hahayyf666-netizen/ITS_NEW/02_rtl/synth/clockInfo.txt

-------------------------------------
| Tool Version : Vivado v.2024.1
| Date         : Sun Jul  5 17:35:17 2026
| Host         : lab
| Design       : design_1
| Device       : xcku5p-ffvb676-2-E-
-------------------------------------

For more information on clockInfo.txt clock routing debug file see https://support.xilinx.com/s/article/000035660?language=en_US
