hahayyf666-netizen/ITS_NEW/V35_P2A_DCT2_64/rtl/clockInfo.txt

-------------------------------------
| Tool Version : Vivado v.2025.2
| Date         : Sat Sep  5 00:54:16 2026
| Host         : Finesse
| Design       : design_1
| Device       : xcku5p-ffvb676-2-E-
-------------------------------------

For more information on clockInfo.txt clock routing debug file see https://support.xilinx.com/s/article/000035660?language=en_US
