hahayyf666-netizen/ITS_NEW/05_audit/current/17_2/memory_timing_probe_synthesis.csv

cycle | event | phase | tu | vector | group | lane | slot | bank | addr | epoch | request_id
6 | read_request | 1 | 0 | 0 | 0 | 0 | 0 | 0 | 0 |  | 0
6 | read_request | 1 | 0 | 0 | 0 | 1 | 0 | 1 | 16 |  | 1
6 | read_request | 1 | 0 | 0 | 0 | 2 | 0 | 2 | 32 |  | 2
6 | read_request | 1 | 0 | 0 | 0 | 3 | 0 | 3 | 48 |  | 3
6 | read_response | 1 | 0 | 0 | 0 | 0 | 0 | 0 | 0 |  | 0
6 | stage_lane_capture | 1 | 0 | 0 | 0 | 0 | 0 | 0 | 0 |  | 0
6 | read_response | 1 | 0 | 0 | 0 | 1 | 0 | 1 | 16 |  | 1
6 | stage_lane_capture | 1 | 0 | 0 | 0 | 1 | 0 | 1 | 16 |  | 1
6 | read_response | 1 | 0 | 0 | 0 | 2 | 0 | 2 | 32 |  | 2
6 | stage_lane_capture | 1 | 0 | 0 | 0 | 2 | 0 | 2 | 32 |  | 2
6 | read_response | 1 | 0 | 0 | 0 | 3 | 0 | 3 | 48 |  | 3
6 | stage_lane_capture | 1 | 0 | 0 | 0 | 3 | 0 | 3 | 48 |  | 3
7 | read_request | 1 | 0 | 0 | 1 | 0 | 0 | 0 | 64 |  | 4
7 | read_request | 1 | 0 | 0 | 1 | 1 | 0 | 1 | 80 |  | 5
7 | read_request | 1 | 0 | 0 | 1 | 2 | 0 | 2 | 96 |  | 6
7 | read_request | 1 | 0 | 0 | 1 | 3 | 0 | 3 | 112 |  | 7
7 | read_response | 1 | 0 | 0 | 1 | 0 | 0 | 0 | 64 |  | 4
7 | stage_lane_capture | 1 | 0 | 0 | 1 | 0 | 0 | 0 | 64 |  | 4
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
