hahayyf666-netizen/ITS_NEW/01_docs/current/SPEC_CLARIFICATIONS.md

# 仍需确认的赛题功能规则

此文件记录资料不足之处。没有发送邮件或消息，也没有把我们的实现约定变成官方定义。

| ID | 问题 | 当前工程选择 | 最小确认方式 | 状态 |
|---|---|---|---|---|
| Q01 | it_info总宽20还是22？字段包含[21:20] | 22位，按字段定义解包 | 确认有效端口位宽及LFNST idx所在位 | OPEN |
| Q02 | 正文未列it_data_end；独立end能否在req之前到达？ | 描述符接受后的后续沿可发；端按接收顺序归属 | 确认端口必需性及相对req的时序 | OPEN |
| Q03 | 位深、动态范围、V/H移位和中间裁剪具体是哪套？ | bit_depth10 / range15 / shift7、10 / signed16饱和 | 给出官方参考参数或对DC512等例子的预期 | OPEN |
| Q04 | signed10是饱和还是取低10位或另有定标？ | SAT10 | 4x4 DC32767：应输出511还是0，或其他值？ | OPEN |
| Q05 | LFNST-off每个形状允许哪些混合H/V类型？ | 按各轴能力支持169组合，含正文明确同类型57组合 | 确认完整H/V合法子集 | OPEN |
| Q06 | square4x4/8x8 LFNST是否只累加8输入项？扫描是否完全采用指定VTM？ | frozen模型按8项，其他形状按16项 | 第9个扫描位置的单非零输入是否应影响结果？ | OPEN |

附件矩阵/布局与专家答疑记录是已有依据；记录中的答复未明确解决以上全部细节。
Q02的增强接收能力不意味着已经证明官方允许该激励；Q05支持更大集合不等于官方要求全部集合。
在官方模型或参数仍缺失时，可报告工程契约功能验证通过，不能报告赛题全链路等价已证明。
