hahayyf666-netizen/ITS_NEW/05_audit/current/102_final_release_20261006/FINAL_RELEASE_REVIEW.md

# Final source, evidence and delivery review

Result: **FINAL_RELEASE_REVIEW_PASS**. Twelve read-only checks passed.
Review authority is the frozen evidence commit
`70153eb14d62801531386af35075c770e1bf51f4`, tested source `cb65bbf1cc2dc9e5e649b2fe8b8affc67435c5a7`, and the two routed authorities in audit99/100.
This review is a separate inspection of source and raw artifacts, not another
simulator/implementation run or a claim of third-party review.

The review checked all3,286 packaged files against the tested Git source,
all68 published artifact identities, all36 simulation command records and
two compile records, both normal/SYNTHESIS acceptance summaries, the explicit
submission entry, frozen SAT10 profile, wrong-profile rejection, and both
raw routed setup/hold summaries and physical source identities. Failures0.

The actual submission entry is `its_unified_submission_top`; its six-file RTL
compile list excludes legacy `its_top.v`. SAT10 is explicit. Coefficient file
staging for a manual compile/fresh physical reproduction is now documented
in `01_docs/current/FINAL_DELIVERY.md`; automated functional reproduction
already stages the coefficients.

The complete archive inventory matches, including SHA256 of each archived
file.3,264 archived text files differ from their raw Git blobs only in CRLF/LF
representation; normalized content is equal. Archive SHA256 remains
`46C55BFFA62A67CDD664FC9C68E210E3FCA1FC3B80093A4A81CEE0C9A19B461F`.

Fourteen historical physical-source `git_blob` fields identify the object
hash of LF-normalized source bytes rather than the literal source commit's
blob. The recorded working-byte SHA256 matches the current frozen files,
normalized content matches the actual committed source, and the normalized
object hash is independently reconstructed. The new JSON emits actual commit
blob, working-byte SHA256 and historical-field classification separately.
No historical manifest was rewritten.

Main integration preflight was conflict-free. Merge `751f5b666b3b2742ab8626a93ced52a131a17d14`
incorporated main `9354f33d19895b0202aef630f4486bd49ef526c7` and preserved its
two historical audit72 PPA reports. Compared with the reviewed evidence
commit, that merge changed no RTL, verification source, profile or XDC.
No source requalification is required for that history-preservation merge.

Accepted functional and two-run nominal500MHz core claims remain unchanged.
Official equivalence NOT_PROVEN; package timing NOT_EVALUATED; setup margin1ps.
This release creates no tag and makes no measured-power or system-margin claim.
