hahayyf666-netizen/ITS_NEW/05_audit/current/60/p9_r5g_locality_g0_20260917_r2/g0_timing_query_summary.txt

P9-R5G G0 timing query
dcp=C:\Users\Fine\Documents\Codex\2026-07-23\ni\_its_new_p8_1_publish\05_audit\current\59\p9_r5e_registered_neighbor_20260917_defaulttop\step12f_registered_neighbor_postroute.dcp
source_families=ingress_group_q_reg,ingress_data_q_reg
destination_family=input_mem_reg (D and CE pins)
query=one max-delay path per destination, positive and negative slack retained
no synthesis/implementation/constraints/write_checkpoint performed
