hahayyf666-netizen/ITS_NEW/04_waveforms/modelsim_backpressure.png

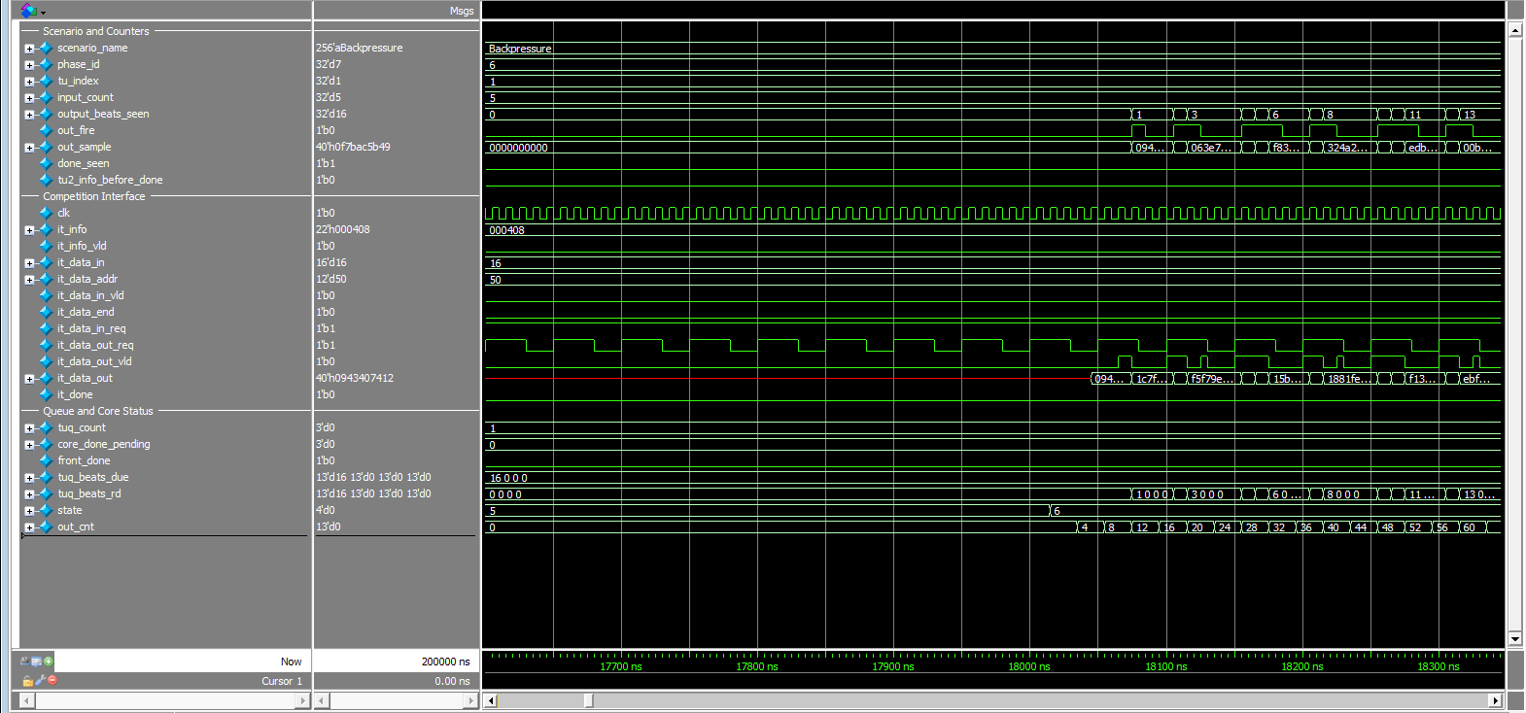
04_waveforms/modelsim_backpressure.png
