hahayyf666-netizen/ITS_NEW/04_waveforms/modelsim_boundary_zero.png

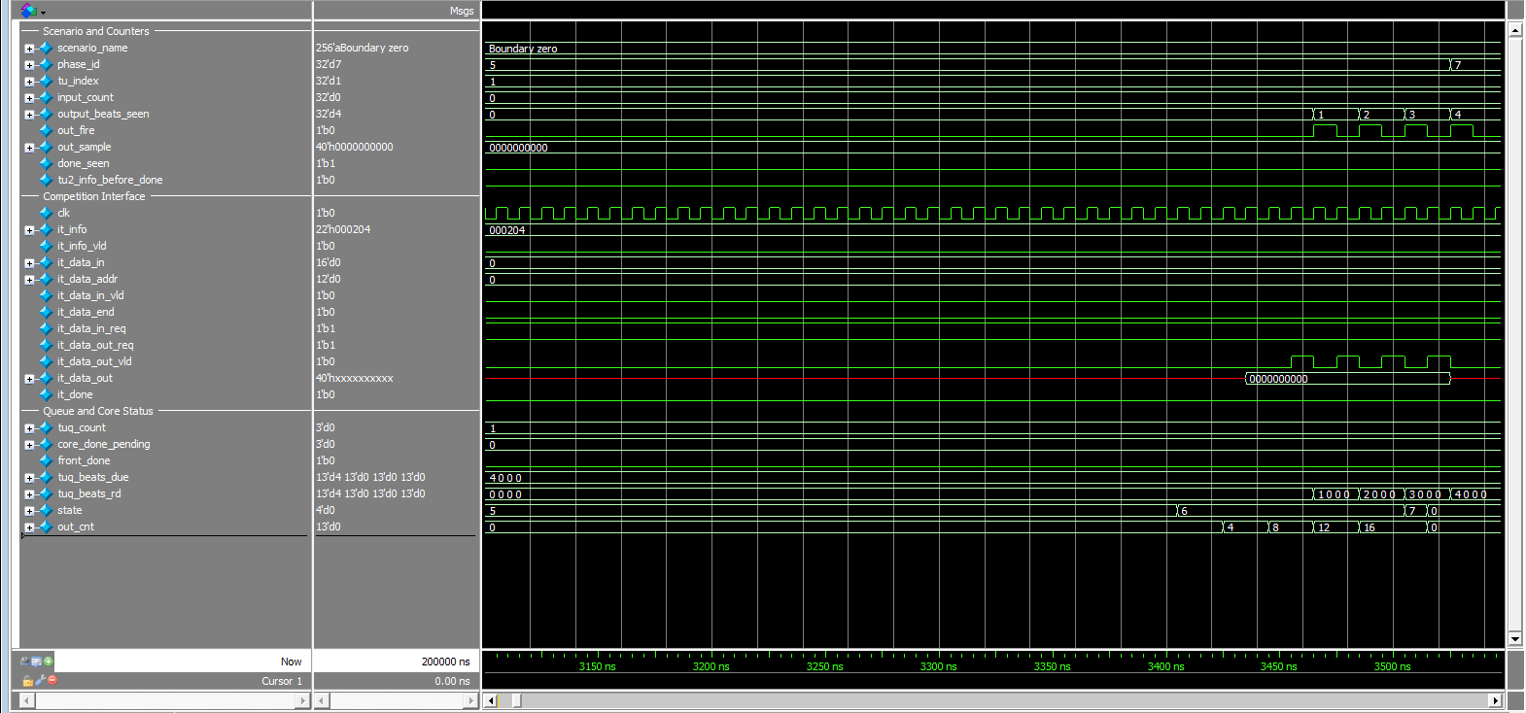
04_waveforms/modelsim_boundary_zero.png
