hahayyf666-netizen/ITS_NEW/04_waveforms/modelsim_continuous_tu.png

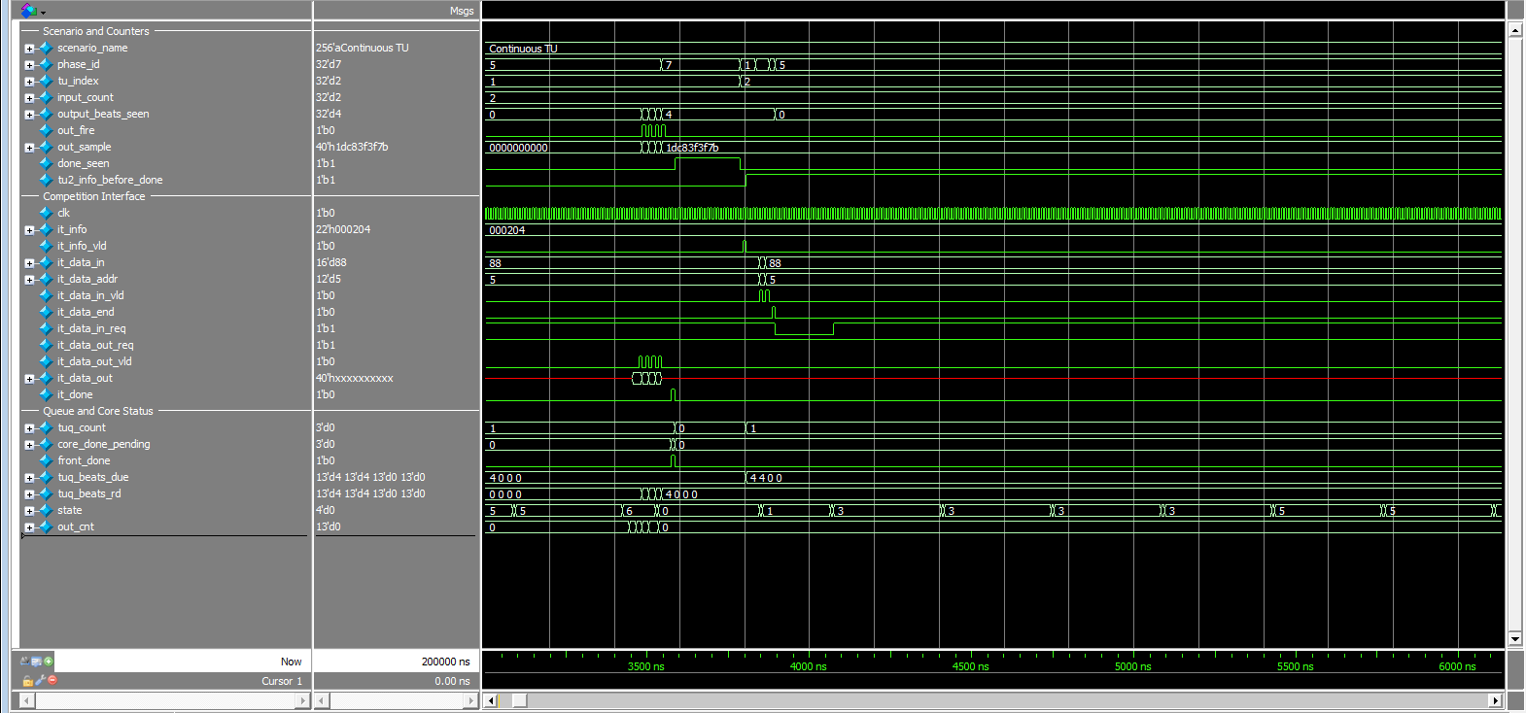
04_waveforms/modelsim_continuous_tu.png
