hahayyf666-netizen/ITS_NEW/04_waveforms/modelsim_dst7_8x8.png

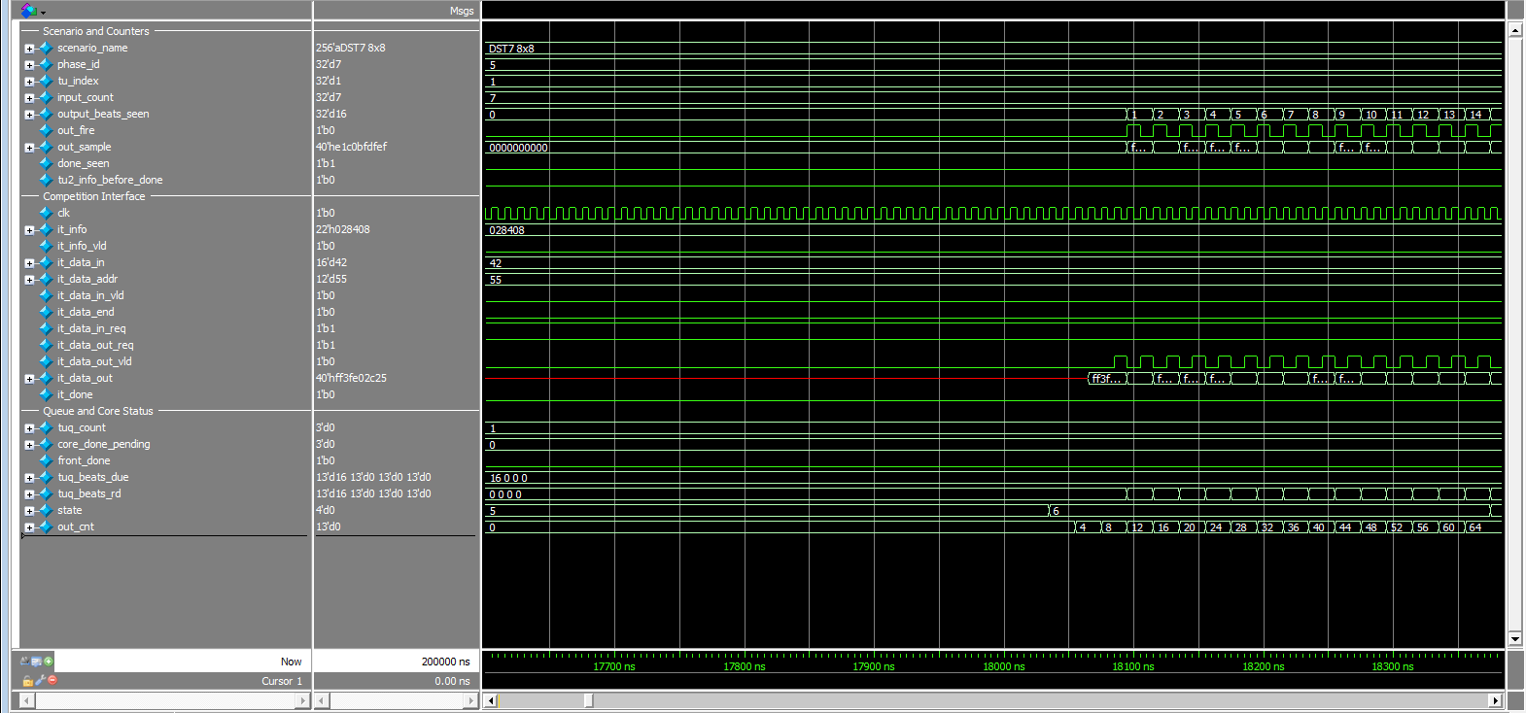
04_waveforms/modelsim_dst7_8x8.png
