hahayyf666-netizen/ITS_NEW/04_waveforms/modelsim_immediate_overlap.png

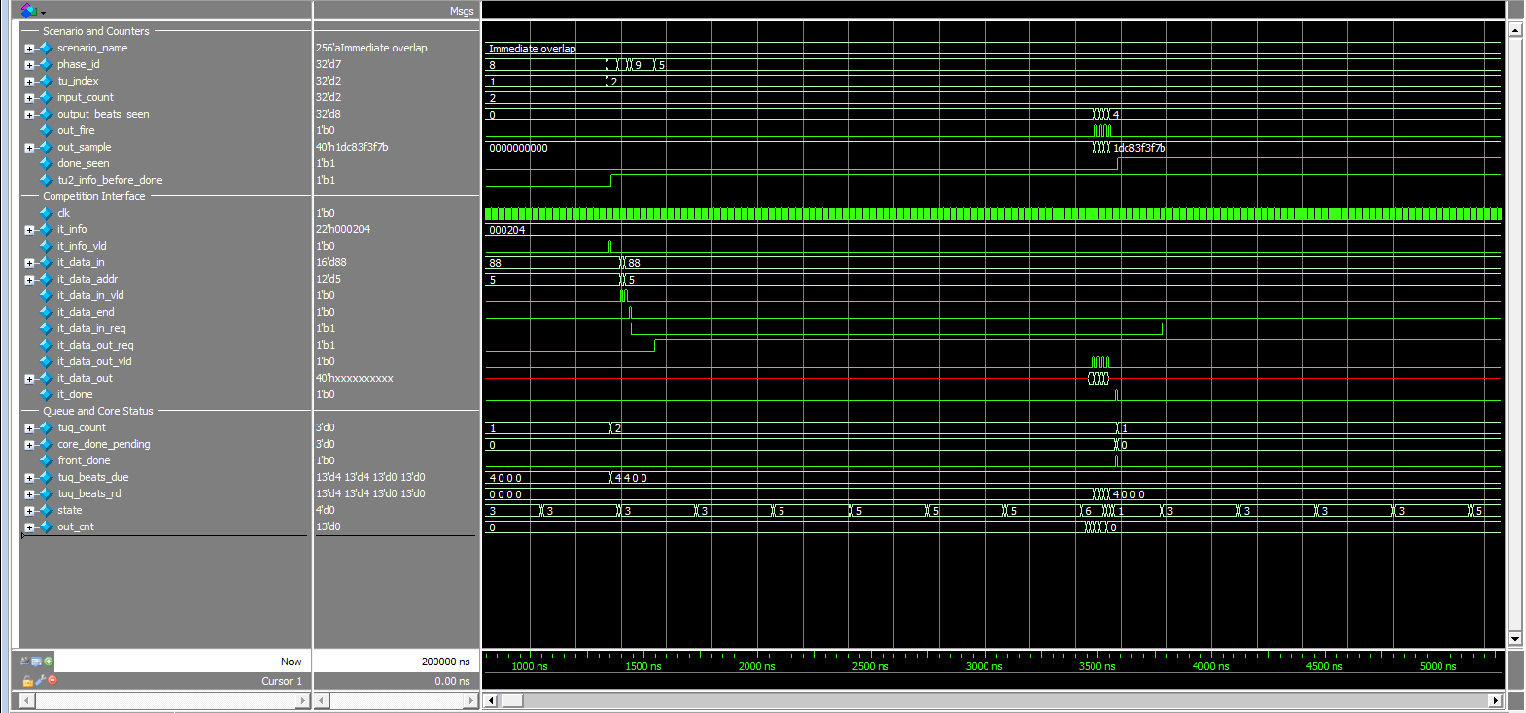
04_waveforms/modelsim_immediate_overlap.png
