hahayyf666-netizen/ITS_NEW/04_waveforms/modelsim_lfnst4x4.png

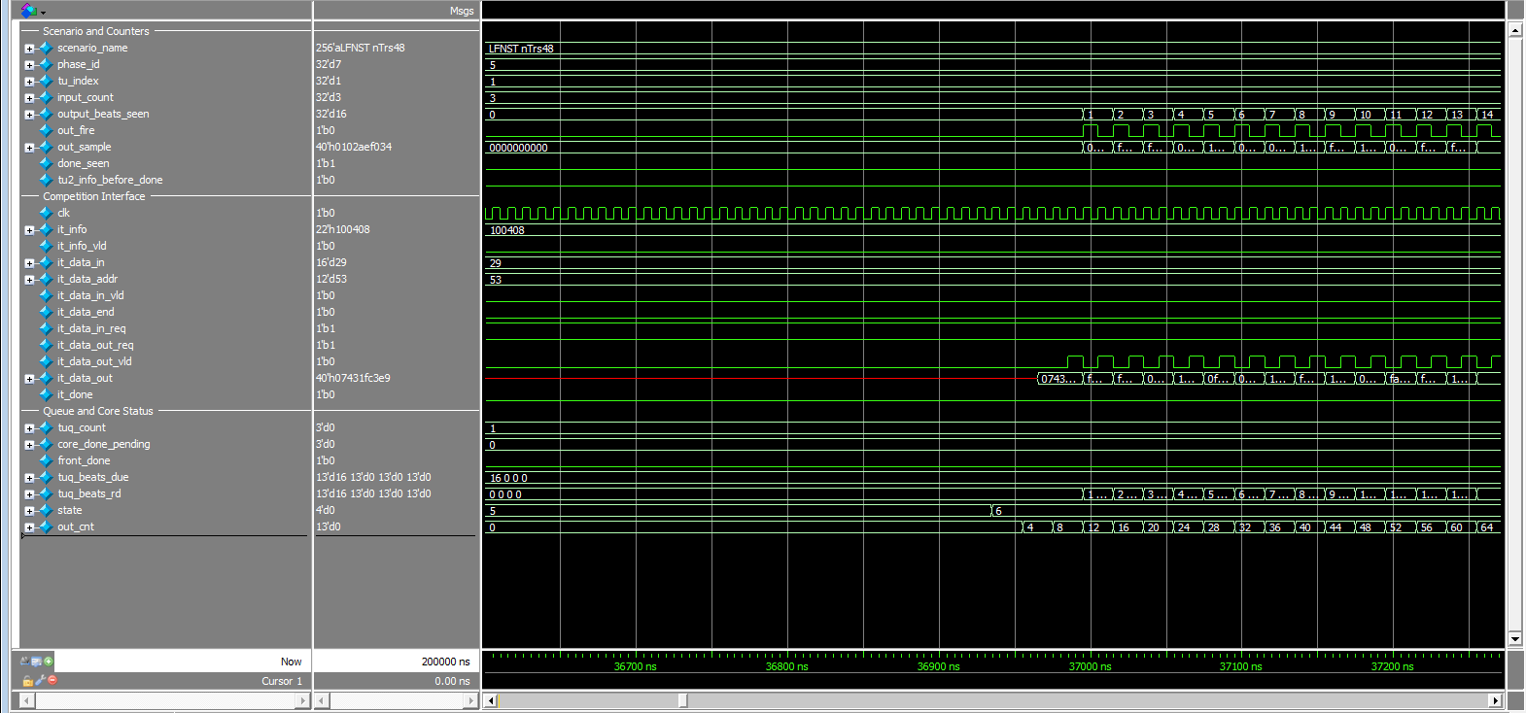
04_waveforms/modelsim_lfnst4x4.png
