hahayyf666-netizen/ITS_NEW/05_audit/current/64/p9_r5g_g06r1_inventory_20260918/g06r1_inventory_read_only_status.txt

status=READ_ONLY_COMPLETE
vivado_version=2025.2
maxThreads=4
dcp=C:\Users\Fine\Documents\Codex\2026-07-23\ni\_its_new_p8_1_publish\05_audit\current\59\p9_r5e_registered_neighbor_20260917_defaulttop\step12f_registered_neighbor_postroute.dcp
producer_cells=64
candidate_sites=9198
site_bbox=SLICE_X40..X112/Y55..Y180
rtl_changes=FORBIDDEN
xdc_changes=FORBIDDEN
implementation_commands=FORBIDDEN
