hahayyf666-netizen/ITS_NEW/05_audit/current/74_p4_fifo_setup_tail_20260929/setup_family_summary.csv

bucket | source_family | endpoint_family | endpoint_count | tns_ns | tns_share | worst_violation_ns | median_violation_ns | p90_violation_ns | p99_violation_ns
DUT_INTERNAL | u_dut/kernel_cut_h_q_reg | u_dut/kernel_rd_resp_data_q_reg | 2 | -0.025000000 | 0.007068137 | 0.017000000 | 0.008000000 | 0.017000000 | 0.017000000
DUT_INTERNAL | u_dut/kernel_h_rd_addr_q_reg_replica_2 | u_dut/kernel_h_rd_data_q_reg | 1 | -0.035000000 | 0.009895392 | 0.035000000 | 0.035000000 | 0.035000000 | 0.035000000
DUT_INTERNAL | u_dut/kernel_h_rd_addr_q_reg_replica_2 | u_dut/kernel_h_rd_data_tail_q_reg | 1 | -0.010000000 | 0.002827255 | 0.010000000 | 0.010000000 | 0.010000000 | 0.010000000
DUT_INTERNAL | u_dut/kernel_h_rd_addr_q_reg | u_dut/kernel_h_rd_data_q_reg | 13 | -0.221000000 | 0.062482330 | 0.045000000 | 0.015000000 | 0.030000000 | 0.045000000
DUT_INTERNAL | u_dut/kernel_h_rd_addr_q_reg | u_dut/kernel_h_rd_data_tail_q_reg | 6 | -0.107000000 | 0.030251626 | 0.038000000 | 0.012000000 | 0.038000000 | 0.038000000
DUT_INTERNAL | u_dut/kernel_h_rd_raw_group_q_reg | u_dut/u_unified_p4_kernel/ingress_data_q_reg | 9 | -0.237000000 | 0.067005937 | 0.044000000 | 0.027000000 | 0.044000000 | 0.044000000
DUT_INTERNAL | u_dut/kernel_phase_q_reg | u_dut/kernel_h_rd_data_q_reg | 8 | -0.160000000 | 0.045236076 | 0.043000000 | 0.020000000 | 0.043000000 | 0.043000000
DUT_INTERNAL | u_dut/kernel_phase_q_reg | u_dut/kernel_h_rd_data_tail_q_reg | 20 | -0.503000000 | 0.142210913 | 0.043000000 | 0.023000000 | 0.041000000 | 0.043000000
DUT_INTERNAL | u_dut/kernel_phase_q_reg | u_dut/kernel_h_rd_raw_group_q_reg | 1 | -0.045000000 | 0.012722646 | 0.045000000 | 0.045000000 | 0.045000000 | 0.045000000
DUT_INTERNAL | u_dut/kernel_phase_q_reg | u_dut/kernel_h_rd_raw_vector_q_reg | 2 | -0.090000000 | 0.025445293 | 0.045000000 | 0.045000000 | 0.045000000 | 0.045000000
DUT_INTERNAL | u_dut/kernel_phase_q_reg | u_dut/kernel_h_rd_raw_vector_q_reg_inv | 1 | -0.044000000 | 0.012439921 | 0.044000000 | 0.044000000 | 0.044000000 | 0.044000000
DUT_INTERNAL | u_dut/kernel_phase_q_reg | u_dut/kernel_rd_raw_data_q_reg | 1 | -0.013000000 | 0.003675431 | 0.013000000 | 0.013000000 | 0.013000000 | 0.013000000
DUT_INTERNAL | u_dut/kernel_phase_q_reg | u_dut/kernel_rd_req_group_q_reg | 1 | -0.009000000 | 0.002544529 | 0.009000000 | 0.009000000 | 0.009000000 | 0.009000000
DUT_INTERNAL | u_dut/kernel_phase_q_reg | u_dut/lfnst_gather_index_q_reg | 1 | -0.009000000 | 0.002544529 | 0.009000000 | 0.009000000 | 0.009000000 | 0.009000000
DUT_INTERNAL | u_dut/kernel_phase_q_reg | u_dut/rd_cmd_addr_q_reg | 1 | -0.031000000 | 0.008764490 | 0.031000000 | 0.031000000 | 0.031000000 | 0.031000000
DUT_INTERNAL | u_dut/kernel_phase_q_reg | u_dut/rd_cmd_addr_q_reg_replica_1 | 1 | -0.003000000 | 0.000848176 | 0.003000000 | 0.003000000 | 0.003000000 | 0.003000000
DUT_INTERNAL | u_dut/kernel_phase_q_reg | u_dut/rd_cmd_addr_q_reg_replica_3 | 1 | -0.031000000 | 0.008764490 | 0.031000000 | 0.031000000 | 0.031000000 | 0.031000000
DUT_INTERNAL | u_dut/kernel_phase_q_reg | u_dut/rd_cmd_addr_q_reg_replica_4 | 1 | -0.013000000 | 0.003675431 | 0.013000000 | 0.013000000 | 0.013000000 | 0.013000000
DUT_INTERNAL | u_dut/kernel_phase_q_reg | u_dut/rd_cmd_addr_q_reg_replica_5 | 1 | -0.003000000 | 0.000848176 | 0.003000000 | 0.003000000 | 0.003000000 | 0.003000000
DUT_INTERNAL | u_dut/kernel_vector_q_reg_rep__0 | u_dut/u_unified_p4_kernel/ingress_data_q_reg | 1 | -0.037000000 | 0.010460843 | 0.037000000 | 0.037000000 | 0.037000000 | 0.037000000
DUT_INTERNAL | u_dut/kernel_vector_q_reg_rep__1 | u_dut/kernel_vector_q_reg | 1 | -0.025000000 | 0.007068137 | 0.025000000 | 0.025000000 | 0.025000000 | 0.025000000
DUT_INTERNAL | u_dut/kernel_vector_q_reg_rep__1 | u_dut/kernel_vector_q_reg_rep__0 | 1 | -0.031000000 | 0.008764490 | 0.031000000 | 0.031000000 | 0.031000000 | 0.031000000
DUT_INTERNAL | u_dut/kernel_vector_q_reg_rep__1 | u_dut/kernel_vector_q_reg_rep__1_replica_4 | 1 | -0.007000000 | 0.001979078 | 0.007000000 | 0.007000000 | 0.007000000 | 0.007000000
DUT_INTERNAL | u_dut/kernel_vector_q_reg_rep__1 | u_dut/kernel_vector_q_reg_rep__1_replica_5 | 1 | -0.010000000 | 0.002827255 | 0.010000000 | 0.010000000 | 0.010000000 | 0.010000000
DUT_INTERNAL | u_dut/kernel_vector_q_reg_rep__1 | u_dut/kernel_vector_q_reg_rep__1_replica_6 | 1 | -0.011000000 | 0.003109980 | 0.011000000 | 0.011000000 | 0.011000000 | 0.011000000
DUT_INTERNAL | u_dut/kernel_vector_q_reg_rep__1 | u_dut/kernel_vector_q_reg_rep__1_replica_7 | 1 | -0.006000000 | 0.001696353 | 0.006000000 | 0.006000000 | 0.006000000 | 0.006000000
DUT_INTERNAL | u_dut/kernel_vector_q_reg_rep__1 | u_dut/u_unified_p4_kernel/ingress_data_q_reg | 1 | -0.027000000 | 0.007633588 | 0.027000000 | 0.027000000 | 0.027000000 | 0.027000000
DUT_INTERNAL | u_dut/kernel_vector_q_reg_rep | u_dut/u_unified_p4_kernel/ingress_data_q_reg | 2 | -0.033000000 | 0.009329941 | 0.022000000 | 0.011000000 | 0.022000000 | 0.022000000
DUT_INTERNAL | u_dut/kernel_vector_q_reg | u_dut/kernel_h_input_commit_wait_q_reg | 1 | -0.023000000 | 0.006502686 | 0.023000000 | 0.023000000 | 0.023000000 | 0.023000000
DUT_INTERNAL | u_dut/kernel_vector_q_reg | u_dut/kernel_rd_resp_valid_q_reg | 1 | -0.006000000 | 0.001696353 | 0.006000000 | 0.006000000 | 0.006000000 | 0.006000000
DUT_INTERNAL | u_dut/kernel_vector_q_reg | u_dut/kernel_vector_q_reg_rep | 1 | -0.017000000 | 0.004806333 | 0.017000000 | 0.017000000 | 0.017000000 | 0.017000000
DUT_INTERNAL | u_dut/kernel_vector_q_reg | u_dut/u_unified_p4_kernel/ingress_data_q_reg | 2 | -0.068000000 | 0.019225332 | 0.040000000 | 0.028000000 | 0.040000000 | 0.040000000
DUT_INTERNAL | u_dut/lfnst_grid_reg | u_dut/u_unified_p4_kernel/ingress_data_q_reg | 17 | -0.403000000 | 0.113938366 | 0.042000000 | 0.024000000 | 0.039000000 | 0.042000000
DUT_INTERNAL | u_dut/lfnst_grid_valid_reg | u_dut/u_unified_p4_kernel/ingress_data_q_reg | 4 | -0.076000000 | 0.021487136 | 0.038000000 | 0.012000000 | 0.038000000 | 0.038000000
DUT_INTERNAL | u_dut/lfnst_run_q_reg | u_dut/kernel_cut_h_q_reg | 1 | -0.019000000 | 0.005371784 | 0.019000000 | 0.019000000 | 0.019000000 | 0.019000000
DUT_INTERNAL | u_dut/lfnst_run_q_reg | u_dut/kernel_h_groups_left_q_reg | 2 | -0.063000000 | 0.017811705 | 0.036000000 | 0.027000000 | 0.036000000 | 0.036000000
DUT_INTERNAL | u_dut/lfnst_run_q_reg | u_dut/lfnst_grid_reg | 3 | -0.033000000 | 0.009329941 | 0.011000000 | 0.011000000 | 0.011000000 | 0.011000000
DUT_INTERNAL | u_dut/output_index_reg_replica | u_dut/slot_state_reg | 1 | -0.005000000 | 0.001413627 | 0.005000000 | 0.005000000 | 0.005000000 | 0.005000000
DUT_INTERNAL | u_dut/rd_cmd_addr_q_reg_replica_1 | u_dut/kernel_rd_raw_data_q_reg | 4 | -0.080000000 | 0.022618038 | 0.038000000 | 0.010000000 | 0.038000000 | 0.038000000
DUT_INTERNAL | u_dut/rd_cmd_addr_q_reg_replica_1 | u_dut/lfnst_mem_resp_data_q_reg | 2 | -0.034000000 | 0.009612666 | 0.030000000 | 0.004000000 | 0.030000000 | 0.030000000
DUT_INTERNAL | u_dut/rd_cmd_addr_q_reg_replica_2 | u_dut/kernel_rd_raw_data_q_reg | 2 | -0.049000000 | 0.013853548 | 0.025000000 | 0.024000000 | 0.025000000 | 0.025000000
DUT_INTERNAL | u_dut/rd_cmd_addr_q_reg_replica_3 | u_dut/kernel_rd_raw_data_q_reg | 2 | -0.018000000 | 0.005089059 | 0.016000000 | 0.002000000 | 0.016000000 | 0.016000000
DUT_INTERNAL | u_dut/rd_cmd_addr_q_reg_replica_4 | u_dut/lfnst_mem_resp_data_q_reg | 1 | -0.021000000 | 0.005937235 | 0.021000000 | 0.021000000 | 0.021000000 | 0.021000000
DUT_INTERNAL | u_dut/rd_cmd_addr_q_reg_replica | u_dut/kernel_rd_raw_data_q_reg | 5 | -0.062000000 | 0.017528979 | 0.025000000 | 0.012000000 | 0.025000000 | 0.025000000
DUT_INTERNAL | u_dut/rd_cmd_addr_q_reg_replica | u_dut/lfnst_mem_resp_data_q_reg | 1 | -0.036000000 | 0.010178117 | 0.036000000 | 0.036000000 | 0.036000000 | 0.036000000
DUT_INTERNAL | u_dut/rd_cmd_addr_q_reg | u_dut/kernel_rd_raw_data_q_reg | 5 | -0.140000000 | 0.039581566 | 0.038000000 | 0.031000000 | 0.038000000 | 0.038000000
DUT_INTERNAL | u_dut/rd_cmd_addr_q_reg | u_dut/lfnst_mem_resp_data_q_reg | 1 | -0.034000000 | 0.009612666 | 0.034000000 | 0.034000000 | 0.034000000 | 0.034000000
DUT_INTERNAL | u_dut/slot_state_reg | u_dut/lfnst_input_terms_q_reg | 4 | -0.052000000 | 0.014701725 | 0.013000000 | 0.013000000 | 0.013000000 | 0.013000000
DUT_INTERNAL | u_dut/u_bounded_lfnst_engine/reduce_l5_q_reg | u_dut/u_bounded_lfnst_engine/out_data_reg | 2 | -0.066000000 | 0.018659881 | 0.039000000 | 0.027000000 | 0.039000000 | 0.039000000
DUT_INTERNAL | u_dut/u_unified_p4_kernel/ingress_data_q_reg | u_dut/u_unified_p4_kernel/input_mem_reg | 12 | -0.190000000 | 0.053717840 | 0.045000000 | 0.010000000 | 0.028000000 | 0.045000000
DUT_INTERNAL | u_dut/u_unified_p4_kernel/issue_desc_active_size_q_reg | u_dut/u_unified_p4_kernel/s0_input_q_reg | 4 | -0.036000000 | 0.010178117 | 0.013000000 | 0.005000000 | 0.013000000 | 0.013000000
DUT_INTERNAL | u_dut/u_unified_p4_kernel/issue_desc_slot_q_reg_rep__3 | u_dut/u_unified_p4_kernel/s0_input_q_reg | 2 | -0.004000000 | 0.001130902 | 0.003000000 | 0.001000000 | 0.003000000 | 0.003000000
DUT_INTERNAL | u_dut/u_unified_p4_kernel/ready_fifo_mem_reg | u_dut/u_unified_p4_kernel/issue_desc_bundle_addr_q_reg_rep__1 | 1 | -0.018000000 | 0.005089059 | 0.018000000 | 0.018000000 | 0.018000000 | 0.018000000
DUT_INTERNAL | u_dut/u_unified_p4_kernel/ready_fifo_mem_reg | u_dut/u_unified_p4_kernel/issue_desc_bundle_addr_q_reg_rep__4 | 1 | -0.002000000 | 0.000565451 | 0.002000000 | 0.002000000 | 0.002000000 | 0.002000000
DUT_INTERNAL | u_dut/u_unified_p4_kernel/ready_fifo_mem_reg | u_dut/u_unified_p4_kernel/issue_desc_bundle_addr_q_reg_rep__8 | 1 | -0.004000000 | 0.001130902 | 0.004000000 | 0.004000000 | 0.004000000 | 0.004000000
DUT_INTERNAL | u_dut/u_unified_p4_kernel/reduce_l4_q_reg | u_dut/u_unified_p4_kernel/reduce_l5_q_reg | 3 | -0.037000000 | 0.010460843 | 0.017000000 | 0.016000000 | 0.017000000 | 0.017000000
DUT_TO_SINK_BOUNDARY | u_dut/output_index_reg_replica_1 | harness/sink_boundary | 2 | -0.038000000 | 0.010743568 | 0.023000000 | 0.015000000 | 0.023000000 | 0.023000000
DUT_TO_SINK_BOUNDARY | u_dut/output_index_reg_replica_3 | harness/sink_boundary | 2 | -0.031000000 | 0.008764490 | 0.025000000 | 0.006000000 | 0.025000000 | 0.025000000
DUT_TO_SINK_BOUNDARY | u_dut/output_index_reg_replica_4 | harness/sink_boundary | 2 | -0.049000000 | 0.013853548 | 0.040000000 | 0.009000000 | 0.040000000 | 0.040000000
DUT_TO_SINK_BOUNDARY | u_dut/output_index_reg_replica_5 | harness/sink_boundary | 1 | -0.012000000 | 0.003392706 | 0.012000000 | 0.012000000 | 0.012000000 | 0.012000000
DUT_TO_SINK_BOUNDARY | u_dut/output_index_reg_replica_6 | harness/sink_boundary | 2 | -0.035000000 | 0.009895392 | 0.027000000 | 0.008000000 | 0.027000000 | 0.027000000
