hahayyf666-netizen/ITS_NEW/03_verification/output/V35_STEP12A_R2_1_INTEGRATION_GATE.md

# V35 Step 12A-R2.1 Integration Gate Closure (historical)

The authoritative report is generated by:

```text
python 03_verification/scripts/step12ar2_executable_model.py
```

Current status: **PARTIAL PASS / SUPERSEDED BY R2.2**.

This report records the historical R2.1 candidate.  Its phase-local arithmetic,
bank mapping and basic capacity checks remain useful, but its result replay,
non-global phase loops and incomplete output/input protocol model prevent it
from being the final pre-RTL gate.  R2.2 is the current gate.

The generated companion report is
`V35_STEP12A_R2_EXECUTABLE_PROOF.md`, and the machine-readable evidence is in
`05_audit/current/step12ar2/step12ar2_results.json`,
`step12ar2_negative_tests.json`, `step12ar2_event_trace.json`, and
`STEP12A_R2_FREEZE_MANIFEST.json`.

No wrapper RTL, V3.4 RTL, R4C RTL, ROM, golden data, or Vivado implementation
was modified in this historical step. Step 12B remains blocked until R2.2 is
accepted as the effective version.
