hahayyf666-netizen/ITS_NEW/03_verification/output/V35_STEP12A_R2_EXECUTABLE_PROOF.md

# V35 Step 12A-R2.1 Integration Gate Closure (historical)

Status: **HISTORICAL / SUPERSEDED BY R2.2**

This document records the former R2.1 candidate. Its phase-local checks are
kept for history; the current temporal/protocol gate is `V35_14_REPORT.md`
and the machine-readable R2.2 results under `05_audit/current/step12ar2/`.
