hahayyf666-netizen/ITS_NEW/05_audit/current/36/step12f_p7_targeted/P4_TARGETED_PIN_COUNTS.txt

descriptor_q=153
descriptor_d=153
descriptor_slot_q=16
descriptor_bundle_q=99
descriptor_meta_q=38
s0_coeff_d=0
s0_input_d=1008
s0_meta_d=57
s0_all_d=1065
slot_state_q=8
issue_emit_q=0
ready_q=15
