hahayyf666-netizen/ITS_NEW/05_audit/current/17/V35_STEP12B_CYCLE_MODEL_REPORT.md

# V3.5-17 Step12B cycle model

Status: PASS

A single IntegrationModel.tick() advances input, synchronous memories,
the persistent R4C contract, V/H scheduling, live result writes and output hold/skid.

| case | cycles | vectors | vector II | result writes | result fires |
|---|---:|---:|---|---:|---:|
| zero | 2132 | 128 | {'vertical': [16], 'horizontal': [16]} | 1024 | 1024 |
| sparse | 2137 | 128 | {'vertical': [16], 'horizontal': [16]} | 1024 | 1024 |
| alternating | 6228 | 128 | {'vertical': [16], 'horizontal': [16]} | 1024 | 1024 |
| random | 6227 | 128 | {'vertical': [16], 'horizontal': [16]} | 1024 | 1024 |

two-TU: {'cycles': 7091, 'result_writes': 2048, 'result_fires': 2048, 'stats': {'input_cache_full': 0, 'staging_wait': 0, 'result_capacity_wait': 857, 'output_backpressure': 5000, 'epoch_scrub': 0}}
vector_id_wrap: {'groups': 2048, 'first_ids': [65534, 65535, 0, 1]}
epoch_wrap: {'tus': 10, 'scrub_events': 2048, 'cycles': 21284}
mutation_gate (19 checker mutations): {'trace_rollback_rejected': True, 'missing_result_write_rejected': True, 'horizontal_stage16_mutation_rejected': True, 'result_value_mutation_rejected': True, 'early_vector_start_rejected': True, 'duplicate_kernel_group_rejected': True, 'wrong_vector_group_rejected': True, 'intermediate_overwrite_rejected': True, 'write_without_reservation_rejected': True, 'same_address_rdw_rejected': True, 'early_ram_response_rejected': True, 'late_ram_response_rejected': True, 'output_hold_mutation_rejected': True, 'output_drop_rejected': True, 'output_duplicate_rejected': True, 'wrong_done_timing_rejected': True, 'descriptor_misbind_rejected': True, 'bank_conflict_rejected': True, 'scrub_access_rejected': True}
RTL/Model cycle compare: one input-fire anchor; normal and SYNTHESIS traces must match with no free event offsets.

Functional/protocol candidate gate is complete for the scoped 64x64 DCT2xDCT2 wrapper; no Vivado or full-core timing claim is made.
