hahayyf666-netizen/ITS_NEW/05_audit/current/36/step12f_p7_targeted/P4_DESCRIPTOR_D_NAMES.txt

DESCRIPTOR_D
u_unified_p4_kernel/issue_desc_active_size_q_reg[0]/D
u_unified_p4_kernel/issue_desc_active_size_q_reg[1]/D
u_unified_p4_kernel/issue_desc_active_size_q_reg[2]/D
u_unified_p4_kernel/issue_desc_active_size_q_reg[3]/D
u_unified_p4_kernel/issue_desc_active_size_q_reg[4]/D
u_unified_p4_kernel/issue_desc_active_size_q_reg[5]/D
u_unified_p4_kernel/issue_desc_bundle_addr_q_reg[0]/D
u_unified_p4_kernel/issue_desc_bundle_addr_q_reg[0]_rep/D
u_unified_p4_kernel/issue_desc_bundle_addr_q_reg[0]_rep__0/D
u_unified_p4_kernel/issue_desc_bundle_addr_q_reg[0]_rep__1/D
u_unified_p4_kernel/issue_desc_bundle_addr_q_reg[0]_rep__10/D
u_unified_p4_kernel/issue_desc_bundle_addr_q_reg[0]_rep__11/D
u_unified_p4_kernel/issue_desc_bundle_addr_q_reg[0]_rep__12/D
u_unified_p4_kernel/issue_desc_bundle_addr_q_reg[0]_rep__13/D
u_unified_p4_kernel/issue_desc_bundle_addr_q_reg[0]_rep__14/D
u_unified_p4_kernel/issue_desc_bundle_addr_q_reg[0]_rep__15/D
u_unified_p4_kernel/issue_desc_bundle_addr_q_reg[0]_rep__2/D
u_unified_p4_kernel/issue_desc_bundle_addr_q_reg[0]_rep__3/D
u_unified_p4_kernel/issue_desc_bundle_addr_q_reg[0]_rep__4/D
u_unified_p4_kernel/issue_desc_bundle_addr_q_reg[0]_rep__5/D
u_unified_p4_kernel/issue_desc_bundle_addr_q_reg[0]_rep__6/D
u_unified_p4_kernel/issue_desc_bundle_addr_q_reg[0]_rep__7/D
u_unified_p4_kernel/issue_desc_bundle_addr_q_reg[0]_rep__8/D
u_unified_p4_kernel/issue_desc_bundle_addr_q_reg[0]_rep__9/D
u_unified_p4_kernel/issue_desc_bundle_addr_q_reg[1]/D
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
u_unified_p4_kernel/issue_desc_valid_q_reg_rep__5/D
u_unified_p4_kernel/issue_desc_valid_q_reg_rep__6/D
u_unified_p4_kernel/issue_desc_valid_q_reg_rep__7/D
u_unified_p4_kernel/issue_desc_valid_q_reg_rep__8/D
u_unified_p4_kernel/issue_desc_valid_q_reg_rep__9/D
