hahayyf666-netizen/ITS_NEW/05_audit/current/36/step12f_p7_targeted/P4_DESCRIPTOR_Q_NAMES.txt

DESCRIPTOR_Q
u_unified_p4_kernel/issue_desc_active_size_q_reg[0]/Q
u_unified_p4_kernel/issue_desc_active_size_q_reg[1]/Q
u_unified_p4_kernel/issue_desc_active_size_q_reg[2]/Q
u_unified_p4_kernel/issue_desc_active_size_q_reg[3]/Q
u_unified_p4_kernel/issue_desc_active_size_q_reg[4]/Q
u_unified_p4_kernel/issue_desc_active_size_q_reg[5]/Q
u_unified_p4_kernel/issue_desc_bundle_addr_q_reg[0]/Q
u_unified_p4_kernel/issue_desc_bundle_addr_q_reg[0]_rep/Q
u_unified_p4_kernel/issue_desc_bundle_addr_q_reg[0]_rep__0/Q
u_unified_p4_kernel/issue_desc_bundle_addr_q_reg[0]_rep__1/Q
u_unified_p4_kernel/issue_desc_bundle_addr_q_reg[0]_rep__10/Q
u_unified_p4_kernel/issue_desc_bundle_addr_q_reg[0]_rep__11/Q
u_unified_p4_kernel/issue_desc_bundle_addr_q_reg[0]_rep__12/Q
u_unified_p4_kernel/issue_desc_bundle_addr_q_reg[0]_rep__13/Q
u_unified_p4_kernel/issue_desc_bundle_addr_q_reg[0]_rep__14/Q
u_unified_p4_kernel/issue_desc_bundle_addr_q_reg[0]_rep__15/Q
u_unified_p4_kernel/issue_desc_bundle_addr_q_reg[0]_rep__2/Q
u_unified_p4_kernel/issue_desc_bundle_addr_q_reg[0]_rep__3/Q
u_unified_p4_kernel/issue_desc_bundle_addr_q_reg[0]_rep__4/Q
u_unified_p4_kernel/issue_desc_bundle_addr_q_reg[0]_rep__5/Q
u_unified_p4_kernel/issue_desc_bundle_addr_q_reg[0]_rep__6/Q
u_unified_p4_kernel/issue_desc_bundle_addr_q_reg[0]_rep__7/Q
u_unified_p4_kernel/issue_desc_bundle_addr_q_reg[0]_rep__8/Q
u_unified_p4_kernel/issue_desc_bundle_addr_q_reg[0]_rep__9/Q
u_unified_p4_kernel/issue_desc_bundle_addr_q_reg[1]/Q
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
u_unified_p4_kernel/issue_desc_valid_q_reg_rep__5/Q
u_unified_p4_kernel/issue_desc_valid_q_reg_rep__6/Q
u_unified_p4_kernel/issue_desc_valid_q_reg_rep__7/Q
u_unified_p4_kernel/issue_desc_valid_q_reg_rep__8/Q
u_unified_p4_kernel/issue_desc_valid_q_reg_rep__9/Q
