hahayyf666-netizen/ITS_NEW/05_audit/current/74_p4_fifo_setup_tail_20260929/setup_bucket_summary.csv

bucket | endpoint_count | tns_ns | tns_share | worst_violation_ns | median_violation_ns | p90_violation_ns | p99_violation_ns | logic_levels_min | logic_levels_median | logic_levels_p90 | logic_levels_max | logic_delay_median_ns | logic_delay_p90_ns | logic_delay_max_ns | routing_delay_median_ns | routing_delay_p90_ns | routing_delay_max_ns | routing_fraction_median | routing_fraction_p90 | routing_fraction_max
DUT_INTERNAL | 168 | -3.372000000 | 0.953350297 | 0.045000000 | 0.017000000 | 0.038000000 | 0.045000000 | 0 | 5.000000000 | 6.000000000 | 9 | 0.500000000 | 0.607000000 | 0.953 | 1.395000000 | 1.573000000 | 1.925 | 0.733737596 | 0.838933333 | 0.9605788423153693
DUT_TO_SINK_BOUNDARY | 9 | -0.165000000 | 0.046649703 | 0.040000000 | 0.015000000 | 0.040000000 | 0.040000000 | 5 | 5.000000000 | 5.000000000 | 5 | 0.411000000 | 0.515000000 | 0.515 | 1.472000000 | 1.610000000 | 1.61 | 0.781731280 | 0.817258883 | 0.817258883248731
