hahayyf666-netizen/ITS_NEW/05_audit/current/74_p4_fifo_setup_tail_20260929/setup_endpoint_census.csv

endpoint | startpoint | slack | path_group | launch_clock | capture_clock | start_cell | start_ref | start_hierarchy | end_cell | end_ref | end_hierarchy | logic_levels | logic_delay_ns | routing_delay_ns | datapath_delay_ns | routing_fraction | start_loc | end_loc | start_clock_region | end_clock_region | raw_structural_signature | normalized_structural_signature | classification_bucket | source_family | endpoint_family | violation_magnitude_ns
sink_it_data_out_q_reg[11]/D | u_dut/output_index_reg[0]_replica_3/C | -0.006000000 | clk | clk | clk | u_dut/output_index_reg[0]_replica_3 | FDCE | u_dut/output_index_reg_replica_3 | sink_it_data_out_q_reg[11] | FDCE | sink_it_data_out_q_reg | 5 | 0.508000000 | 1.387000000 | 1.895000000 | 0.731926121 | SLICE_X59Y50 | SLICE_X56Y58 |  |  | SIGNATURE_SKIPPED|FDCE|FDCE | SIGNATURE_SKIPPED|FDCE|FDCE | DUT_TO_SINK_BOUNDARY | u_dut/output_index_reg_replica_3 | harness/sink_boundary | 0.006000000
sink_it_data_out_q_reg[12]/D | u_dut/output_index_reg[1]_replica_1/C | -0.015000000 | clk | clk | clk | u_dut/output_index_reg[1]_replica_1 | FDCE | u_dut/output_index_reg_replica_1 | sink_it_data_out_q_reg[12] | FDCE | sink_it_data_out_q_reg | 5 | 0.369000000 | 1.568000000 | 1.937000000 | 0.809499226 | SLICE_X61Y45 | SLICE_X59Y55 |  |  | SIGNATURE_SKIPPED|FDCE|FDCE | SIGNATURE_SKIPPED|FDCE|FDCE | DUT_TO_SINK_BOUNDARY | u_dut/output_index_reg_replica_1 | harness/sink_boundary | 0.015000000
sink_it_data_out_q_reg[16]/D | u_dut/output_index_reg[1]_replica_1/C | -0.023000000 | clk | clk | clk | u_dut/output_index_reg[1]_replica_1 | FDCE | u_dut/output_index_reg_replica_1 | sink_it_data_out_q_reg[16] | FDCE | sink_it_data_out_q_reg | 5 | 0.386000000 | 1.553000000 | 1.939000000 | 0.800928314 | SLICE_X61Y45 | SLICE_X60Y62 |  |  | SIGNATURE_SKIPPED|FDCE|FDCE | SIGNATURE_SKIPPED|FDCE|FDCE | DUT_TO_SINK_BOUNDARY | u_dut/output_index_reg_replica_1 | harness/sink_boundary | 0.023000000
sink_it_data_out_q_reg[22]/D | u_dut/output_index_reg[0]_replica_5/C | -0.012000000 | clk | clk | clk | u_dut/output_index_reg[0]_replica_5 | FDCE | u_dut/output_index_reg_replica_5 | sink_it_data_out_q_reg[22] | FDCE | sink_it_data_out_q_reg | 5 | 0.515000000 | 1.394000000 | 1.909000000 | 0.730225249 | SLICE_X66Y53 | SLICE_X68Y79 |  |  | SIGNATURE_SKIPPED|FDCE|FDCE | SIGNATURE_SKIPPED|FDCE|FDCE | DUT_TO_SINK_BOUNDARY | u_dut/output_index_reg_replica_5 | harness/sink_boundary | 0.012000000
sink_it_data_out_q_reg[2]/D | u_dut/output_index_reg[5]_replica_4/C | -0.040000000 | clk | clk | clk | u_dut/output_index_reg[5]_replica_4 | FDCE | u_dut/output_index_reg_replica_4 | sink_it_data_out_q_reg[2] | FDCE | sink_it_data_out_q_reg | 5 | 0.360000000 | 1.610000000 | 1.970000000 | 0.817258883 | SLICE_X60Y42 | SLICE_X58Y79 |  |  | SIGNATURE_SKIPPED|FDCE|FDCE | SIGNATURE_SKIPPED|FDCE|FDCE | DUT_TO_SINK_BOUNDARY | u_dut/output_index_reg_replica_4 | harness/sink_boundary | 0.040000000
sink_it_data_out_q_reg[37]/D | u_dut/output_index_reg[2]_replica_6/C | -0.027000000 | clk | clk | clk | u_dut/output_index_reg[2]_replica_6 | FDCE | u_dut/output_index_reg_replica_6 | sink_it_data_out_q_reg[37] | FDCE | sink_it_data_out_q_reg | 5 | 0.411000000 | 1.472000000 | 1.883000000 | 0.781731280 | SLICE_X59Y53 | SLICE_X73Y65 |  |  | SIGNATURE_SKIPPED|FDCE|FDCE | SIGNATURE_SKIPPED|FDCE|FDCE | DUT_TO_SINK_BOUNDARY | u_dut/output_index_reg_replica_6 | harness/sink_boundary | 0.027000000
sink_it_data_out_q_reg[38]/D | u_dut/output_index_reg[0]_replica_4/C | -0.009000000 | clk | clk | clk | u_dut/output_index_reg[0]_replica_4 | FDCE | u_dut/output_index_reg_replica_4 | sink_it_data_out_q_reg[38] | FDCE | sink_it_data_out_q_reg | 5 | 0.456000000 | 1.428000000 | 1.884000000 | 0.757961783 | SLICE_X67Y53 | SLICE_X68Y74 |  |  | SIGNATURE_SKIPPED|FDCE|FDCE | SIGNATURE_SKIPPED|FDCE|FDCE | DUT_TO_SINK_BOUNDARY | u_dut/output_index_reg_replica_4 | harness/sink_boundary | 0.009000000
sink_it_data_out_q_reg[39]/D | u_dut/output_index_reg[2]_replica_6/C | -0.008000000 | clk | clk | clk | u_dut/output_index_reg[2]_replica_6 | FDCE | u_dut/output_index_reg_replica_6 | sink_it_data_out_q_reg[39] | FDCE | sink_it_data_out_q_reg | 5 | 0.401000000 | 1.459000000 | 1.860000000 | 0.784408602 | SLICE_X59Y53 | SLICE_X73Y75 |  |  | SIGNATURE_SKIPPED|FDCE|FDCE | SIGNATURE_SKIPPED|FDCE|FDCE | DUT_TO_SINK_BOUNDARY | u_dut/output_index_reg_replica_6 | harness/sink_boundary | 0.008000000
sink_it_data_out_q_reg[6]/D | u_dut/output_index_reg[0]_replica_3/C | -0.025000000 | clk | clk | clk | u_dut/output_index_reg[0]_replica_3 | FDCE | u_dut/output_index_reg_replica_3 | sink_it_data_out_q_reg[6] | FDCE | sink_it_data_out_q_reg | 5 | 0.455000000 | 1.499000000 | 1.954000000 | 0.767144319 | SLICE_X59Y50 | SLICE_X57Y70 |  |  | SIGNATURE_SKIPPED|FDCE|FDCE | SIGNATURE_SKIPPED|FDCE|FDCE | DUT_TO_SINK_BOUNDARY | u_dut/output_index_reg_replica_3 | harness/sink_boundary | 0.025000000
u_dut/kernel_cut_h_q_reg[2]/D | u_dut/lfnst_run_q_reg/C | -0.019000000 | clk | clk | clk | u_dut/lfnst_run_q_reg | FDCE | u_dut/lfnst_run_q_reg | u_dut/kernel_cut_h_q_reg[2] | FDCE | u_dut/kernel_cut_h_q_reg | 5 | 0.571000000 | 1.376000000 | 1.947000000 | 0.706728300 | SLICE_X64Y22 | SLICE_X64Y29 |  |  | SIGNATURE_SKIPPED|FDCE|FDCE | SIGNATURE_SKIPPED|FDCE|FDCE | DUT_INTERNAL | u_dut/lfnst_run_q_reg | u_dut/kernel_cut_h_q_reg | 0.019000000
u_dut/kernel_h_groups_left_q_reg[2]/D | u_dut/lfnst_run_q_reg/C | -0.027000000 | clk | clk | clk | u_dut/lfnst_run_q_reg | FDCE | u_dut/lfnst_run_q_reg | u_dut/kernel_h_groups_left_q_reg[2] | FDCE | u_dut/kernel_h_groups_left_q_reg | 5 | 0.640000000 | 1.265000000 | 1.905000000 | 0.664041995 | SLICE_X64Y22 | SLICE_X63Y25 |  |  | SIGNATURE_SKIPPED|FDCE|FDCE | SIGNATURE_SKIPPED|FDCE|FDCE | DUT_INTERNAL | u_dut/lfnst_run_q_reg | u_dut/kernel_h_groups_left_q_reg | 0.027000000
u_dut/kernel_h_groups_left_q_reg[3]/CE | u_dut/lfnst_run_q_reg/C | -0.036000000 | clk | clk | clk | u_dut/lfnst_run_q_reg | FDCE | u_dut/lfnst_run_q_reg | u_dut/kernel_h_groups_left_q_reg[3] | FDCE | u_dut/kernel_h_groups_left_q_reg | 3 | 0.386000000 | 1.444000000 | 1.830000000 | 0.789071038 | SLICE_X64Y22 | SLICE_X63Y24 |  |  | SIGNATURE_SKIPPED|FDCE|FDCE | SIGNATURE_SKIPPED|FDCE|FDCE | DUT_INTERNAL | u_dut/lfnst_run_q_reg | u_dut/kernel_h_groups_left_q_reg | 0.036000000
u_dut/kernel_h_input_commit_wait_q_reg/D | u_dut/kernel_vector_q_reg[0]/C | -0.023000000 | clk | clk | clk | u_dut/kernel_vector_q_reg[0] | FDCE | u_dut/kernel_vector_q_reg | u_dut/kernel_h_input_commit_wait_q_reg | FDCE | u_dut/kernel_h_input_commit_wait_q_reg | 6 | 0.640000000 | 1.251000000 | 1.891000000 | 0.661554733 | SLICE_X59Y21 | SLICE_X66Y37 |  |  | SIGNATURE_SKIPPED|FDCE|FDCE | SIGNATURE_SKIPPED|FDCE|FDCE | DUT_INTERNAL | u_dut/kernel_vector_q_reg | u_dut/kernel_h_input_commit_wait_q_reg | 0.023000000
u_dut/kernel_h_rd_data_q_reg[12]/D | u_dut/kernel_h_rd_addr_q_reg[0][3]/C | -0.003000000 | clk | clk | clk | u_dut/kernel_h_rd_addr_q_reg[0][3] | FDCE | u_dut/kernel_h_rd_addr_q_reg | u_dut/kernel_h_rd_data_q_reg[12] | FDCE | u_dut/kernel_h_rd_data_q_reg | 5 | 0.382000000 | 1.558000000 | 1.940000000 | 0.803092784 | SLICE_X59Y38 | SLICE_X58Y30 |  |  | SIGNATURE_SKIPPED|FDCE|FDCE | SIGNATURE_SKIPPED|FDCE|FDCE | DUT_INTERNAL | u_dut/kernel_h_rd_addr_q_reg | u_dut/kernel_h_rd_data_q_reg | 0.003000000
u_dut/kernel_h_rd_data_q_reg[14]/CE | u_dut/kernel_phase_q_reg[0]/C | -0.006000000 | clk | clk | clk | u_dut/kernel_phase_q_reg[0] | FDCE | u_dut/kernel_phase_q_reg | u_dut/kernel_h_rd_data_q_reg[14] | FDCE | u_dut/kernel_h_rd_data_q_reg | 5 | 0.575000000 | 1.251000000 | 1.826000000 | 0.685104053 | SLICE_X64Y35 | SLICE_X58Y27 |  |  | SIGNATURE_SKIPPED|FDCE|FDCE | SIGNATURE_SKIPPED|FDCE|FDCE | DUT_INTERNAL | u_dut/kernel_phase_q_reg | u_dut/kernel_h_rd_data_q_reg | 0.006000000
u_dut/kernel_h_rd_data_q_reg[16]/D | u_dut/kernel_h_rd_addr_q_reg[1][1]/C | -0.011000000 | clk | clk | clk | u_dut/kernel_h_rd_addr_q_reg[1][1] | FDCE | u_dut/kernel_h_rd_addr_q_reg | u_dut/kernel_h_rd_data_q_reg[16] | FDCE | u_dut/kernel_h_rd_data_q_reg | 5 | 0.497000000 | 1.439000000 | 1.936000000 | 0.743285124 | SLICE_X52Y29 | SLICE_X54Y32 |  |  | SIGNATURE_SKIPPED|FDCE|FDCE | SIGNATURE_SKIPPED|FDCE|FDCE | DUT_INTERNAL | u_dut/kernel_h_rd_addr_q_reg | u_dut/kernel_h_rd_data_q_reg | 0.011000000
u_dut/kernel_h_rd_data_q_reg[1]/CE | u_dut/kernel_phase_q_reg[0]/C | -0.006000000 | clk | clk | clk | u_dut/kernel_phase_q_reg[0] | FDCE | u_dut/kernel_phase_q_reg | u_dut/kernel_h_rd_data_q_reg[1] | FDCE | u_dut/kernel_h_rd_data_q_reg | 5 | 0.575000000 | 1.251000000 | 1.826000000 | 0.685104053 | SLICE_X64Y35 | SLICE_X58Y27 |  |  | SIGNATURE_SKIPPED|FDCE|FDCE | SIGNATURE_SKIPPED|FDCE|FDCE | DUT_INTERNAL | u_dut/kernel_phase_q_reg | u_dut/kernel_h_rd_data_q_reg | 0.006000000
u_dut/kernel_h_rd_data_q_reg[20]/D | u_dut/kernel_h_rd_addr_q_reg[1][0]/C | -0.045000000 | clk | clk | clk | u_dut/kernel_h_rd_addr_q_reg[1][0] | FDCE | u_dut/kernel_h_rd_addr_q_reg | u_dut/kernel_h_rd_data_q_reg[20] | FDCE | u_dut/kernel_h_rd_data_q_reg | 5 | 0.469000000 | 1.391000000 | 1.860000000 | 0.747849462 | SLICE_X52Y29 | SLICE_X61Y35 |  |  | SIGNATURE_SKIPPED|FDCE|FDCE | SIGNATURE_SKIPPED|FDCE|FDCE | DUT_INTERNAL | u_dut/kernel_h_rd_addr_q_reg | u_dut/kernel_h_rd_data_q_reg | 0.045000000
u_dut/kernel_h_rd_data_q_reg[22]/D | u_dut/kernel_h_rd_addr_q_reg[1][0]/C | -0.030000000 | clk | clk | clk | u_dut/kernel_h_rd_addr_q_reg[1][0] | FDCE | u_dut/kernel_h_rd_addr_q_reg | u_dut/kernel_h_rd_data_q_reg[22] | FDCE | u_dut/kernel_h_rd_data_q_reg | 5 | 0.476000000 | 1.442000000 | 1.918000000 | 0.751824818 | SLICE_X52Y29 | SLICE_X54Y33 |  |  | SIGNATURE_SKIPPED|FDCE|FDCE | SIGNATURE_SKIPPED|FDCE|FDCE | DUT_INTERNAL | u_dut/kernel_h_rd_addr_q_reg | u_dut/kernel_h_rd_data_q_reg | 0.030000000
u_dut/kernel_h_rd_data_q_reg[23]/D | u_dut/kernel_h_rd_addr_q_reg[1][3]/C | -0.014000000 | clk | clk | clk | u_dut/kernel_h_rd_addr_q_reg[1][3] | FDCE | u_dut/kernel_h_rd_addr_q_reg | u_dut/kernel_h_rd_data_q_reg[23] | FDCE | u_dut/kernel_h_rd_data_q_reg | 5 | 0.388000000 | 1.476000000 | 1.864000000 | 0.791845494 | SLICE_X51Y29 | SLICE_X58Y34 |  |  | SIGNATURE_SKIPPED|FDCE|FDCE | SIGNATURE_SKIPPED|FDCE|FDCE | DUT_INTERNAL | u_dut/kernel_h_rd_addr_q_reg | u_dut/kernel_h_rd_data_q_reg | 0.014000000
u_dut/kernel_h_rd_data_q_reg[30]/CE | u_dut/kernel_phase_q_reg[0]/C | -0.006000000 | clk | clk | clk | u_dut/kernel_phase_q_reg[0] | FDCE | u_dut/kernel_phase_q_reg | u_dut/kernel_h_rd_data_q_reg[30] | FDCE | u_dut/kernel_h_rd_data_q_reg | 5 | 0.575000000 | 1.251000000 | 1.826000000 | 0.685104053 | SLICE_X64Y35 | SLICE_X58Y27 |  |  | SIGNATURE_SKIPPED|FDCE|FDCE | SIGNATURE_SKIPPED|FDCE|FDCE | DUT_INTERNAL | u_dut/kernel_phase_q_reg | u_dut/kernel_h_rd_data_q_reg | 0.006000000
u_dut/kernel_h_rd_data_q_reg[30]/D | u_dut/kernel_h_rd_addr_q_reg[1][3]/C | -0.022000000 | clk | clk | clk | u_dut/kernel_h_rd_addr_q_reg[1][3] | FDCE | u_dut/kernel_h_rd_addr_q_reg | u_dut/kernel_h_rd_data_q_reg[30] | FDCE | u_dut/kernel_h_rd_data_q_reg | 5 | 0.393000000 | 1.479000000 | 1.872000000 | 0.790064103 | SLICE_X51Y29 | SLICE_X58Y27 |  |  | SIGNATURE_SKIPPED|FDCE|FDCE | SIGNATURE_SKIPPED|FDCE|FDCE | DUT_INTERNAL | u_dut/kernel_h_rd_addr_q_reg | u_dut/kernel_h_rd_data_q_reg | 0.022000000
u_dut/kernel_h_rd_data_q_reg[31]/D | u_dut/kernel_h_rd_addr_q_reg[1][3]/C | -0.012000000 | clk | clk | clk | u_dut/kernel_h_rd_addr_q_reg[1][3] | FDCE | u_dut/kernel_h_rd_addr_q_reg | u_dut/kernel_h_rd_data_q_reg[31] | FDCE | u_dut/kernel_h_rd_data_q_reg | 5 | 0.466000000 | 1.398000000 | 1.864000000 | 0.750000000 | SLICE_X51Y29 | SLICE_X58Y37 |  |  | SIGNATURE_SKIPPED|FDCE|FDCE | SIGNATURE_SKIPPED|FDCE|FDCE | DUT_INTERNAL | u_dut/kernel_h_rd_addr_q_reg | u_dut/kernel_h_rd_data_q_reg | 0.012000000
u_dut/kernel_h_rd_data_q_reg[32]/CE | u_dut/kernel_phase_q_reg[0]/C | -0.027000000 | clk | clk | clk | u_dut/kernel_phase_q_reg[0] | FDCE | u_dut/kernel_phase_q_reg | u_dut/kernel_h_rd_data_q_reg[32] | FDCE | u_dut/kernel_h_rd_data_q_reg | 5 | 0.575000000 | 1.325000000 | 1.900000000 | 0.697368421 | SLICE_X64Y35 | SLICE_X51Y29 |  |  | SIGNATURE_SKIPPED|FDCE|FDCE | SIGNATURE_SKIPPED|FDCE|FDCE | DUT_INTERNAL | u_dut/kernel_phase_q_reg | u_dut/kernel_h_rd_data_q_reg | 0.027000000
u_dut/kernel_h_rd_data_q_reg[35]/D | u_dut/kernel_h_rd_addr_q_reg[2][0]_replica_2/C | -0.035000000 | clk | clk | clk | u_dut/kernel_h_rd_addr_q_reg[2][0]_replica_2 | FDCE | u_dut/kernel_h_rd_addr_q_reg_replica_2 | u_dut/kernel_h_rd_data_q_reg[35] | FDCE | u_dut/kernel_h_rd_data_q_reg | 5 | 0.526000000 | 1.374000000 | 1.900000000 | 0.723157895 | SLICE_X44Y34 | SLICE_X51Y31 |  |  | SIGNATURE_SKIPPED|FDCE|FDCE | SIGNATURE_SKIPPED|FDCE|FDCE | DUT_INTERNAL | u_dut/kernel_h_rd_addr_q_reg_replica_2 | u_dut/kernel_h_rd_data_q_reg | 0.035000000
u_dut/kernel_h_rd_data_q_reg[37]/D | u_dut/kernel_h_rd_addr_q_reg[2][3]/C | -0.015000000 | clk | clk | clk | u_dut/kernel_h_rd_addr_q_reg[2][3] | FDCE | u_dut/kernel_h_rd_addr_q_reg | u_dut/kernel_h_rd_data_q_reg[37] | FDCE | u_dut/kernel_h_rd_data_q_reg | 5 | 0.401000000 | 1.395000000 | 1.796000000 | 0.776726058 | SLICE_X41Y27 | SLICE_X59Y33 |  |  | SIGNATURE_SKIPPED|FDCE|FDCE | SIGNATURE_SKIPPED|FDCE|FDCE | DUT_INTERNAL | u_dut/kernel_h_rd_addr_q_reg | u_dut/kernel_h_rd_data_q_reg | 0.015000000
u_dut/kernel_h_rd_data_q_reg[39]/CE | u_dut/kernel_phase_q_reg[0]/C | -0.027000000 | clk | clk | clk | u_dut/kernel_phase_q_reg[0] | FDCE | u_dut/kernel_phase_q_reg | u_dut/kernel_h_rd_data_q_reg[39] | FDCE | u_dut/kernel_h_rd_data_q_reg | 5 | 0.575000000 | 1.325000000 | 1.900000000 | 0.697368421 | SLICE_X64Y35 | SLICE_X51Y29 |  |  | SIGNATURE_SKIPPED|FDCE|FDCE | SIGNATURE_SKIPPED|FDCE|FDCE | DUT_INTERNAL | u_dut/kernel_phase_q_reg | u_dut/kernel_h_rd_data_q_reg | 0.027000000
u_dut/kernel_h_rd_data_q_reg[52]/D | u_dut/kernel_h_rd_addr_q_reg[3][2]/C | -0.016000000 | clk | clk | clk | u_dut/kernel_h_rd_addr_q_reg[3][2] | FDCE | u_dut/kernel_h_rd_addr_q_reg | u_dut/kernel_h_rd_data_q_reg[52] | FDCE | u_dut/kernel_h_rd_data_q_reg | 5 | 0.462000000 | 1.483000000 | 1.945000000 | 0.762467866 | SLICE_X56Y38 | SLICE_X56Y32 |  |  | SIGNATURE_SKIPPED|FDCE|FDCE | SIGNATURE_SKIPPED|FDCE|FDCE | DUT_INTERNAL | u_dut/kernel_h_rd_addr_q_reg | u_dut/kernel_h_rd_data_q_reg | 0.016000000
u_dut/kernel_h_rd_data_q_reg[55]/CE | u_dut/kernel_phase_q_reg[0]/C | -0.025000000 | clk | clk | clk | u_dut/kernel_phase_q_reg[0] | FDCE | u_dut/kernel_phase_q_reg | u_dut/kernel_h_rd_data_q_reg[55] | FDCE | u_dut/kernel_h_rd_data_q_reg | 5 | 0.575000000 | 1.266000000 | 1.841000000 | 0.687669745 | SLICE_X64Y35 | SLICE_X56Y34 |  |  | SIGNATURE_SKIPPED|FDCE|FDCE | SIGNATURE_SKIPPED|FDCE|FDCE | DUT_INTERNAL | u_dut/kernel_phase_q_reg | u_dut/kernel_h_rd_data_q_reg | 0.025000000
u_dut/kernel_h_rd_data_q_reg[55]/D | u_dut/kernel_h_rd_addr_q_reg[3][0]/C | -0.014000000 | clk | clk | clk | u_dut/kernel_h_rd_addr_q_reg[3][0] | FDCE | u_dut/kernel_h_rd_addr_q_reg | u_dut/kernel_h_rd_data_q_reg[55] | FDCE | u_dut/kernel_h_rd_data_q_reg | 5 | 0.403000000 | 1.439000000 | 1.842000000 | 0.781216069 | SLICE_X49Y38 | SLICE_X56Y34 |  |  | SIGNATURE_SKIPPED|FDCE|FDCE | SIGNATURE_SKIPPED|FDCE|FDCE | DUT_INTERNAL | u_dut/kernel_h_rd_addr_q_reg | u_dut/kernel_h_rd_data_q_reg | 0.014000000
u_dut/kernel_h_rd_data_q_reg[56]/CE | u_dut/kernel_phase_q_reg[0]/C | -0.043000000 | clk | clk | clk | u_dut/kernel_phase_q_reg[0] | FDCE | u_dut/kernel_phase_q_reg | u_dut/kernel_h_rd_data_q_reg[56] | FDCE | u_dut/kernel_h_rd_data_q_reg | 5 | 0.575000000 | 1.278000000 | 1.853000000 | 0.689692391 | SLICE_X64Y35 | SLICE_X57Y33 |  |  | SIGNATURE_SKIPPED|FDCE|FDCE | SIGNATURE_SKIPPED|FDCE|FDCE | DUT_INTERNAL | u_dut/kernel_phase_q_reg | u_dut/kernel_h_rd_data_q_reg | 0.043000000
u_dut/kernel_h_rd_data_q_reg[57]/D | u_dut/kernel_h_rd_addr_q_reg[3][2]/C | -0.016000000 | clk | clk | clk | u_dut/kernel_h_rd_addr_q_reg[3][2] | FDCE | u_dut/kernel_h_rd_addr_q_reg | u_dut/kernel_h_rd_data_q_reg[57] | FDCE | u_dut/kernel_h_rd_data_q_reg | 5 | 0.422000000 | 1.533000000 | 1.955000000 | 0.784143223 | SLICE_X56Y38 | SLICE_X54Y30 |  |  | SIGNATURE_SKIPPED|FDCE|FDCE | SIGNATURE_SKIPPED|FDCE|FDCE | DUT_INTERNAL | u_dut/kernel_h_rd_addr_q_reg | u_dut/kernel_h_rd_data_q_reg | 0.016000000
u_dut/kernel_h_rd_data_q_reg[62]/CE | u_dut/kernel_phase_q_reg[0]/C | -0.020000000 | clk | clk | clk | u_dut/kernel_phase_q_reg[0] | FDCE | u_dut/kernel_phase_q_reg | u_dut/kernel_h_rd_data_q_reg[62] | FDCE | u_dut/kernel_h_rd_data_q_reg | 5 | 0.575000000 | 1.263000000 | 1.838000000 | 0.687159956 | SLICE_X64Y35 | SLICE_X56Y37 |  |  | SIGNATURE_SKIPPED|FDCE|FDCE | SIGNATURE_SKIPPED|FDCE|FDCE | DUT_INTERNAL | u_dut/kernel_phase_q_reg | u_dut/kernel_h_rd_data_q_reg | 0.020000000
u_dut/kernel_h_rd_data_q_reg[62]/D | u_dut/kernel_h_rd_addr_q_reg[3][0]/C | -0.005000000 | clk | clk | clk | u_dut/kernel_h_rd_addr_q_reg[3][0] | FDCE | u_dut/kernel_h_rd_addr_q_reg | u_dut/kernel_h_rd_data_q_reg[62] | FDCE | u_dut/kernel_h_rd_data_q_reg | 5 | 0.454000000 | 1.382000000 | 1.836000000 | 0.752723312 | SLICE_X49Y38 | SLICE_X56Y37 |  |  | SIGNATURE_SKIPPED|FDCE|FDCE | SIGNATURE_SKIPPED|FDCE|FDCE | DUT_INTERNAL | u_dut/kernel_h_rd_addr_q_reg | u_dut/kernel_h_rd_data_q_reg | 0.005000000
u_dut/kernel_h_rd_data_q_reg[63]/D | u_dut/kernel_h_rd_addr_q_reg[3][0]/C | -0.018000000 | clk | clk | clk | u_dut/kernel_h_rd_addr_q_reg[3][0] | FDCE | u_dut/kernel_h_rd_addr_q_reg | u_dut/kernel_h_rd_data_q_reg[63] | FDCE | u_dut/kernel_h_rd_data_q_reg | 5 | 0.447000000 | 1.460000000 | 1.907000000 | 0.765600420 | SLICE_X49Y38 | SLICE_X54Y32 |  |  | SIGNATURE_SKIPPED|FDCE|FDCE | SIGNATURE_SKIPPED|FDCE|FDCE | DUT_INTERNAL | u_dut/kernel_h_rd_addr_q_reg | u_dut/kernel_h_rd_data_q_reg | 0.018000000
u_dut/kernel_h_rd_data_tail_q_reg[10]/CE | u_dut/kernel_phase_q_reg[0]/C | -0.034000000 | clk | clk | clk | u_dut/kernel_phase_q_reg[0] | FDCE | u_dut/kernel_phase_q_reg | u_dut/kernel_h_rd_data_tail_q_reg[10] | FDCE | u_dut/kernel_h_rd_data_tail_q_reg | 5 | 0.520000000 | 1.392000000 | 1.912000000 | 0.728033473 | SLICE_X64Y35 | SLICE_X54Y25 |  |  | SIGNATURE_SKIPPED|FDCE|FDCE | SIGNATURE_SKIPPED|FDCE|FDCE | DUT_INTERNAL | u_dut/kernel_phase_q_reg | u_dut/kernel_h_rd_data_tail_q_reg | 0.034000000
u_dut/kernel_h_rd_data_tail_q_reg[11]/CE | u_dut/kernel_phase_q_reg[0]/C | -0.023000000 | clk | clk | clk | u_dut/kernel_phase_q_reg[0] | FDCE | u_dut/kernel_phase_q_reg | u_dut/kernel_h_rd_data_tail_q_reg[11] | FDCE | u_dut/kernel_h_rd_data_tail_q_reg | 5 | 0.520000000 | 1.383000000 | 1.903000000 | 0.726747241 | SLICE_X64Y35 | SLICE_X54Y27 |  |  | SIGNATURE_SKIPPED|FDCE|FDCE | SIGNATURE_SKIPPED|FDCE|FDCE | DUT_INTERNAL | u_dut/kernel_phase_q_reg | u_dut/kernel_h_rd_data_tail_q_reg | 0.023000000
u_dut/kernel_h_rd_data_tail_q_reg[13]/CE | u_dut/kernel_phase_q_reg[0]/C | -0.019000000 | clk | clk | clk | u_dut/kernel_phase_q_reg[0] | FDCE | u_dut/kernel_phase_q_reg | u_dut/kernel_h_rd_data_tail_q_reg[13] | FDCE | u_dut/kernel_h_rd_data_tail_q_reg | 5 | 0.520000000 | 1.373000000 | 1.893000000 | 0.725303751 | SLICE_X64Y35 | SLICE_X54Y28 |  |  | SIGNATURE_SKIPPED|FDCE|FDCE | SIGNATURE_SKIPPED|FDCE|FDCE | DUT_INTERNAL | u_dut/kernel_phase_q_reg | u_dut/kernel_h_rd_data_tail_q_reg | 0.019000000
u_dut/kernel_h_rd_data_tail_q_reg[17]/CE | u_dut/kernel_phase_q_reg[0]/C | -0.041000000 | clk | clk | clk | u_dut/kernel_phase_q_reg[0] | FDCE | u_dut/kernel_phase_q_reg | u_dut/kernel_h_rd_data_tail_q_reg[17] | FDCE | u_dut/kernel_h_rd_data_tail_q_reg | 5 | 0.520000000 | 1.397000000 | 1.917000000 | 0.728742827 | SLICE_X64Y35 | SLICE_X51Y30 |  |  | SIGNATURE_SKIPPED|FDCE|FDCE | SIGNATURE_SKIPPED|FDCE|FDCE | DUT_INTERNAL | u_dut/kernel_phase_q_reg | u_dut/kernel_h_rd_data_tail_q_reg | 0.041000000
u_dut/kernel_h_rd_data_tail_q_reg[18]/CE | u_dut/kernel_phase_q_reg[0]/C | -0.034000000 | clk | clk | clk | u_dut/kernel_phase_q_reg[0] | FDCE | u_dut/kernel_phase_q_reg | u_dut/kernel_h_rd_data_tail_q_reg[18] | FDCE | u_dut/kernel_h_rd_data_tail_q_reg | 5 | 0.520000000 | 1.395000000 | 1.915000000 | 0.728459530 | SLICE_X64Y35 | SLICE_X48Y29 |  |  | SIGNATURE_SKIPPED|FDCE|FDCE | SIGNATURE_SKIPPED|FDCE|FDCE | DUT_INTERNAL | u_dut/kernel_phase_q_reg | u_dut/kernel_h_rd_data_tail_q_reg | 0.034000000
u_dut/kernel_h_rd_data_tail_q_reg[1]/D | u_dut/kernel_h_rd_addr_q_reg[0][3]/C | -0.029000000 | clk | clk | clk | u_dut/kernel_h_rd_addr_q_reg[0][3] | FDCE | u_dut/kernel_h_rd_addr_q_reg | u_dut/kernel_h_rd_data_tail_q_reg[1] | FDCE | u_dut/kernel_h_rd_data_tail_q_reg | 4 | 0.401000000 | 1.509000000 | 1.910000000 | 0.790052356 | SLICE_X59Y38 | SLICE_X57Y34 |  |  | SIGNATURE_SKIPPED|FDCE|FDCE | SIGNATURE_SKIPPED|FDCE|FDCE | DUT_INTERNAL | u_dut/kernel_h_rd_addr_q_reg | u_dut/kernel_h_rd_data_tail_q_reg | 0.029000000
u_dut/kernel_h_rd_data_tail_q_reg[21]/D | u_dut/kernel_h_rd_addr_q_reg[1][0]/C | -0.003000000 | clk | clk | clk | u_dut/kernel_h_rd_addr_q_reg[1][0] | FDCE | u_dut/kernel_h_rd_addr_q_reg | u_dut/kernel_h_rd_data_tail_q_reg[21] | FDCE | u_dut/kernel_h_rd_data_tail_q_reg | 4 | 0.405000000 | 1.460000000 | 1.865000000 | 0.782841823 | SLICE_X52Y29 | SLICE_X56Y32 |  |  | SIGNATURE_SKIPPED|FDCE|FDCE | SIGNATURE_SKIPPED|FDCE|FDCE | DUT_INTERNAL | u_dut/kernel_h_rd_addr_q_reg | u_dut/kernel_h_rd_data_tail_q_reg | 0.003000000
u_dut/kernel_h_rd_data_tail_q_reg[22]/CE | u_dut/kernel_phase_q_reg[0]/C | -0.015000000 | clk | clk | clk | u_dut/kernel_phase_q_reg[0] | FDCE | u_dut/kernel_phase_q_reg | u_dut/kernel_h_rd_data_tail_q_reg[22] | FDCE | u_dut/kernel_h_rd_data_tail_q_reg | 5 | 0.520000000 | 1.414000000 | 1.934000000 | 0.731127198 | SLICE_X64Y35 | SLICE_X51Y29 |  |  | SIGNATURE_SKIPPED|FDCE|FDCE | SIGNATURE_SKIPPED|FDCE|FDCE | DUT_INTERNAL | u_dut/kernel_phase_q_reg | u_dut/kernel_h_rd_data_tail_q_reg | 0.015000000
u_dut/kernel_h_rd_data_tail_q_reg[24]/CE | u_dut/kernel_phase_q_reg[0]/C | -0.007000000 | clk | clk | clk | u_dut/kernel_phase_q_reg[0] | FDCE | u_dut/kernel_phase_q_reg | u_dut/kernel_h_rd_data_tail_q_reg[24] | FDCE | u_dut/kernel_h_rd_data_tail_q_reg | 5 | 0.520000000 | 1.419000000 | 1.939000000 | 0.731820526 | SLICE_X64Y35 | SLICE_X48Y28 |  |  | SIGNATURE_SKIPPED|FDCE|FDCE | SIGNATURE_SKIPPED|FDCE|FDCE | DUT_INTERNAL | u_dut/kernel_phase_q_reg | u_dut/kernel_h_rd_data_tail_q_reg | 0.007000000
u_dut/kernel_h_rd_data_tail_q_reg[29]/CE | u_dut/kernel_phase_q_reg[0]/C | -0.034000000 | clk | clk | clk | u_dut/kernel_phase_q_reg[0] | FDCE | u_dut/kernel_phase_q_reg | u_dut/kernel_h_rd_data_tail_q_reg[29] | FDCE | u_dut/kernel_h_rd_data_tail_q_reg | 5 | 0.520000000 | 1.397000000 | 1.917000000 | 0.728742827 | SLICE_X64Y35 | SLICE_X48Y29 |  |  | SIGNATURE_SKIPPED|FDCE|FDCE | SIGNATURE_SKIPPED|FDCE|FDCE | DUT_INTERNAL | u_dut/kernel_phase_q_reg | u_dut/kernel_h_rd_data_tail_q_reg | 0.034000000
u_dut/kernel_h_rd_data_tail_q_reg[32]/CE | u_dut/kernel_phase_q_reg[0]/C | -0.007000000 | clk | clk | clk | u_dut/kernel_phase_q_reg[0] | FDCE | u_dut/kernel_phase_q_reg | u_dut/kernel_h_rd_data_tail_q_reg[32] | FDCE | u_dut/kernel_h_rd_data_tail_q_reg | 5 | 0.520000000 | 1.421000000 | 1.941000000 | 0.732096857 | SLICE_X64Y35 | SLICE_X48Y28 |  |  | SIGNATURE_SKIPPED|FDCE|FDCE | SIGNATURE_SKIPPED|FDCE|FDCE | DUT_INTERNAL | u_dut/kernel_phase_q_reg | u_dut/kernel_h_rd_data_tail_q_reg | 0.007000000
u_dut/kernel_h_rd_data_tail_q_reg[34]/CE | u_dut/kernel_phase_q_reg[0]/C | -0.014000000 | clk | clk | clk | u_dut/kernel_phase_q_reg[0] | FDCE | u_dut/kernel_phase_q_reg | u_dut/kernel_h_rd_data_tail_q_reg[34] | FDCE | u_dut/kernel_h_rd_data_tail_q_reg | 5 | 0.520000000 | 1.410000000 | 1.930000000 | 0.730569948 | SLICE_X64Y35 | SLICE_X51Y32 |  |  | SIGNATURE_SKIPPED|FDCE|FDCE | SIGNATURE_SKIPPED|FDCE|FDCE | DUT_INTERNAL | u_dut/kernel_phase_q_reg | u_dut/kernel_h_rd_data_tail_q_reg | 0.014000000
u_dut/kernel_h_rd_data_tail_q_reg[35]/CE | u_dut/kernel_phase_q_reg[0]/C | -0.043000000 | clk | clk | clk | u_dut/kernel_phase_q_reg[0] | FDCE | u_dut/kernel_phase_q_reg | u_dut/kernel_h_rd_data_tail_q_reg[35] | FDCE | u_dut/kernel_h_rd_data_tail_q_reg | 5 | 0.520000000 | 1.395000000 | 1.915000000 | 0.728459530 | SLICE_X64Y35 | SLICE_X54Y28 |  |  | SIGNATURE_SKIPPED|FDCE|FDCE | SIGNATURE_SKIPPED|FDCE|FDCE | DUT_INTERNAL | u_dut/kernel_phase_q_reg | u_dut/kernel_h_rd_data_tail_q_reg | 0.043000000
u_dut/kernel_h_rd_data_tail_q_reg[36]/CE | u_dut/kernel_phase_q_reg[0]/C | -0.017000000 | clk | clk | clk | u_dut/kernel_phase_q_reg[0] | FDCE | u_dut/kernel_phase_q_reg | u_dut/kernel_h_rd_data_tail_q_reg[36] | FDCE | u_dut/kernel_h_rd_data_tail_q_reg | 5 | 0.520000000 | 1.368000000 | 1.888000000 | 0.724576271 | SLICE_X64Y35 | SLICE_X54Y29 |  |  | SIGNATURE_SKIPPED|FDCE|FDCE | SIGNATURE_SKIPPED|FDCE|FDCE | DUT_INTERNAL | u_dut/kernel_phase_q_reg | u_dut/kernel_h_rd_data_tail_q_reg | 0.017000000
u_dut/kernel_h_rd_data_tail_q_reg[36]/D | u_dut/kernel_h_rd_addr_q_reg[2][0]_replica_2/C | -0.010000000 | clk | clk | clk | u_dut/kernel_h_rd_addr_q_reg[2][0]_replica_2 | FDCE | u_dut/kernel_h_rd_addr_q_reg_replica_2 | u_dut/kernel_h_rd_data_tail_q_reg[36] | FDCE | u_dut/kernel_h_rd_data_tail_q_reg | 4 | 0.360000000 | 1.510000000 | 1.870000000 | 0.807486631 | SLICE_X44Y34 | SLICE_X54Y29 |  |  | SIGNATURE_SKIPPED|FDCE|FDCE | SIGNATURE_SKIPPED|FDCE|FDCE | DUT_INTERNAL | u_dut/kernel_h_rd_addr_q_reg_replica_2 | u_dut/kernel_h_rd_data_tail_q_reg | 0.010000000
u_dut/kernel_h_rd_data_tail_q_reg[37]/D | u_dut/kernel_h_rd_addr_q_reg[2][3]/C | -0.012000000 | clk | clk | clk | u_dut/kernel_h_rd_addr_q_reg[2][3] | FDCE | u_dut/kernel_h_rd_addr_q_reg | u_dut/kernel_h_rd_data_tail_q_reg[37] | FDCE | u_dut/kernel_h_rd_data_tail_q_reg | 4 | 0.351000000 | 1.445000000 | 1.796000000 | 0.804565702 | SLICE_X41Y27 | SLICE_X56Y33 |  |  | SIGNATURE_SKIPPED|FDCE|FDCE | SIGNATURE_SKIPPED|FDCE|FDCE | DUT_INTERNAL | u_dut/kernel_h_rd_addr_q_reg | u_dut/kernel_h_rd_data_tail_q_reg | 0.012000000
u_dut/kernel_h_rd_data_tail_q_reg[41]/CE | u_dut/kernel_phase_q_reg[0]/C | -0.010000000 | clk | clk | clk | u_dut/kernel_phase_q_reg[0] | FDCE | u_dut/kernel_phase_q_reg | u_dut/kernel_h_rd_data_tail_q_reg[41] | FDCE | u_dut/kernel_h_rd_data_tail_q_reg | 5 | 0.520000000 | 1.353000000 | 1.873000000 | 0.722370529 | SLICE_X64Y35 | SLICE_X54Y30 |  |  | SIGNATURE_SKIPPED|FDCE|FDCE | SIGNATURE_SKIPPED|FDCE|FDCE | DUT_INTERNAL | u_dut/kernel_phase_q_reg | u_dut/kernel_h_rd_data_tail_q_reg | 0.010000000
u_dut/kernel_h_rd_data_tail_q_reg[50]/CE | u_dut/kernel_phase_q_reg[0]/C | -0.041000000 | clk | clk | clk | u_dut/kernel_phase_q_reg[0] | FDCE | u_dut/kernel_phase_q_reg | u_dut/kernel_h_rd_data_tail_q_reg[50] | FDCE | u_dut/kernel_h_rd_data_tail_q_reg | 5 | 0.520000000 | 1.451000000 | 1.971000000 | 0.736174531 | SLICE_X64Y35 | SLICE_X48Y33 |  |  | SIGNATURE_SKIPPED|FDCE|FDCE | SIGNATURE_SKIPPED|FDCE|FDCE | DUT_INTERNAL | u_dut/kernel_phase_q_reg | u_dut/kernel_h_rd_data_tail_q_reg | 0.041000000
u_dut/kernel_h_rd_data_tail_q_reg[55]/CE | u_dut/kernel_phase_q_reg[0]/C | -0.043000000 | clk | clk | clk | u_dut/kernel_phase_q_reg[0] | FDCE | u_dut/kernel_phase_q_reg | u_dut/kernel_h_rd_data_tail_q_reg[55] | FDCE | u_dut/kernel_h_rd_data_tail_q_reg | 5 | 0.520000000 | 1.395000000 | 1.915000000 | 0.728459530 | SLICE_X64Y35 | SLICE_X54Y28 |  |  | SIGNATURE_SKIPPED|FDCE|FDCE | SIGNATURE_SKIPPED|FDCE|FDCE | DUT_INTERNAL | u_dut/kernel_phase_q_reg | u_dut/kernel_h_rd_data_tail_q_reg | 0.043000000
u_dut/kernel_h_rd_data_tail_q_reg[56]/CE | u_dut/kernel_phase_q_reg[0]/C | -0.013000000 | clk | clk | clk | u_dut/kernel_phase_q_reg[0] | FDCE | u_dut/kernel_phase_q_reg | u_dut/kernel_h_rd_data_tail_q_reg[56] | FDCE | u_dut/kernel_h_rd_data_tail_q_reg | 5 | 0.520000000 | 1.309000000 | 1.829000000 | 0.715691635 | SLICE_X64Y35 | SLICE_X57Y36 |  |  | SIGNATURE_SKIPPED|FDCE|FDCE | SIGNATURE_SKIPPED|FDCE|FDCE | DUT_INTERNAL | u_dut/kernel_phase_q_reg | u_dut/kernel_h_rd_data_tail_q_reg | 0.013000000
u_dut/kernel_h_rd_data_tail_q_reg[57]/CE | u_dut/kernel_phase_q_reg[0]/C | -0.033000000 | clk | clk | clk | u_dut/kernel_phase_q_reg[0] | FDCE | u_dut/kernel_phase_q_reg | u_dut/kernel_h_rd_data_tail_q_reg[57] | FDCE | u_dut/kernel_h_rd_data_tail_q_reg | 5 | 0.520000000 | 1.420000000 | 1.940000000 | 0.731958763 | SLICE_X64Y35 | SLICE_X45Y34 |  |  | SIGNATURE_SKIPPED|FDCE|FDCE | SIGNATURE_SKIPPED|FDCE|FDCE | DUT_INTERNAL | u_dut/kernel_phase_q_reg | u_dut/kernel_h_rd_data_tail_q_reg | 0.033000000
u_dut/kernel_h_rd_data_tail_q_reg[59]/CE | u_dut/kernel_phase_q_reg[0]/C | -0.015000000 | clk | clk | clk | u_dut/kernel_phase_q_reg[0] | FDCE | u_dut/kernel_phase_q_reg | u_dut/kernel_h_rd_data_tail_q_reg[59] | FDCE | u_dut/kernel_h_rd_data_tail_q_reg | 5 | 0.520000000 | 1.311000000 | 1.831000000 | 0.716002185 | SLICE_X64Y35 | SLICE_X57Y36 |  |  | SIGNATURE_SKIPPED|FDCE|FDCE | SIGNATURE_SKIPPED|FDCE|FDCE | DUT_INTERNAL | u_dut/kernel_phase_q_reg | u_dut/kernel_h_rd_data_tail_q_reg | 0.015000000
u_dut/kernel_h_rd_data_tail_q_reg[59]/D | u_dut/kernel_h_rd_addr_q_reg[3][2]/C | -0.008000000 | clk | clk | clk | u_dut/kernel_h_rd_addr_q_reg[3][2] | FDCE | u_dut/kernel_h_rd_addr_q_reg | u_dut/kernel_h_rd_data_tail_q_reg[59] | FDCE | u_dut/kernel_h_rd_data_tail_q_reg | 4 | 0.358000000 | 1.598000000 | 1.956000000 | 0.816973415 | SLICE_X56Y38 | SLICE_X57Y36 |  |  | SIGNATURE_SKIPPED|FDCE|FDCE | SIGNATURE_SKIPPED|FDCE|FDCE | DUT_INTERNAL | u_dut/kernel_h_rd_addr_q_reg | u_dut/kernel_h_rd_data_tail_q_reg | 0.008000000
u_dut/kernel_h_rd_data_tail_q_reg[60]/CE | u_dut/kernel_phase_q_reg[0]/C | -0.024000000 | clk | clk | clk | u_dut/kernel_phase_q_reg[0] | FDCE | u_dut/kernel_phase_q_reg | u_dut/kernel_h_rd_data_tail_q_reg[60] | FDCE | u_dut/kernel_h_rd_data_tail_q_reg | 5 | 0.520000000 | 1.437000000 | 1.957000000 | 0.734287174 | SLICE_X64Y35 | SLICE_X48Y33 |  |  | SIGNATURE_SKIPPED|FDCE|FDCE | SIGNATURE_SKIPPED|FDCE|FDCE | DUT_INTERNAL | u_dut/kernel_phase_q_reg | u_dut/kernel_h_rd_data_tail_q_reg | 0.024000000
u_dut/kernel_h_rd_data_tail_q_reg[61]/CE | u_dut/kernel_phase_q_reg[0]/C | -0.036000000 | clk | clk | clk | u_dut/kernel_phase_q_reg[0] | FDCE | u_dut/kernel_phase_q_reg | u_dut/kernel_h_rd_data_tail_q_reg[61] | FDCE | u_dut/kernel_h_rd_data_tail_q_reg | 5 | 0.520000000 | 1.446000000 | 1.966000000 | 0.735503561 | SLICE_X64Y35 | SLICE_X48Y27 |  |  | SIGNATURE_SKIPPED|FDCE|FDCE | SIGNATURE_SKIPPED|FDCE|FDCE | DUT_INTERNAL | u_dut/kernel_phase_q_reg | u_dut/kernel_h_rd_data_tail_q_reg | 0.036000000
u_dut/kernel_h_rd_data_tail_q_reg[63]/D | u_dut/kernel_h_rd_addr_q_reg[3][0]/C | -0.017000000 | clk | clk | clk | u_dut/kernel_h_rd_addr_q_reg[3][0] | FDCE | u_dut/kernel_h_rd_addr_q_reg | u_dut/kernel_h_rd_data_tail_q_reg[63] | FDCE | u_dut/kernel_h_rd_data_tail_q_reg | 4 | 0.411000000 | 1.430000000 | 1.841000000 | 0.776751765 | SLICE_X49Y38 | SLICE_X57Y34 |  |  | SIGNATURE_SKIPPED|FDCE|FDCE | SIGNATURE_SKIPPED|FDCE|FDCE | DUT_INTERNAL | u_dut/kernel_h_rd_addr_q_reg | u_dut/kernel_h_rd_data_tail_q_reg | 0.017000000
u_dut/kernel_h_rd_data_tail_q_reg[7]/D | u_dut/kernel_h_rd_addr_q_reg[0][3]/C | -0.038000000 | clk | clk | clk | u_dut/kernel_h_rd_addr_q_reg[0][3] | FDCE | u_dut/kernel_h_rd_addr_q_reg | u_dut/kernel_h_rd_data_tail_q_reg[7] | FDCE | u_dut/kernel_h_rd_data_tail_q_reg | 4 | 0.398000000 | 1.522000000 | 1.920000000 | 0.792708333 | SLICE_X59Y38 | SLICE_X56Y33 |  |  | SIGNATURE_SKIPPED|FDCE|FDCE | SIGNATURE_SKIPPED|FDCE|FDCE | DUT_INTERNAL | u_dut/kernel_h_rd_addr_q_reg | u_dut/kernel_h_rd_data_tail_q_reg | 0.038000000
u_dut/kernel_h_rd_raw_group_q_reg[1]/CE | u_dut/kernel_phase_q_reg[0]/C | -0.045000000 | clk | clk | clk | u_dut/kernel_phase_q_reg[0] | FDCE | u_dut/kernel_phase_q_reg | u_dut/kernel_h_rd_raw_group_q_reg[1] | FDCE | u_dut/kernel_h_rd_raw_group_q_reg | 5 | 0.575000000 | 1.283000000 | 1.858000000 | 0.690527449 | SLICE_X64Y35 | SLICE_X56Y33 |  |  | SIGNATURE_SKIPPED|FDCE|FDCE | SIGNATURE_SKIPPED|FDCE|FDCE | DUT_INTERNAL | u_dut/kernel_phase_q_reg | u_dut/kernel_h_rd_raw_group_q_reg | 0.045000000
u_dut/kernel_h_rd_raw_vector_q_reg[0]/CE | u_dut/kernel_phase_q_reg[0]/C | -0.045000000 | clk | clk | clk | u_dut/kernel_phase_q_reg[0] | FDCE | u_dut/kernel_phase_q_reg | u_dut/kernel_h_rd_raw_vector_q_reg[0] | FDCE | u_dut/kernel_h_rd_raw_vector_q_reg | 5 | 0.575000000 | 1.283000000 | 1.858000000 | 0.690527449 | SLICE_X64Y35 | SLICE_X56Y33 |  |  | SIGNATURE_SKIPPED|FDCE|FDCE | SIGNATURE_SKIPPED|FDCE|FDCE | DUT_INTERNAL | u_dut/kernel_phase_q_reg | u_dut/kernel_h_rd_raw_vector_q_reg | 0.045000000
u_dut/kernel_h_rd_raw_vector_q_reg[5]/CE | u_dut/kernel_phase_q_reg[0]/C | -0.045000000 | clk | clk | clk | u_dut/kernel_phase_q_reg[0] | FDCE | u_dut/kernel_phase_q_reg | u_dut/kernel_h_rd_raw_vector_q_reg[5] | FDCE | u_dut/kernel_h_rd_raw_vector_q_reg | 5 | 0.575000000 | 1.283000000 | 1.858000000 | 0.690527449 | SLICE_X64Y35 | SLICE_X56Y33 |  |  | SIGNATURE_SKIPPED|FDCE|FDCE | SIGNATURE_SKIPPED|FDCE|FDCE | DUT_INTERNAL | u_dut/kernel_phase_q_reg | u_dut/kernel_h_rd_raw_vector_q_reg | 0.045000000
u_dut/kernel_h_rd_raw_vector_q_reg[6]_inv/CE | u_dut/kernel_phase_q_reg[0]/C | -0.044000000 | clk | clk | clk | u_dut/kernel_phase_q_reg[0] | FDCE | u_dut/kernel_phase_q_reg | u_dut/kernel_h_rd_raw_vector_q_reg[6]_inv | FDPE | u_dut/kernel_h_rd_raw_vector_q_reg_inv | 5 | 0.575000000 | 1.283000000 | 1.858000000 | 0.690527449 | SLICE_X64Y35 | SLICE_X56Y33 |  |  | SIGNATURE_SKIPPED|FDCE|FDPE | SIGNATURE_SKIPPED|FDCE|FDPE | DUT_INTERNAL | u_dut/kernel_phase_q_reg | u_dut/kernel_h_rd_raw_vector_q_reg_inv | 0.044000000
u_dut/kernel_rd_raw_data_q_reg[19]/D | u_dut/rd_cmd_addr_q_reg[1][0][0]_replica_3/C | -0.002000000 | clk | clk | clk | u_dut/rd_cmd_addr_q_reg[1][0][0]_replica_3 | FDCE | u_dut/rd_cmd_addr_q_reg_replica_3 | u_dut/kernel_rd_raw_data_q_reg[19] | FDCE | u_dut/kernel_rd_raw_data_q_reg | 5 | 0.480000000 | 1.372000000 | 1.852000000 | 0.740820734 | SLICE_X67Y3 | SLICE_X72Y19 |  |  | SIGNATURE_SKIPPED|FDCE|FDCE | SIGNATURE_SKIPPED|FDCE|FDCE | DUT_INTERNAL | u_dut/rd_cmd_addr_q_reg_replica_3 | u_dut/kernel_rd_raw_data_q_reg | 0.002000000
u_dut/kernel_rd_raw_data_q_reg[20]/D | u_dut/rd_cmd_addr_q_reg[1][0][0]_replica_3/C | -0.016000000 | clk | clk | clk | u_dut/rd_cmd_addr_q_reg[1][0][0]_replica_3 | FDCE | u_dut/rd_cmd_addr_q_reg_replica_3 | u_dut/kernel_rd_raw_data_q_reg[20] | FDCE | u_dut/kernel_rd_raw_data_q_reg | 5 | 0.434000000 | 1.436000000 | 1.870000000 | 0.767914439 | SLICE_X67Y3 | SLICE_X70Y17 |  |  | SIGNATURE_SKIPPED|FDCE|FDCE | SIGNATURE_SKIPPED|FDCE|FDCE | DUT_INTERNAL | u_dut/rd_cmd_addr_q_reg_replica_3 | u_dut/kernel_rd_raw_data_q_reg | 0.016000000
u_dut/kernel_rd_raw_data_q_reg[22]/D | u_dut/rd_cmd_addr_q_reg[0][0][3]_replica/C | -0.012000000 | clk | clk | clk | u_dut/rd_cmd_addr_q_reg[0][0][3]_replica | FDCE | u_dut/rd_cmd_addr_q_reg_replica | u_dut/kernel_rd_raw_data_q_reg[22] | FDCE | u_dut/kernel_rd_raw_data_q_reg | 5 | 0.473000000 | 1.389000000 | 1.862000000 | 0.745972073 | SLICE_X58Y19 | SLICE_X70Y19 |  |  | SIGNATURE_SKIPPED|FDCE|FDCE | SIGNATURE_SKIPPED|FDCE|FDCE | DUT_INTERNAL | u_dut/rd_cmd_addr_q_reg_replica | u_dut/kernel_rd_raw_data_q_reg | 0.012000000
u_dut/kernel_rd_raw_data_q_reg[23]/D | u_dut/rd_cmd_addr_q_reg[1][0][1]_replica_1/C | -0.038000000 | clk | clk | clk | u_dut/rd_cmd_addr_q_reg[1][0][1]_replica_1 | FDCE | u_dut/rd_cmd_addr_q_reg_replica_1 | u_dut/kernel_rd_raw_data_q_reg[23] | FDCE | u_dut/kernel_rd_raw_data_q_reg | 5 | 0.469000000 | 1.486000000 | 1.955000000 | 0.760102302 | SLICE_X78Y21 | SLICE_X72Y24 |  |  | SIGNATURE_SKIPPED|FDCE|FDCE | SIGNATURE_SKIPPED|FDCE|FDCE | DUT_INTERNAL | u_dut/rd_cmd_addr_q_reg_replica_1 | u_dut/kernel_rd_raw_data_q_reg | 0.038000000
u_dut/kernel_rd_raw_data_q_reg[27]/D | u_dut/rd_cmd_addr_q_reg[1][0][1]_replica_1/C | -0.010000000 | clk | clk | clk | u_dut/rd_cmd_addr_q_reg[1][0][1]_replica_1 | FDCE | u_dut/rd_cmd_addr_q_reg_replica_1 | u_dut/kernel_rd_raw_data_q_reg[27] | FDCE | u_dut/kernel_rd_raw_data_q_reg | 5 | 0.418000000 | 1.509000000 | 1.927000000 | 0.783082512 | SLICE_X78Y21 | SLICE_X72Y24 |  |  | SIGNATURE_SKIPPED|FDCE|FDCE | SIGNATURE_SKIPPED|FDCE|FDCE | DUT_INTERNAL | u_dut/rd_cmd_addr_q_reg_replica_1 | u_dut/kernel_rd_raw_data_q_reg | 0.010000000
u_dut/kernel_rd_raw_data_q_reg[29]/CE | u_dut/kernel_phase_q_reg[0]/C | -0.013000000 | clk | clk | clk | u_dut/kernel_phase_q_reg[0] | FDCE | u_dut/kernel_phase_q_reg | u_dut/kernel_rd_raw_data_q_reg[29] | FDCE | u_dut/kernel_rd_raw_data_q_reg | 4 | 0.522000000 | 1.276000000 | 1.798000000 | 0.709677419 | SLICE_X64Y35 | SLICE_X77Y21 |  |  | SIGNATURE_SKIPPED|FDCE|FDCE | SIGNATURE_SKIPPED|FDCE|FDCE | DUT_INTERNAL | u_dut/kernel_phase_q_reg | u_dut/kernel_rd_raw_data_q_reg | 0.013000000
u_dut/kernel_rd_raw_data_q_reg[2]/D | u_dut/rd_cmd_addr_q_reg[0][0][0]/C | -0.032000000 | clk | clk | clk | u_dut/rd_cmd_addr_q_reg[0][0][0] | FDCE | u_dut/rd_cmd_addr_q_reg | u_dut/kernel_rd_raw_data_q_reg[2] | FDCE | u_dut/kernel_rd_raw_data_q_reg | 5 | 0.519000000 | 1.446000000 | 1.965000000 | 0.735877863 | SLICE_X78Y8 | SLICE_X72Y15 |  |  | SIGNATURE_SKIPPED|FDCE|FDCE | SIGNATURE_SKIPPED|FDCE|FDCE | DUT_INTERNAL | u_dut/rd_cmd_addr_q_reg | u_dut/kernel_rd_raw_data_q_reg | 0.032000000
u_dut/kernel_rd_raw_data_q_reg[30]/D | u_dut/rd_cmd_addr_q_reg[1][0][3]_replica_1/C | -0.030000000 | clk | clk | clk | u_dut/rd_cmd_addr_q_reg[1][0][3]_replica_1 | FDCE | u_dut/rd_cmd_addr_q_reg_replica_1 | u_dut/kernel_rd_raw_data_q_reg[30] | FDCE | u_dut/kernel_rd_raw_data_q_reg | 5 | 0.500000000 | 1.429000000 | 1.929000000 | 0.740798341 | SLICE_X78Y28 | SLICE_X76Y27 |  |  | SIGNATURE_SKIPPED|FDCE|FDCE | SIGNATURE_SKIPPED|FDCE|FDCE | DUT_INTERNAL | u_dut/rd_cmd_addr_q_reg_replica_1 | u_dut/kernel_rd_raw_data_q_reg | 0.030000000
u_dut/kernel_rd_raw_data_q_reg[31]/D | u_dut/rd_cmd_addr_q_reg[0][1][5]/C | -0.031000000 | clk | clk | clk | u_dut/rd_cmd_addr_q_reg[0][1][5] | FDCE | u_dut/rd_cmd_addr_q_reg | u_dut/kernel_rd_raw_data_q_reg[31] | FDCE | u_dut/kernel_rd_raw_data_q_reg | 5 | 0.321000000 | 1.538000000 | 1.859000000 | 0.827326520 | SLICE_X58Y19 | SLICE_X76Y22 |  |  | SIGNATURE_SKIPPED|FDCE|FDCE | SIGNATURE_SKIPPED|FDCE|FDCE | DUT_INTERNAL | u_dut/rd_cmd_addr_q_reg | u_dut/kernel_rd_raw_data_q_reg | 0.031000000
u_dut/kernel_rd_raw_data_q_reg[32]/D | u_dut/rd_cmd_addr_q_reg[0][0][2]_replica/C | -0.008000000 | clk | clk | clk | u_dut/rd_cmd_addr_q_reg[0][0][2]_replica | FDCE | u_dut/rd_cmd_addr_q_reg_replica | u_dut/kernel_rd_raw_data_q_reg[32] | FDCE | u_dut/kernel_rd_raw_data_q_reg | 5 | 0.445000000 | 1.458000000 | 1.903000000 | 0.766158697 | SLICE_X56Y19 | SLICE_X71Y24 |  |  | SIGNATURE_SKIPPED|FDCE|FDCE | SIGNATURE_SKIPPED|FDCE|FDCE | DUT_INTERNAL | u_dut/rd_cmd_addr_q_reg_replica | u_dut/kernel_rd_raw_data_q_reg | 0.008000000
u_dut/kernel_rd_raw_data_q_reg[3]/D | u_dut/rd_cmd_addr_q_reg[1][0][1]_replica_2/C | -0.024000000 | clk | clk | clk | u_dut/rd_cmd_addr_q_reg[1][0][1]_replica_2 | FDCE | u_dut/rd_cmd_addr_q_reg_replica_2 | u_dut/kernel_rd_raw_data_q_reg[3] | FDCE | u_dut/kernel_rd_raw_data_q_reg | 5 | 0.529000000 | 1.374000000 | 1.903000000 | 0.722017867 | SLICE_X67Y6 | SLICE_X71Y19 |  |  | SIGNATURE_SKIPPED|FDCE|FDCE | SIGNATURE_SKIPPED|FDCE|FDCE | DUT_INTERNAL | u_dut/rd_cmd_addr_q_reg_replica_2 | u_dut/kernel_rd_raw_data_q_reg | 0.024000000
u_dut/kernel_rd_raw_data_q_reg[40]/D | u_dut/rd_cmd_addr_q_reg[0][0][3]_replica_2/C | -0.025000000 | clk | clk | clk | u_dut/rd_cmd_addr_q_reg[0][0][3]_replica_2 | FDCE | u_dut/rd_cmd_addr_q_reg_replica_2 | u_dut/kernel_rd_raw_data_q_reg[40] | FDCE | u_dut/kernel_rd_raw_data_q_reg | 5 | 0.452000000 | 1.434000000 | 1.886000000 | 0.760339343 | SLICE_X64Y18 | SLICE_X75Y28 |  |  | SIGNATURE_SKIPPED|FDCE|FDCE | SIGNATURE_SKIPPED|FDCE|FDCE | DUT_INTERNAL | u_dut/rd_cmd_addr_q_reg_replica_2 | u_dut/kernel_rd_raw_data_q_reg | 0.025000000
u_dut/kernel_rd_raw_data_q_reg[42]/D | u_dut/rd_cmd_addr_q_reg[1][0][3]_replica_1/C | -0.002000000 | clk | clk | clk | u_dut/rd_cmd_addr_q_reg[1][0][3]_replica_1 | FDCE | u_dut/rd_cmd_addr_q_reg_replica_1 | u_dut/kernel_rd_raw_data_q_reg[42] | FDCE | u_dut/kernel_rd_raw_data_q_reg | 5 | 0.423000000 | 1.511000000 | 1.934000000 | 0.781282316 | SLICE_X78Y28 | SLICE_X72Y18 |  |  | SIGNATURE_SKIPPED|FDCE|FDCE | SIGNATURE_SKIPPED|FDCE|FDCE | DUT_INTERNAL | u_dut/rd_cmd_addr_q_reg_replica_1 | u_dut/kernel_rd_raw_data_q_reg | 0.002000000
u_dut/kernel_rd_raw_data_q_reg[4]/D | u_dut/rd_cmd_addr_q_reg[1][0][4]/C | -0.029000000 | clk | clk | clk | u_dut/rd_cmd_addr_q_reg[1][0][4] | FDCE | u_dut/rd_cmd_addr_q_reg | u_dut/kernel_rd_raw_data_q_reg[4] | FDCE | u_dut/kernel_rd_raw_data_q_reg | 5 | 0.373000000 | 1.534000000 | 1.907000000 | 0.804404824 | SLICE_X61Y17 | SLICE_X71Y19 |  |  | SIGNATURE_SKIPPED|FDCE|FDCE | SIGNATURE_SKIPPED|FDCE|FDCE | DUT_INTERNAL | u_dut/rd_cmd_addr_q_reg | u_dut/kernel_rd_raw_data_q_reg | 0.029000000
u_dut/kernel_rd_raw_data_q_reg[55]/D | u_dut/rd_cmd_addr_q_reg[1][3][4]/C | -0.038000000 | clk | clk | clk | u_dut/rd_cmd_addr_q_reg[1][3][4] | FDCE | u_dut/rd_cmd_addr_q_reg | u_dut/kernel_rd_raw_data_q_reg[55] | FDCE | u_dut/kernel_rd_raw_data_q_reg | 5 | 0.391000000 | 1.520000000 | 1.911000000 | 0.795395081 | SLICE_X72Y7 | SLICE_X75Y28 |  |  | SIGNATURE_SKIPPED|FDCE|FDCE | SIGNATURE_SKIPPED|FDCE|FDCE | DUT_INTERNAL | u_dut/rd_cmd_addr_q_reg | u_dut/kernel_rd_raw_data_q_reg | 0.038000000
u_dut/kernel_rd_raw_data_q_reg[58]/D | u_dut/rd_cmd_addr_q_reg[1][3][5]/C | -0.010000000 | clk | clk | clk | u_dut/rd_cmd_addr_q_reg[1][3][5] | FDCE | u_dut/rd_cmd_addr_q_reg | u_dut/kernel_rd_raw_data_q_reg[58] | FDCE | u_dut/kernel_rd_raw_data_q_reg | 5 | 0.388000000 | 1.547000000 | 1.935000000 | 0.799483204 | SLICE_X72Y5 | SLICE_X71Y24 |  |  | SIGNATURE_SKIPPED|FDCE|FDCE | SIGNATURE_SKIPPED|FDCE|FDCE | DUT_INTERNAL | u_dut/rd_cmd_addr_q_reg | u_dut/kernel_rd_raw_data_q_reg | 0.010000000
u_dut/kernel_rd_raw_data_q_reg[59]/D | u_dut/rd_cmd_addr_q_reg[1][0][2]_replica/C | -0.016000000 | clk | clk | clk | u_dut/rd_cmd_addr_q_reg[1][0][2]_replica | FDCE | u_dut/rd_cmd_addr_q_reg_replica | u_dut/kernel_rd_raw_data_q_reg[59] | FDCE | u_dut/kernel_rd_raw_data_q_reg | 5 | 0.459000000 | 1.413000000 | 1.872000000 | 0.754807692 | SLICE_X58Y18 | SLICE_X71Y29 |  |  | SIGNATURE_SKIPPED|FDCE|FDCE | SIGNATURE_SKIPPED|FDCE|FDCE | DUT_INTERNAL | u_dut/rd_cmd_addr_q_reg_replica | u_dut/kernel_rd_raw_data_q_reg | 0.016000000
u_dut/kernel_rd_raw_data_q_reg[60]/D | u_dut/rd_cmd_addr_q_reg[1][0][3]_replica/C | -0.001000000 | clk | clk | clk | u_dut/rd_cmd_addr_q_reg[1][0][3]_replica | FDCE | u_dut/rd_cmd_addr_q_reg_replica | u_dut/kernel_rd_raw_data_q_reg[60] | FDCE | u_dut/kernel_rd_raw_data_q_reg | 5 | 0.495000000 | 1.354000000 | 1.849000000 | 0.732287723 | SLICE_X58Y19 | SLICE_X72Y15 |  |  | SIGNATURE_SKIPPED|FDCE|FDCE | SIGNATURE_SKIPPED|FDCE|FDCE | DUT_INTERNAL | u_dut/rd_cmd_addr_q_reg_replica | u_dut/kernel_rd_raw_data_q_reg | 0.001000000
u_dut/kernel_rd_raw_data_q_reg[9]/D | u_dut/rd_cmd_addr_q_reg[1][0][1]_replica/C | -0.025000000 | clk | clk | clk | u_dut/rd_cmd_addr_q_reg[1][0][1]_replica | FDCE | u_dut/rd_cmd_addr_q_reg_replica | u_dut/kernel_rd_raw_data_q_reg[9] | FDCE | u_dut/kernel_rd_raw_data_q_reg | 5 | 0.556000000 | 1.354000000 | 1.910000000 | 0.708900524 | SLICE_X58Y19 | SLICE_X71Y23 |  |  | SIGNATURE_SKIPPED|FDCE|FDCE | SIGNATURE_SKIPPED|FDCE|FDCE | DUT_INTERNAL | u_dut/rd_cmd_addr_q_reg_replica | u_dut/kernel_rd_raw_data_q_reg | 0.025000000
u_dut/kernel_rd_req_group_q_reg[0]/CE | u_dut/kernel_phase_q_reg[0]/C | -0.009000000 | clk | clk | clk | u_dut/kernel_phase_q_reg[0] | FDCE | u_dut/kernel_phase_q_reg | u_dut/kernel_rd_req_group_q_reg[0] | FDCE | u_dut/kernel_rd_req_group_q_reg | 5 | 0.533000000 | 1.296000000 | 1.829000000 | 0.708583926 | SLICE_X64Y35 | SLICE_X67Y23 |  |  | SIGNATURE_SKIPPED|FDCE|FDCE | SIGNATURE_SKIPPED|FDCE|FDCE | DUT_INTERNAL | u_dut/kernel_phase_q_reg | u_dut/kernel_rd_req_group_q_reg | 0.009000000
u_dut/kernel_rd_resp_data_q_reg[20]/D | u_dut/kernel_cut_h_q_reg[5]/C | -0.008000000 | clk | clk | clk | u_dut/kernel_cut_h_q_reg[5] | FDCE | u_dut/kernel_cut_h_q_reg | u_dut/kernel_rd_resp_data_q_reg[20] | FDCE | u_dut/kernel_rd_resp_data_q_reg | 4 | 0.431000000 | 1.456000000 | 1.887000000 | 0.771595125 | SLICE_X61Y25 | SLICE_X70Y31 |  |  | SIGNATURE_SKIPPED|FDCE|FDCE | SIGNATURE_SKIPPED|FDCE|FDCE | DUT_INTERNAL | u_dut/kernel_cut_h_q_reg | u_dut/kernel_rd_resp_data_q_reg | 0.008000000
u_dut/kernel_rd_resp_data_q_reg[27]/D | u_dut/kernel_cut_h_q_reg[5]/C | -0.017000000 | clk | clk | clk | u_dut/kernel_cut_h_q_reg[5] | FDCE | u_dut/kernel_cut_h_q_reg | u_dut/kernel_rd_resp_data_q_reg[27] | FDCE | u_dut/kernel_rd_resp_data_q_reg | 4 | 0.517000000 | 1.379000000 | 1.896000000 | 0.727320675 | SLICE_X61Y25 | SLICE_X72Y33 |  |  | SIGNATURE_SKIPPED|FDCE|FDCE | SIGNATURE_SKIPPED|FDCE|FDCE | DUT_INTERNAL | u_dut/kernel_cut_h_q_reg | u_dut/kernel_rd_resp_data_q_reg | 0.017000000
u_dut/kernel_rd_resp_valid_q_reg/D | u_dut/kernel_vector_q_reg[0]/C | -0.006000000 | clk | clk | clk | u_dut/kernel_vector_q_reg[0] | FDCE | u_dut/kernel_vector_q_reg | u_dut/kernel_rd_resp_valid_q_reg | FDCE | u_dut/kernel_rd_resp_valid_q_reg | 7 | 0.636000000 | 1.237000000 | 1.873000000 | 0.660437800 | SLICE_X59Y21 | SLICE_X68Y34 |  |  | SIGNATURE_SKIPPED|FDCE|FDCE | SIGNATURE_SKIPPED|FDCE|FDCE | DUT_INTERNAL | u_dut/kernel_vector_q_reg | u_dut/kernel_rd_resp_valid_q_reg | 0.006000000
u_dut/kernel_vector_q_reg[0]_rep__0/D | u_dut/kernel_vector_q_reg[1]_rep__1/C | -0.031000000 | clk | clk | clk | u_dut/kernel_vector_q_reg[1]_rep__1 | FDCE | u_dut/kernel_vector_q_reg_rep__1 | u_dut/kernel_vector_q_reg[0]_rep__0 | FDCE | u_dut/kernel_vector_q_reg_rep__0 | 5 | 0.560000000 | 1.349000000 | 1.909000000 | 0.706652698 | SLICE_X59Y20 | SLICE_X68Y26 |  |  | SIGNATURE_SKIPPED|FDCE|FDCE | SIGNATURE_SKIPPED|FDCE|FDCE | DUT_INTERNAL | u_dut/kernel_vector_q_reg_rep__1 | u_dut/kernel_vector_q_reg_rep__0 | 0.031000000
u_dut/kernel_vector_q_reg[1]_rep/CE | u_dut/kernel_vector_q_reg[0]/C | -0.017000000 | clk | clk | clk | u_dut/kernel_vector_q_reg[0] | FDCE | u_dut/kernel_vector_q_reg | u_dut/kernel_vector_q_reg[1]_rep | FDCE | u_dut/kernel_vector_q_reg_rep | 5 | 0.552000000 | 1.263000000 | 1.815000000 | 0.695867769 | SLICE_X59Y21 | SLICE_X69Y16 |  |  | SIGNATURE_SKIPPED|FDCE|FDCE | SIGNATURE_SKIPPED|FDCE|FDCE | DUT_INTERNAL | u_dut/kernel_vector_q_reg | u_dut/kernel_vector_q_reg_rep | 0.017000000
u_dut/kernel_vector_q_reg[1]_rep__1_replica_4/D | u_dut/kernel_vector_q_reg[1]_rep__1/C | -0.007000000 | clk | clk | clk | u_dut/kernel_vector_q_reg[1]_rep__1 | FDCE | u_dut/kernel_vector_q_reg_rep__1 | u_dut/kernel_vector_q_reg[1]_rep__1_replica_4 | FDCE | u_dut/kernel_vector_q_reg_rep__1_replica_4 | 5 | 0.540000000 | 1.344000000 | 1.884000000 | 0.713375796 | SLICE_X59Y20 | SLICE_X60Y20 |  |  | SIGNATURE_SKIPPED|FDCE|FDCE | SIGNATURE_SKIPPED|FDCE|FDCE | DUT_INTERNAL | u_dut/kernel_vector_q_reg_rep__1 | u_dut/kernel_vector_q_reg_rep__1_replica_4 | 0.007000000
u_dut/kernel_vector_q_reg[1]_rep__1_replica_5/D | u_dut/kernel_vector_q_reg[1]_rep__1/C | -0.010000000 | clk | clk | clk | u_dut/kernel_vector_q_reg[1]_rep__1 | FDCE | u_dut/kernel_vector_q_reg_rep__1 | u_dut/kernel_vector_q_reg[1]_rep__1_replica_5 | FDCE | u_dut/kernel_vector_q_reg_rep__1_replica_5 | 5 | 0.540000000 | 1.344000000 | 1.884000000 | 0.713375796 | SLICE_X59Y20 | SLICE_X60Y21 |  |  | SIGNATURE_SKIPPED|FDCE|FDCE | SIGNATURE_SKIPPED|FDCE|FDCE | DUT_INTERNAL | u_dut/kernel_vector_q_reg_rep__1 | u_dut/kernel_vector_q_reg_rep__1_replica_5 | 0.010000000
u_dut/kernel_vector_q_reg[1]_rep__1_replica_6/D | u_dut/kernel_vector_q_reg[1]_rep__1/C | -0.011000000 | clk | clk | clk | u_dut/kernel_vector_q_reg[1]_rep__1 | FDCE | u_dut/kernel_vector_q_reg_rep__1 | u_dut/kernel_vector_q_reg[1]_rep__1_replica_6 | FDCE | u_dut/kernel_vector_q_reg_rep__1_replica_6 | 5 | 0.540000000 | 1.345000000 | 1.885000000 | 0.713527851 | SLICE_X59Y20 | SLICE_X60Y21 |  |  | SIGNATURE_SKIPPED|FDCE|FDCE | SIGNATURE_SKIPPED|FDCE|FDCE | DUT_INTERNAL | u_dut/kernel_vector_q_reg_rep__1 | u_dut/kernel_vector_q_reg_rep__1_replica_6 | 0.011000000
u_dut/kernel_vector_q_reg[1]_rep__1_replica_7/D | u_dut/kernel_vector_q_reg[1]_rep__1/C | -0.006000000 | clk | clk | clk | u_dut/kernel_vector_q_reg[1]_rep__1 | FDCE | u_dut/kernel_vector_q_reg_rep__1 | u_dut/kernel_vector_q_reg[1]_rep__1_replica_7 | FDCE | u_dut/kernel_vector_q_reg_rep__1_replica_7 | 5 | 0.540000000 | 1.387000000 | 1.927000000 | 0.719771666 | SLICE_X59Y20 | SLICE_X60Y21 |  |  | SIGNATURE_SKIPPED|FDCE|FDCE | SIGNATURE_SKIPPED|FDCE|FDCE | DUT_INTERNAL | u_dut/kernel_vector_q_reg_rep__1 | u_dut/kernel_vector_q_reg_rep__1_replica_7 | 0.006000000
u_dut/kernel_vector_q_reg[5]/D | u_dut/kernel_vector_q_reg[1]_rep__1/C | -0.025000000 | clk | clk | clk | u_dut/kernel_vector_q_reg[1]_rep__1 | FDCE | u_dut/kernel_vector_q_reg_rep__1 | u_dut/kernel_vector_q_reg[5] | FDCE | u_dut/kernel_vector_q_reg | 5 | 0.578000000 | 1.321000000 | 1.899000000 | 0.695629279 | SLICE_X59Y20 | SLICE_X68Y25 |  |  | SIGNATURE_SKIPPED|FDCE|FDCE | SIGNATURE_SKIPPED|FDCE|FDCE | DUT_INTERNAL | u_dut/kernel_vector_q_reg_rep__1 | u_dut/kernel_vector_q_reg | 0.025000000
u_dut/lfnst_gather_index_q_reg[0]/CE | u_dut/kernel_phase_q_reg[0]/C | -0.009000000 | clk | clk | clk | u_dut/kernel_phase_q_reg[0] | FDCE | u_dut/kernel_phase_q_reg | u_dut/lfnst_gather_index_q_reg[0] | FDCE | u_dut/lfnst_gather_index_q_reg | 5 | 0.533000000 | 1.258000000 | 1.791000000 | 0.702400893 | SLICE_X64Y35 | SLICE_X76Y24 |  |  | SIGNATURE_SKIPPED|FDCE|FDCE | SIGNATURE_SKIPPED|FDCE|FDCE | DUT_INTERNAL | u_dut/kernel_phase_q_reg | u_dut/lfnst_gather_index_q_reg | 0.009000000
u_dut/lfnst_grid_reg[50][13]/CE | u_dut/lfnst_run_q_reg/C | -0.011000000 | clk | clk | clk | u_dut/lfnst_run_q_reg | FDCE | u_dut/lfnst_run_q_reg | u_dut/lfnst_grid_reg[50][13] | FDCE | u_dut/lfnst_grid_reg | 5 | 0.349000000 | 1.466000000 | 1.815000000 | 0.807713499 | SLICE_X64Y22 | SLICE_X69Y13 |  |  | SIGNATURE_SKIPPED|FDCE|FDCE | SIGNATURE_SKIPPED|FDCE|FDCE | DUT_INTERNAL | u_dut/lfnst_run_q_reg | u_dut/lfnst_grid_reg | 0.011000000
u_dut/lfnst_grid_reg[50][6]/CE | u_dut/lfnst_run_q_reg/C | -0.011000000 | clk | clk | clk | u_dut/lfnst_run_q_reg | FDCE | u_dut/lfnst_run_q_reg | u_dut/lfnst_grid_reg[50][6] | FDCE | u_dut/lfnst_grid_reg | 5 | 0.349000000 | 1.466000000 | 1.815000000 | 0.807713499 | SLICE_X64Y22 | SLICE_X69Y13 |  |  | SIGNATURE_SKIPPED|FDCE|FDCE | SIGNATURE_SKIPPED|FDCE|FDCE | DUT_INTERNAL | u_dut/lfnst_run_q_reg | u_dut/lfnst_grid_reg | 0.011000000
u_dut/lfnst_grid_reg[51][6]/CE | u_dut/lfnst_run_q_reg/C | -0.011000000 | clk | clk | clk | u_dut/lfnst_run_q_reg | FDCE | u_dut/lfnst_run_q_reg | u_dut/lfnst_grid_reg[51][6] | FDCE | u_dut/lfnst_grid_reg | 5 | 0.349000000 | 1.466000000 | 1.815000000 | 0.807713499 | SLICE_X64Y22 | SLICE_X69Y13 |  |  | SIGNATURE_SKIPPED|FDCE|FDCE | SIGNATURE_SKIPPED|FDCE|FDCE | DUT_INTERNAL | u_dut/lfnst_run_q_reg | u_dut/lfnst_grid_reg | 0.011000000
u_dut/lfnst_input_terms_q_reg[224]/CE | u_dut/slot_state_reg[0][2]/C | -0.013000000 | clk | clk | clk | u_dut/slot_state_reg[0][2] | FDCE | u_dut/slot_state_reg | u_dut/lfnst_input_terms_q_reg[224] | FDCE | u_dut/lfnst_input_terms_q_reg | 3 | 0.387000000 | 1.517000000 | 1.904000000 | 0.796743697 | SLICE_X65Y24 | SLICE_X51Y11 |  |  | SIGNATURE_SKIPPED|FDCE|FDCE | SIGNATURE_SKIPPED|FDCE|FDCE | DUT_INTERNAL | u_dut/slot_state_reg | u_dut/lfnst_input_terms_q_reg | 0.013000000
u_dut/lfnst_input_terms_q_reg[230]/CE | u_dut/slot_state_reg[0][2]/C | -0.013000000 | clk | clk | clk | u_dut/slot_state_reg[0][2] | FDCE | u_dut/slot_state_reg | u_dut/lfnst_input_terms_q_reg[230] | FDCE | u_dut/lfnst_input_terms_q_reg | 3 | 0.387000000 | 1.517000000 | 1.904000000 | 0.796743697 | SLICE_X65Y24 | SLICE_X51Y11 |  |  | SIGNATURE_SKIPPED|FDCE|FDCE | SIGNATURE_SKIPPED|FDCE|FDCE | DUT_INTERNAL | u_dut/slot_state_reg | u_dut/lfnst_input_terms_q_reg | 0.013000000
u_dut/lfnst_input_terms_q_reg[235]/CE | u_dut/slot_state_reg[0][2]/C | -0.013000000 | clk | clk | clk | u_dut/slot_state_reg[0][2] | FDCE | u_dut/slot_state_reg | u_dut/lfnst_input_terms_q_reg[235] | FDCE | u_dut/lfnst_input_terms_q_reg | 3 | 0.387000000 | 1.517000000 | 1.904000000 | 0.796743697 | SLICE_X65Y24 | SLICE_X51Y11 |  |  | SIGNATURE_SKIPPED|FDCE|FDCE | SIGNATURE_SKIPPED|FDCE|FDCE | DUT_INTERNAL | u_dut/slot_state_reg | u_dut/lfnst_input_terms_q_reg | 0.013000000
u_dut/lfnst_input_terms_q_reg[237]/CE | u_dut/slot_state_reg[0][2]/C | -0.013000000 | clk | clk | clk | u_dut/slot_state_reg[0][2] | FDCE | u_dut/slot_state_reg | u_dut/lfnst_input_terms_q_reg[237] | FDCE | u_dut/lfnst_input_terms_q_reg | 3 | 0.387000000 | 1.517000000 | 1.904000000 | 0.796743697 | SLICE_X65Y24 | SLICE_X51Y11 |  |  | SIGNATURE_SKIPPED|FDCE|FDCE | SIGNATURE_SKIPPED|FDCE|FDCE | DUT_INTERNAL | u_dut/slot_state_reg | u_dut/lfnst_input_terms_q_reg | 0.013000000
u_dut/lfnst_mem_resp_data_q_reg[13]/D | u_dut/rd_cmd_addr_q_reg[1][0][1]_replica_1/C | -0.004000000 | clk | clk | clk | u_dut/rd_cmd_addr_q_reg[1][0][1]_replica_1 | FDCE | u_dut/rd_cmd_addr_q_reg_replica_1 | u_dut/lfnst_mem_resp_data_q_reg[13] | FDCE | u_dut/lfnst_mem_resp_data_q_reg | 6 | 0.544000000 | 1.406000000 | 1.950000000 | 0.721025641 | SLICE_X78Y21 | SLICE_X77Y13 |  |  | SIGNATURE_SKIPPED|FDCE|FDCE | SIGNATURE_SKIPPED|FDCE|FDCE | DUT_INTERNAL | u_dut/rd_cmd_addr_q_reg_replica_1 | u_dut/lfnst_mem_resp_data_q_reg | 0.004000000
u_dut/lfnst_mem_resp_data_q_reg[14]/D | u_dut/rd_cmd_addr_q_reg[1][3][4]/C | -0.034000000 | clk | clk | clk | u_dut/rd_cmd_addr_q_reg[1][3][4] | FDCE | u_dut/rd_cmd_addr_q_reg | u_dut/lfnst_mem_resp_data_q_reg[14] | FDCE | u_dut/lfnst_mem_resp_data_q_reg | 6 | 0.417000000 | 1.485000000 | 1.902000000 | 0.780757098 | SLICE_X72Y7 | SLICE_X78Y18 |  |  | SIGNATURE_SKIPPED|FDCE|FDCE | SIGNATURE_SKIPPED|FDCE|FDCE | DUT_INTERNAL | u_dut/rd_cmd_addr_q_reg | u_dut/lfnst_mem_resp_data_q_reg | 0.034000000
u_dut/lfnst_mem_resp_data_q_reg[2]/D | u_dut/rd_cmd_addr_q_reg[0][0][3]_replica/C | -0.036000000 | clk | clk | clk | u_dut/rd_cmd_addr_q_reg[0][0][3]_replica | FDCE | u_dut/rd_cmd_addr_q_reg_replica | u_dut/lfnst_mem_resp_data_q_reg[2] | FDCE | u_dut/lfnst_mem_resp_data_q_reg | 6 | 0.606000000 | 1.302000000 | 1.908000000 | 0.682389937 | SLICE_X58Y19 | SLICE_X77Y14 |  |  | SIGNATURE_SKIPPED|FDCE|FDCE | SIGNATURE_SKIPPED|FDCE|FDCE | DUT_INTERNAL | u_dut/rd_cmd_addr_q_reg_replica | u_dut/lfnst_mem_resp_data_q_reg | 0.036000000
u_dut/lfnst_mem_resp_data_q_reg[6]/D | u_dut/rd_cmd_addr_q_reg[1][0][1]_replica_4/C | -0.021000000 | clk | clk | clk | u_dut/rd_cmd_addr_q_reg[1][0][1]_replica_4 | FDCE | u_dut/rd_cmd_addr_q_reg_replica_4 | u_dut/lfnst_mem_resp_data_q_reg[6] | FDCE | u_dut/lfnst_mem_resp_data_q_reg | 6 | 0.567000000 | 1.353000000 | 1.920000000 | 0.704687500 | SLICE_X66Y19 | SLICE_X70Y10 |  |  | SIGNATURE_SKIPPED|FDCE|FDCE | SIGNATURE_SKIPPED|FDCE|FDCE | DUT_INTERNAL | u_dut/rd_cmd_addr_q_reg_replica_4 | u_dut/lfnst_mem_resp_data_q_reg | 0.021000000
u_dut/lfnst_mem_resp_data_q_reg[9]/D | u_dut/rd_cmd_addr_q_reg[1][0][1]_replica_1/C | -0.030000000 | clk | clk | clk | u_dut/rd_cmd_addr_q_reg[1][0][1]_replica_1 | FDCE | u_dut/rd_cmd_addr_q_reg_replica_1 | u_dut/lfnst_mem_resp_data_q_reg[9] | FDCE | u_dut/lfnst_mem_resp_data_q_reg | 6 | 0.546000000 | 1.408000000 | 1.954000000 | 0.720573183 | SLICE_X78Y21 | SLICE_X72Y12 |  |  | SIGNATURE_SKIPPED|FDCE|FDCE | SIGNATURE_SKIPPED|FDCE|FDCE | DUT_INTERNAL | u_dut/rd_cmd_addr_q_reg_replica_1 | u_dut/lfnst_mem_resp_data_q_reg | 0.030000000
u_dut/rd_cmd_addr_q_reg[0][0][0]/CE | u_dut/kernel_phase_q_reg[0]/C | -0.031000000 | clk | clk | clk | u_dut/kernel_phase_q_reg[0] | FDCE | u_dut/kernel_phase_q_reg | u_dut/rd_cmd_addr_q_reg[0][0][0] | FDCE | u_dut/rd_cmd_addr_q_reg | 4 | 0.483000000 | 1.331000000 | 1.814000000 | 0.733737596 | SLICE_X64Y35 | SLICE_X78Y8 |  |  | SIGNATURE_SKIPPED|FDCE|FDCE | SIGNATURE_SKIPPED|FDCE|FDCE | DUT_INTERNAL | u_dut/kernel_phase_q_reg | u_dut/rd_cmd_addr_q_reg | 0.031000000
u_dut/rd_cmd_addr_q_reg[0][0][1]_replica_1/CE | u_dut/kernel_phase_q_reg[0]/C | -0.003000000 | clk | clk | clk | u_dut/kernel_phase_q_reg[0] | FDCE | u_dut/kernel_phase_q_reg | u_dut/rd_cmd_addr_q_reg[0][0][1]_replica_1 | FDCE | u_dut/rd_cmd_addr_q_reg_replica_1 | 4 | 0.483000000 | 1.314000000 | 1.797000000 | 0.731218698 | SLICE_X64Y35 | SLICE_X79Y11 |  |  | SIGNATURE_SKIPPED|FDCE|FDCE | SIGNATURE_SKIPPED|FDCE|FDCE | DUT_INTERNAL | u_dut/kernel_phase_q_reg | u_dut/rd_cmd_addr_q_reg_replica_1 | 0.003000000
u_dut/rd_cmd_addr_q_reg[0][0][2]_replica_3/CE | u_dut/kernel_phase_q_reg[0]/C | -0.031000000 | clk | clk | clk | u_dut/kernel_phase_q_reg[0] | FDCE | u_dut/kernel_phase_q_reg | u_dut/rd_cmd_addr_q_reg[0][0][2]_replica_3 | FDCE | u_dut/rd_cmd_addr_q_reg_replica_3 | 4 | 0.483000000 | 1.331000000 | 1.814000000 | 0.733737596 | SLICE_X64Y35 | SLICE_X78Y8 |  |  | SIGNATURE_SKIPPED|FDCE|FDCE | SIGNATURE_SKIPPED|FDCE|FDCE | DUT_INTERNAL | u_dut/kernel_phase_q_reg | u_dut/rd_cmd_addr_q_reg_replica_3 | 0.031000000
u_dut/rd_cmd_addr_q_reg[0][0][3]_replica_4/CE | u_dut/kernel_phase_q_reg[0]/C | -0.013000000 | clk | clk | clk | u_dut/kernel_phase_q_reg[0] | FDCE | u_dut/kernel_phase_q_reg | u_dut/rd_cmd_addr_q_reg[0][0][3]_replica_4 | FDCE | u_dut/rd_cmd_addr_q_reg_replica_4 | 4 | 0.483000000 | 1.314000000 | 1.797000000 | 0.731218698 | SLICE_X64Y35 | SLICE_X77Y16 |  |  | SIGNATURE_SKIPPED|FDCE|FDCE | SIGNATURE_SKIPPED|FDCE|FDCE | DUT_INTERNAL | u_dut/kernel_phase_q_reg | u_dut/rd_cmd_addr_q_reg_replica_4 | 0.013000000
u_dut/rd_cmd_addr_q_reg[1][0][0]_replica_5/CE | u_dut/kernel_phase_q_reg[0]/C | -0.003000000 | clk | clk | clk | u_dut/kernel_phase_q_reg[0] | FDCE | u_dut/kernel_phase_q_reg | u_dut/rd_cmd_addr_q_reg[1][0][0]_replica_5 | FDCE | u_dut/rd_cmd_addr_q_reg_replica_5 | 4 | 0.483000000 | 1.301000000 | 1.784000000 | 0.729260090 | SLICE_X64Y35 | SLICE_X79Y21 |  |  | SIGNATURE_SKIPPED|FDCE|FDCE | SIGNATURE_SKIPPED|FDCE|FDCE | DUT_INTERNAL | u_dut/kernel_phase_q_reg | u_dut/rd_cmd_addr_q_reg_replica_5 | 0.003000000
u_dut/slot_state_reg[0][2]/D | u_dut/output_index_reg[0]_replica/C | -0.005000000 | clk | clk | clk | u_dut/output_index_reg[0]_replica | FDCE | u_dut/output_index_reg_replica | u_dut/slot_state_reg[0][2] | FDCE | u_dut/slot_state_reg | 4 | 0.465000000 | 1.421000000 | 1.886000000 | 0.753446448 | SLICE_X64Y46 | SLICE_X65Y24 |  |  | SIGNATURE_SKIPPED|FDCE|FDCE | SIGNATURE_SKIPPED|FDCE|FDCE | DUT_INTERNAL | u_dut/output_index_reg_replica | u_dut/slot_state_reg | 0.005000000
u_dut/u_bounded_lfnst_engine/out_data_reg[10]/D | u_dut/u_bounded_lfnst_engine/reduce_l5_q_reg[0][6]/C | -0.027000000 | clk | clk | clk | u_dut/u_bounded_lfnst_engine/reduce_l5_q_reg[0][6] | FDCE | u_dut/u_bounded_lfnst_engine/reduce_l5_q_reg | u_dut/u_bounded_lfnst_engine/out_data_reg[10] | FDCE | u_dut/u_bounded_lfnst_engine/out_data_reg | 9 | 0.953000000 | 0.947000000 | 1.900000000 | 0.498421053 | SLICE_X64Y1 | SLICE_X68Y2 |  |  | SIGNATURE_SKIPPED|FDCE|FDCE | SIGNATURE_SKIPPED|FDCE|FDCE | DUT_INTERNAL | u_dut/u_bounded_lfnst_engine/reduce_l5_q_reg | u_dut/u_bounded_lfnst_engine/out_data_reg | 0.027000000
u_dut/u_bounded_lfnst_engine/out_data_reg[9]/D | u_dut/u_bounded_lfnst_engine/reduce_l5_q_reg[0][6]/C | -0.039000000 | clk | clk | clk | u_dut/u_bounded_lfnst_engine/reduce_l5_q_reg[0][6] | FDCE | u_dut/u_bounded_lfnst_engine/reduce_l5_q_reg | u_dut/u_bounded_lfnst_engine/out_data_reg[9] | FDCE | u_dut/u_bounded_lfnst_engine/out_data_reg | 9 | 0.913000000 | 1.013000000 | 1.926000000 | 0.525960540 | SLICE_X64Y1 | SLICE_X57Y0 |  |  | SIGNATURE_SKIPPED|FDCE|FDCE | SIGNATURE_SKIPPED|FDCE|FDCE | DUT_INTERNAL | u_dut/u_bounded_lfnst_engine/reduce_l5_q_reg | u_dut/u_bounded_lfnst_engine/out_data_reg | 0.039000000
u_dut/u_unified_p4_kernel/ingress_data_q_reg[0]/D | u_dut/lfnst_grid_reg[29][0]/C | -0.010000000 | clk | clk | clk | u_dut/lfnst_grid_reg[29][0] | FDCE | u_dut/lfnst_grid_reg | u_dut/u_unified_p4_kernel/ingress_data_q_reg[0] | FDRE | u_dut/u_unified_p4_kernel/ingress_data_q_reg | 5 | 0.583000000 | 1.252000000 | 1.835000000 | 0.682288828 | SLICE_X52Y16 | SLICE_X70Y32 |  |  | SIGNATURE_SKIPPED|FDCE|FDRE | SIGNATURE_SKIPPED|FDCE|FDRE | DUT_INTERNAL | u_dut/lfnst_grid_reg | u_dut/u_unified_p4_kernel/ingress_data_q_reg | 0.010000000
u_dut/u_unified_p4_kernel/ingress_data_q_reg[11]/D | u_dut/lfnst_grid_valid_reg[22]/C | -0.038000000 | clk | clk | clk | u_dut/lfnst_grid_valid_reg[22] | FDCE | u_dut/lfnst_grid_valid_reg | u_dut/u_unified_p4_kernel/ingress_data_q_reg[11] | FDRE | u_dut/u_unified_p4_kernel/ingress_data_q_reg | 5 | 0.610000000 | 1.305000000 | 1.915000000 | 0.681462141 | SLICE_X58Y24 | SLICE_X70Y25 |  |  | SIGNATURE_SKIPPED|FDCE|FDRE | SIGNATURE_SKIPPED|FDCE|FDRE | DUT_INTERNAL | u_dut/lfnst_grid_valid_reg | u_dut/u_unified_p4_kernel/ingress_data_q_reg | 0.038000000
u_dut/u_unified_p4_kernel/ingress_data_q_reg[12]/D | u_dut/lfnst_grid_valid_reg[22]/C | -0.008000000 | clk | clk | clk | u_dut/lfnst_grid_valid_reg[22] | FDCE | u_dut/lfnst_grid_valid_reg | u_dut/u_unified_p4_kernel/ingress_data_q_reg[12] | FDRE | u_dut/u_unified_p4_kernel/ingress_data_q_reg | 5 | 0.610000000 | 1.255000000 | 1.865000000 | 0.672922252 | SLICE_X58Y24 | SLICE_X70Y29 |  |  | SIGNATURE_SKIPPED|FDCE|FDRE | SIGNATURE_SKIPPED|FDCE|FDRE | DUT_INTERNAL | u_dut/lfnst_grid_valid_reg | u_dut/u_unified_p4_kernel/ingress_data_q_reg | 0.008000000
u_dut/u_unified_p4_kernel/ingress_data_q_reg[14]/D | u_dut/lfnst_grid_valid_reg[22]/C | -0.012000000 | clk | clk | clk | u_dut/lfnst_grid_valid_reg[22] | FDCE | u_dut/lfnst_grid_valid_reg | u_dut/u_unified_p4_kernel/ingress_data_q_reg[14] | FDRE | u_dut/u_unified_p4_kernel/ingress_data_q_reg | 5 | 0.585000000 | 1.300000000 | 1.885000000 | 0.689655172 | SLICE_X58Y24 | SLICE_X70Y36 |  |  | SIGNATURE_SKIPPED|FDCE|FDRE | SIGNATURE_SKIPPED|FDCE|FDRE | DUT_INTERNAL | u_dut/lfnst_grid_valid_reg | u_dut/u_unified_p4_kernel/ingress_data_q_reg | 0.012000000
u_dut/u_unified_p4_kernel/ingress_data_q_reg[15]/D | u_dut/lfnst_grid_reg[0][15]/C | -0.035000000 | clk | clk | clk | u_dut/lfnst_grid_reg[0][15] | FDCE | u_dut/lfnst_grid_reg | u_dut/u_unified_p4_kernel/ingress_data_q_reg[15] | FDRE | u_dut/u_unified_p4_kernel/ingress_data_q_reg | 5 | 0.428000000 | 1.401000000 | 1.829000000 | 0.765992346 | SLICE_X47Y10 | SLICE_X72Y34 |  |  | SIGNATURE_SKIPPED|FDCE|FDRE | SIGNATURE_SKIPPED|FDCE|FDRE | DUT_INTERNAL | u_dut/lfnst_grid_reg | u_dut/u_unified_p4_kernel/ingress_data_q_reg | 0.035000000
u_dut/u_unified_p4_kernel/ingress_data_q_reg[16]/D | u_dut/lfnst_grid_valid_reg[22]/C | -0.018000000 | clk | clk | clk | u_dut/lfnst_grid_valid_reg[22] | FDCE | u_dut/lfnst_grid_valid_reg | u_dut/u_unified_p4_kernel/ingress_data_q_reg[16] | FDRE | u_dut/u_unified_p4_kernel/ingress_data_q_reg | 5 | 0.492000000 | 1.400000000 | 1.892000000 | 0.739957717 | SLICE_X58Y24 | SLICE_X69Y35 |  |  | SIGNATURE_SKIPPED|FDCE|FDRE | SIGNATURE_SKIPPED|FDCE|FDRE | DUT_INTERNAL | u_dut/lfnst_grid_valid_reg | u_dut/u_unified_p4_kernel/ingress_data_q_reg | 0.018000000
u_dut/u_unified_p4_kernel/ingress_data_q_reg[18]/D | u_dut/kernel_h_rd_raw_group_q_reg[1]/C | -0.044000000 | clk | clk | clk | u_dut/kernel_h_rd_raw_group_q_reg[1] | FDCE | u_dut/kernel_h_rd_raw_group_q_reg | u_dut/u_unified_p4_kernel/ingress_data_q_reg[18] | FDRE | u_dut/u_unified_p4_kernel/ingress_data_q_reg | 4 | 0.481000000 | 1.432000000 | 1.913000000 | 0.748562467 | SLICE_X56Y33 | SLICE_X60Y32 |  |  | SIGNATURE_SKIPPED|FDCE|FDRE | SIGNATURE_SKIPPED|FDCE|FDRE | DUT_INTERNAL | u_dut/kernel_h_rd_raw_group_q_reg | u_dut/u_unified_p4_kernel/ingress_data_q_reg | 0.044000000
u_dut/u_unified_p4_kernel/ingress_data_q_reg[19]/D | u_dut/lfnst_grid_reg[28][3]/C | -0.039000000 | clk | clk | clk | u_dut/lfnst_grid_reg[28][3] | FDCE | u_dut/lfnst_grid_reg | u_dut/u_unified_p4_kernel/ingress_data_q_reg[19] | FDRE | u_dut/u_unified_p4_kernel/ingress_data_q_reg | 5 | 0.597000000 | 1.235000000 | 1.832000000 | 0.674126638 | SLICE_X50Y13 | SLICE_X63Y27 |  |  | SIGNATURE_SKIPPED|FDCE|FDRE | SIGNATURE_SKIPPED|FDCE|FDRE | DUT_INTERNAL | u_dut/lfnst_grid_reg | u_dut/u_unified_p4_kernel/ingress_data_q_reg | 0.039000000
u_dut/u_unified_p4_kernel/ingress_data_q_reg[1]/D | u_dut/lfnst_grid_reg[0][1]/C | -0.034000000 | clk | clk | clk | u_dut/lfnst_grid_reg[0][1] | FDCE | u_dut/lfnst_grid_reg | u_dut/u_unified_p4_kernel/ingress_data_q_reg[1] | FDRE | u_dut/u_unified_p4_kernel/ingress_data_q_reg | 5 | 0.590000000 | 1.186000000 | 1.776000000 | 0.667792793 | SLICE_X47Y11 | SLICE_X70Y29 |  |  | SIGNATURE_SKIPPED|FDCE|FDRE | SIGNATURE_SKIPPED|FDCE|FDRE | DUT_INTERNAL | u_dut/lfnst_grid_reg | u_dut/u_unified_p4_kernel/ingress_data_q_reg | 0.034000000
u_dut/u_unified_p4_kernel/ingress_data_q_reg[21]/D | u_dut/kernel_h_rd_raw_group_q_reg[1]/C | -0.030000000 | clk | clk | clk | u_dut/kernel_h_rd_raw_group_q_reg[1] | FDCE | u_dut/kernel_h_rd_raw_group_q_reg | u_dut/u_unified_p4_kernel/ingress_data_q_reg[21] | FDRE | u_dut/u_unified_p4_kernel/ingress_data_q_reg | 4 | 0.481000000 | 1.470000000 | 1.951000000 | 0.753459764 | SLICE_X56Y33 | SLICE_X59Y32 |  |  | SIGNATURE_SKIPPED|FDCE|FDRE | SIGNATURE_SKIPPED|FDCE|FDRE | DUT_INTERNAL | u_dut/kernel_h_rd_raw_group_q_reg | u_dut/u_unified_p4_kernel/ingress_data_q_reg | 0.030000000
u_dut/u_unified_p4_kernel/ingress_data_q_reg[23]/D | u_dut/kernel_vector_q_reg[1]_rep__0/C | -0.037000000 | clk | clk | clk | u_dut/kernel_vector_q_reg[1]_rep__0 | FDCE | u_dut/kernel_vector_q_reg_rep__0 | u_dut/u_unified_p4_kernel/ingress_data_q_reg[23] | FDRE | u_dut/u_unified_p4_kernel/ingress_data_q_reg | 5 | 0.476000000 | 1.421000000 | 1.897000000 | 0.749077491 | SLICE_X64Y18 | SLICE_X69Y33 |  |  | SIGNATURE_SKIPPED|FDCE|FDRE | SIGNATURE_SKIPPED|FDCE|FDRE | DUT_INTERNAL | u_dut/kernel_vector_q_reg_rep__0 | u_dut/u_unified_p4_kernel/ingress_data_q_reg | 0.037000000
u_dut/u_unified_p4_kernel/ingress_data_q_reg[25]/D | u_dut/lfnst_grid_reg[4][9]/C | -0.012000000 | clk | clk | clk | u_dut/lfnst_grid_reg[4][9] | FDCE | u_dut/lfnst_grid_reg | u_dut/u_unified_p4_kernel/ingress_data_q_reg[25] | FDRE | u_dut/u_unified_p4_kernel/ingress_data_q_reg | 5 | 0.511000000 | 1.314000000 | 1.825000000 | 0.720000000 | SLICE_X50Y14 | SLICE_X69Y34 |  |  | SIGNATURE_SKIPPED|FDCE|FDRE | SIGNATURE_SKIPPED|FDCE|FDRE | DUT_INTERNAL | u_dut/lfnst_grid_reg | u_dut/u_unified_p4_kernel/ingress_data_q_reg | 0.012000000
u_dut/u_unified_p4_kernel/ingress_data_q_reg[27]/D | u_dut/lfnst_grid_reg[27][11]/C | -0.024000000 | clk | clk | clk | u_dut/lfnst_grid_reg[27][11] | FDCE | u_dut/lfnst_grid_reg | u_dut/u_unified_p4_kernel/ingress_data_q_reg[27] | FDRE | u_dut/u_unified_p4_kernel/ingress_data_q_reg | 5 | 0.429000000 | 1.449000000 | 1.878000000 | 0.771565495 | SLICE_X56Y20 | SLICE_X60Y32 |  |  | SIGNATURE_SKIPPED|FDCE|FDRE | SIGNATURE_SKIPPED|FDCE|FDRE | DUT_INTERNAL | u_dut/lfnst_grid_reg | u_dut/u_unified_p4_kernel/ingress_data_q_reg | 0.024000000
u_dut/u_unified_p4_kernel/ingress_data_q_reg[28]/D | u_dut/lfnst_grid_reg[19][12]/C | -0.030000000 | clk | clk | clk | u_dut/lfnst_grid_reg[19][12] | FDCE | u_dut/lfnst_grid_reg | u_dut/u_unified_p4_kernel/ingress_data_q_reg[28] | FDRE | u_dut/u_unified_p4_kernel/ingress_data_q_reg | 5 | 0.434000000 | 1.395000000 | 1.829000000 | 0.762711864 | SLICE_X51Y24 | SLICE_X68Y35 |  |  | SIGNATURE_SKIPPED|FDCE|FDRE | SIGNATURE_SKIPPED|FDCE|FDRE | DUT_INTERNAL | u_dut/lfnst_grid_reg | u_dut/u_unified_p4_kernel/ingress_data_q_reg | 0.030000000
u_dut/u_unified_p4_kernel/ingress_data_q_reg[33]/D | u_dut/lfnst_grid_reg[0][1]/C | -0.021000000 | clk | clk | clk | u_dut/lfnst_grid_reg[0][1] | FDCE | u_dut/lfnst_grid_reg | u_dut/u_unified_p4_kernel/ingress_data_q_reg[33] | FDRE | u_dut/u_unified_p4_kernel/ingress_data_q_reg | 5 | 0.679000000 | 1.113000000 | 1.792000000 | 0.621093750 | SLICE_X47Y11 | SLICE_X59Y26 |  |  | SIGNATURE_SKIPPED|FDCE|FDRE | SIGNATURE_SKIPPED|FDCE|FDRE | DUT_INTERNAL | u_dut/lfnst_grid_reg | u_dut/u_unified_p4_kernel/ingress_data_q_reg | 0.021000000
u_dut/u_unified_p4_kernel/ingress_data_q_reg[34]/D | u_dut/kernel_h_rd_raw_group_q_reg[1]/C | -0.024000000 | clk | clk | clk | u_dut/kernel_h_rd_raw_group_q_reg[1] | FDCE | u_dut/kernel_h_rd_raw_group_q_reg | u_dut/u_unified_p4_kernel/ingress_data_q_reg[34] | FDRE | u_dut/u_unified_p4_kernel/ingress_data_q_reg | 4 | 0.456000000 | 1.491000000 | 1.947000000 | 0.765793529 | SLICE_X56Y33 | SLICE_X59Y32 |  |  | SIGNATURE_SKIPPED|FDCE|FDRE | SIGNATURE_SKIPPED|FDCE|FDRE | DUT_INTERNAL | u_dut/kernel_h_rd_raw_group_q_reg | u_dut/u_unified_p4_kernel/ingress_data_q_reg | 0.024000000
u_dut/u_unified_p4_kernel/ingress_data_q_reg[35]/D | u_dut/kernel_h_rd_raw_group_q_reg[1]/C | -0.027000000 | clk | clk | clk | u_dut/kernel_h_rd_raw_group_q_reg[1] | FDCE | u_dut/kernel_h_rd_raw_group_q_reg | u_dut/u_unified_p4_kernel/ingress_data_q_reg[35] | FDRE | u_dut/u_unified_p4_kernel/ingress_data_q_reg | 4 | 0.397000000 | 1.504000000 | 1.901000000 | 0.791162546 | SLICE_X56Y33 | SLICE_X60Y34 |  |  | SIGNATURE_SKIPPED|FDCE|FDRE | SIGNATURE_SKIPPED|FDCE|FDRE | DUT_INTERNAL | u_dut/kernel_h_rd_raw_group_q_reg | u_dut/u_unified_p4_kernel/ingress_data_q_reg | 0.027000000
u_dut/u_unified_p4_kernel/ingress_data_q_reg[36]/D | u_dut/lfnst_grid_reg[0][4]/C | -0.042000000 | clk | clk | clk | u_dut/lfnst_grid_reg[0][4] | FDCE | u_dut/lfnst_grid_reg | u_dut/u_unified_p4_kernel/ingress_data_q_reg[36] | FDRE | u_dut/u_unified_p4_kernel/ingress_data_q_reg | 5 | 0.513000000 | 1.293000000 | 1.806000000 | 0.715946844 | SLICE_X47Y11 | SLICE_X64Y27 |  |  | SIGNATURE_SKIPPED|FDCE|FDRE | SIGNATURE_SKIPPED|FDCE|FDRE | DUT_INTERNAL | u_dut/lfnst_grid_reg | u_dut/u_unified_p4_kernel/ingress_data_q_reg | 0.042000000
u_dut/u_unified_p4_kernel/ingress_data_q_reg[37]/D | u_dut/kernel_h_rd_raw_group_q_reg[1]/C | -0.018000000 | clk | clk | clk | u_dut/kernel_h_rd_raw_group_q_reg[1] | FDCE | u_dut/kernel_h_rd_raw_group_q_reg | u_dut/u_unified_p4_kernel/ingress_data_q_reg[37] | FDRE | u_dut/u_unified_p4_kernel/ingress_data_q_reg | 5 | 0.542000000 | 1.391000000 | 1.933000000 | 0.719606829 | SLICE_X56Y33 | SLICE_X60Y33 |  |  | SIGNATURE_SKIPPED|FDCE|FDRE | SIGNATURE_SKIPPED|FDCE|FDRE | DUT_INTERNAL | u_dut/kernel_h_rd_raw_group_q_reg | u_dut/u_unified_p4_kernel/ingress_data_q_reg | 0.018000000
u_dut/u_unified_p4_kernel/ingress_data_q_reg[38]/D | u_dut/kernel_h_rd_raw_group_q_reg[1]/C | -0.037000000 | clk | clk | clk | u_dut/kernel_h_rd_raw_group_q_reg[1] | FDCE | u_dut/kernel_h_rd_raw_group_q_reg | u_dut/u_unified_p4_kernel/ingress_data_q_reg[38] | FDRE | u_dut/u_unified_p4_kernel/ingress_data_q_reg | 5 | 0.561000000 | 1.343000000 | 1.904000000 | 0.705357143 | SLICE_X56Y33 | SLICE_X61Y32 |  |  | SIGNATURE_SKIPPED|FDCE|FDRE | SIGNATURE_SKIPPED|FDCE|FDRE | DUT_INTERNAL | u_dut/kernel_h_rd_raw_group_q_reg | u_dut/u_unified_p4_kernel/ingress_data_q_reg | 0.037000000
u_dut/u_unified_p4_kernel/ingress_data_q_reg[3]/D | u_dut/kernel_h_rd_raw_group_q_reg[3]/C | -0.006000000 | clk | clk | clk | u_dut/kernel_h_rd_raw_group_q_reg[3] | FDCE | u_dut/kernel_h_rd_raw_group_q_reg | u_dut/u_unified_p4_kernel/ingress_data_q_reg[3] | FDRE | u_dut/u_unified_p4_kernel/ingress_data_q_reg | 6 | 0.542000000 | 1.376000000 | 1.918000000 | 0.717413973 | SLICE_X66Y29 | SLICE_X68Y24 |  |  | SIGNATURE_SKIPPED|FDCE|FDRE | SIGNATURE_SKIPPED|FDCE|FDRE | DUT_INTERNAL | u_dut/kernel_h_rd_raw_group_q_reg | u_dut/u_unified_p4_kernel/ingress_data_q_reg | 0.006000000
u_dut/u_unified_p4_kernel/ingress_data_q_reg[40]/D | u_dut/kernel_vector_q_reg[0]/C | -0.040000000 | clk | clk | clk | u_dut/kernel_vector_q_reg[0] | FDCE | u_dut/kernel_vector_q_reg | u_dut/u_unified_p4_kernel/ingress_data_q_reg[40] | FDRE | u_dut/u_unified_p4_kernel/ingress_data_q_reg | 5 | 0.652000000 | 1.302000000 | 1.954000000 | 0.666325486 | SLICE_X59Y21 | SLICE_X62Y33 |  |  | SIGNATURE_SKIPPED|FDCE|FDRE | SIGNATURE_SKIPPED|FDCE|FDRE | DUT_INTERNAL | u_dut/kernel_vector_q_reg | u_dut/u_unified_p4_kernel/ingress_data_q_reg | 0.040000000
u_dut/u_unified_p4_kernel/ingress_data_q_reg[41]/D | u_dut/lfnst_grid_reg[19][9]/C | -0.035000000 | clk | clk | clk | u_dut/lfnst_grid_reg[19][9] | FDCE | u_dut/lfnst_grid_reg | u_dut/u_unified_p4_kernel/ingress_data_q_reg[41] | FDRE | u_dut/u_unified_p4_kernel/ingress_data_q_reg | 5 | 0.520000000 | 1.291000000 | 1.811000000 | 0.712865820 | SLICE_X51Y22 | SLICE_X68Y34 |  |  | SIGNATURE_SKIPPED|FDCE|FDRE | SIGNATURE_SKIPPED|FDCE|FDRE | DUT_INTERNAL | u_dut/lfnst_grid_reg | u_dut/u_unified_p4_kernel/ingress_data_q_reg | 0.035000000
u_dut/u_unified_p4_kernel/ingress_data_q_reg[42]/D | u_dut/kernel_vector_q_reg[1]_rep__1/C | -0.027000000 | clk | clk | clk | u_dut/kernel_vector_q_reg[1]_rep__1 | FDCE | u_dut/kernel_vector_q_reg_rep__1 | u_dut/u_unified_p4_kernel/ingress_data_q_reg[42] | FDRE | u_dut/u_unified_p4_kernel/ingress_data_q_reg | 5 | 0.502000000 | 1.386000000 | 1.888000000 | 0.734110169 | SLICE_X59Y20 | SLICE_X69Y34 |  |  | SIGNATURE_SKIPPED|FDCE|FDRE | SIGNATURE_SKIPPED|FDCE|FDRE | DUT_INTERNAL | u_dut/kernel_vector_q_reg_rep__1 | u_dut/u_unified_p4_kernel/ingress_data_q_reg | 0.027000000
u_dut/u_unified_p4_kernel/ingress_data_q_reg[43]/D | u_dut/lfnst_grid_reg[0][11]/C | -0.009000000 | clk | clk | clk | u_dut/lfnst_grid_reg[0][11] | FDCE | u_dut/lfnst_grid_reg | u_dut/u_unified_p4_kernel/ingress_data_q_reg[43] | FDRE | u_dut/u_unified_p4_kernel/ingress_data_q_reg | 5 | 0.432000000 | 1.340000000 | 1.772000000 | 0.756207675 | SLICE_X46Y11 | SLICE_X64Y28 |  |  | SIGNATURE_SKIPPED|FDCE|FDRE | SIGNATURE_SKIPPED|FDCE|FDRE | DUT_INTERNAL | u_dut/lfnst_grid_reg | u_dut/u_unified_p4_kernel/ingress_data_q_reg | 0.009000000
u_dut/u_unified_p4_kernel/ingress_data_q_reg[44]/D | u_dut/lfnst_grid_reg[27][12]/C | -0.026000000 | clk | clk | clk | u_dut/lfnst_grid_reg[27][12] | FDCE | u_dut/lfnst_grid_reg | u_dut/u_unified_p4_kernel/ingress_data_q_reg[44] | FDRE | u_dut/u_unified_p4_kernel/ingress_data_q_reg | 5 | 0.590000000 | 1.298000000 | 1.888000000 | 0.687500000 | SLICE_X56Y20 | SLICE_X68Y28 |  |  | SIGNATURE_SKIPPED|FDCE|FDRE | SIGNATURE_SKIPPED|FDCE|FDRE | DUT_INTERNAL | u_dut/lfnst_grid_reg | u_dut/u_unified_p4_kernel/ingress_data_q_reg | 0.026000000
u_dut/u_unified_p4_kernel/ingress_data_q_reg[45]/D | u_dut/kernel_h_rd_raw_group_q_reg[1]/C | -0.030000000 | clk | clk | clk | u_dut/kernel_h_rd_raw_group_q_reg[1] | FDCE | u_dut/kernel_h_rd_raw_group_q_reg | u_dut/u_unified_p4_kernel/ingress_data_q_reg[45] | FDRE | u_dut/u_unified_p4_kernel/ingress_data_q_reg | 5 | 0.595000000 | 1.297000000 | 1.892000000 | 0.685517970 | SLICE_X56Y33 | SLICE_X69Y31 |  |  | SIGNATURE_SKIPPED|FDCE|FDRE | SIGNATURE_SKIPPED|FDCE|FDRE | DUT_INTERNAL | u_dut/kernel_h_rd_raw_group_q_reg | u_dut/u_unified_p4_kernel/ingress_data_q_reg | 0.030000000
u_dut/u_unified_p4_kernel/ingress_data_q_reg[46]/D | u_dut/lfnst_grid_reg[25][14]/C | -0.030000000 | clk | clk | clk | u_dut/lfnst_grid_reg[25][14] | FDCE | u_dut/lfnst_grid_reg | u_dut/u_unified_p4_kernel/ingress_data_q_reg[46] | FDRE | u_dut/u_unified_p4_kernel/ingress_data_q_reg | 5 | 0.636000000 | 1.249000000 | 1.885000000 | 0.662599469 | SLICE_X58Y23 | SLICE_X70Y30 |  |  | SIGNATURE_SKIPPED|FDCE|FDRE | SIGNATURE_SKIPPED|FDCE|FDRE | DUT_INTERNAL | u_dut/lfnst_grid_reg | u_dut/u_unified_p4_kernel/ingress_data_q_reg | 0.030000000
u_dut/u_unified_p4_kernel/ingress_data_q_reg[48]/D | u_dut/lfnst_grid_reg[4][0]/C | -0.022000000 | clk | clk | clk | u_dut/lfnst_grid_reg[4][0] | FDCE | u_dut/lfnst_grid_reg | u_dut/u_unified_p4_kernel/ingress_data_q_reg[48] | FDRE | u_dut/u_unified_p4_kernel/ingress_data_q_reg | 5 | 0.474000000 | 1.344000000 | 1.818000000 | 0.739273927 | SLICE_X46Y22 | SLICE_X64Y28 |  |  | SIGNATURE_SKIPPED|FDCE|FDRE | SIGNATURE_SKIPPED|FDCE|FDRE | DUT_INTERNAL | u_dut/lfnst_grid_reg | u_dut/u_unified_p4_kernel/ingress_data_q_reg | 0.022000000
u_dut/u_unified_p4_kernel/ingress_data_q_reg[58]/D | u_dut/kernel_vector_q_reg[0]_rep/C | -0.011000000 | clk | clk | clk | u_dut/kernel_vector_q_reg[0]_rep | FDCE | u_dut/kernel_vector_q_reg_rep | u_dut/u_unified_p4_kernel/ingress_data_q_reg[58] | FDRE | u_dut/u_unified_p4_kernel/ingress_data_q_reg | 5 | 0.646000000 | 1.284000000 | 1.930000000 | 0.665284974 | SLICE_X64Y21 | SLICE_X67Y30 |  |  | SIGNATURE_SKIPPED|FDCE|FDRE | SIGNATURE_SKIPPED|FDCE|FDRE | DUT_INTERNAL | u_dut/kernel_vector_q_reg_rep | u_dut/u_unified_p4_kernel/ingress_data_q_reg | 0.011000000
u_dut/u_unified_p4_kernel/ingress_data_q_reg[59]/D | u_dut/lfnst_grid_reg[0][11]/C | -0.017000000 | clk | clk | clk | u_dut/lfnst_grid_reg[0][11] | FDCE | u_dut/lfnst_grid_reg | u_dut/u_unified_p4_kernel/ingress_data_q_reg[59] | FDRE | u_dut/u_unified_p4_kernel/ingress_data_q_reg | 5 | 0.507000000 | 1.311000000 | 1.818000000 | 0.721122112 | SLICE_X46Y11 | SLICE_X64Y29 |  |  | SIGNATURE_SKIPPED|FDCE|FDRE | SIGNATURE_SKIPPED|FDCE|FDRE | DUT_INTERNAL | u_dut/lfnst_grid_reg | u_dut/u_unified_p4_kernel/ingress_data_q_reg | 0.017000000
u_dut/u_unified_p4_kernel/ingress_data_q_reg[5]/D | u_dut/kernel_h_rd_raw_group_q_reg[3]/C | -0.021000000 | clk | clk | clk | u_dut/kernel_h_rd_raw_group_q_reg[3] | FDCE | u_dut/kernel_h_rd_raw_group_q_reg | u_dut/u_unified_p4_kernel/ingress_data_q_reg[5] | FDRE | u_dut/u_unified_p4_kernel/ingress_data_q_reg | 6 | 0.494000000 | 1.440000000 | 1.934000000 | 0.744570838 | SLICE_X66Y29 | SLICE_X59Y26 |  |  | SIGNATURE_SKIPPED|FDCE|FDRE | SIGNATURE_SKIPPED|FDCE|FDRE | DUT_INTERNAL | u_dut/kernel_h_rd_raw_group_q_reg | u_dut/u_unified_p4_kernel/ingress_data_q_reg | 0.021000000
u_dut/u_unified_p4_kernel/ingress_data_q_reg[60]/D | u_dut/kernel_vector_q_reg[0]_rep/C | -0.022000000 | clk | clk | clk | u_dut/kernel_vector_q_reg[0]_rep | FDCE | u_dut/kernel_vector_q_reg_rep | u_dut/u_unified_p4_kernel/ingress_data_q_reg[60] | FDRE | u_dut/u_unified_p4_kernel/ingress_data_q_reg | 5 | 0.671000000 | 1.240000000 | 1.911000000 | 0.648874935 | SLICE_X64Y21 | SLICE_X63Y35 |  |  | SIGNATURE_SKIPPED|FDCE|FDRE | SIGNATURE_SKIPPED|FDCE|FDRE | DUT_INTERNAL | u_dut/kernel_vector_q_reg_rep | u_dut/u_unified_p4_kernel/ingress_data_q_reg | 0.022000000
u_dut/u_unified_p4_kernel/ingress_data_q_reg[7]/D | u_dut/lfnst_grid_reg[0][7]/C | -0.003000000 | clk | clk | clk | u_dut/lfnst_grid_reg[0][7] | FDCE | u_dut/lfnst_grid_reg | u_dut/u_unified_p4_kernel/ingress_data_q_reg[7] | FDRE | u_dut/u_unified_p4_kernel/ingress_data_q_reg | 5 | 0.343000000 | 1.427000000 | 1.770000000 | 0.806214689 | SLICE_X46Y11 | SLICE_X71Y31 |  |  | SIGNATURE_SKIPPED|FDCE|FDRE | SIGNATURE_SKIPPED|FDCE|FDRE | DUT_INTERNAL | u_dut/lfnst_grid_reg | u_dut/u_unified_p4_kernel/ingress_data_q_reg | 0.003000000
u_dut/u_unified_p4_kernel/ingress_data_q_reg[8]/D | u_dut/kernel_vector_q_reg[0]/C | -0.028000000 | clk | clk | clk | u_dut/kernel_vector_q_reg[0] | FDCE | u_dut/kernel_vector_q_reg | u_dut/u_unified_p4_kernel/ingress_data_q_reg[8] | FDRE | u_dut/u_unified_p4_kernel/ingress_data_q_reg | 5 | 0.490000000 | 1.400000000 | 1.890000000 | 0.740740741 | SLICE_X59Y21 | SLICE_X71Y30 |  |  | SIGNATURE_SKIPPED|FDCE|FDRE | SIGNATURE_SKIPPED|FDCE|FDRE | DUT_INTERNAL | u_dut/kernel_vector_q_reg | u_dut/u_unified_p4_kernel/ingress_data_q_reg | 0.028000000
u_dut/u_unified_p4_kernel/ingress_data_q_reg[9]/D | u_dut/lfnst_grid_reg[0][9]/C | -0.014000000 | clk | clk | clk | u_dut/lfnst_grid_reg[0][9] | FDCE | u_dut/lfnst_grid_reg | u_dut/u_unified_p4_kernel/ingress_data_q_reg[9] | FDRE | u_dut/u_unified_p4_kernel/ingress_data_q_reg | 5 | 0.464000000 | 1.341000000 | 1.805000000 | 0.742936288 | SLICE_X47Y10 | SLICE_X72Y32 |  |  | SIGNATURE_SKIPPED|FDCE|FDRE | SIGNATURE_SKIPPED|FDCE|FDRE | DUT_INTERNAL | u_dut/lfnst_grid_reg | u_dut/u_unified_p4_kernel/ingress_data_q_reg | 0.014000000
u_dut/u_unified_p4_kernel/input_mem_reg[0][3][2]/D | u_dut/u_unified_p4_kernel/ingress_data_q_reg[50]/C | -0.023000000 | clk | clk | clk | u_dut/u_unified_p4_kernel/ingress_data_q_reg[50] | FDRE | u_dut/u_unified_p4_kernel/ingress_data_q_reg | u_dut/u_unified_p4_kernel/input_mem_reg[0][3][2] | FDRE | u_dut/u_unified_p4_kernel/input_mem_reg | 0 | 0.079000000 | 1.747000000 | 1.826000000 | 0.956736035 | SLICE_X64Y28 | SLICE_X90Y32 |  |  | SIGNATURE_SKIPPED|FDRE|FDRE | SIGNATURE_SKIPPED|FDRE|FDRE | DUT_INTERNAL | u_dut/u_unified_p4_kernel/ingress_data_q_reg | u_dut/u_unified_p4_kernel/input_mem_reg | 0.023000000
u_dut/u_unified_p4_kernel/input_mem_reg[0][41][10]/D | u_dut/u_unified_p4_kernel/ingress_data_q_reg[26]/C | -0.008000000 | clk | clk | clk | u_dut/u_unified_p4_kernel/ingress_data_q_reg[26] | FDRE | u_dut/u_unified_p4_kernel/ingress_data_q_reg | u_dut/u_unified_p4_kernel/input_mem_reg[0][41][10] | FDRE | u_dut/u_unified_p4_kernel/input_mem_reg | 0 | 0.080000000 | 1.837000000 | 1.917000000 | 0.958268127 | SLICE_X69Y31 | SLICE_X49Y66 |  |  | SIGNATURE_SKIPPED|FDRE|FDRE | SIGNATURE_SKIPPED|FDRE|FDRE | DUT_INTERNAL | u_dut/u_unified_p4_kernel/ingress_data_q_reg | u_dut/u_unified_p4_kernel/input_mem_reg | 0.008000000
u_dut/u_unified_p4_kernel/input_mem_reg[0][43][2]/D | u_dut/u_unified_p4_kernel/ingress_data_q_reg[50]/C | -0.008000000 | clk | clk | clk | u_dut/u_unified_p4_kernel/ingress_data_q_reg[50] | FDRE | u_dut/u_unified_p4_kernel/ingress_data_q_reg | u_dut/u_unified_p4_kernel/input_mem_reg[0][43][2] | FDRE | u_dut/u_unified_p4_kernel/input_mem_reg | 0 | 0.079000000 | 1.821000000 | 1.900000000 | 0.958421053 | SLICE_X64Y28 | SLICE_X49Y69 |  |  | SIGNATURE_SKIPPED|FDRE|FDRE | SIGNATURE_SKIPPED|FDRE|FDRE | DUT_INTERNAL | u_dut/u_unified_p4_kernel/ingress_data_q_reg | u_dut/u_unified_p4_kernel/input_mem_reg | 0.008000000
u_dut/u_unified_p4_kernel/input_mem_reg[0][51][2]/D | u_dut/u_unified_p4_kernel/ingress_data_q_reg[50]/C | -0.045000000 | clk | clk | clk | u_dut/u_unified_p4_kernel/ingress_data_q_reg[50] | FDRE | u_dut/u_unified_p4_kernel/ingress_data_q_reg | u_dut/u_unified_p4_kernel/input_mem_reg[0][51][2] | FDRE | u_dut/u_unified_p4_kernel/input_mem_reg | 0 | 0.079000000 | 1.863000000 | 1.942000000 | 0.959320288 | SLICE_X64Y28 | SLICE_X47Y72 |  |  | SIGNATURE_SKIPPED|FDRE|FDRE | SIGNATURE_SKIPPED|FDRE|FDRE | DUT_INTERNAL | u_dut/u_unified_p4_kernel/ingress_data_q_reg | u_dut/u_unified_p4_kernel/input_mem_reg | 0.045000000
u_dut/u_unified_p4_kernel/input_mem_reg[1][27][2]/D | u_dut/u_unified_p4_kernel/ingress_data_q_reg[50]/C | -0.004000000 | clk | clk | clk | u_dut/u_unified_p4_kernel/ingress_data_q_reg[50] | FDRE | u_dut/u_unified_p4_kernel/ingress_data_q_reg | u_dut/u_unified_p4_kernel/input_mem_reg[1][27][2] | FDRE | u_dut/u_unified_p4_kernel/input_mem_reg | 0 | 0.079000000 | 1.742000000 | 1.821000000 | 0.956617243 | SLICE_X64Y28 | SLICE_X90Y54 |  |  | SIGNATURE_SKIPPED|FDRE|FDRE | SIGNATURE_SKIPPED|FDRE|FDRE | DUT_INTERNAL | u_dut/u_unified_p4_kernel/ingress_data_q_reg | u_dut/u_unified_p4_kernel/input_mem_reg | 0.004000000
u_dut/u_unified_p4_kernel/input_mem_reg[1][55][2]/D | u_dut/u_unified_p4_kernel/ingress_data_q_reg[50]/C | -0.028000000 | clk | clk | clk | u_dut/u_unified_p4_kernel/ingress_data_q_reg[50] | FDRE | u_dut/u_unified_p4_kernel/ingress_data_q_reg | u_dut/u_unified_p4_kernel/input_mem_reg[1][55][2] | FDRE | u_dut/u_unified_p4_kernel/input_mem_reg | 0 | 0.079000000 | 1.850000000 | 1.929000000 | 0.959046138 | SLICE_X64Y28 | SLICE_X43Y55 |  |  | SIGNATURE_SKIPPED|FDRE|FDRE | SIGNATURE_SKIPPED|FDRE|FDRE | DUT_INTERNAL | u_dut/u_unified_p4_kernel/ingress_data_q_reg | u_dut/u_unified_p4_kernel/input_mem_reg | 0.028000000
u_dut/u_unified_p4_kernel/input_mem_reg[1][8][6]/D | u_dut/u_unified_p4_kernel/ingress_data_q_reg[6]/C | -0.010000000 | clk | clk | clk | u_dut/u_unified_p4_kernel/ingress_data_q_reg[6] | FDRE | u_dut/u_unified_p4_kernel/ingress_data_q_reg | u_dut/u_unified_p4_kernel/input_mem_reg[1][8][6] | FDRE | u_dut/u_unified_p4_kernel/input_mem_reg | 0 | 0.079000000 | 1.925000000 | 2.004000000 | 0.960578842 | SLICE_X70Y32 | SLICE_X46Y51 |  |  | SIGNATURE_SKIPPED|FDRE|FDRE | SIGNATURE_SKIPPED|FDRE|FDRE | DUT_INTERNAL | u_dut/u_unified_p4_kernel/ingress_data_q_reg | u_dut/u_unified_p4_kernel/input_mem_reg | 0.010000000
u_dut/u_unified_p4_kernel/input_mem_reg[3][23][8]/D | u_dut/u_unified_p4_kernel/ingress_data_q_reg[56]/C | -0.010000000 | clk | clk | clk | u_dut/u_unified_p4_kernel/ingress_data_q_reg[56] | FDRE | u_dut/u_unified_p4_kernel/ingress_data_q_reg | u_dut/u_unified_p4_kernel/input_mem_reg[3][23][8] | FDRE | u_dut/u_unified_p4_kernel/input_mem_reg | 0 | 0.079000000 | 1.698000000 | 1.777000000 | 0.955543050 | SLICE_X64Y28 | SLICE_X85Y68 |  |  | SIGNATURE_SKIPPED|FDRE|FDRE | SIGNATURE_SKIPPED|FDRE|FDRE | DUT_INTERNAL | u_dut/u_unified_p4_kernel/ingress_data_q_reg | u_dut/u_unified_p4_kernel/input_mem_reg | 0.010000000
u_dut/u_unified_p4_kernel/input_mem_reg[3][27][2]/D | u_dut/u_unified_p4_kernel/ingress_data_q_reg[50]/C | -0.010000000 | clk | clk | clk | u_dut/u_unified_p4_kernel/ingress_data_q_reg[50] | FDRE | u_dut/u_unified_p4_kernel/ingress_data_q_reg | u_dut/u_unified_p4_kernel/input_mem_reg[3][27][2] | FDRE | u_dut/u_unified_p4_kernel/input_mem_reg | 0 | 0.079000000 | 1.789000000 | 1.868000000 | 0.957708779 | SLICE_X64Y28 | SLICE_X90Y54 |  |  | SIGNATURE_SKIPPED|FDRE|FDRE | SIGNATURE_SKIPPED|FDRE|FDRE | DUT_INTERNAL | u_dut/u_unified_p4_kernel/ingress_data_q_reg | u_dut/u_unified_p4_kernel/input_mem_reg | 0.010000000
u_dut/u_unified_p4_kernel/input_mem_reg[3][3][2]/D | u_dut/u_unified_p4_kernel/ingress_data_q_reg[50]/C | -0.027000000 | clk | clk | clk | u_dut/u_unified_p4_kernel/ingress_data_q_reg[50] | FDRE | u_dut/u_unified_p4_kernel/ingress_data_q_reg | u_dut/u_unified_p4_kernel/input_mem_reg[3][3][2] | FDRE | u_dut/u_unified_p4_kernel/input_mem_reg | 0 | 0.079000000 | 1.750000000 | 1.829000000 | 0.956806998 | SLICE_X64Y28 | SLICE_X90Y32 |  |  | SIGNATURE_SKIPPED|FDRE|FDRE | SIGNATURE_SKIPPED|FDRE|FDRE | DUT_INTERNAL | u_dut/u_unified_p4_kernel/ingress_data_q_reg | u_dut/u_unified_p4_kernel/input_mem_reg | 0.027000000
u_dut/u_unified_p4_kernel/input_mem_reg[3][7][14]/D | u_dut/u_unified_p4_kernel/ingress_data_q_reg[62]/C | -0.001000000 | clk | clk | clk | u_dut/u_unified_p4_kernel/ingress_data_q_reg[62] | FDRE | u_dut/u_unified_p4_kernel/ingress_data_q_reg | u_dut/u_unified_p4_kernel/input_mem_reg[3][7][14] | FDRE | u_dut/u_unified_p4_kernel/input_mem_reg | 0 | 0.079000000 | 1.745000000 | 1.824000000 | 0.956688596 | SLICE_X63Y28 | SLICE_X98Y35 |  |  | SIGNATURE_SKIPPED|FDRE|FDRE | SIGNATURE_SKIPPED|FDRE|FDRE | DUT_INTERNAL | u_dut/u_unified_p4_kernel/ingress_data_q_reg | u_dut/u_unified_p4_kernel/input_mem_reg | 0.001000000
u_dut/u_unified_p4_kernel/input_mem_reg[3][7][2]/D | u_dut/u_unified_p4_kernel/ingress_data_q_reg[50]/C | -0.016000000 | clk | clk | clk | u_dut/u_unified_p4_kernel/ingress_data_q_reg[50] | FDRE | u_dut/u_unified_p4_kernel/ingress_data_q_reg | u_dut/u_unified_p4_kernel/input_mem_reg[3][7][2] | FDRE | u_dut/u_unified_p4_kernel/input_mem_reg | 0 | 0.079000000 | 1.713000000 | 1.792000000 | 0.955915179 | SLICE_X64Y28 | SLICE_X87Y33 |  |  | SIGNATURE_SKIPPED|FDRE|FDRE | SIGNATURE_SKIPPED|FDRE|FDRE | DUT_INTERNAL | u_dut/u_unified_p4_kernel/ingress_data_q_reg | u_dut/u_unified_p4_kernel/input_mem_reg | 0.016000000
u_dut/u_unified_p4_kernel/issue_desc_bundle_addr_q_reg[4]_rep__1/D | u_dut/u_unified_p4_kernel/ready_fifo_mem_reg[3][0]/C | -0.018000000 | clk | clk | clk | u_dut/u_unified_p4_kernel/ready_fifo_mem_reg[3][0] | FDCE | u_dut/u_unified_p4_kernel/ready_fifo_mem_reg | u_dut/u_unified_p4_kernel/issue_desc_bundle_addr_q_reg[4]_rep__1 | FDCE | u_dut/u_unified_p4_kernel/issue_desc_bundle_addr_q_reg_rep__1 | 6 | 0.620000000 | 1.302000000 | 1.922000000 | 0.677419355 | SLICE_X75Y40 | SLICE_X78Y56 |  |  | SIGNATURE_SKIPPED|FDCE|FDCE | SIGNATURE_SKIPPED|FDCE|FDCE | DUT_INTERNAL | u_dut/u_unified_p4_kernel/ready_fifo_mem_reg | u_dut/u_unified_p4_kernel/issue_desc_bundle_addr_q_reg_rep__1 | 0.018000000
u_dut/u_unified_p4_kernel/issue_desc_bundle_addr_q_reg[4]_rep__8/D | u_dut/u_unified_p4_kernel/ready_fifo_mem_reg[3][0]/C | -0.004000000 | clk | clk | clk | u_dut/u_unified_p4_kernel/ready_fifo_mem_reg[3][0] | FDCE | u_dut/u_unified_p4_kernel/ready_fifo_mem_reg | u_dut/u_unified_p4_kernel/issue_desc_bundle_addr_q_reg[4]_rep__8 | FDCE | u_dut/u_unified_p4_kernel/issue_desc_bundle_addr_q_reg_rep__8 | 6 | 0.607000000 | 1.351000000 | 1.958000000 | 0.689989785 | SLICE_X75Y40 | SLICE_X75Y61 |  |  | SIGNATURE_SKIPPED|FDCE|FDCE | SIGNATURE_SKIPPED|FDCE|FDCE | DUT_INTERNAL | u_dut/u_unified_p4_kernel/ready_fifo_mem_reg | u_dut/u_unified_p4_kernel/issue_desc_bundle_addr_q_reg_rep__8 | 0.004000000
u_dut/u_unified_p4_kernel/issue_desc_bundle_addr_q_reg[5]_rep__4/D | u_dut/u_unified_p4_kernel/ready_fifo_mem_reg[3][0]/C | -0.002000000 | clk | clk | clk | u_dut/u_unified_p4_kernel/ready_fifo_mem_reg[3][0] | FDCE | u_dut/u_unified_p4_kernel/ready_fifo_mem_reg | u_dut/u_unified_p4_kernel/issue_desc_bundle_addr_q_reg[5]_rep__4 | FDCE | u_dut/u_unified_p4_kernel/issue_desc_bundle_addr_q_reg_rep__4 | 6 | 0.607000000 | 1.301000000 | 1.908000000 | 0.681865828 | SLICE_X75Y40 | SLICE_X74Y58 |  |  | SIGNATURE_SKIPPED|FDCE|FDCE | SIGNATURE_SKIPPED|FDCE|FDCE | DUT_INTERNAL | u_dut/u_unified_p4_kernel/ready_fifo_mem_reg | u_dut/u_unified_p4_kernel/issue_desc_bundle_addr_q_reg_rep__4 | 0.002000000
u_dut/u_unified_p4_kernel/reduce_l5_q_reg[0][37]/D | u_dut/u_unified_p4_kernel/reduce_l4_q_reg[0][2][17]/C | -0.016000000 | clk | clk | clk | u_dut/u_unified_p4_kernel/reduce_l4_q_reg[0][2][17] | FDRE | u_dut/u_unified_p4_kernel/reduce_l4_q_reg | u_dut/u_unified_p4_kernel/reduce_l5_q_reg[0][37] | FDRE | u_dut/u_unified_p4_kernel/reduce_l5_q_reg | 6 | 0.666000000 | 1.185000000 | 1.851000000 | 0.640194489 | SLICE_X59Y66 | SLICE_X79Y70 |  |  | SIGNATURE_SKIPPED|FDRE|FDRE | SIGNATURE_SKIPPED|FDRE|FDRE | DUT_INTERNAL | u_dut/u_unified_p4_kernel/reduce_l4_q_reg | u_dut/u_unified_p4_kernel/reduce_l5_q_reg | 0.016000000
u_dut/u_unified_p4_kernel/reduce_l5_q_reg[0][38]/D | u_dut/u_unified_p4_kernel/reduce_l4_q_reg[0][2][17]/C | -0.004000000 | clk | clk | clk | u_dut/u_unified_p4_kernel/reduce_l4_q_reg[0][2][17] | FDRE | u_dut/u_unified_p4_kernel/reduce_l4_q_reg | u_dut/u_unified_p4_kernel/reduce_l5_q_reg[0][38] | FDRE | u_dut/u_unified_p4_kernel/reduce_l5_q_reg | 6 | 0.653000000 | 1.186000000 | 1.839000000 | 0.644915715 | SLICE_X59Y66 | SLICE_X79Y70 |  |  | SIGNATURE_SKIPPED|FDRE|FDRE | SIGNATURE_SKIPPED|FDRE|FDRE | DUT_INTERNAL | u_dut/u_unified_p4_kernel/reduce_l4_q_reg | u_dut/u_unified_p4_kernel/reduce_l5_q_reg | 0.004000000
u_dut/u_unified_p4_kernel/reduce_l5_q_reg[0][39]/D | u_dut/u_unified_p4_kernel/reduce_l4_q_reg[0][2][17]/C | -0.017000000 | clk | clk | clk | u_dut/u_unified_p4_kernel/reduce_l4_q_reg[0][2][17] | FDRE | u_dut/u_unified_p4_kernel/reduce_l4_q_reg | u_dut/u_unified_p4_kernel/reduce_l5_q_reg[0][39] | FDRE | u_dut/u_unified_p4_kernel/reduce_l5_q_reg | 6 | 0.666000000 | 1.186000000 | 1.852000000 | 0.640388769 | SLICE_X59Y66 | SLICE_X79Y70 |  |  | SIGNATURE_SKIPPED|FDRE|FDRE | SIGNATURE_SKIPPED|FDRE|FDRE | DUT_INTERNAL | u_dut/u_unified_p4_kernel/reduce_l4_q_reg | u_dut/u_unified_p4_kernel/reduce_l5_q_reg | 0.017000000
u_dut/u_unified_p4_kernel/s0_input_q_reg[24][4]/D | u_dut/u_unified_p4_kernel/issue_desc_slot_q_reg[1]_rep__3/C | -0.003000000 | clk | clk | clk | u_dut/u_unified_p4_kernel/issue_desc_slot_q_reg[1]_rep__3 | FDCE | u_dut/u_unified_p4_kernel/issue_desc_slot_q_reg_rep__3 | u_dut/u_unified_p4_kernel/s0_input_q_reg[24][4] | FDRE | u_dut/u_unified_p4_kernel/s0_input_q_reg | 3 | 0.330000000 | 1.516000000 | 1.846000000 | 0.821235103 | SLICE_X58Y49 | SLICE_X77Y46 |  |  | SIGNATURE_SKIPPED|FDCE|FDRE | SIGNATURE_SKIPPED|FDCE|FDRE | DUT_INTERNAL | u_dut/u_unified_p4_kernel/issue_desc_slot_q_reg_rep__3 | u_dut/u_unified_p4_kernel/s0_input_q_reg | 0.003000000
u_dut/u_unified_p4_kernel/s0_input_q_reg[2][8]/D | u_dut/u_unified_p4_kernel/issue_desc_slot_q_reg[1]_rep__3/C | -0.001000000 | clk | clk | clk | u_dut/u_unified_p4_kernel/issue_desc_slot_q_reg[1]_rep__3 | FDCE | u_dut/u_unified_p4_kernel/issue_desc_slot_q_reg_rep__3 | u_dut/u_unified_p4_kernel/s0_input_q_reg[2][8] | FDRE | u_dut/u_unified_p4_kernel/s0_input_q_reg | 1 | 0.225000000 | 1.648000000 | 1.873000000 | 0.879871863 | SLICE_X58Y49 | SLICE_X94Y29 |  |  | SIGNATURE_SKIPPED|FDCE|FDRE | SIGNATURE_SKIPPED|FDCE|FDRE | DUT_INTERNAL | u_dut/u_unified_p4_kernel/issue_desc_slot_q_reg_rep__3 | u_dut/u_unified_p4_kernel/s0_input_q_reg | 0.001000000
u_dut/u_unified_p4_kernel/s0_input_q_reg[42][0]/R | u_dut/u_unified_p4_kernel/issue_desc_active_size_q_reg[4]/C | -0.005000000 | clk | clk | clk | u_dut/u_unified_p4_kernel/issue_desc_active_size_q_reg[4] | FDCE | u_dut/u_unified_p4_kernel/issue_desc_active_size_q_reg | u_dut/u_unified_p4_kernel/s0_input_q_reg[42][0] | FDRE | u_dut/u_unified_p4_kernel/s0_input_q_reg | 2 | 0.302000000 | 1.573000000 | 1.875000000 | 0.838933333 | SLICE_X73Y40 | SLICE_X58Y67 |  |  | SIGNATURE_SKIPPED|FDCE|FDRE | SIGNATURE_SKIPPED|FDCE|FDRE | DUT_INTERNAL | u_dut/u_unified_p4_kernel/issue_desc_active_size_q_reg | u_dut/u_unified_p4_kernel/s0_input_q_reg | 0.005000000
u_dut/u_unified_p4_kernel/s0_input_q_reg[42][2]/R | u_dut/u_unified_p4_kernel/issue_desc_active_size_q_reg[4]/C | -0.005000000 | clk | clk | clk | u_dut/u_unified_p4_kernel/issue_desc_active_size_q_reg[4] | FDCE | u_dut/u_unified_p4_kernel/issue_desc_active_size_q_reg | u_dut/u_unified_p4_kernel/s0_input_q_reg[42][2] | FDRE | u_dut/u_unified_p4_kernel/s0_input_q_reg | 2 | 0.302000000 | 1.573000000 | 1.875000000 | 0.838933333 | SLICE_X73Y40 | SLICE_X58Y67 |  |  | SIGNATURE_SKIPPED|FDCE|FDRE | SIGNATURE_SKIPPED|FDCE|FDRE | DUT_INTERNAL | u_dut/u_unified_p4_kernel/issue_desc_active_size_q_reg | u_dut/u_unified_p4_kernel/s0_input_q_reg | 0.005000000
u_dut/u_unified_p4_kernel/s0_input_q_reg[42][6]/R | u_dut/u_unified_p4_kernel/issue_desc_active_size_q_reg[4]/C | -0.013000000 | clk | clk | clk | u_dut/u_unified_p4_kernel/issue_desc_active_size_q_reg[4] | FDCE | u_dut/u_unified_p4_kernel/issue_desc_active_size_q_reg | u_dut/u_unified_p4_kernel/s0_input_q_reg[42][6] | FDRE | u_dut/u_unified_p4_kernel/s0_input_q_reg | 2 | 0.302000000 | 1.577000000 | 1.879000000 | 0.839276211 | SLICE_X73Y40 | SLICE_X58Y64 |  |  | SIGNATURE_SKIPPED|FDCE|FDRE | SIGNATURE_SKIPPED|FDCE|FDRE | DUT_INTERNAL | u_dut/u_unified_p4_kernel/issue_desc_active_size_q_reg | u_dut/u_unified_p4_kernel/s0_input_q_reg | 0.013000000
u_dut/u_unified_p4_kernel/s0_input_q_reg[42][7]/R | u_dut/u_unified_p4_kernel/issue_desc_active_size_q_reg[4]/C | -0.013000000 | clk | clk | clk | u_dut/u_unified_p4_kernel/issue_desc_active_size_q_reg[4] | FDCE | u_dut/u_unified_p4_kernel/issue_desc_active_size_q_reg | u_dut/u_unified_p4_kernel/s0_input_q_reg[42][7] | FDRE | u_dut/u_unified_p4_kernel/s0_input_q_reg | 2 | 0.302000000 | 1.577000000 | 1.879000000 | 0.839276211 | SLICE_X73Y40 | SLICE_X58Y64 |  |  | SIGNATURE_SKIPPED|FDCE|FDRE | SIGNATURE_SKIPPED|FDCE|FDRE | DUT_INTERNAL | u_dut/u_unified_p4_kernel/issue_desc_active_size_q_reg | u_dut/u_unified_p4_kernel/s0_input_q_reg | 0.013000000
