hahayyf666-netizen/ITS_NEW/05_audit/current/17/step12b_rtl_event_trace_normal.csv

cycle | event | phase | vector | group | index | addr | end
5 | input_fire | 0 |  |  |  | 65 | 1
22 | stage_capture | 1 | 0 | 15 | 0
23 | vector_start | 1 | 0
38 | stage_capture | 1 | 1 | 15 | 1
39 | vector_start | 1 | 1
46 | kernel_group | 1 | 0 | 0
46 | intermediate_write | 1 | 0 | 0 |  |  | 0
47 | kernel_group | 1 | 0 | 1
47 | intermediate_write | 1 | 0 | 1 |  |  | 1
48 | kernel_group | 1 | 0 | 2
48 | intermediate_write | 1 | 0 | 2 |  |  | 2
49 | kernel_group | 1 | 0 | 3
49 | intermediate_write | 1 | 0 | 3 |  |  | 3
50 | kernel_group | 1 | 0 | 4
50 | intermediate_write | 1 | 0 | 4 |  |  | 4
51 | kernel_group | 1 | 0 | 5
51 | intermediate_write | 1 | 0 | 5 |  |  | 5
52 | kernel_group | 1 | 0 | 6
52 | intermediate_write | 1 | 0 | 6 |  |  | 6
53 | kernel_group | 1 | 0 | 7
53 | intermediate_write | 1 | 0 | 7 |  |  | 7
54 | kernel_group | 1 | 0 | 8
54 | stage_capture | 1 | 2 | 15 | 2
54 | intermediate_write | 1 | 0 | 8 |  |  | 8
55 | vector_start | 1 | 2
55 | kernel_group | 1 | 0 | 9
55 | intermediate_write | 1 | 0 | 9 |  |  | 9
56 | kernel_group | 1 | 0 | 10
56 | intermediate_write | 1 | 0 | 10 |  |  | 10
57 | kernel_group | 1 | 0 | 11
57 | intermediate_write | 1 | 0 | 11 |  |  | 11
58 | kernel_group | 1 | 0 | 12
58 | intermediate_write | 1 | 0 | 12 |  |  | 12
59 | kernel_group | 1 | 0 | 13
59 | intermediate_write | 1 | 0 | 13 |  |  | 13
60 | kernel_group | 1 | 0 | 14
60 | intermediate_write | 1 | 0 | 14 |  |  | 14
61 | kernel_group | 1 | 0 | 15
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
1301 | result_read_response | 2 |  |  | 150
1302 | kernel_group | 2 | 76 | 0
1302 | result_write | 2 | 76 | 0
1302 | result_read_response | 2 |  |  | 151
1303 | kernel_group | 2 | 76 | 1
1303 | result_write | 2 | 76 | 1
1304 | kernel_group | 2 | 76 | 2
1304 | result_write | 2 | 76 | 2
1305 | kernel_group | 2 | 76 | 3
1305 | result_write | 2 | 76 | 3
1306 | kernel_group | 2 | 76 | 4
1306 | result_write | 2 | 76 | 4
1306 | output_fire |  |  |  | 150
1306 | result_read_request | 2 |  |  | 152
1307 | kernel_group | 2 | 76 | 5
1307 | result_write | 2 | 76 | 5
1307 | output_fire |  |  |  | 151
1307 | result_read_request | 2 |  |  | 153
1307 | result_read_response | 2 |  |  | 152
1308 | kernel_group | 2 | 76 | 6
1308 | result_write | 2 | 76 | 6
1308 | output_fire |  |  |  | 152
1308 | result_read_request | 2 |  |  | 154
1308 | result_read_response | 2 |  |  | 153
1309 | kernel_group | 2 | 76 | 7
1309 | result_write | 2 | 76 | 7
1309 | output_fire |  |  |  | 153
1309 | result_read_request | 2 |  |  | 155
1309 | result_read_response | 2 |  |  | 154
1310 | kernel_group | 2 | 76 | 8
1310 | result_write | 2 | 76 | 8
1310 | output_fire |  |  |  | 154
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
