hahayyf666-netizen/ITS_NEW/03_verification/vivado/reports_r4b_pre_readonly/all_failing_setup_paths.csv

index | slack | datapath_delay | logic_levels | startpoint | endpoint
1 | -0.626 | 2.605 | 7 | bf_cycle_reg[1]/C | signal_reg_reg[118][20]/D
2 | -0.617 | 2.598 | 7 | bf_cycle_reg[1]/C | signal_reg_reg[114][13]/D
3 | -0.599 | 2.579 | 7 | bf_cycle_reg[1]/C | signal_reg_reg[110][17]/D
4 | -0.597 | 2.577 | 7 | bf_cycle_reg[1]/C | signal_reg_reg[98][21]/D
5 | -0.587 | 2.569 | 7 | operand_x_reg_reg[47][9]/C | lane_product_reg_reg[79][11]/D
6 | -0.579 | 2.560 | 6 | bf_cycle_reg[2]/C | signal_reg_reg[92][19]/D
7 | -0.576 | 2.556 | 7 | bf_cycle_reg[1]/C | signal_reg_reg[114][17]/D
8 | -0.576 | 2.557 | 6 | bf_cycle_reg[2]/C | signal_reg_reg[9][13]/D
9 | -0.574 | 2.554 | 7 | bf_cycle_reg[1]/C | signal_reg_reg[118][21]/D
10 | -0.570 | 2.551 | 6 | bf_cycle_reg[2]/C | signal_reg_reg[92][18]/D
11 | -0.569 | 2.549 | 7 | bf_cycle_reg[1]/C | signal_reg_reg[122][21]/D
12 | -0.559 | 2.539 | 7 | bf_cycle_reg[1]/C | signal_reg_reg[98][17]/D
13 | -0.556 | 2.536 | 7 | bf_cycle_reg[2]/C | signal_reg_reg[9][21]/D
14 | -0.554 | 2.533 | 7 | bf_cycle_reg[1]/C | signal_reg_reg[118][11]/D
15 | -0.552 | 2.532 | 6 | bf_cycle_reg[2]/C | signal_reg_reg[116][18]/D
16 | -0.551 | 2.531 | 7 | bf_cycle_reg[1]/C | signal_reg_reg[94][10]/D
17 | -0.550 | 2.530 | 7 | bf_cycle_reg[2]/C | signal_reg_reg[9][19]/D
18 | -0.549 | 2.529 | 6 | bf_cycle_reg[2]/C | signal_reg_reg[96][21]/D
19 | -0.544 | 2.523 | 7 | bf_cycle_reg[1]/C | signal_reg_reg[110][19]/D
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
1432 | -0.378 | 2.361 | 7 | operand_x_reg_reg[9][11]/C | lane_product_reg_reg[9][12]/D
1433 | -0.378 | 2.361 | 7 | operand_x_reg_reg[110][4]/C | lane_product_reg_reg[110][7]/D
1434 | -0.378 | 2.359 | 7 | operand_coeff_reg_reg[15][0]/C | lane_product_reg_reg[15][15]/D
1435 | -0.378 | 2.361 | 7 | operand_x_reg_reg[97][6]/C | lane_product_reg_reg[97][13]/D
1436 | -0.378 | 2.359 | 7 | operand_x_reg_reg[21][7]/C | lane_product_reg_reg[21][14]/D
1437 | -0.378 | 2.359 | 5 | bf_cycle_reg[2]/C | signal_reg_reg[70][23]/D
1438 | -0.378 | 2.359 | 7 | operand_x_reg_reg[26][5]/C | lane_product_reg_reg[58][19]/D
1439 | -0.378 | 2.360 | 7 | operand_coeff_reg_reg[64][6]/C | lane_product_reg_reg[127][21]/D
1440 | -0.378 | 2.358 | 6 | bf_cycle_reg[1]/C | signal_reg_reg[114][7]/D
1441 | -0.378 | 2.360 | 7 | operand_coeff_reg_reg[118][7]/C | lane_product_reg_reg[118][9]/D
1442 | -0.378 | 2.359 | 7 | operand_x_reg_reg[53][2]/C | lane_product_reg_reg[85][18]/D
1443 | -0.378 | 2.357 | 6 | bf_cycle_reg[2]/C | signal_reg_reg[65][11]/D
1444 | -0.378 | 2.358 | 7 | operand_coeff_reg_reg[3][7]/C | lane_product_reg_reg[3][8]/D
1445 | -0.378 | 2.358 | 7 | operand_x_reg_reg[88][5]/C | lane_product_reg_reg[88][9]/D
1446 | -0.378 | 2.357 | 6 | bf_cycle_reg[2]/C | signal_reg_reg[58][22]/D
1447 | -0.377 | 2.358 | 5 | bf_cycle_reg[2]/C | signal_reg_reg[75][9]/D
1448 | -0.377 | 2.357 | 7 | operand_coeff_reg_reg[57][7]/C | lane_product_reg_reg[57][17]/D
1449 | -0.377 | 2.358 | 6 | bf_cycle_reg[1]/C | signal_reg_reg[118][6]/D
1450 | -0.377 | 2.358 | 7 | operand_coeff_reg_reg[29][7]/C | lane_product_reg_reg[29][19]/D
1451 | -0.377 | 2.359 | 7 | operand_x_reg_reg[46][5]/C | lane_product_reg_reg[46][17]/D
1452 | -0.377 | 2.357 | 7 | operand_coeff_reg_reg[7][1]/C | lane_product_reg_reg[117][12]/D
1453 | -0.377 | 2.358 | 7 | operand_x_reg_reg[29][0]/C | lane_product_reg_reg[29][4]/D
1454 | -0.377 | 2.358 | 7 | operand_coeff_reg_reg[57][3]/C | lane_product_reg_reg[57][6]/D
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
