hahayyf666-netizen/ITS_NEW/05_audit/current/23/m7_rtl/step12b_rtl_event_trace_normal.csv

cycle | event | phase | vector | group | index | addr | end | cache | bank | request_id
1 | epoch_scrub | 0 |  |  |  | 0 |  | A | 0
1 | epoch_scrub | 0 |  |  |  | 0 |  | A | 1
1 | epoch_scrub | 0 |  |  |  | 0 |  | A | 2
1 | epoch_scrub | 0 |  |  |  | 0 |  | A | 3
1 | epoch_scrub | 0 |  |  |  | 0 |  | B | 0
1 | epoch_scrub | 0 |  |  |  | 0 |  | B | 1
1 | epoch_scrub | 0 |  |  |  | 0 |  | B | 2
1 | epoch_scrub | 0 |  |  |  | 0 |  | B | 3
2 | epoch_scrub | 0 |  |  |  | 1 |  | A | 0
2 | epoch_scrub | 0 |  |  |  | 1 |  | A | 1
2 | epoch_scrub | 0 |  |  |  | 1 |  | A | 2
2 | epoch_scrub | 0 |  |  |  | 1 |  | A | 3
2 | epoch_scrub | 0 |  |  |  | 1 |  | B | 0
2 | epoch_scrub | 0 |  |  |  | 1 |  | B | 1
2 | epoch_scrub | 0 |  |  |  | 1 |  | B | 2
2 | epoch_scrub | 0 |  |  |  | 1 |  | B | 3
3 | epoch_scrub | 0 |  |  |  | 2 |  | A | 0
3 | epoch_scrub | 0 |  |  |  | 2 |  | A | 1
3 | epoch_scrub | 0 |  |  |  | 2 |  | A | 2
3 | epoch_scrub | 0 |  |  |  | 2 |  | A | 3
3 | epoch_scrub | 0 |  |  |  | 2 |  | B | 0
3 | epoch_scrub | 0 |  |  |  | 2 |  | B | 1
3 | epoch_scrub | 0 |  |  |  | 2 |  | B | 2
3 | epoch_scrub | 0 |  |  |  | 2 |  | B | 3
4 | epoch_scrub | 0 |  |  |  | 3 |  | A | 0
4 | epoch_scrub | 0 |  |  |  | 3 |  | A | 1
4 | epoch_scrub | 0 |  |  |  | 3 |  | A | 2
4 | epoch_scrub | 0 |  |  |  | 3 |  | A | 3
4 | epoch_scrub | 0 |  |  |  | 3 |  | B | 0
4 | epoch_scrub | 0 |  |  |  | 3 |  | B | 1
4 | epoch_scrub | 0 |  |  |  | 3 |  | B | 2
4 | epoch_scrub | 0 |  |  |  | 3 |  | B | 3
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
175 | epoch_scrub | 0 |  |  |  | 174 |  | A | 2
175 | epoch_scrub | 0 |  |  |  | 174 |  | A | 3
175 | epoch_scrub | 0 |  |  |  | 174 |  | B | 0
175 | epoch_scrub | 0 |  |  |  | 174 |  | B | 1
175 | epoch_scrub | 0 |  |  |  | 174 |  | B | 2
175 | epoch_scrub | 0 |  |  |  | 174 |  | B | 3
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
