hahayyf666-netizen/ITS_NEW/03_verification/output/r4c_pre_dsp_audit/dsp_control_pins.csv

index | cell | pin | net | driver
1 | p_0_out | CLK | <const0> | GND/G
1 | p_0_out | RSTA | <const0> | GND/G
1 | p_0_out | RSTB | <const0> | GND/G
1 | p_0_out | RSTM | <const0> | GND/G
1 | p_0_out | RSTP | <const0> | GND/G
1 | p_0_out | CEA1 | <const0> | GND/G
1 | p_0_out | CEA2 | <const0> | GND/G
1 | p_0_out | CEAD | <const0> | GND/G
1 | p_0_out | CEB1 | <const0> | GND/G
1 | p_0_out | CEB2 | <const0> | GND/G
1 | p_0_out | CEM | <const0> | GND/G
1 | p_0_out | CEP | <const0> | GND/G
1 | p_0_out | CECTRL | <const0> | GND/G
1 | p_0_out | CED | <const0> | GND/G
1 | p_0_out | CEINMODE | <const0> | GND/G
2 | p_0_out__0 | CLK | <const0> | GND/G
2 | p_0_out__0 | RSTA | <const0> | GND/G
2 | p_0_out__0 | RSTB | <const0> | GND/G
2 | p_0_out__0 | RSTM | <const0> | GND/G
2 | p_0_out__0 | RSTP | <const0> | GND/G
2 | p_0_out__0 | CEA1 | <const0> | GND/G
2 | p_0_out__0 | CEA2 | <const0> | GND/G
2 | p_0_out__0 | CEAD | <const0> | GND/G
2 | p_0_out__0 | CEB1 | <const0> | GND/G
2 | p_0_out__0 | CEB2 | <const0> | GND/G
2 | p_0_out__0 | CEM | <const0> | GND/G
2 | p_0_out__0 | CEP | <const0> | GND/G
2 | p_0_out__0 | CECTRL | <const0> | GND/G
2 | p_0_out__0 | CED | <const0> | GND/G
2 | p_0_out__0 | CEINMODE | <const0> | GND/G
3 | p_0_out__0__0 | CLK | <const0> | GND/G
3 | p_0_out__0__0 | RSTA | <const0> | GND/G
3 | p_0_out__0__0 | RSTB | <const0> | GND/G
3 | p_0_out__0__0 | RSTM | <const0> | GND/G
3 | p_0_out__0__0 | RSTP | <const0> | GND/G
3 | p_0_out__0__0 | CEA1 | <const0> | GND/G
3 | p_0_out__0__0 | CEA2 | <const0> | GND/G
3 | p_0_out__0__0 | CEAD | <const0> | GND/G
3 | p_0_out__0__0 | CEB1 | <const0> | GND/G
3 | p_0_out__0__0 | CEB2 | <const0> | GND/G
3 | p_0_out__0__0 | CEM | <const0> | GND/G
3 | p_0_out__0__0 | CEP | <const0> | GND/G
3 | p_0_out__0__0 | CECTRL | <const0> | GND/G
3 | p_0_out__0__0 | CED | <const0> | GND/G
3 | p_0_out__0__0 | CEINMODE | <const0> | GND/G
4 | p_0_out__1 | CLK | <const0> | GND/G
4 | p_0_out__1 | RSTA | <const0> | GND/G
4 | p_0_out__1 | RSTB | <const0> | GND/G
4 | p_0_out__1 | RSTM | <const0> | GND/G
4 | p_0_out__1 | RSTP | <const0> | GND/G
4 | p_0_out__1 | CEA1 | <const0> | GND/G
4 | p_0_out__1 | CEA2 | <const0> | GND/G
4 | p_0_out__1 | CEAD | <const0> | GND/G
4 | p_0_out__1 | CEB1 | <const0> | GND/G
4 | p_0_out__1 | CEB2 | <const0> | GND/G
4 | p_0_out__1 | CEM | <const0> | GND/G
4 | p_0_out__1 | CEP | <const0> | GND/G
4 | p_0_out__1 | CECTRL | <const0> | GND/G
4 | p_0_out__1 | CED | <const0> | GND/G
4 | p_0_out__1 | CEINMODE | <const0> | GND/G
5 | p_0_out__10 | CLK | <const0> | GND/G
5 | p_0_out__10 | RSTA | <const0> | GND/G
5 | p_0_out__10 | RSTB | <const0> | GND/G
5 | p_0_out__10 | RSTM | <const0> | GND/G
5 | p_0_out__10 | RSTP | <const0> | GND/G
5 | p_0_out__10 | CEA1 | <const0> | GND/G
5 | p_0_out__10 | CEA2 | <const0> | GND/G
5 | p_0_out__10 | CEAD | <const0> | GND/G
5 | p_0_out__10 | CEB1 | <const0> | GND/G
5 | p_0_out__10 | CEB2 | <const0> | GND/G
5 | p_0_out__10 | CEM | <const0> | GND/G
5 | p_0_out__10 | CEP | <const0> | GND/G
5 | p_0_out__10 | CECTRL | <const0> | GND/G
5 | p_0_out__10 | CED | <const0> | GND/G
5 | p_0_out__10 | CEINMODE | <const0> | GND/G
6 | p_0_out__10__0 | CLK | <const0> | GND/G
6 | p_0_out__10__0 | RSTA | <const0> | GND/G
6 | p_0_out__10__0 | RSTB | <const0> | GND/G
6 | p_0_out__10__0 | RSTM | <const0> | GND/G
6 | p_0_out__10__0 | RSTP | <const0> | GND/G
6 | p_0_out__10__0 | CEA1 | <const0> | GND/G
6 | p_0_out__10__0 | CEA2 | <const0> | GND/G
6 | p_0_out__10__0 | CEAD | <const0> | GND/G
6 | p_0_out__10__0 | CEB1 | <const0> | GND/G
6 | p_0_out__10__0 | CEB2 | <const0> | GND/G
6 | p_0_out__10__0 | CEM | <const0> | GND/G
6 | p_0_out__10__0 | CEP | <const0> | GND/G
6 | p_0_out__10__0 | CECTRL | <const0> | GND/G
6 | p_0_out__10__0 | CED | <const0> | GND/G
6 | p_0_out__10__0 | CEINMODE | <const0> | GND/G
7 | p_0_out__11 | CLK | <const0> | GND/G
7 | p_0_out__11 | RSTA | <const0> | GND/G
7 | p_0_out__11 | RSTB | <const0> | GND/G
7 | p_0_out__11 | RSTM | <const0> | GND/G
7 | p_0_out__11 | RSTP | <const0> | GND/G
7 | p_0_out__11 | CEA1 | <const0> | GND/G
7 | p_0_out__11 | CEA2 | <const0> | GND/G
7 | p_0_out__11 | CEAD | <const0> | GND/G
7 | p_0_out__11 | CEB1 | <const0> | GND/G
7 | p_0_out__11 | CEB2 | <const0> | GND/G
7 | p_0_out__11 | CEM | <const0> | GND/G
7 | p_0_out__11 | CEP | <const0> | GND/G
7 | p_0_out__11 | CECTRL | <const0> | GND/G
7 | p_0_out__11 | CED | <const0> | GND/G
7 | p_0_out__11 | CEINMODE | <const0> | GND/G
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
125 | p_0_out__8 | CECTRL | <const0> | GND/G
125 | p_0_out__8 | CED | <const0> | GND/G
125 | p_0_out__8 | CEINMODE | <const0> | GND/G
126 | p_0_out__8__0 | CLK | <const0> | GND/G
126 | p_0_out__8__0 | RSTA | <const0> | GND/G
126 | p_0_out__8__0 | RSTB | <const0> | GND/G
126 | p_0_out__8__0 | RSTM | <const0> | GND/G
126 | p_0_out__8__0 | RSTP | <const0> | GND/G
126 | p_0_out__8__0 | CEA1 | <const0> | GND/G
126 | p_0_out__8__0 | CEA2 | <const0> | GND/G
126 | p_0_out__8__0 | CEAD | <const0> | GND/G
126 | p_0_out__8__0 | CEB1 | <const0> | GND/G
126 | p_0_out__8__0 | CEB2 | <const0> | GND/G
126 | p_0_out__8__0 | CEM | <const0> | GND/G
126 | p_0_out__8__0 | CEP | <const0> | GND/G
126 | p_0_out__8__0 | CECTRL | <const0> | GND/G
126 | p_0_out__8__0 | CED | <const0> | GND/G
126 | p_0_out__8__0 | CEINMODE | <const0> | GND/G
127 | p_0_out__9 | CLK | <const0> | GND/G
127 | p_0_out__9 | RSTA | <const0> | GND/G
127 | p_0_out__9 | RSTB | <const0> | GND/G
127 | p_0_out__9 | RSTM | <const0> | GND/G
127 | p_0_out__9 | RSTP | <const0> | GND/G
127 | p_0_out__9 | CEA1 | <const0> | GND/G
127 | p_0_out__9 | CEA2 | <const0> | GND/G
127 | p_0_out__9 | CEAD | <const0> | GND/G
127 | p_0_out__9 | CEB1 | <const0> | GND/G
127 | p_0_out__9 | CEB2 | <const0> | GND/G
127 | p_0_out__9 | CEM | <const0> | GND/G
127 | p_0_out__9 | CEP | <const0> | GND/G
127 | p_0_out__9 | CECTRL | <const0> | GND/G
127 | p_0_out__9 | CED | <const0> | GND/G
127 | p_0_out__9 | CEINMODE | <const0> | GND/G
128 | p_0_out__9__0 | CLK | <const0> | GND/G
128 | p_0_out__9__0 | RSTA | <const0> | GND/G
128 | p_0_out__9__0 | RSTB | <const0> | GND/G
128 | p_0_out__9__0 | RSTM | <const0> | GND/G
128 | p_0_out__9__0 | RSTP | <const0> | GND/G
128 | p_0_out__9__0 | CEA1 | <const0> | GND/G
128 | p_0_out__9__0 | CEA2 | <const0> | GND/G
128 | p_0_out__9__0 | CEAD | <const0> | GND/G
128 | p_0_out__9__0 | CEB1 | <const0> | GND/G
128 | p_0_out__9__0 | CEB2 | <const0> | GND/G
128 | p_0_out__9__0 | CEM | <const0> | GND/G
128 | p_0_out__9__0 | CEP | <const0> | GND/G
128 | p_0_out__9__0 | CECTRL | <const0> | GND/G
128 | p_0_out__9__0 | CED | <const0> | GND/G
128 | p_0_out__9__0 | CEINMODE | <const0> | GND/G
