hahayyf666-netizen/ITS_NEW/03_verification/output/V35_P2F_B2_R3_STATIC_CONNECTIVITY_PROOF.md

# V35 P2F B2 R3 Static Connectivity Proof

Status: **PASS_STATIC_TABLE_ANALYSIS**\n\nLive reduction events: 1304\n\nLive operations: 1368\n\nCanonical raw matrix: 4096/4096 elements match.\n\nSource-pair histogram: 96 fixed, 28 two-choice, 0 invalid (>2).\n\nAll 64 dots have exactly one terminal producer; completion peak is 8.\n\nThis proves reachable schedule connectivity, not synthesized-cell topology or post-route timing.
