hahayyf666-netizen/ITS_NEW/03_verification/output/V35_P2F_B2_R3_STRUCTURE_AUDIT.md

# V35 P2F B2 R3 Structure Audit

Status: **PASS**

Fixed dot assignments: 64 / 64

Dynamic terminal destinations: 0

Negative self-tests: PASS

No failures.
