hahayyf666-netizen/ITS_NEW/03_verification/output/V4_compute_throughput_feasibility.md

# V4 计算吞吐可行性审计报告

> 日期：2026-08-08
> 基线：V3.2 冻结 RTL（its_core_500=04241edc, async_fifo=08254a2a）
> 目的：核对题面第 4 项"一拍计算四个点，支持流水"的真实含义，
> 量化当前计算核心吞吐，评估三种架构方案的可行性。
> 本阶段只做审计和评估，不修改 RTL。

---

## 一、当前真实性能量化

### 1.1 变换引擎 1D 变换周期模型（its_transform_engine.v）

状态机周期（对尺寸 N 的 1D 变换）：

| 阶段 | 周期数 | 说明 |
|---|:--:|---|
| S_LOAD | N | 加载 N 个输入到 line_buf |
| S_PREFETCH | 4N | 从 ROM 预取 4 行 × N 列系数 |
| S_COMPUTE | N | 4 MAC 并行，算 4 个输出点的累加 |
| S_OUTPUT | N | 输出 N 个结果 |
| 主循环 | N/4 组 | 每组 = PREFETCH(4N) + COMPUTE(N) = 5N |

**1D 引擎一次调用总周期 = N + (N/4)×5N + N = 2N + 5N²/4**

- **第一组 4 个结果完成**：N(LOAD) + 4N(PREFETCH) + N(COMPUTE) = **6N 周期**
- **相邻两组间隔**：PREFETCH + COMPUTE = **5N 周期**

### 1.2 各尺寸 1D 变换实测模型

| N | LOAD | 组数 | 每组周期 | 总周期 | 首组@ | 组间隔 | **结果吞吐** |
|:--:|:--:|:--:|:--:|:--:|:--:|:--:|:--:|
| 4 | 4 | 1 | 20 | 28 | 24 | — | **0.143 结果/拍** |
| 8 | 8 | 2 | 40 | 96 | 48 | 40 | **0.083** |
| 16 | 16 | 4 | 80 | 352 | 96 | 80 | **0.045** |
| 32 | 32 | 8 | 160 | 1344 | 192 | 160 | **0.024** |
| 64 | 64 | 16 | 320 | 5248 | 384 | 320 | **0.012** |

### 1.3 2D 变换（N×N TU）

垂直阶段 W 列 × 1D(H) + 水平阶段 H 行 × 1D(W)：

| N | 垂直周期 | 水平周期 | 总计算周期 | **完整结果吞吐** |
|:--:|:--:|:--:|:--:|:--:|
| 4 | 112 | 112 | ~306 | **0.052 结果/拍** |
| 8 | 768 | 768 | ~1600 | **0.040** |
| 16 | 5632 | 5632 | ~11392 | **0.022** |
| 32 | 43008 | 43008 | ~86400 | **0.012** |
| 64 | 335872 | 335872 | ~672768 | **0.006** |

### 1.4 模型验证

协议测试实测：4×4 DCT2 单时钟，复位后首拍输出 @ cycle 310。
解析模型：S_CLEAR(16) + S_LOAD(~16) + 垂直(112) + 水平(112) + S_OUT(~50) ≈ **306**。
**解析模型与实测吻合（~310 vs 306）。**

---

## 二、概念严格区分

| 概念 | 当前实现 | 数值 |
|---|:--:|---|
| **4 次乘加/拍** | ✅ S_COMPUTE 4 MAC | 4 MAC 同时各做 1 次乘加 |
| **4 个正在累计的输出点** | ✅ 4 个累加器并行 | 每拍更新 4 个部分和 |
| **4 个计算完成的最终系数/拍** | ❌ 未达到 | 每 N 拍完成 4 个最终系数 |
| **输出接口传输 4 个系数/拍** | ✅ V3.1 零气泡 | FIFO 排空预计算结果 |

**核心矛盾：** 计算核心每拍做 4 次乘加、更新 4 个部分和，但**每个最终系数需要 N 次乘加累加**。4 个最终系数要 N 拍才完成。输出接口的 4 系数/拍来自 FIFO 对预计算结果的排空，**不能作为第 4 项的证明**。

---

## 三、严格验收标准

若按题面严格解释，第 4 项要求：

> 经过流水线启动后，计算引擎**每拍产生 4 个新的、计算完成的变换系数**；
> 不能是同一组 4 个系数经过 N 拍才完成。

**当前设计不满足。** 证据：
- 组间隔 = 5N 周期（PREFETCH 4N + COMPUTE N），远非 1 拍
- 每 N 拍才完成一组 4 个最终系数
- 首组延迟 6N 周期

---

## 四、三种架构方案评估

### 方案 A：4N 乘法器直接并行矩阵乘法

| 项 | 评估 |
|----|---|
| 原理 | 每拍喂入 4 行 × N 列系数，4N 个 MAC 并行完成 4 个输出的完整乘加 |
| DCT2/DST7/DCT8 | ✅ 全尺寸支持（矩阵乘法通用） |
| **乘法器/DSP** | **4N 个**：N=64 需 **256 DSP**（xcku5p 有 1824，可用） |
| LUT 估算 | 控制 + 系数选通 ≈ 3000-5000 |
| BRAM 估算 | 系数存储 ≈ 16 BRAM（更宽读端口） |
| 500MHz | ✅ 16×16 DSP MAC 单周期可行；ROM 4N 宽读可行 |
| LFNST 配合 | 独立模块，16→16/48，可复用 |
| **真正 4 最终系数/拍** | ✅ 若 ROM 每拍供 4N 系数 |
| 面积/功耗影响 | **DSP 功耗 ~2.5W（现 0.012W），总面积约 4×** |
| 风险 | 面积大但数学直接，验证简单（对比 canonical golden） |

### 方案 B：VVC partial-butterfly / 快速变换

| 项 | 评估 |
|----|---|
| 原理 | DCT2 有递归蝶形结构（类似 FFT），乘法从 N² 降到 ~N·log2(N) |
| 乘法器/DSP | ~4×log2(N) ≈ **24-48**（N=64），远少于方案 A |
| 500MHz | ✅ 蝶形级是加/减 + 一次乘法 |
| DCT8/DST7 | ⚠️ DST7 有已知变换；DCT8 与 DCT2 相关；**但 VVC 整数矩阵非蝶形优化** |
| **真正 4 最终系数/拍** | 理论可行（流水蝶形稳态 4/拍） |
| 面积/功耗 | 最优（乘法器最少） |
| **风险** | **极高**：VVC 整数系数不能直接蝶形分解；与 canonical golden 逐元素一致是最大挑战；验证成本巨大 |
| 实现风险 | 每个变换类型独立蝶形；PNG 覆盖全尺寸难度大 |

### 方案 C：多 bank 系数 ROM + 多组交错向量流水线

| 项 | 评估 |
|----|---|
| 原理 | N 个 ROM bank 每拍供 N 系数；多组输出交错流水 |
| 乘法器/DSP | **仍是 4N**（每组 4 输出 × N 累加 = 4N MAC/拍） |
| ROM | N bank 宽读（比当前单口快 N 倍） |
| **真正 4 最终系数/拍** | ⚠️ 数学上仍需要 4N MAC/拍，**退化为方案 A** |
| 风险 | 中；改进了数据通路但没降低乘法器数 |
| 结论 | 是 A 的 ROM 优化版，不能独立达标 |

**关键结论：** 要在计算核心达到真正 4 最终系数/拍，必须维持 4N MAC/拍的吞吐。要么 4N 个 DSP（方案 A，N=64 需 256），要么蝶形分解（方案 B，约 24-48 乘法器但 VVC 整数矩阵兼容性风险极高）。

---

## 五、题面歧义评估

### 5.1 两种解释

1. **宽松解释**：每拍并行执行 4 个点的一次乘加（4 个部分和更新）
2. **严格解释**：每拍完成 4 个新的最终结果

### 5.2 支持宽松解释的证据

- 题面写 **"支持流水"**：流水线语义允许首拍延迟、稳态吞吐
- 题面同时写 **"追求面积和功耗最优"**：4N MAC 方案（N=64=256 DSP）违背面积最优
- "一拍计算四个点"在工程语境常指流水稳态吞吐

### 5.3 支持严格解释的证据

- "一拍计算四个点"字面含义是每拍 4 个点
- 输出接口确实每拍传输 4 个系数，评委可能据此认为计算也应达到

### 5.4 诚实结论

**不得自行假定宽松解释一定成立。** 当前实现：
- 计算核心：4 MAC/拍，**每 N 拍完成 4 个最终系数**（N=64 时 0.012 结果/拍）
- 输出接口：V3.1 后连续 4 系数/拍（来自 FIFO 排空）

若评委采用严格解释，当前计算核心不满足第 4 项。是否被接受取决于评委对"支持流水"的理解——**这是不确定的**。

---

## 六、后续决策路径

1. **维持现状**：功能正确 + 输出零气泡 + 500MHz。承担严格解释下第 4 项不达标的判断风险。
2. **方案 A（4N MAC）**：数学确定达标，面积/功耗增约 4×。可作为 V4 实现候选，但违反面积最优。
3. **方案 B（蝶形）**：面积最优但 VVC 整数矩阵兼容性风险极高，验证成本巨大。
4. **折中**：可先实现小尺寸（N≤8）的真 4 结果/拍，大尺寸保持共享引擎——部分达标。

**本报告仅为可行性审计，未修改任何 RTL。**
