hahayyf666-netizen/ITS_NEW/03_verification/vivado/clockInfo.txt

-------------------------------------
| Tool Version : Vivado v.2025.2
| Date         : Mon Sep  7 17:03:19 2026
| Host         : Finesse
| Design       : design_1
| Device       : xcku5p-ffvb676-2-E-
-------------------------------------

For more information on clockInfo.txt clock routing debug file see https://support.xilinx.com/s/article/000035660?language=en_US

***********************
Running Pre-CRP Checker
***********************
Number of global clocks: 1
	Number of BUFGCE: 1
	Number of BUFGCE_HDIO: 0
	Number of BUFG_CTRL: 0
	Number of BUFGCE_DIV: 0
	Number of BUFG_GT: 0
	Number of BUFG_PS: 0
	Number of BUFG_FABRIC: 0
	Running suboptimal placement checker for 1 clocks (and their loads) which do not have the CLOCK_LOW_FANOUT property but have a fanout less than 2000...
**************************************
Clock Nets/Source Overview (CRP Input)
**************************************
Clock 1: vector_buf_a[22][15]_i_1_n_0_bufg_place
	Clock source type: BUFGCE
	Clock source region: X0Y3
	Clock regions with locked loads: X2Y2 X2Y3 X3Y2 X3Y3 
	initial rect ((0, 2), (3, 3))

*****************************
Clocks With User Constraints:
*****************************
No clocks with user constraints found

***********************
Running Pre-CRP Checker
***********************
Number of global clocks: 1
	Number of BUFGCE: 1
	Number of BUFGCE_HDIO: 0
	Number of BUFG_CTRL: 0
	Number of BUFGCE_DIV: 0
	Number of BUFG_GT: 0
	Number of BUFG_PS: 0
	Number of BUFG_FABRIC: 0
	Running suboptimal placement checker for 1 clocks (and their loads) which do not have the CLOCK_LOW_FANOUT property but have a fanout less than 2000...
**************************************
Clock Nets/Source Overview (CRP Input)
**************************************
Clock 1: vector_buf_a[22][15]_i_1_n_0
	Clock source type: BUFGCE
	Clock source region: X0Y3
	Clock regions with locked loads: X2Y2 X2Y3 X3Y2 X3Y3 
	initial rect ((0, 2), (3, 3))

*****************************
Clocks With User Constraints:
*****************************
No clocks with user constraints found
