hahayyf666-netizen/ITS_NEW/05_audit/current/106_verification_hardening_20261104/snapshot/lint/LINT_DISPOSITION.md

# 综合告警处置台账（复核修正版）

范围：42009da 的生产设计；完整综合日志 full_synth.log 打印 166 W / 0 CW / 0 Error。完整综合新增 8-3917×11、8-3936×1；elaboration 不能代替完整综合。没有第三方 lint 交叉验证。

## 计数与状态

| 告警 | 日志打印数 | 当前处置 |
|---|---:|---|
| 8-7137 | 100 | 待解释；达到打印上限，真实实例数未统计 |
| 8-6014 | 45 | 待逐项分析；被移除不自动等于安全死代码 |
| 8-3917 | 11 | 常量驱动优化提示，需结合各端口用途解释，不代替功能证明 |
| 8-7129 | 7 | 未使用端口检查；需与生产顶层实际连接对应 |
| 8-4767 | 2 | RAM 实现方式提示，资源映射本身不证明数值正确 |
| 8-3936 | 1 | 待解释：s0_coeff_q_reg 4096→16 位 |

不能再写“154 条已豁免”：166 条中 100 条 set/reset 提示后还剩 66 条；此前 154 是另一份 elaboration 日志总数。100 是消息打印上限，不是全部问题实例数量。

## A1 ROM 相对路径与复现

仓库直接运行原 Tcl 时缺少默认 03_verification/sim ROM 的准备/检查，属于复现入口缺口。新的 prepare_physical_checkout.py 在独立目录构造包含脚本、RTL、约束、ROM 的完整输入，逐项核验历史物理 manifest 后才允许启动 Vivado。原仓库无需改动。

必须撤回“104 历史物理网表缺 ROM”：历史 physical_order_fix_fresh/vivado.log:127、134 明确记录两份 ROM read successfully。当前目录缺文件不能推导历史运行失败。新准备入口尚未执行新的布局布线，不产生新的物理通过结论。

## A2 input_mem set/reset

8-7137 保持 OPEN。get_cells 无匹配只能说明该查询没有提供有效证据，不能证明属性不存在或网表没有相应逻辑。RTL 无显式复位不能单独解释综合告警。下一步应检查有效 cell 属性、综合网表写使能/数据优先级，并以针对性综合后仿真或合适的等价检查补证。

撤回“门级总为0、RTL总为X、若有问题必然分叉、门级仿真是唯一结案手段”。具体初始化语义依赖模型与配置；有限向量无反例不是普遍证明。

## B3 被移除寄存器

fill_wr_cmd_addr_q/data_q/target_q 在非 SYNTHESIS 断言中确实被读取（wrapper:1602 起）；应描述为验证用途与生产路径的差异，不能称为无人读取。其余 45 条需逐项对应定义、使用者和优化原因；在完成前不作为批量安全豁免。

## C3 系数通路

撤回“DSP=320 已否证裁剪风险”和“确定是拆分占位名裁剪”。DSP 数量不能证明系数正确连接。保留资源报告作为旁证；关闭需要解释具体被裁剪位的用途、有效 lane/term 的系数来源，或提供有判别力的综合后功能证据。当前没有据此确认算错，也没有足够证据豁免。

## 可支持结论

综合完成、告警分类可追溯，未解释项仍 OPEN。不能宣称 lint 清零、物理网表功能已证明或整个项目功能闭环。official_equivalence=NOT_PROVEN。
