hahayyf666-netizen/ITS_NEW/05_audit/current/103_full_spatial_repair_20261029/performance/single_tu.csv

case | total_cycles | admission_cycles | input_span | compute_wait | output_span | scrub_cycles | v_cycles | h_cycles | lfnst_cycles | issue_cycles | legacy_mismatch_beats | full_mismatch_beats | first_bad_beat | actual | expected | output_gaps
0 | 1195 | 1026 | 1 | 165 | 4 | 1024 | 81 | 81 | 0 | 8 | 0 | 0 | -1 | 0000000000 | 0000000000 | 0
1 | 1210 | 1026 | 16 | 165 | 4 | 1024 | 81 | 81 | 0 | 8 | 0 | 0 | -1 | 0000000000 | 0000000000 | 0
2 | 1399 | 1026 | 1 | 357 | 16 | 1024 | 177 | 177 | 0 | 32 | 0 | 0 | -1 | 0000000000 | 0000000000 | 0
3 | 1462 | 1026 | 64 | 357 | 16 | 1024 | 177 | 177 | 0 | 32 | 0 | 0 | -1 | 0000000000 | 0000000000 | 0
4 | 1927 | 1026 | 1 | 837 | 64 | 1024 | 417 | 417 | 0 | 128 | 0 | 0 | -1 | 0000000000 | 0000000000 | 0
5 | 2182 | 1026 | 256 | 837 | 64 | 1024 | 417 | 417 | 0 | 128 | 0 | 0 | -1 | 0000000000 | 0000000000 | 0
6 | 3463 | 1026 | 1 | 2181 | 256 | 1024 | 1089 | 1089 | 0 | 512 | 0 | 0 | -1 | 0000000000 | 0000000000 | 0
7 | 4486 | 1026 | 1024 | 2181 | 256 | 1024 | 1089 | 1089 | 0 | 512 | 0 | 0 | -1 | 0000000000 | 0000000000 | 0
8 | 6087 | 1026 | 1 | 4037 | 1024 | 1024 | 1345 | 2689 | 0 | 1536 | 0 | 0 | -1 | 0000000000 | 0000000000 | 0
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
