hahayyf666-netizen/ITS_NEW/03_verification/output/r4b_pre_butterfly_audit/r4b_pre_butterfly_events.csv

event_id | level | phase | slot | destination | operation | even | odd | key
0 | 4 | 3 | 0 | 0 | add | {"kind": "dot", "id": 0} | {"kind": "dot", "id": 1} | 8384
1 | 4 | 3 | 1 | 5 | add | {"kind": "dot", "id": 2} | {"kind": "dot", "id": 3} | 8385
2 | 4 | 3 | 2 | 10 | sub | {"kind": "dot", "id": 2} | {"kind": "dot", "id": 3} | 8386
3 | 4 | 3 | 3 | 15 | sub | {"kind": "dot", "id": 0} | {"kind": "dot", "id": 1} | 8387
4 | 8 | 4 | 0 | 1 | add | {"kind": "signal", "id": 0} | {"kind": "dot", "id": 4} | 16640
5 | 8 | 4 | 1 | 6 | add | {"kind": "signal", "id": 5} | {"kind": "dot", "id": 5} | 16641
6 | 8 | 4 | 2 | 11 | add | {"kind": "signal", "id": 10} | {"kind": "dot", "id": 6} | 16642
7 | 8 | 4 | 3 | 16 | add | {"kind": "signal", "id": 15} | {"kind": "dot", "id": 7} | 16643
8 | 8 | 4 | 4 | 20 | sub | {"kind": "signal", "id": 15} | {"kind": "dot", "id": 7} | 16644
9 | 8 | 4 | 5 | 24 | sub | {"kind": "signal", "id": 10} | {"kind": "dot", "id": 6} | 16645
10 | 8 | 4 | 6 | 28 | sub | {"kind": "signal", "id": 5} | {"kind": "dot", "id": 5} | 16646
11 | 8 | 4 | 7 | 32 | sub | {"kind": "signal", "id": 0} | {"kind": "dot", "id": 4} | 16647
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
