hahayyf666-netizen/ITS_NEW/03_verification/output/r4c_pre_dsp_audit/dsp_properties.csv

index | cell | loc | AREG | BREG | MREG | PREG | ACASCREG | BCASCREG | ADREG | DREG | USE_MULT | CEM | CEMUX | CEP | CEPRED | RSTA | RSTB | RSTM | RSTP | CECTRL | CEAD | CEINMODE | IS_PRIMITIVE
1 | p_0_out | DSP48E2_X10Y44 | 0 | 0 | 0 | 0 | 0 | 0 | 1 | 1 | MULTIPLY |  |  |  |  |  |  |  |  |  |  |  | 1
2 | p_0_out__0 | DSP48E2_X10Y48 | 0 | 0 | 0 | 0 | 0 | 0 | 1 | 1 | MULTIPLY |  |  |  |  |  |  |  |  |  |  |  | 1
3 | p_0_out__0__0 | DSP48E2_X9Y36 | 0 | 0 | 0 | 0 | 0 | 0 | 1 | 1 | MULTIPLY |  |  |  |  |  |  |  |  |  |  |  | 1
4 | p_0_out__1 | DSP48E2_X11Y48 | 0 | 0 | 0 | 0 | 0 | 0 | 1 | 1 | MULTIPLY |  |  |  |  |  |  |  |  |  |  |  | 1
5 | p_0_out__10 | DSP48E2_X9Y37 | 0 | 0 | 0 | 0 | 0 | 0 | 1 | 1 | MULTIPLY |  |  |  |  |  |  |  |  |  |  |  | 1
6 | p_0_out__10__0 | DSP48E2_X10Y32 | 0 | 0 | 0 | 0 | 0 | 0 | 1 | 1 | MULTIPLY |  |  |  |  |  |  |  |  |  |  |  | 1
7 | p_0_out__11 | DSP48E2_X11Y34 | 0 | 0 | 0 | 0 | 0 | 0 | 1 | 1 | MULTIPLY |  |  |  |  |  |  |  |  |  |  |  | 1
8 | p_0_out__11__0 | DSP48E2_X7Y32 | 0 | 0 | 0 | 0 | 0 | 0 | 1 | 1 | MULTIPLY |  |  |  |  |  |  |  |  |  |  |  | 1
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
