hahayyf666-netizen/ITS_NEW/03_verification/output/r4c_pre_dsp_audit/failing_paths.csv

index | slack | delay | logic_levels | startpoint | endpoint
1 | -0.462 | 2.445 | 7 | operand_coeff_reg_reg[31][2]/C | lane_product_reg_reg[86][7]/D
2 | -0.461 | 2.444 | 7 | operand_coeff_reg_reg[31][2]/C | lane_product_reg_reg[86][11]/D
3 | -0.458 | 2.441 | 7 | operand_coeff_reg_reg[31][2]/C | lane_product_reg_reg[86][15]/D
4 | -0.453 | 2.435 | 7 | operand_x_reg_reg[28][8]/C | lane_product_reg_reg[60][14]/D
5 | -0.445 | 2.426 | 7 | operand_coeff_reg_reg[72][0]/C | lane_product_reg_reg[72][37]/D
6 | -0.442 | 2.422 | 7 | operand_coeff_reg_reg[72][0]/C | lane_product_reg_reg[72][16]/D
7 | -0.439 | 2.420 | 7 | operand_coeff_reg_reg[75][3]/C | lane_product_reg_reg[75][15]/D
8 | -0.434 | 2.417 | 7 | operand_coeff_reg_reg[31][2]/C | lane_product_reg_reg[86][36]/D
9 | -0.434 | 2.414 | 7 | operand_coeff_reg_reg[87][3]/C | lane_product_reg_reg[87][19]/D
10 | -0.433 | 2.414 | 7 | operand_x_reg_reg[53][2]/C | lane_product_reg_reg[53][14]/D
11 | -0.430 | 2.413 | 7 | operand_coeff_reg_reg[31][2]/C | lane_product_reg_reg[86][3]/D
12 | -0.428 | 2.409 | 7 | operand_coeff_reg_reg[65][7]/C | lane_product_reg_reg[65][13]/D
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
