hahayyf666-netizen/ITS_NEW/05_audit/current/103_full_spatial_repair_20261029/README.md

# 完整空间输出修复与验收

基于冻结提交081efa63356be60233b9f351409a4fd547142ec3。
本分支修正了垂直逆变换将输入系数支持范围用于空间输出范围的问题：64x64 DCT2仅输入DC512时，全部4096点应为16，原版后32行错误为0。

修复覆盖普通及LFNST路径的V输出组数、完整写回、最后提交标记和H读取范围，并同步修正两个Python模型。输入支持范围与完整空间输出尺寸分开处理。

验收：42项正向ModelSim仿真（normal/SYNTHESIS）通过，原冻结RTL由独立DC检查器检出；369原配置和129新增算例的293360个主变换输出与实际编译的VTM原函数一致。LFNST预处理使用单独核对的布局模型，这不是完整官方数值等价证明。

新的完整综合/布局布线起始WNS=-0.033ns；在相同2ns约束下进行路由后优化，最终setupWNS=0.000ns/TNS0、holdWHS=+0.004ns/THS0，失败端点均为0。43932条需布线网络全部完成，无未约束内部端点或有效时序例外。setup余量极小。范围限于寄存器边界，未验收封装I/O、外部复位到达和额外系统余量。

64x64连续DC测试完成间隔5059拍/TU；按500MHz折算404.823百万点/秒。此为无输出反压条件下的RTL仿真周期测量。

源码来自本地已验收副本，通过已在冻结原始文件上实际应用验证的补丁发布；远端提交保留081efa6的原始历史。局部文件仅有换行格式差异时，使用规范化SHA256说明等价；本地快照Git编号与远端提交编号不相同。

查看REPAIR_RESULT.json、FUNCTIONAL_QUALIFICATION.json及SOURCE_EQUIVALENCE.json。modelsim目录保留42项正向日志、四次编译日志和原版负向对照；physical目录提供明确标注的时序摘要摘录及完整路由/资源/约束/功耗报告。

复现从仓库根目录运行RUN_REPAIR.ps1，物理流程见POSTROUTE_TIMING.txt。DCP和更大的原始报告在本地交付包中保留SHA256身份；未把许可证、编译器或仿真工作库上传到仓库。

official_equivalence=NOT_PROVEN。工程修改与本次运行由Codex执行，不代表学习者独立掌握。
