hahayyf666-netizen/ITS_NEW/01_docs/history/赛题一工程修复方案_2026-08-02.md

# 华为赛题一 ITS 工程修复方案

工程路径：

```text
D:\Workspace\ITS_STUDY
```

附件规范：

```text
D:\Workspace\ITS_STUDY\华为附件.docx
```

本文档目标是把当前工程修正为一个**按附件规范可验证、数值功能正确、接口行为清晰、后续可继续优化吞吐和验证体系**的学习型工程。当前阶段不再围绕比赛提交结果做解释，而是按工程质量把问题逐项修透。

---

## 0. 总体原则

### 核心原则

不要一上来直接修改RTL。正确顺序是：

```text
先提取附件规范
-> 审计当前工程差异
-> 重建官方Golden
-> Golden站稳后修RTL
-> 再修协议/吞吐
-> 最后增强DPI-C、覆盖率、UVM和PPA
```

这样做的原因是：当前工程的问题不只是单个RTL bug，而是涉及：

- 主变换矩阵来源；
- `trType`编码；
- LFNST输入扫描；
- LFNST输出写回；
- ROM生成；
- Python Golden同源自证；
- 输出Ready/Valid语义；
- 输出阶段是否连续一拍4点。

如果这些同时改，一旦回归失败，很难定位问题来源。

---

## 1. 已确认的关键规范

### 1.1 主变换类型编码

附件规定：

```text
trType = 0：DCT-II
trType = 1：DST-VII
trType = 2：DCT-VIII
```

当前工程中多处使用的是：

```text
0：DCT2
1：DCT8
2：DST7
```

这很可能与附件相反，必须优先审计和修正。

### 1.2 主变换矩阵来源

附件给出了明确的整数 `transMatrix[m][n]`。因此主变换矩阵应以附件整数矩阵为规范来源，不应继续只用三角函数公式重新生成：

```python
round(cos(...))
round(sin(...))
```

不能假设公式生成值与附件整数矩阵完全等价。是否存在数值差异、差异数量和最大差值，必须由`diff_current_vs_attachment_matrices.py`逐元素比较后确认；在diff完成前，不在本文档中预先断言某个具体矩阵元素。

### 1.3 LFNST输入扫描

附件图示给出的LFNST输入4x4编号为：

```text
0  2  5  9
1  4  8 12
3  7 11 14
6 10 13 15
```

对应输入向量顺序：

```text
00,10,01,20,11,02,30,21,12,03,31,22,13,32,23,33
```

### 1.4 LFNST输出写回

附件图示显示：LFNST输出不是按同一低频对角扫描写回，而是按指定区域内光栅顺序写回。

`nTrs=16`输出区域：

```text
 0  1  2  3
 4  5  6  7
 8  9 10 11
12 13 14 15
```

`nTrs=48`输出区域：

```text
 0  1  2  3   4  5  6  7
 8  9 10 11  12 13 14 15
16 17 18 19  20 21 22 23
24 25 26 27  28 29 30 31
32 33 34 35
36 37 38 39
40 41 42 43
44 45 46 47
```

即：

- `nTrs=16`：左上4x4行优先写回；
- `nTrs=48`：上方4x8行优先编号0..31，左下4x4行优先编号32..47。

---

## 2. 推荐版本节奏

### V1：官方Golden与差异审计

目标：**不动RTL**，先确认规范和当前工程差异。

### V2：RTL功能修复

目标：在Golden稳定后，修正ROM、`trType`、LFNST扫描和overlay映射。

### V3：协议与输出吞吐（可选后续阶段）

目标：在V2功能正确且回归稳定后，确认题面`req/vld`语义，再决定是否修输出协议和无气泡一拍4点。V3不是`corrected_functional`版本的必要验收条件。

### V4：工程增强

目标：加入DPI-C、覆盖率、可选UVM、Vivado PPA和报告更新。

---

# V1：官方Golden与差异审计

## 3. 第一步：提取附件矩阵

### 新增脚本

```text
D:\Workspace\ITS_STUDY\03_verification\scripts\extract_attachment_matrices.py
```

### 输入

```text
D:\Workspace\ITS_STUDY\华为附件.docx
```

### 输出

```text
D:\Workspace\ITS_STUDY\03_verification\output\attachment_matrices.json
```

### JSON建议结构

```json
{
  "transforms": {
    "0": {
      "name": "DCT2",
      "sizes": {
        "4": [],
        "8": [],
        "16": [],
        "32": [],
        "64": []
      }
    },
    "1": {
      "name": "DST7",
      "sizes": {
        "4": [],
        "8": [],
        "16": [],
        "32": []
      }
    },
    "2": {
      "name": "DCT8",
      "sizes": {
        "4": [],
        "8": [],
        "16": [],
        "32": []
      }
    }
  },
  "lfnst": {
    "16": {
      "0": {"1": [], "2": []},
      "1": {"1": [], "2": []},
      "2": {"1": [], "2": []},
      "3": {"1": [], "2": []}
    },
    "48": {
      "0": {"1": [], "2": []},
      "1": {"1": [], "2": []},
      "2": {"1": [], "2": []},
      "3": {"1": [], "2": []}
    }
  }
}
```

### 提取注意事项

- Word中负号可能是Unicode minus：`−`，需要统一转成ASCII `-`。
- 附件中DCT2 64点矩阵可能分块描述，如`Col0to15`、`Col16to31`，还包含对称生成规则，需要正确展开为完整64x64。
- DCT/DST/DCT8的32点矩阵也可能分块给出，需要展开为完整矩阵。
- LFNST `nTrs=48`由三个16x16块组合为48x16矩阵，组合顺序必须按附件文字。

---

## 4. 第二步：矩阵完整性审计

### 新增脚本

```text
D:\Workspace\ITS_STUDY\03_verification\scripts\audit_matrices.py
```

### 审计内容

检查：

```text
DCT2: 4x4, 8x8, 16x16, 32x32, 64x64
DST7: 4x4, 8x8, 16x16, 32x32
DCT8: 4x4, 8x8, 16x16, 32x32
LFNST nTrs=16: 8个16x16矩阵
LFNST nTrs=48: 8个48x16矩阵
```

必须输出：

- 每个矩阵的维度；
- 最大值、最小值；
- 是否存在非整数；
- 是否存在缺失行或缺失列；
- `trType=1`是否为DST7；
- `trType=2`是否为DCT8。

### 验收标准

```text
audit_matrices.py PASS
```

若不能PASS，不能继续修改RTL。

---

## 5. 第三步：当前工程与附件矩阵diff

### 新增脚本

```text
D:\Workspace\ITS_STUDY\03_verification\scripts\diff_current_vs_attachment_matrices.py
```

### 对比对象

至少对比：

1. 当前`gen_rom_coeffs.py`公式生成矩阵 vs `attachment_matrices.json`；
2. 当前`rom_coeffs.hex`反解矩阵 vs `attachment_matrices.json`；
3. 当前`lfnst_coeffs.hex`反解矩阵 vs `attachment_matrices.json`。

### 输出内容

建议输出：

```text
matrix name
size
element count
diff count
max abs diff
first 20 mismatches
```

### 目的

先证明：

- 当前公式矩阵和附件差多少；
- 当前`trType=1/2`是否整体反了；
- LFNST矩阵是否正确；
- 是ROM内容错、Python模型错，还是仅命名错。

还必须审计矩阵方向，不能默认使用`T*x`或`T^T*x`：

- 附件中的`transMatrix[m][n]`里，`m`到底表示输入索引还是输出索引；
- 当RTL地址为`row * size + col`时，`row`对应输入点还是输出点；
- `its_transform_engine.v`中现有的`T^T * x`注释是否与实际实现一致；
- 用一热输入和附件矩阵的行/列对比，确认最终使用的是`T*x`还是`T^T*x`。

在矩阵方向确认前，不能只根据当前RTL和当前Python Golden的一致性判断正确，因为二者可能共享同一个转置错误。

---

## 6. 第四步：重建Python Golden

### 文件

```text
D:\Workspace\ITS_STUDY\03_verification\scripts\ref_model.py
```

### 修改要求

不要再通过公式生成主变换矩阵。改成从：

```text
03_verification\output\attachment_matrices.json
```

读取。

### 主变换映射

```python
trType = 0 -> DCT2
trType = 1 -> DST7
trType = 2 -> DCT8
```

上述映射是附件定义的目标映射。在V1阶段只修改Python Golden，不立即修改RTL；必须先由矩阵diff和一热测试确认当前工程的实际编码与附件编码差异。

### LFNST输入扫描

```python
LFNST_INPUT_SCAN_4x4 = [
    (0,0), (1,0), (0,1), (2,0),
    (1,1), (0,2), (3,0), (2,1),
    (1,2), (0,3), (3,1), (2,2),
    (1,3), (3,2), (2,3), (3,3),
]
```

### LFNST输出写回

`nTrs=16`：

```python
LFNST_OUTPUT_SCAN_16 = [
    (0,0), (0,1), (0,2), (0,3),
    (1,0), (1,1), (1,2), (1,3),
    (2,0), (2,1), (2,2), (2,3),
    (3,0), (3,1), (3,2), (3,3),
]
```

`nTrs=48`：

```python
LFNST_OUTPUT_SCAN_48 = [
    (0,0), (0,1), (0,2), (0,3), (0,4), (0,5), (0,6), (0,7),
    (1,0), (1,1), (1,2), (1,3), (1,4), (1,5), (1,6), (1,7),
    (2,0), (2,1), (2,2), (2,3), (2,4), (2,5), (2,6), (2,7),
    (3,0), (3,1), (3,2), (3,3), (3,4), (3,5), (3,6), (3,7),
    (4,0), (4,1), (4,2), (4,3),
    (5,0), (5,1), (5,2), (5,3),
    (6,0), (6,1), (6,2), (6,3),
    (7,0), (7,1), (7,2), (7,3),
]
```

### 删除错误注释

当前`ref_model.py`如果写了“LFNST输入输出都用同一对角扫描”，必须删除或改正。

---

## 7. 第五步：Golden一热测试

### 新增脚本

```text
D:\Workspace\ITS_STUDY\03_verification\scripts\test_ref_model_onehot.py
```

### 主变换一热

对每个：

```text
DCT2: 4/8/16/32/64
DST7: 4/8/16/32
DCT8: 4/8/16/32
```

测试输入向量：

```text
x[k] = 1，其余为0
```

用于确认：

- 矩阵行列方向是否正确；
- `T*x`还是`T^T*x`；
- `trType`映射是否正确。

### LFNST一热

对每个：

```text
nTrs=16/48
setIdx=0/1/2/3
lfnst_idx=1/2
```

测试16个输入位置一热。

用于确认：

- 输入扫描顺序；
- 矩阵方向；
- 输出写回位置；
- nTrs=48区域编号。

### V1验收标准

```text
attachment_matrices.json生成成功
audit_matrices.py PASS
diff_current_vs_attachment_matrices.py生成差异报告
ref_model.py使用附件矩阵
test_ref_model_onehot.py PASS
```

V1完成前不要动RTL。

---

# V2：RTL功能修复

## 8. 第六步：修ROM生成脚本

### 文件

```text
D:\Workspace\ITS_STUDY\03_verification\scripts\gen_rom_coeffs.py
```

### 修改要求

从：

```text
03_verification\output\attachment_matrices.json
```

生成：

```text
D:\Workspace\ITS_STUDY\02_rtl\rtl\rom_coeffs.hex
D:\Workspace\ITS_STUDY\02_rtl\rtl\lfnst_coeffs.hex
```

不要再用三角函数公式作为最终ROM来源。

### ROM顺序

```text
trType=0 DCT2
trType=1 DST7
trType=2 DCT8
```

### ROM布局原子变更约束

以下内容必须在同一次变更中同步修改和验证，不能只改其中一部分：

- `attachment_matrices.json`中的类型编号；
- `gen_rom_coeffs.py`的类型遍历顺序；
- `rom_coeffs.hex`的生成布局；
- `its_rom.v`的地址解释；
- `its_transform_engine.v`或相关模块中的`base_addr` case；
- Python Golden、测试向量和测试名称。

否则会出现JSON已经是`0=DCT2、1=DST7、2=DCT8`，而RTL ROM base address仍按旧的`1=DCT8、2=DST7`解释的情况。建议在该原子变更前后分别保存ROM地址映射表，并用脚本逐项审计。

### 审计脚本

新增：

```text
D:\Workspace\ITS_STUDY\03_verification\scripts\audit_rom_hex.py
```

检查：

- `rom_coeffs.hex`逐元素等于附件JSON；
- `lfnst_coeffs.hex`逐元素等于附件JSON；
- 负数按16-bit补码写入；
- RTL地址范围与脚本一致。

---

## 9. 第七步：修LFNST RTL输入扫描

### 文件

```text
D:\Workspace\ITS_STUDY\02_rtl\rtl\its_core_500.v
```

### 当前错误

```verilog
wire [1:0] lfnst_rd_row = lfnst_rd_addr[3:2];
wire [1:0] lfnst_rd_col = lfnst_rd_addr[1:0];
```

这是行优先扫描，和附件输入扫描不一致。

### 修改为case映射

```verilog
reg [1:0] lfnst_rd_row_r;
reg [1:0] lfnst_rd_col_r;

always @(*) begin
    case (lfnst_rd_addr[3:0])
        4'd0:  begin lfnst_rd_row_r = 2'd0; lfnst_rd_col_r = 2'd0; end
        4'd1:  begin lfnst_rd_row_r = 2'd1; lfnst_rd_col_r = 2'd0; end
        4'd2:  begin lfnst_rd_row_r = 2'd0; lfnst_rd_col_r = 2'd1; end
        4'd3:  begin lfnst_rd_row_r = 2'd2; lfnst_rd_col_r = 2'd0; end
        4'd4:  begin lfnst_rd_row_r = 2'd1; lfnst_rd_col_r = 2'd1; end
        4'd5:  begin lfnst_rd_row_r = 2'd0; lfnst_rd_col_r = 2'd2; end
        4'd6:  begin lfnst_rd_row_r = 2'd3; lfnst_rd_col_r = 2'd0; end
        4'd7:  begin lfnst_rd_row_r = 2'd2; lfnst_rd_col_r = 2'd1; end
        4'd8:  begin lfnst_rd_row_r = 2'd1; lfnst_rd_col_r = 2'd2; end
        4'd9:  begin lfnst_rd_row_r = 2'd0; lfnst_rd_col_r = 2'd3; end
        4'd10: begin lfnst_rd_row_r = 2'd3; lfnst_rd_col_r = 2'd1; end
        4'd11: begin lfnst_rd_row_r = 2'd2; lfnst_rd_col_r = 2'd2; end
        4'd12: begin lfnst_rd_row_r = 2'd1; lfnst_rd_col_r = 2'd3; end
        4'd13: begin lfnst_rd_row_r = 2'd3; lfnst_rd_col_r = 2'd2; end
        4'd14: begin lfnst_rd_row_r = 2'd2; lfnst_rd_col_r = 2'd3; end
        4'd15: begin lfnst_rd_row_r = 2'd3; lfnst_rd_col_r = 2'd3; end
        default: begin lfnst_rd_row_r = 2'd0; lfnst_rd_col_r = 2'd0; end
    endcase
end

wire [1:0] lfnst_rd_row = lfnst_rd_row_r;
wire [1:0] lfnst_rd_col = lfnst_rd_col_r;
```

---

## 10. 第八步：修LFNST RTL输出overlay索引

### 文件

```text
D:\Workspace\ITS_STUDY\02_rtl\rtl\its_core_500.v
```

### 当前问题

当前`nTrs=48`把输出拆成三个4x4块编号：

```text
blk0: 0..15
blk1: 16..31
blk2: 32..47
```

但附件规定是：

```text
上方4x8整体行优先: 0..31
左下4x4行优先: 32..47
```

### 修改目标

`nTrs=16`：

```verilog
idx = row * 4 + col
```

`nTrs=48`：

```verilog
if row < 4 and col < 8:
    idx = row * 8 + col
else if row >= 4 and row < 8 and col < 4:
    idx = 32 + (row - 4) * 4 + col
```

### 建议实现

```verilog
wire overlay_top_48 = lfnst_ntrs_is_48 &&
                      (over_row < 7'd4) &&
                      (over_col < 7'd8);

wire overlay_bot_48 = lfnst_ntrs_is_48 &&
                      (over_row >= 7'd4) &&
                      (over_row < 7'd8) &&
                      (over_col < 7'd4);

wire [5:0] overlay_idx_48_top =
    {over_row[2:0], 3'b000} + {3'b000, over_col[2:0]};

wire [5:0] overlay_idx_48_bot =
    6'd32 + {over_row[1:0], 2'b00} + {4'b0000, over_col[1:0]};

wire [5:0] overlay_idx_ntrs48 =
    overlay_top_48 ? overlay_idx_48_top :
    overlay_bot_48 ? overlay_idx_48_bot :
    6'd0;

wire overlay_hit_48 = lfnst_active && (overlay_top_48 || overlay_bot_48);
```

---

## 11. 第九步：修测试向量与测试调用

### 需要同步修改

```text
D:\Workspace\ITS_STUDY\03_verification\tb\its_tb_500.v
D:\Workspace\ITS_STUDY\03_verification\tb\its_core_500_tb.v
D:\Workspace\ITS_STUDY\03_verification\tb\test_vectors\*.hex
D:\Workspace\ITS_STUDY\03_verification\tb\regression_tests.vh
```

### 重点

- 所有`dst7_*`测试必须传`trType=1`；
- 所有`dct8_*`测试必须传`trType=2`；
- 测试向量必须由新的官方Golden重新生成；
- 旧的同源Golden不能继续作为正确性依据。

### V2验收标准

```text
audit_rom_hex.py PASS
主变换一热RTL测试 PASS
LFNST一热RTL测试 PASS
Core仿真 PASS
Top仿真 PASS
500MHz singleclk仿真 PASS
输出数值逐点匹配官方Golden
```

---

# V3：协议与输出吞吐

## 12. 第十步：先确认题面req/vld语义

在修改`Ready/Valid`之前，必须回看正式题目和接口表，确认：

```text
it_data_out_req=0时，it_data_out_vld是否允许为1？
it_data_out_vld表示“数据可用”，还是表示“本拍实际传输”？
```

### 两种可能

#### 情况A：标准Ready/Valid语义

```text
valid = 生产者有数据
ready/req = 消费者可接收
fire = valid && ready
```

此时应改为：

```verilog
assign it_data_out_vld   = ~output_fifo_empty && ~front_done;
assign output_fifo_rd_en = it_data_out_vld && it_data_out_req;
```

#### 情况B：题面要求req=1才允许vld拉高

如果题面明确要求：

```text
it_data_out_req=0时，it_data_out_vld必须为0
```

则不要直接改成AXI-style。外部接口可保持：

```text
req=0时vld=0
```

但内部必须保证：

- 待输出数据不丢；
- `req`重新拉高后继续输出正确beat；
- 不重复；
- 不跳点；
- 不乱序；
- `it_done`不早于最后一拍真实输出。

---

## 13. 第十一步：可选优化：修输出无气泡一拍4点

这一节属于V3可选优化，不阻塞V2功能正确性验收。只有在题面明确要求无反压时连续每拍输出一组4点，或者希望单独建立高吞吐接口版本时，才进入本节。

### 文件

```text
D:\Workspace\ITS_STUDY\02_rtl\rtl\its_core_500.v
```

### 当前问题

当前输出阶段大致是：

```text
第1拍：读out_mem 4点
第2拍：写output_fifo 4点
第3拍：读out_mem 4点
第4拍：写output_fifo 4点
```

所以无反压时平均只有2点/拍。

### 目标

进入输出阶段后，无反压时：

```text
第1拍：装载第0组
第2拍：写第0组，同时装载第1组
第3拍：写第1组，同时装载第2组
...
```

即首拍允许启动延迟，但稳态每拍输出40bit。

### 修改思路

允许同拍：

```text
write_fire当前组
out_read_en下一组
```

典型逻辑：

```verilog
wire write_fire = out_valid_pipe && !output_fifo_full;
wire out_pipe_ready = !out_valid_pipe || write_fire;
wire out_read_en = (state == S_OUT) && out_pipe_ready && !out_pipe_flush;
```

但不能只改这一行，还必须同步修改：

- `out_cnt`语义；
- 末拍检测；
- `out_pipe_flush`；
- `out_done`；
- 反压保持；
- 最后一组输出后`it_done`时序。

### 验收断言

```text
expected_beats = total_points / 4
actual_output_handshake_beats == expected_beats
```

无反压时：

```text
首个valid出现后，直到TU最后一拍，中间不能有气泡。
```

每拍内容：

```text
beat 0 -> raster 0,1,2,3
beat 1 -> raster 4,5,6,7
beat 2 -> raster 8,9,10,11
...
```

---

## 14. 第十二步：协议和吞吐断言

### 建议新增

```text
D:\Workspace\ITS_STUDY\03_verification\tb\protocol_assertions.sv
D:\Workspace\ITS_STUDY\03_verification\tb\throughput_assertions.sv
```

### 输出侧断言

如果采用标准Ready/Valid：

```systemverilog
assert property (@(posedge clk) disable iff(!rst_n)
    it_data_out_vld && !it_data_out_req |=> 
    it_data_out_vld && $stable(it_data_out)
);
```

如果采用题面`req=0则vld=0`语义，则断言应改为：

```text
req=0期间内部pending beat保持稳定；
req恢复后输出的第一个beat仍是暂停前应输出的beat。
```

---

# V4：工程增强

## 15. 第十三步：DPI-C参考模型

V1和V2稳定后再做DPI-C；V3是否完成不应阻塞DPI-C、coverage等增强工作。增强验证仍然不能替代V1/V2的功能修复。

### 建议新增

```text
D:\Workspace\ITS_STUDY\03_verification\dpi\its_ref_model.c
D:\Workspace\ITS_STUDY\03_verification\dpi\its_ref_model.h
```

### DPI接口建议

```c
void its_ref_compute(
    int width,
    int height,
    int tr_hor,
    int tr_ver,
    int lfnst_set_idx,
    int lfnst_idx,
    const short* sparse_addr,
    const short* sparse_data,
    int sparse_count,
    short* output
);
```

### 注意

DPI-C模型可以使用由`attachment_matrices.json`生成的C数组，但控制流程和扫描逻辑应独立实现，不要照抄RTL状态机。

---

## 16. 第十四步：功能覆盖率

覆盖点建议：

```text
tr_type_hor: 0/1/2
tr_type_ver: 0/1/2
size_width: 4/8/16/32/64
size_height: 4/8/16/32/64
lfnst_idx: 0/1/2
lfnst_set_idx: 0/1/2/3
nTrs: 16/48
input_density: zero/single/sparse/dense
end_mode: same_cycle/separate_cycle
output_backpressure: none/random/burst
```

交叉覆盖：

```text
tr_type_hor × width
tr_type_ver × height
LFNST × nTrs × setIdx × idx
width × height
backpressure × output_length
```

---

## 17. 第十五步：UVM

UVM放最后，不要在第一轮修功能时引入。

如果后续要加，建议结构：

```text
its_transaction
its_sequencer
its_driver
its_monitor
its_scoreboard
its_coverage
```

UVM重点用于：

- 随机TU；
- 随机稀疏输入；
- 随机反压；
- 自动scoreboard比对；
- coverage收敛。

---

## 18. 第十六步：Vivado实现和PPA

功能修复、协议修复后，再重新跑：

```text
synthesis
implementation
timing
utilization
power
```

输出目录不要覆盖旧结果：

```text
D:\Workspace\ITS_STUDY\02_rtl\synth_corrected
```

记录：

```text
FPGA型号
Vivado版本
约束文件
WNS/WHS
LUT
FF
BRAM
DSP
Power
功耗置信度
是否使用SAIF/VCD
```

---

## 19. 第十七步：文档更新

报告必须更新：

1. 附件矩阵是唯一规范源；
2. `trType=0 DCT2, 1 DST7, 2 DCT8`；
3. LFNST输入为低频对角扫描；
4. LFNST输出为附件图示区域光栅写回；
5. `nTrs=16/48`选择规则；
6. 输出接口一拍4点；
7. `req/vld`采用的题面解释；
8. 当前计算核心吞吐与输出接口吞吐的区别；
9. 如果未重构内部计算核心，不要声称“每拍完成4个完整计算结果”；
10. 验证用例、覆盖率、DPI-C和回归结果。

---

## 20. 最终推荐执行顺序

```text
0. 备份当前工程或建Git分支
1. 提取附件矩阵 -> attachment_matrices.json
2. audit_matrices.py 完整性审计
3. diff_current_vs_attachment_matrices.py 差异报告
4. 修改 ref_model.py 使用附件矩阵
5. 修正 Python Golden 的 trType 映射
6. 修正 Python Golden 的 LFNST 输入/输出映射
7. 跑 Golden 一热测试
8. 修改 gen_rom_coeffs.py 从附件JSON生成ROM
9. audit_rom_hex.py 校验hex
10. 修RTL trType/ROM注释和映射
11. 修RTL LFNST输入扫描
12. 修RTL LFNST overlay输出索引
13. 重生成全部测试向量
14. 跑主变换与LFNST定向回归
15. 跑完整Core/Top/500MHz回归
16. 回看题面req/vld语义（V3，可选后置）
17. 在不违背题面语义前提下修输出协议（V3，可选后置）
18. 修输出无气泡一拍4点（V3，可选优化，不阻塞V2验收）
19. 加协议/吞吐断言（V3/V4，后置增强）
20. 加DPI-C（V4，后置增强）
21. 加功能覆盖率（V4，后置增强）
22. 可选UVM（V4，后置增强）
23. 重新跑Vivado PPA（V4，后置增强）
24. 更新报告（V1/V2结论稳定后分阶段更新）
```

---

## 21. 本轮暂不建议做的事情

暂时不要重构严格“内部计算每拍完成4个完整结果”的高吞吐架构。

原因：

- 这需要重写`its_transform_engine.v`；
- 可能需要蝶形分解、多bank缓存、多MAC阵列；
- 会显著改变资源、时序和验证范围；
- 会干扰当前功能修复定位。

建议等`corrected_functional`版本稳定后，另开：

```text
high_throughput_transform
```

专门研究：

- DCT2快速蝶形；
- DST7/DCT8快速分解或矩阵流水；
- 多bank转置缓存；
- 每拍4个完整结果点；
- 新PPA权衡。

---

## 22. 判断标准

完成本方案后，工程应能回答以下问题：

1. 每个矩阵元素是否来自附件？
2. `trType=1`是否确实是DST7？
3. `trType=2`是否确实是DCT8？
4. LFNST输入扫描是否与附件图一致？
5. LFNST输出写回是否与附件图一致？
6. Python Golden是否独立于RTL？
7. RTL输出是否逐点匹配官方Golden？
8. 输出接口是否按题面语义支持反压？
9. 无反压时是否连续一拍4点？
10. 每个TU输出beat数是否正确？
11. Vivado 500MHz是否仍收敛？
12. PPA是否有可复现实验记录？

这些问题都能明确回答后，这个工程才算真正完成了“功能完善和正确”的目标。
