hahayyf666-netizen/ITS_NEW/02_rtl/rtl/unified_its_wrapper.sv

// Step12E unified engineering-profile functional wrapper.
//
// This is a new functional engineering implementation.  It deliberately
// lives beside, rather than inside, the frozen v3.5-18 wrapper/R4C.  LFNST
// cases use the bounded LFNST engine followed by the integrated four-slot P4
// kernel, while LFNST-off primary cases use the P4 kernel directly.  The
// wrapper still exposes the descriptor, sparse-raster, ownership and output
// protocol contracts needed by Gate C before physical implementation.
//
// It is not a 500 MHz implementation claim.  Synthesis/physical optimisation
// is a later step for this new unified path.

module unified_its_wrapper #(
    parameter integer DATA_W = 16,
    parameter integer OUT_W  = 10,
    parameter integer MAX_POINTS = 4096,
    parameter integer COEFF_DEPTH = 8176,
    parameter integer LFNST_DEPTH = 8192,
    // SAT10 is the selected v2 engineering profile.  The final submission
    // top must still override this explicitly; LOW10 remains available only
    // through the preserved v1 profile/legacy adapter configuration.
    parameter integer FINAL_SATURATE = 1,
    parameter string COEFF_FILE = "03_verification/sim/rom_coeffs.hex",
    parameter string LFNST_FILE = "03_verification/sim/lfnst_coeffs.hex",
    parameter string LFNST_PACKED_FILE = "03_verification/sim/lfnst_packed_coeffs.hex"
) (
    input  logic                         clk,
    input  logic                         rst_n,
    input  logic [21:0]                  it_info,
    input  logic                         it_info_vld,
    input  logic signed [DATA_W-1:0]     it_data_in,
    input  logic [11:0]                  it_data_addr,
    input  logic                         it_data_in_vld,
    input  logic                         it_data_end,
    output logic                         it_data_in_req,
    input  logic                         it_data_out_req,
    output logic [39:0]                  it_data_out,
    output logic                         it_data_out_vld,
    output logic                         it_done,
    output logic                         protocol_error
);

    localparam logic [2:0] SLOT_FREE  = 3'd0;
    localparam logic [2:0] SLOT_FILL  = 3'd1;
    localparam logic [2:0] SLOT_READY = 3'd2;
    localparam logic [2:0] SLOT_OUT   = 3'd3;
    localparam logic [2:0] SLOT_SCRUB = 3'd4;
    localparam integer INPUT_VALID_WORDS = MAX_POINTS / 4;
    localparam integer BANK_DEPTH = (MAX_POINTS + 3) / 4;
    localparam integer BANK_ADDR_W = (BANK_DEPTH <= 1) ? 1 : $clog2(BANK_DEPTH);

    // Two independent ownership slots.  Logical raster addresses are mapped
    // to four fixed physical banks.  Each bank has one explicit write port;
    // validity is scrubbed independently of stale data, so no 4096-entry
    // reset or multi-address memory assignment remains in the wrapper.
    logic [BANK_ADDR_W-1:0] input_rd_addr [0:1][0:3];
    logic signed [DATA_W-1:0] input_rd_data [0:1][0:3];
    logic input_rd_valid [0:1][0:3];
    logic input_data_wr_en [0:1][0:3];
    logic [BANK_ADDR_W-1:0] input_data_wr_addr [0:1][0:3];
    logic [DATA_W-1:0] input_data_wr_data [0:1][0:3];
    logic input_valid_wr_en [0:1][0:3];
    logic [BANK_ADDR_W-1:0] input_valid_wr_addr [0:1][0:3];
    logic input_valid_wr_data [0:1][0:3];

    // P9 round 3: sparse-fill writes cross an atomic elastic command
    // boundary before reaching the distributed input-cache write ports.  A
    // command represents one accepted nonzero point and owns exactly one
    // physical slot/bank target; data and validity are committed together.
    logic        fill_wr_cmd_valid_q;
    logic [3:0]  fill_wr_cmd_target_q [0:1];
    logic [BANK_ADDR_W-1:0] fill_wr_cmd_addr_q;
    logic [DATA_W-1:0]      fill_wr_cmd_data_q;
    logic        fill_wr_cmd_ready;
    logic        fill_wr_cmd_commit;
    logic [3:0]  fill_wr_cmd_target_c [0:1];
    logic [BANK_ADDR_W-1:0] fill_wr_cmd_addr_c;
    logic [DATA_W-1:0]      fill_wr_cmd_data_c;
    // R6 candidate: keep the accepted command logically atomic, but replicate
    // its physical payload at each slot/bank boundary.  The memory ports below
    // are driven only by these local registers; the global command remains for
    // lifecycle/equivalence bookkeeping and never fans out to a RAM port.
    (* keep = "true", equivalent_register_removal = "no" *)
    logic [BANK_ADDR_W-1:0] fill_wr_bank_addr_q [0:1][0:3];
    (* keep = "true", equivalent_register_removal = "no" *)
    logic [DATA_W-1:0] fill_wr_bank_data_q [0:1][0:3];
    (* keep = "true", equivalent_register_removal = "no" *)
    logic fill_wr_bank_target_q [0:1][0:3];
    logic [7:0] fill_wr_bank_target_flat;
    assign fill_wr_bank_target_flat = {
        fill_wr_bank_target_q[1][3], fill_wr_bank_target_q[1][2],
        fill_wr_bank_target_q[1][1], fill_wr_bank_target_q[1][0],
        fill_wr_bank_target_q[0][3], fill_wr_bank_target_q[0][2],
        fill_wr_bank_target_q[0][1], fill_wr_bank_target_q[0][0]
    };
    logic        fill_end_pending_q;
    logic        fill_end_slot_q;
    integer fill_cmd_row_i, fill_cmd_col_i, fill_cmd_bank_i, fill_cmd_local_i;

    logic [BANK_ADDR_W-1:0] result_rd_addr [0:1][0:3];
    logic signed [OUT_W-1:0] result_rd_data [0:1][0:3];
    logic result_wr_en [0:1][0:3];
    logic [BANK_ADDR_W-1:0] result_wr_addr [0:1][0:3];
    logic [OUT_W-1:0] result_wr_data [0:1][0:3];

    logic [BANK_ADDR_W-1:0] tmp_rd_addr [0:3];
    logic signed [15:0] tmp_rd_data [0:3];
    logic tmp_wr_en [0:3];
    logic [BANK_ADDR_W-1:0] tmp_wr_addr [0:3];
    logic signed [15:0] tmp_wr_data [0:3];

    genvar mem_slot_g, mem_bank_g;
    generate
        for (mem_slot_g = 0; mem_slot_g < 2; mem_slot_g = mem_slot_g + 1) begin : gen_input_slots
            for (mem_bank_g = 0; mem_bank_g < 4; mem_bank_g = mem_bank_g + 1) begin : gen_input_banks
                its_input_cache_bank #(
                    .DATA_W(DATA_W), .DEPTH(BANK_DEPTH), .ADDR_W(BANK_ADDR_W)
                ) u_input_cache_bank (
                    .clk(clk),
                    .data_wr_en(input_data_wr_en[mem_slot_g][mem_bank_g]),
                    .data_wr_addr(input_data_wr_addr[mem_slot_g][mem_bank_g]),
                    .data_wr_data(input_data_wr_data[mem_slot_g][mem_bank_g]),
                    .valid_wr_en(input_valid_wr_en[mem_slot_g][mem_bank_g]),
                    .valid_wr_addr(input_valid_wr_addr[mem_slot_g][mem_bank_g]),
                    .valid_wr_data(input_valid_wr_data[mem_slot_g][mem_bank_g]),
                    .rd_addr(input_rd_addr[mem_slot_g][mem_bank_g]),
                    .rd_data(input_rd_data[mem_slot_g][mem_bank_g]),
                    .rd_valid(input_rd_valid[mem_slot_g][mem_bank_g])
                );
            end
        end
    endgenerate

    generate
        for (mem_slot_g = 0; mem_slot_g < 2; mem_slot_g = mem_slot_g + 1) begin : gen_result_slots
            for (mem_bank_g = 0; mem_bank_g < 4; mem_bank_g = mem_bank_g + 1) begin : gen_result_banks
                its_simple_ram #(
                    .DATA_W(OUT_W), .DEPTH(BANK_DEPTH), .ADDR_W(BANK_ADDR_W)
                ) u_result_bank (
                    .clk(clk),
                    .wr_en(result_wr_en[mem_slot_g][mem_bank_g]),
                    .wr_addr(result_wr_addr[mem_slot_g][mem_bank_g]),
                    .wr_data(result_wr_data[mem_slot_g][mem_bank_g]),
                    .rd_addr(result_rd_addr[mem_slot_g][mem_bank_g]),
                    .rd_data(result_rd_data[mem_slot_g][mem_bank_g])
                );
            end
        end
    endgenerate

    genvar tmp_bank_g;
    generate
        for (tmp_bank_g = 0; tmp_bank_g < 4; tmp_bank_g = tmp_bank_g + 1) begin : gen_tmp_banks
            its_simple_ram #(
                .DATA_W(16), .DEPTH(BANK_DEPTH), .ADDR_W(BANK_ADDR_W)
            ) u_kernel_tmp_bank (
                .clk(clk),
                .wr_en(tmp_wr_en[tmp_bank_g]),
                .wr_addr(tmp_wr_addr[tmp_bank_g]),
                .wr_data(tmp_wr_data[tmp_bank_g]),
                .rd_addr(tmp_rd_addr[tmp_bank_g]),
                .rd_data(tmp_rd_data[tmp_bank_g])
            );
        end
    endgenerate
    logic [2:0] slot_state [0:1];
    logic [6:0] slot_width [0:1];
    logic [6:0] slot_height[0:1];
    logic [1:0] slot_hor   [0:1];
    logic [1:0] slot_ver   [0:1];
    logic [1:0] slot_set   [0:1];
    logic [1:0] slot_lfnst [0:1];
    // Descriptor geometry is decoded once at bind time.  The live protocol
    // and result-control paths use these registered values instead of a
    // synthesized width*height multiplier.
    logic [12:0] slot_point_count [0:1];
    logic [11:0] slot_last_input_addr [0:1];
    logic [11:0] slot_output_last_index [0:1];

    // Descriptor FIFO.  It may queue two descriptors, while fill_slot is the
    // only active data owner because the data interface has no TU identifier.
    logic [21:0] desc_mem [0:1];
    logic        desc_rd_ptr, desc_wr_ptr;
    logic [1:0]  desc_count;
    logic        fill_active;
    logic        fill_slot;
    logic        scrub_active;
    logic        scrub_slot;
    logic [11:0] scrub_index;

    logic        output_active;
    logic        output_slot;
    logic [11:0] output_index;
    // Latched at compute admission so output-last detection does not
    // re-evaluate the 7x7 width*height arithmetic in the output/control cone.
    // The value is stable for the complete output transaction.
    logic [11:0] output_last_index;

    // Gate-B unified P4 kernel integration.  LFNST-enabled cases first use the
    // bounded engine above and then reuse this kernel for the DCT2 passes;
    // LFNST-off primary transforms use this kernel directly.
    logic        compute_slot_q;
    logic        kernel_run_q;
    typedef enum logic [3:0] {K_IDLE, K_V_START, K_V_FEED, K_V_DRAIN,
                              K_V_WAIT_COMMIT, K_H_START, K_H_FEED,
                              K_H_DRAIN, K_H_WAIT_COMMIT} kernel_phase_t;
    kernel_phase_t kernel_phase_q;
    // cut_w/cut_h bound input-frequency support only.  Spatial outputs
    // always cover the complete kernel_w/kernel_h transform dimensions.
    logic [6:0] kernel_w_q, kernel_h_q, kernel_cut_w_q, kernel_cut_h_q;
    logic [6:0] kernel_vector_q;
    // P8.1: keep feed-side input bookkeeping separate from drain-side output
    // bookkeeping.  The same-edge kernel fire may advance feed_group_q and
    // consume a response, but it must not drive the wide phase/drain mux.
    logic [4:0] kernel_feed_group_q;
    logic [4:0] kernel_drain_group_q;
    logic [1:0] kernel_type_q;
    logic       kernel_stage_q;
    logic       kernel_start;
    logic       kernel_in_valid;
    logic       kernel_in_req;
    logic signed [63:0] kernel_in_data;
    logic       kernel_out_valid;
    logic       kernel_out_req;
    logic signed [63:0] kernel_out_data;
    logic       kernel_done;
    // P8 handshake boundary: same-edge input fire is used for response
    // consumption/group advance; the registered token drives phase changes.
    logic       kernel_input_group_fire;
    logic       kernel_input_vector_done;
    logic       kernel_busy;
    logic       kernel_error;

    // P7: phase-entry context is registered once for each V/H pass.  The
    // kernel no longer sees a live stage mux on transform/active/output size;
    // its capacity and ready logic consume these stable fields instead.
    logic       kernel_ctx_stage_q;
    logic [6:0] kernel_ctx_transform_size_q;
    logic [6:0] kernel_ctx_active_size_q;
    logic [6:0] kernel_ctx_output_size_q;
    logic [5:0] kernel_ctx_group_count_q;

    // Vertical result to intermediate-memory write boundary.  A command is
    // captured when a kernel result group is accepted and is committed by the
    // RAMs on the following edge.  The RAM write ports are driven only by
    // these registered fields, so kernel/group/address decode cannot reach a
    // distributed-RAM write endpoint in the same timing interval.
    logic                             vwrite_cmd_valid_q;
    logic [3:0]                       vwrite_cmd_bank_mask_q;
    logic [BANK_ADDR_W-1:0]           vwrite_cmd_addr_q;
    logic signed [15:0]               vwrite_cmd_data_q [0:3];
    logic                             vwrite_cmd_last_q;
    logic                             vwrite_last_commit_seen_q;
    logic                             vertical_result_fire;
    logic                             vwrite_cmd_commit;
    logic [3:0]                       vwrite_cmd_bank_mask_c;
    logic [BANK_ADDR_W-1:0]           vwrite_cmd_addr_c;
    logic signed [15:0]               vwrite_cmd_data_c [0:3];
    logic                             vwrite_cmd_last_c;

    // Horizontal result write boundary.  A result group is captured into a
    // registered bank-local command and committed by ResultMemory on the
    // following edge.  No live kernel counter reaches a RAM write port.
    logic                             result_cmd_valid_q;
    logic                             result_cmd_slot_q;
    logic [3:0]                       result_cmd_bank_mask_q;
    logic [BANK_ADDR_W-1:0]           result_cmd_addr_q;
    logic signed [OUT_W-1:0]          result_cmd_data_q [0:3];
    logic                             result_cmd_last_q;
    logic                             result_last_commit_seen_q;
    logic                             horizontal_result_fire;
    logic                             result_cmd_commit;
    logic [3:0]                       result_cmd_bank_mask_c;
    logic [BANK_ADDR_W-1:0]           result_cmd_addr_c;
    logic signed [OUT_W-1:0]          result_cmd_data_c [0:3];
    logic                             result_cmd_last_c;
    logic [BANK_ADDR_W-1:0]           result_write_beat_q;
    // Primary-transform cache reads are prefetched through a registered
    // response boundary before entering the unified kernel.  The request
    // group advances independently from the group currently being consumed,
    // so one read can be captured while the previous response is accepted.
    logic       kernel_rd_req_pending_q;
    logic [4:0] kernel_rd_req_group_q;
    logic [6:0] kernel_rd_req_vector_q;
    // Reserve a return slot when a primary-V request is accepted. Outstanding
    // includes the command, bank-local raw stage, and return FIFO entries, so
    // a consumer stall cannot back-pressure a command already sent to RAM.
    localparam integer PRIMARY_RETURN_DEPTH = 4;
    logic [2:0] primary_outstanding_q;
    logic       primary_issue_ready;
    logic       primary_return_pop;
    logic       primary_return_push;
    logic [1:0] primary_return_wr_ptr_q;
    logic [1:0] primary_return_rd_ptr_q;
    logic [2:0] primary_return_count_q;
    logic signed [63:0] primary_return_data_q [0:PRIMARY_RETURN_DEPTH-1];
    logic signed [63:0] kernel_rd_return_data;
    logic               kernel_rd_return_valid;
    // Each physical slot×bank has its own raw data/valid register. The slot
    // mux and lane packing happen after this bank-local capture boundary.
    logic signed [15:0] kernel_rd_bank_data_q [0:1][0:3];
    logic               kernel_rd_bank_valid_q [0:1][0:3];
    logic               kernel_rd_raw_pending_q;
    logic               kernel_rd_raw_slot_q;
    logic [3:0]         kernel_rd_raw_bank_mask_q;
    logic [4:0]         kernel_rd_raw_group_q;
    logic [6:0]         kernel_rd_raw_vector_q;
    logic       kernel_start_sent_q;
    logic       kernel_group_accept;
    logic signed [63:0] kernel_rd_data_comb;
    logic               kernel_rd_valid_comb;
    logic               kernel_rd_raw_capture;

    // P9 second round: one atomic elastic physical-read command is shared by
    // primary-V and LFNST logical requests.  The command owns all physical
    // slot/bank addresses and the metadata needed by response capture.
    // Address registers are held even when valid is low; validity and owner
    // metadata, not an address mux, determine whether a RAM output is useful.
    localparam logic RD_OWNER_PRIMARY_V = 1'b0;
    localparam logic RD_OWNER_LFNST     = 1'b1;
    logic                         rd_cmd_valid_q;
    logic                         rd_cmd_owner_q;
    logic                         rd_cmd_slot_q;
    logic [3:0]                   rd_cmd_bank_mask_q;
    logic                         rd_cmd_bank_valid_q [0:1][0:3];
    logic [BANK_ADDR_W-1:0]       rd_cmd_addr_q [0:1][0:3];
    logic [4:0]                   rd_cmd_group_q;
    logic [6:0]                   rd_cmd_vector_q;
    logic [4:0]                   rd_cmd_lfnst_index_q;
    logic                         rd_cmd_lfnst_valid_q;
    logic                         rd_cmd_lfnst_last_q;
    logic [1:0]                   rd_cmd_lfnst_bank_q;

    logic                         rd_cmd_candidate_valid;
    logic                         rd_cmd_candidate_owner;
    logic                         rd_cmd_candidate_slot;
    logic [3:0]                   rd_cmd_candidate_bank_mask;
    logic [BANK_ADDR_W-1:0]       rd_cmd_candidate_addr_c [0:1][0:3];
    logic [4:0]                   rd_cmd_candidate_group;
    logic [6:0]                   rd_cmd_candidate_vector;
    logic [4:0]                   rd_cmd_candidate_lfnst_index;
    logic                         rd_cmd_candidate_lfnst_valid;
    logic                         rd_cmd_candidate_lfnst_last;
    logic [1:0]                   rd_cmd_candidate_lfnst_bank;
    logic                         rd_cmd_response_fire;
    logic                         rd_cmd_ready;
    logic                         rd_cmd_accept;
    logic                         primary_logical_req_fire;
    logic                         primary_outstanding_command_q;
    logic                         lfnst_mem_req_accept;

    // Horizontal intermediate reads use a bank-local address register and a
    // response register as well.  The request address is generated from the
    // current row/group metadata and held for one cycle before the RAM output
    // is sampled, keeping kernel_w_q and the dynamic bank mux out of the RAM
    // to kernel input timing path.
    logic [BANK_ADDR_W-1:0] kernel_h_rd_addr_q [0:3];
    logic [BANK_ADDR_W-1:0] kernel_h_rd_addr_advance_c [0:3];
    logic [BANK_ADDR_W-1:0] kernel_h_row_base_q [0:3];
    logic [BANK_ADDR_W-1:0] kernel_h_row_base_next_c [0:3];
    logic [6:0]             kernel_h_width_q;
    logic [4:0]             kernel_h_groups_per_row_q;
    logic [4:0]             kernel_h_groups_left_q;
    logic [6:0]             kernel_h_rows_left_q;
    logic [1:0]             kernel_h_row_phase_q;
    logic                   kernel_h_rd_pending_q;
    logic [4:0]             kernel_h_rd_group_q;
    logic [6:0]             kernel_h_rd_vector_q;
    // The first read-response stage stores one 16-bit word per physical bank.
    // Its payload is intentionally not reset; the registered valid bit owns
    // whether these words can be observed.
    logic signed [15:0]     kernel_h_rd_raw_data_q [0:3];
    logic                   kernel_h_rd_raw_stage_valid_q;
    logic [4:0]             kernel_h_rd_raw_stage_group_q;
    logic [6:0]             kernel_h_rd_raw_stage_vector_q;
    logic signed [63:0]     kernel_h_rd_data_q;
    // Legacy raw_pending/group/vector names below describe the queue head.
    logic                   kernel_h_rd_raw_pending_q;
    logic [4:0]             kernel_h_rd_raw_group_q;
    logic [6:0]             kernel_h_rd_raw_vector_q;
    // A second response entry decouples the address sequencer from a one-cycle
    // kernel consume stall.  The head entry is still presented to the kernel;
    // the tail entry is only an elastic skid buffer and carries the same
    // group/vector metadata as its data.
    logic signed [63:0]     kernel_h_rd_data_tail_q;
    logic                   kernel_h_rd_raw_tail_pending_q;
    logic [4:0]             kernel_h_rd_raw_tail_group_q;
    logic [6:0]             kernel_h_rd_raw_tail_vector_q;
    logic                   kernel_h_rd_capture;
    logic                   kernel_h_rd_raw_to_queue;
    logic                   kernel_h_rd_raw_stage_ready;
    logic                   kernel_h_rd_consume;
    logic [4:0]             kernel_h_rd_next_group;
    logic                   kernel_h_input_last_fire_c;
    // P9 ingress adds one cycle between the final input fire and the
    // commit-qualified input_vector_done token.  During that interval the
    // horizontal read sequencer must not pre-issue the next row: doing so
    // would advance row metadata while the kernel is still waiting for the
    // final input commit, and the response would then be discarded when the
    // wrapper enters H_DRAIN.  This bit freezes H-read advancement for that
    // bounded handoff window without changing steady-state request II.
    logic                   kernel_h_input_commit_wait_q;
    integer                 kernel_h_addr_i;
    integer                 kernel_h_capture_bank_i;
    integer                 kernel_h_seq_addr_i;
    integer                 kernel_h_seq_capture_bank_i;
    integer                 kernel_h_raw_capture_bank_i;

    logic       lfnst_run_q;
    logic       lfnst_start_q;
    logic       lfnst_slot_q;
    logic       lfnst_ntrs48_q;
    logic       lfnst_nonzero8_q;
    logic [1:0] lfnst_set_q;
    logic [1:0] lfnst_idx_q;
    logic       lfnst_busy;
    logic       lfnst_out_valid;
    logic signed [63:0] lfnst_out_data;
    logic [3:0] lfnst_out_group;
    logic       lfnst_out_last;
    logic       lfnst_done;
    logic       lfnst_error;
    logic       lfnst_case_q;
    logic       lfnst_gather_q;
    logic [4:0] lfnst_gather_index_q;
    // LFNST input reads use an explicit request/response boundary.  The
    // request registers hold the bank-local physical address and its source
    // metadata; the response registers then isolate the cache read from the
    // term/grid write.  This keeps the gather path bounded without changing
    // the external transaction contract.
    logic       lfnst_mem_req_q;
    logic [4:0] lfnst_mem_req_index_q;
    logic [BANK_ADDR_W-1:0] lfnst_mem_req_addr_q;
    logic       lfnst_mem_req_valid_q;
    logic       lfnst_mem_req_last_q;
    logic       lfnst_mem_req_slot_q;
    logic [1:0] lfnst_mem_req_bank_q;
    logic       lfnst_mem_resp_pending_q;
    logic [4:0] lfnst_mem_resp_index_q;
    logic signed [15:0] lfnst_mem_resp_data_q;
    logic       lfnst_mem_resp_valid_q;
    logic       lfnst_mem_resp_last_q;
    logic signed [255:0] lfnst_input_terms_q;
    // Keep the LFNST result grid in vector-major order. The following DCT2
    // gather uses one common vector across four adjacent samples, so making
    // sample the low address dimension gives synthesis a different read mux
    // ordering than the former row-major sample*8+vector layout.
    logic signed [15:0] lfnst_grid [0:63];
    logic               lfnst_grid_valid [0:63];
    // Keep eight local initialization controls so the wide grid clear is
    // launched from registered, placement-friendly sources. Each bit owns
    // one contiguous group of eight vector-major words.
    (* KEEP = "TRUE", equivalent_register_removal = "no" *)
    logic [7:0] lfnst_grid_init_q;
`ifndef SYNTHESIS
    // Simulation-only row-major shadow proves the layout change preserves
    // every accepted LFNST gather value.
    logic signed [15:0] lfnst_grid_legacy [0:63];
    logic               lfnst_grid_legacy_valid [0:63];
    integer lfnst_gather_check_lane;
    integer lfnst_gather_check_sample;
    integer lfnst_gather_check_addr;
    logic signed [15:0] lfnst_gather_check_data;
`endif

    unified_p4_kernel #(
        .DATA_W(16), .COEFF_W(16), .ACC_W(40), .MAX_N(64),
        .COEFF_DEPTH(COEFF_DEPTH), .COEFF_FILE(COEFF_FILE)
    ) u_unified_p4_kernel (
        .clk(clk), .rst_n(rst_n), .start(kernel_start),
        .tr_type(kernel_type_q),
        .transform_size(kernel_ctx_transform_size_q),
        .active_size(kernel_ctx_active_size_q),
        .output_size(kernel_ctx_output_size_q),
        .output_group_count(kernel_ctx_group_count_q),
        .stage_sel(kernel_ctx_stage_q), .in_valid(kernel_in_valid),
        .in_req(kernel_in_req), .in_data(kernel_in_data),
        .out_valid(kernel_out_valid), .out_req(kernel_out_req),
        .out_data(kernel_out_data), .done(kernel_done),
        .input_group_fire(kernel_input_group_fire),
        .input_vector_done(kernel_input_vector_done),
        .busy(kernel_busy), .error(kernel_error)
    );

    bounded_lfnst_engine #(
        .DATA_W(16), .COEFF_W(16), .ACC_W(40),
        .COEFF_FILE(LFNST_PACKED_FILE)
    ) u_bounded_lfnst_engine (
        .clk(clk), .rst_n(rst_n), .start(lfnst_start_q),
        .set_idx(lfnst_set_q), .lfnst_idx(lfnst_idx_q),
        .ntrs48(lfnst_ntrs48_q), .nonzero8(lfnst_nonzero8_q),
        .input_terms(lfnst_input_terms_q), .busy(lfnst_busy),
        .out_valid(lfnst_out_valid), .out_data(lfnst_out_data),
        .out_group(lfnst_out_group), .out_last(lfnst_out_last),
        .done(lfnst_done), .error(lfnst_error)
    );

    logic        descriptor_shape_ok;
    logic        descriptor_legal;
    logic        desc_push;
    logic        bind_event;
    logic        bind_slot;
    logic        compute_valid;
    logic        compute_slot;
    logic        output_fire;
    logic        output_last_fire;
    wire         input_fire;
    wire         input_end_fire;
    logic [12:0] bind_point_count_c;

    // ------------------------------------------------------------------
    // it_data_end attribution
    //
    // A TU may take exactly one end, and the end does not have to wait for
    // it_data_in_req.  An end that arrives before the slot opens for filling
    // (descriptor scrub window, or while the descriptor is still queued) is
    // stored and consumed later.  Ownership follows receive order and skips
    // every TU that has already taken its end.  See
    // 01_docs/current/END_ATTRIBUTION_CONTRACT.md.
    // ------------------------------------------------------------------
    logic        end_seen_desc [0:1];
    logic        end_seen_slot [0:1];
    wire         end_owner_valid;
    wire         end_owner_is_slot;
    wire         end_owner_slot;
    wire         end_owner_is_queue;
    wire         end_owner_qidx;
    wire         end_to_scrub;
    wire         end_to_queue_pop;
    wire         end_to_queue_store;
    wire         scrub_ended;

    // Priority: active input TU, then queue head, then queue second entry.
    assign end_owner_is_slot =
        (scrub_active && !end_seen_slot[scrub_slot]) ||
        (fill_active  && !end_seen_slot[fill_slot]);
    assign end_owner_slot  = scrub_active ? scrub_slot : fill_slot;
    assign end_owner_valid =
        end_owner_is_slot ||
        ((desc_count != 2'd0) && !end_seen_desc[desc_rd_ptr]) ||
        ((desc_count == 2'd2) && !end_seen_desc[~desc_rd_ptr]);
    assign end_owner_is_queue = !end_owner_is_slot && end_owner_valid;
    assign end_owner_qidx =
        ((desc_count != 2'd0) && !end_seen_desc[desc_rd_ptr])
            ? desc_rd_ptr : ~desc_rd_ptr;

    // Stored ends are only ever raised for a slot still inside its scrub
    // window; ends accepted during fill are consumed in place.
    assign end_to_scrub = it_data_end && end_owner_is_slot && scrub_active &&
                          (end_owner_slot == scrub_slot);

    // A queued entry keeps its end in the queue unless it is being popped on
    // this very edge, in which case the end rides along with the transfer.
    assign end_to_queue_pop   = it_data_end && end_owner_is_queue && bind_event &&
                                (end_owner_qidx == desc_rd_ptr);
    assign end_to_queue_store = it_data_end && end_owner_is_queue &&
                                !(bind_event && (end_owner_qidx == desc_rd_ptr));

    assign scrub_ended = scrub_active &&
                         (scrub_index == (INPUT_VALID_WORDS - 1)) &&
                         (end_seen_slot[scrub_slot] || end_to_scrub);

    // Single ownership: no other block may write end_seen_desc/end_seen_slot.
    always_ff @(posedge clk or negedge rst_n) begin
        if (!rst_n) begin
            end_seen_desc[0] <= 1'b0;
            end_seen_desc[1] <= 1'b0;
            end_seen_slot[0] <= 1'b0;
            end_seen_slot[1] <= 1'b0;
        end else begin
            if (desc_push)
                end_seen_desc[desc_wr_ptr] <= 1'b0;
            if (end_to_queue_store)
                end_seen_desc[end_owner_qidx] <= 1'b1;

            if (scrub_ended)
                end_seen_slot[scrub_slot] <= 1'b0;
            else if (end_to_scrub)
                end_seen_slot[scrub_slot] <= 1'b1;

            if (bind_event)
                end_seen_slot[bind_slot] <=
                    end_seen_desc[desc_rd_ptr] | end_to_queue_pop;

            if (compute_valid)
                end_seen_slot[compute_slot] <= 1'b0;
        end
    end

    // desc_rd_ptr selects only the descriptor being bound.  The expression is
    // a table decode, not a multiply, and is registered into the slot below.
    assign bind_point_count_c =
        static_tu_point_count(desc_mem[desc_rd_ptr][6:0],
                              desc_mem[desc_rd_ptr][13:7]);

    function automatic logic shape_supported(input logic [6:0] w,
                                             input logic [6:0] h);
        begin
            shape_supported = 1'b0;
            case ({w, h})
                {7'd4,7'd4}, {7'd4,7'd8}, {7'd4,7'd16}, {7'd4,7'd32}, {7'd4,7'd64},
                {7'd8,7'd4}, {7'd16,7'd4}, {7'd32,7'd4}, {7'd64,7'd4},
                {7'd8,7'd8}, {7'd8,7'd16}, {7'd8,7'd32}, {7'd8,7'd64},
                {7'd16,7'd8}, {7'd32,7'd8}, {7'd64,7'd8}, {7'd16,7'd16},
                {7'd16,7'd32}, {7'd16,7'd64}, {7'd32,7'd16}, {7'd32,7'd32},
                {7'd32,7'd64}, {7'd64,7'd16}, {7'd64,7'd32}, {7'd64,7'd64}:
                    shape_supported = 1'b1;
                default: shape_supported = 1'b0;
            endcase
        end
    endfunction

    function automatic logic axis_supported(input logic [1:0] t,
                                             input logic [6:0] n);
        begin
            axis_supported = ((t <= 2'd2) &&
                              ((n == 7'd4) || (n == 7'd8) ||
                               (n == 7'd16) || (n == 7'd32) ||
                               ((n == 7'd64) && (t == 2'd0))));
        end
    endfunction

    function automatic logic [6:0] kernel_cut_dim(input logic [1:0] t,
                                                  input logic [6:0] n);
        begin
            if ((t != 2'd0) && (n == 7'd32))
                kernel_cut_dim = 7'd16;
            else if (n > 7'd32)
                kernel_cut_dim = 7'd32;
            else
                kernel_cut_dim = n;
        end
    endfunction

    function automatic logic [6:0] lfnst_cut_dim(input logic [6:0] n,
                                                  input logic [6:0] other_n);
        begin
            // LFNST operates on a 4x4 or 8x8 low-frequency support region.
            // The shape contract guarantees both dimensions are powers of two
            // in the supported 4..64 range.
            if ((n == 7'd4) || (other_n == 7'd4))
                lfnst_cut_dim = 7'd4;
            else
                lfnst_cut_dim = 7'd8;
        end
    endfunction

    function automatic logic lfnst_shape_supported(input logic [6:0] w,
                                                    input logic [6:0] h);
        begin
            lfnst_shape_supported = ((w == 7'd4) || (w == 7'd8) ||
                                     (w == 7'd16) || (w == 7'd32) || (w == 7'd64)) &&
                                    ((h == 7'd4) || (h == 7'd8) ||
                                     (h == 7'd16) || (h == 7'd32) || (h == 7'd64));
        end
    endfunction

    // All supported dimensions are powers of two.  Keep the geometry as a
    // constant decode table rather than a generic multiplier.  The 13-bit
    // count is intentional: 64x64 is 4096, which does not fit in 12 bits.
    function automatic logic [12:0] static_tu_point_count(input logic [6:0] w,
                                                           input logic [6:0] h);
        begin
            static_tu_point_count = 13'd0;
            case ({w, h})
                {7'd4,7'd4}:   static_tu_point_count = 13'd16;
                {7'd4,7'd8}, {7'd8,7'd4}: static_tu_point_count = 13'd32;
                {7'd4,7'd16}, {7'd8,7'd8}, {7'd16,7'd4}: static_tu_point_count = 13'd64;
                {7'd4,7'd32}, {7'd8,7'd16}, {7'd16,7'd8}, {7'd32,7'd4}: static_tu_point_count = 13'd128;
                {7'd4,7'd64}, {7'd8,7'd32}, {7'd16,7'd16}, {7'd32,7'd8}, {7'd64,7'd4}: static_tu_point_count = 13'd256;
                {7'd8,7'd64}, {7'd16,7'd32}, {7'd32,7'd16}, {7'd64,7'd8}: static_tu_point_count = 13'd512;
                {7'd16,7'd64}, {7'd32,7'd32}, {7'd64,7'd16}: static_tu_point_count = 13'd1024;
                {7'd32,7'd64}, {7'd64,7'd32}: static_tu_point_count = 13'd2048;
                {7'd64,7'd64}: static_tu_point_count = 13'd4096;
                default: static_tu_point_count = 13'd0;
            endcase
        end
    endfunction

    // The bank map is fixed-stride so it is independent of the active TU
    // width.  Four consecutive rows at a given column therefore select four
    // different banks, while the local address remains at most 1023.
    function automatic integer cache_bank_for(input integer row_i,
                                               input integer col_i);
        begin
            cache_bank_for = (row_i & 3) ^ (col_i & 3);
        end
    endfunction

    function automatic integer cache_local_for(input integer row_i,
                                                input integer col_i);
        begin
            cache_local_for = row_i * 16 + (col_i >> 2);
        end
    endfunction

    function automatic integer tmp_bank_for(input integer row_i,
                                             input integer col_i);
        begin
            // Cyclic diagonal banking is conflict-free for both access
            // patterns: V writes four consecutive rows at one column, while H
            // reads four consecutive columns at one row.
            tmp_bank_for = (row_i + col_i) & 3;
        end
    endfunction

    function automatic integer tmp_local_for(input integer row_i,
                                              input integer col_i,
                                              input integer width_i);
        begin
            tmp_local_for = (row_i >> 2) * width_i + col_i;
        end
    endfunction

    // Static-width form used by the vertical write-command boundary.  The
    // intermediate mapping is local = group * width + column; spelling out
    // the five supported powers of two prevents a runtime multiplier from
    // being inferred in the command-generation path.
    function automatic logic [BANK_ADDR_W-1:0] tmp_local_for_vwrite(
        input logic [4:0] group_i,
        input logic [6:0] width_i,
        input logic [6:0] col_i);
        logic [BANK_ADDR_W-1:0] group_ext;
        logic [BANK_ADDR_W-1:0] col_ext;
        begin
            group_ext = '0;
            group_ext[4:0] = group_i;
            col_ext = '0;
            col_ext[6:0] = col_i;
            case (width_i)
                7'd4:  tmp_local_for_vwrite = (group_ext << 2) + col_ext;
                7'd8:  tmp_local_for_vwrite = (group_ext << 3) + col_ext;
                7'd16: tmp_local_for_vwrite = (group_ext << 4) + col_ext;
                7'd32: tmp_local_for_vwrite = (group_ext << 5) + col_ext;
                7'd64: tmp_local_for_vwrite = (group_ext << 6) + col_ext;
                default: tmp_local_for_vwrite = '0;
            endcase
        end
    endfunction

    function automatic integer raster_row_for(input integer address_i,
                                               input integer width_i);
        begin
            case (width_i)
                7'd4:  raster_row_for = address_i >> 2;
                7'd8:  raster_row_for = address_i >> 3;
                7'd16: raster_row_for = address_i >> 4;
                7'd32: raster_row_for = address_i >> 5;
                7'd64: raster_row_for = address_i >> 6;
                default: raster_row_for = 0;
            endcase
        end
    endfunction

    function automatic integer raster_col_for(input integer address_i,
                                               input integer width_i);
        begin
            case (width_i)
                7'd4:  raster_col_for = address_i & 3;
                7'd8:  raster_col_for = address_i & 7;
                7'd16: raster_col_for = address_i & 15;
                7'd32: raster_col_for = address_i & 31;
                7'd64: raster_col_for = address_i & 63;
                default: raster_col_for = 0;
            endcase
        end
    endfunction

    always_comb begin
        descriptor_shape_ok = shape_supported(it_info[6:0], it_info[13:7]);
        descriptor_legal = descriptor_shape_ok &&
                           axis_supported(it_info[15:14], it_info[6:0]) &&
                           axis_supported(it_info[17:16], it_info[13:7]) &&
                           (it_info[19:18] <= 2'd3);
        if (it_info[21:20] != 2'd0)
            descriptor_legal = descriptor_legal &&
                               (it_info[15:14] == 2'd0) &&
                               (it_info[17:16] == 2'd0) &&
                               lfnst_shape_supported(it_info[6:0], it_info[13:7]) &&
                               ((it_info[21:20] == 2'd1) ||
                                (it_info[21:20] == 2'd2));
    end

    // A full descriptor queue may accept a new item on the same edge that its
    // head binds to a free slot.  Invalid/full attempts are reported rather
    // than silently discarded.
    always_comb begin
        bind_event = 1'b0;
        bind_slot = 1'b0;
        // Input ordering barrier: let the previous final fill write commit
        // before a younger TU binds and starts its scrub window.
        if (!fill_active && !scrub_active && !fill_end_pending_q &&
            (desc_count != 2'd0)) begin
            if (slot_state[0] == SLOT_FREE) begin
                bind_event = 1'b1;
                bind_slot = 1'b0;
            end else if (slot_state[1] == SLOT_FREE) begin
                bind_event = 1'b1;
                bind_slot = 1'b1;
            end
        end
        desc_push = it_info_vld && descriptor_legal &&
                    ((desc_count < 2'd2) || bind_event);
    end

    // P9 round 3: acceptance is defined at the command boundary.  The
    // current write stage is guaranteed to make progress, but retaining the
    // explicit ready/commit equations prevents a future write-side stall from
    // creating a fire-without-storage condition.
    assign fill_wr_cmd_commit = fill_wr_cmd_valid_q;
    assign fill_wr_cmd_ready  = !fill_wr_cmd_valid_q || fill_wr_cmd_commit;
    assign it_data_in_req = fill_active && fill_wr_cmd_ready;
    assign input_fire = it_data_in_vld && it_data_in_req;
    // The end marker is an independent input transaction: it may accompany a
    // final nonzero data word or arrive on its own after the sparse words.
    assign input_end_fire = it_data_end && it_data_in_req;

    // Decode one accepted sparse point into a registered physical write
    // command.  The decode is intentionally before the command register;
    // RAM write enables/addresses/data below are driven only from *_q.
    always_comb begin : fill_write_command_generate
        fill_wr_cmd_addr_c = '0;
        fill_wr_cmd_data_c = '0;
        fill_wr_cmd_target_c[0] = 4'b0000;
        fill_wr_cmd_target_c[1] = 4'b0000;
        fill_cmd_row_i = 0;
        fill_cmd_col_i = 0;
        fill_cmd_bank_i = 0;
        fill_cmd_local_i = 0;
        if (input_fire) begin
            fill_cmd_row_i = raster_row_for(it_data_addr, slot_width[fill_slot]);
            fill_cmd_col_i = raster_col_for(it_data_addr, slot_width[fill_slot]);
            fill_cmd_bank_i = cache_bank_for(fill_cmd_row_i, fill_cmd_col_i);
            fill_cmd_local_i = cache_local_for(fill_cmd_row_i, fill_cmd_col_i);
            fill_wr_cmd_addr_c = fill_cmd_local_i[BANK_ADDR_W-1:0];
            fill_wr_cmd_data_c = it_data_in;
            fill_wr_cmd_target_c[fill_slot][fill_cmd_bank_i] = 1'b1;
        end
    end

    function automatic integer coeff_base(input logic [1:0] t,
                                          input logic [6:0] n);
        begin
            case ({t,n})
                {2'd0,7'd4}:  coeff_base = 0;
                {2'd0,7'd8}:  coeff_base = 16;
                {2'd0,7'd16}: coeff_base = 80;
                {2'd0,7'd32}: coeff_base = 336;
                {2'd0,7'd64}: coeff_base = 1360;
                {2'd1,7'd4}:  coeff_base = 5456;
                {2'd1,7'd8}:  coeff_base = 5472;
                {2'd1,7'd16}: coeff_base = 5536;
                {2'd1,7'd32}: coeff_base = 5792;
                {2'd2,7'd4}:  coeff_base = 6816;
                {2'd2,7'd8}:  coeff_base = 6832;
                {2'd2,7'd16}: coeff_base = 6896;
                {2'd2,7'd32}: coeff_base = 7152;
                default:      coeff_base = 0;
            endcase
        end
    endfunction

    function automatic integer scan_row(input integer index_i,
                                        input integer side_i);
        integer diagonal, row_lo, row_hi, diagonal_count;
        integer offset_i, count_i;
        begin
            scan_row = 0;
            count_i = 0;
            // side_i is restricted to 4 or 8 by the LFNST contract.  Keep
            // the loop statically bounded for synthesis; the runtime guard
            // preserves the original 2*side_i-1 diagonal traversal.
            for (diagonal = 0; diagonal < 15;
                 diagonal = diagonal + 1) begin
                if (diagonal < 2*side_i-1) begin
                    row_lo = (diagonal < side_i) ? 0 : diagonal - side_i + 1;
                    row_hi = (diagonal < side_i) ? diagonal : side_i - 1;
                    diagonal_count = row_hi - row_lo + 1;
                    if ((index_i >= count_i) &&
                        (index_i < count_i + diagonal_count)) begin
                        offset_i = index_i - count_i;
                        scan_row = ((diagonal & 1) != 0) ?
                                   (row_hi - offset_i) : (row_lo + offset_i);
                    end
                    count_i = count_i + diagonal_count;
                end
            end
        end
    endfunction

    function automatic integer scan_col(input integer index_i,
                                        input integer side_i);
        integer diagonal, row_lo, row_hi, diagonal_count;
        integer offset_i, selected_row, count_i;
        begin
            scan_col = 0;
            count_i = 0;
            // See scan_row above: a static 15-iteration bound avoids a
            // variable loop termination condition in Vivado while retaining
            // the exact diagonal scan for side_i=4 or 8.
            for (diagonal = 0; diagonal < 15;
                 diagonal = diagonal + 1) begin
                if (diagonal < 2*side_i-1) begin
                    row_lo = (diagonal < side_i) ? 0 : diagonal - side_i + 1;
                    row_hi = (diagonal < side_i) ? diagonal : side_i - 1;
                    diagonal_count = row_hi - row_lo + 1;
                    if ((index_i >= count_i) &&
                        (index_i < count_i + diagonal_count)) begin
                        offset_i = index_i - count_i;
                        selected_row = ((diagonal & 1) != 0) ?
                                       (row_hi - offset_i) : (row_lo + offset_i);
                        scan_col = diagonal - selected_row;
                    end
                    count_i = count_i + diagonal_count;
                end
            end
        end
    endfunction

    // LFNST input contract: the transform always gathers the fixed low
    // frequency 4x4 support in the VTM-defined order.  This is deliberately
    // separate from the output-layout and scan tables below: the first 16
    // entries of an 8x8 diagonal scan are not the LFNST input order.
    function automatic integer lfnst_input_coord_lut(input integer index_i);
        begin
            case (index_i)
                0:  lfnst_input_coord_lut = 0;   // (0,0)
                1:  lfnst_input_coord_lut = 8;   // (1,0)
                2:  lfnst_input_coord_lut = 1;   // (0,1)
                3:  lfnst_input_coord_lut = 16;  // (2,0)
                4:  lfnst_input_coord_lut = 9;   // (1,1)
                5:  lfnst_input_coord_lut = 2;   // (0,2)
                6:  lfnst_input_coord_lut = 24;  // (3,0)
                7:  lfnst_input_coord_lut = 17;  // (2,1)
                8:  lfnst_input_coord_lut = 10;  // (1,2)
                9:  lfnst_input_coord_lut = 3;   // (0,3)
                10: lfnst_input_coord_lut = 25;  // (3,1)
                11: lfnst_input_coord_lut = 18;  // (2,2)
                12: lfnst_input_coord_lut = 11;  // (1,3)
                13: lfnst_input_coord_lut = 26;  // (3,2)
                14: lfnst_input_coord_lut = 19;  // (2,3)
                15: lfnst_input_coord_lut = 27;  // (3,3)
                default: lfnst_input_coord_lut = 0;
            endcase
        end
    endfunction

    // LFNST output contract: nTrs=16 writes one 4x4 block; nTrs=48 writes
    // three raster-order 4x4 blocks (top-left, top-right, bottom-left) in an
    // 8x8 support grid.  The bottom-right 4x4 is intentionally not written.
    function automatic integer lfnst_output_coord_lut(
        input integer index_i,
        input integer ntrs48_i);
        integer local_i;
        begin
            lfnst_output_coord_lut = 0;
            if (!ntrs48_i) begin
                lfnst_output_coord_lut = (index_i >> 2) * 8 +
                                         (index_i & 3);
            end else if (index_i < 32) begin
                // The first 32 outputs are the complete top 4x8 region in
                // row-major order, not two block-major 4x4 sub-blocks.
                lfnst_output_coord_lut = (index_i >> 3) * 8 +
                                         (index_i & 7);
            end else if (index_i < 48) begin
                local_i = index_i - 32;
                lfnst_output_coord_lut = ((local_i >> 2) + 4) * 8 +
                                         (local_i & 3);
            end
        end
    endfunction

    // Static LFNST scan lookup used by synthesis.  Keeping the reference
    // arithmetic helpers above preserves an independent readable model, while
    // this bounded coordinate table removes runtime diagonal iteration from
    // the physical datapath.
    function automatic integer scan_coord_lut(input integer index_i,
                                               input integer side_i);
        begin
            scan_coord_lut = 0;
            if (side_i == 4) begin
                case (index_i)
                    0: scan_coord_lut = 0;
                    1: scan_coord_lut = 8;
                    2: scan_coord_lut = 1;
                    3: scan_coord_lut = 2;
                    4: scan_coord_lut = 9;
                    5: scan_coord_lut = 16;
                    6: scan_coord_lut = 24;
                    7: scan_coord_lut = 17;
                    8: scan_coord_lut = 10;
                    9: scan_coord_lut = 3;
                    10: scan_coord_lut = 11;
                    11: scan_coord_lut = 18;
                    12: scan_coord_lut = 25;
                    13: scan_coord_lut = 26;
                    14: scan_coord_lut = 19;
                    15: scan_coord_lut = 27;
                    default: scan_coord_lut = 0;
                endcase
            end else begin
                case (index_i)
                    0: scan_coord_lut = 0;
                    1: scan_coord_lut = 8;
                    2: scan_coord_lut = 1;
                    3: scan_coord_lut = 2;
                    4: scan_coord_lut = 9;
                    5: scan_coord_lut = 16;
                    6: scan_coord_lut = 24;
                    7: scan_coord_lut = 17;
                    8: scan_coord_lut = 10;
                    9: scan_coord_lut = 3;
                    10: scan_coord_lut = 4;
                    11: scan_coord_lut = 11;
                    12: scan_coord_lut = 18;
                    13: scan_coord_lut = 25;
                    14: scan_coord_lut = 32;
                    15: scan_coord_lut = 40;
                    16: scan_coord_lut = 33;
                    17: scan_coord_lut = 26;
                    18: scan_coord_lut = 19;
                    19: scan_coord_lut = 12;
                    20: scan_coord_lut = 5;
                    21: scan_coord_lut = 6;
                    22: scan_coord_lut = 13;
                    23: scan_coord_lut = 20;
                    24: scan_coord_lut = 27;
                    25: scan_coord_lut = 34;
                    26: scan_coord_lut = 41;
                    27: scan_coord_lut = 48;
                    28: scan_coord_lut = 56;
                    29: scan_coord_lut = 49;
                    30: scan_coord_lut = 42;
                    31: scan_coord_lut = 35;
                    32: scan_coord_lut = 28;
                    33: scan_coord_lut = 21;
                    34: scan_coord_lut = 14;
                    35: scan_coord_lut = 7;
                    36: scan_coord_lut = 15;
                    37: scan_coord_lut = 22;
                    38: scan_coord_lut = 29;
                    39: scan_coord_lut = 36;
                    40: scan_coord_lut = 43;
                    41: scan_coord_lut = 50;
                    42: scan_coord_lut = 57;
                    43: scan_coord_lut = 58;
                    44: scan_coord_lut = 51;
                    45: scan_coord_lut = 44;
                    46: scan_coord_lut = 37;
                    47: scan_coord_lut = 30;
                    48: scan_coord_lut = 23;
                    49: scan_coord_lut = 31;
                    50: scan_coord_lut = 38;
                    51: scan_coord_lut = 45;
                    52: scan_coord_lut = 52;
                    53: scan_coord_lut = 59;
                    54: scan_coord_lut = 60;
                    55: scan_coord_lut = 53;
                    56: scan_coord_lut = 46;
                    57: scan_coord_lut = 39;
                    58: scan_coord_lut = 47;
                    59: scan_coord_lut = 54;
                    60: scan_coord_lut = 61;
                    61: scan_coord_lut = 62;
                    62: scan_coord_lut = 55;
                    63: scan_coord_lut = 63;
                    default: scan_coord_lut = 0;
                endcase
            end
        end
    endfunction

    function automatic integer scan_row_lut(input integer index_i,
                                             input integer side_i);
        begin
            scan_row_lut = scan_coord_lut(index_i, side_i) >> 3;
        end
    endfunction

    function automatic integer scan_col_lut(input integer index_i,
                                             input integer side_i);
        begin
            scan_col_lut = scan_coord_lut(index_i, side_i) & 7;
        end
    endfunction
    function automatic signed [9:0] final_adapter(input signed [15:0] wide_i);
        integer signed value_i;
        begin
            value_i = wide_i;
            if (FINAL_SATURATE != 0) begin
                if (value_i > 511)
                    final_adapter = 10'sd511;
                else if (value_i < -512)
                    final_adapter = -10'sd512;
                else
                    final_adapter = value_i[9:0];
            end else begin
                final_adapter = value_i[9:0];
            end
        end
    endfunction

    // The unified kernel's vertical results are banked by output lane.  A
    // vertical group writes one word to each bank, and the horizontal group
    // reads the corresponding four bank-local words.
    integer gather_i;
    logic signed [15:0] lfnst_gather_rd_data;
    logic               lfnst_gather_rd_valid;

    // Build one logical request candidate at a time.  The candidate is
    // captured only when the atomic command bundle is ready; all physical
    // addresses are then held in rd_cmd_addr_q until the matching response is
    // consumed.  LFNST retains priority during its gather phase, while
    // primary-V owns the cache in the normal transform phase.
    integer rd_candidate_slot_i, rd_candidate_bank_i;
    integer rd_candidate_row_i, rd_candidate_col_i;
    integer rd_candidate_bank_map_i, rd_candidate_local_i;
    always_comb begin : rd_command_candidate_comb
        rd_cmd_candidate_valid = 1'b0;
        rd_cmd_candidate_owner = RD_OWNER_PRIMARY_V;
        rd_cmd_candidate_slot = 1'b0;
        rd_cmd_candidate_bank_mask = 4'b0000;
        rd_cmd_candidate_group = 5'd0;
        rd_cmd_candidate_vector = 7'd0;
        rd_cmd_candidate_lfnst_index = 5'd0;
        rd_cmd_candidate_lfnst_valid = 1'b0;
        rd_cmd_candidate_lfnst_last = 1'b0;
        rd_cmd_candidate_lfnst_bank = 2'd0;
        for (rd_candidate_slot_i = 0;
             rd_candidate_slot_i < 2;
             rd_candidate_slot_i = rd_candidate_slot_i + 1)
            for (rd_candidate_bank_i = 0;
                 rd_candidate_bank_i < 4;
                 rd_candidate_bank_i = rd_candidate_bank_i + 1)
                rd_cmd_candidate_addr_c[rd_candidate_slot_i][rd_candidate_bank_i] = '0;

        if (lfnst_mem_req_q) begin
            rd_cmd_candidate_valid = 1'b1;
            rd_cmd_candidate_owner = RD_OWNER_LFNST;
            rd_cmd_candidate_slot = lfnst_mem_req_slot_q;
            rd_cmd_candidate_bank_mask =
                (4'b0001 << lfnst_mem_req_bank_q);
            rd_cmd_candidate_lfnst_index = lfnst_mem_req_index_q;
            rd_cmd_candidate_lfnst_valid = lfnst_mem_req_valid_q;
            rd_cmd_candidate_lfnst_last = lfnst_mem_req_last_q;
            rd_cmd_candidate_lfnst_bank = lfnst_mem_req_bank_q;
            rd_cmd_candidate_addr_c[lfnst_mem_req_slot_q][lfnst_mem_req_bank_q] =
                lfnst_mem_req_addr_q;
        end else if (kernel_run_q && !kernel_stage_q &&
                     !lfnst_case_q && kernel_rd_req_pending_q) begin
            rd_cmd_candidate_valid = 1'b1;
            rd_cmd_candidate_owner = RD_OWNER_PRIMARY_V;
            rd_cmd_candidate_slot = compute_slot_q;
            rd_cmd_candidate_bank_mask = 4'b1111;
            rd_cmd_candidate_group = kernel_rd_req_group_q;
            rd_cmd_candidate_vector = kernel_rd_req_vector_q;
            for (rd_candidate_bank_i = 0;
                 rd_candidate_bank_i < 4;
                 rd_candidate_bank_i = rd_candidate_bank_i + 1) begin
                rd_candidate_row_i = kernel_rd_req_group_q * 4 +
                                     rd_candidate_bank_i;
                rd_candidate_col_i = kernel_rd_req_vector_q;
                rd_candidate_bank_map_i =
                    cache_bank_for(rd_candidate_row_i, rd_candidate_col_i);
                rd_candidate_local_i =
                    cache_local_for(rd_candidate_row_i, rd_candidate_col_i);
                rd_cmd_candidate_addr_c[compute_slot_q][rd_candidate_bank_map_i] =
                    rd_candidate_local_i[BANK_ADDR_W-1:0];
            end
        end
    end

    // The physical command is a fixed one-edge stage. Primary-V capacity is
    // reserved at issue time, so its retirement never waits for a same-edge
    // kernel consume. LFNST retains its existing one-edge response contract.
    always_comb begin : rd_command_flow_comb
        rd_cmd_response_fire = rd_cmd_valid_q;
        rd_cmd_ready = 1'b1;
        primary_issue_ready = (primary_outstanding_q < PRIMARY_RETURN_DEPTH);
        rd_cmd_accept = rd_cmd_candidate_valid && rd_cmd_ready &&
                        ((rd_cmd_candidate_owner == RD_OWNER_LFNST) ||
                         primary_issue_ready);
        primary_logical_req_fire = rd_cmd_accept &&
                                    (rd_cmd_candidate_owner == RD_OWNER_PRIMARY_V);
        lfnst_mem_req_accept = rd_cmd_accept &&
                               (rd_cmd_candidate_owner == RD_OWNER_LFNST);
        primary_outstanding_command_q = rd_cmd_valid_q &&
                                         (rd_cmd_owner_q == RD_OWNER_PRIMARY_V);
        primary_return_push = kernel_rd_raw_pending_q;
        primary_return_pop = kernel_rd_return_valid && kernel_group_accept &&
                             !kernel_stage_q && !lfnst_case_q;
    end

`ifndef SYNTHESIS
    // The physical command is one transaction bundle: primary-V must carry
    // all four bank lanes, while LFNST carries exactly one bank lane.  These
    // checks also guard the owner mutual-exclusion assumption used by the
    // shared command register.
    always @(posedge clk) begin
        if (rst_n && rd_cmd_accept) begin
            if (rd_cmd_candidate_owner == RD_OWNER_PRIMARY_V)
                assert (rd_cmd_candidate_bank_mask == 4'b1111)
                    else $error("P9 primary-V read command is not four-bank atomic");
            else
                assert ($onehot(rd_cmd_candidate_bank_mask))
                    else $error("P9 LFNST read command is not one-bank atomic");
        end
        if (rst_n)
            assert (!(rd_cmd_candidate_valid &&
                      (rd_cmd_candidate_owner == RD_OWNER_PRIMARY_V) &&
                      lfnst_mem_req_q))
                else $error("P9 primary-V and LFNST logical read owners overlap");
        if (rst_n) begin
            assert (primary_outstanding_q <= PRIMARY_RETURN_DEPTH)
                else $error("P9 primary-V outstanding credit overflow");
            assert (primary_return_count_q <= PRIMARY_RETURN_DEPTH)
                else $error("P9 primary-V return FIFO overflow");
            assert (primary_outstanding_q ==
                    (primary_return_count_q +
                     (kernel_rd_raw_pending_q ? 3'd1 : 3'd0) +
                     (primary_outstanding_command_q ? 3'd1 : 3'd0)))
                else $error("P9 primary-V credit/command/raw/FIFO accounting mismatch");
            if (primary_return_push && !primary_return_pop)
                assert (primary_return_count_q < PRIMARY_RETURN_DEPTH)
                    else $error("P9 primary-V return FIFO push without reserved capacity");
            if (primary_return_pop)
                assert ((primary_return_count_q != 0) &&
                        (primary_outstanding_q != 0))
                    else $error("P9 primary-V pop without a credited return");
            if (primary_logical_req_fire)
                assert (primary_outstanding_q < PRIMARY_RETURN_DEPTH)
                    else $error("P9 primary-V accepted a request without a credit");
        end
    end
`endif

    // Physical RAM addresses are unconditional connections from the command
    // registers. Valid and owner metadata qualify the response transaction.
    always_comb begin : input_read_addr_comb
        integer read_slot_i, read_bank_i;
        for (read_slot_i = 0; read_slot_i < 2; read_slot_i = read_slot_i + 1)
            for (read_bank_i = 0; read_bank_i < 4; read_bank_i = read_bank_i + 1)
                input_rd_addr[read_slot_i][read_bank_i] =
                    rd_cmd_addr_q[read_slot_i][read_bank_i];
    end

    // The primary vertical transform consumes a reserved return FIFO. Raw
    // cache data and valid bits have already been captured independently per
    // physical slot/bank; this stage performs the slot/bank selection, bounded
    // four-lane reorder, and active-height masking after that register edge.
    integer kernel_rd_lane_i;
    integer kernel_rd_row_i;
    integer kernel_rd_bank_i;
    always_comb begin : kernel_rd_data_comb_block
        kernel_rd_data_comb = '0;
        kernel_rd_valid_comb = kernel_rd_raw_pending_q;
        for (kernel_rd_lane_i = 0; kernel_rd_lane_i < 4;
             kernel_rd_lane_i = kernel_rd_lane_i + 1) begin
            kernel_rd_row_i = kernel_rd_raw_group_q * 4 + kernel_rd_lane_i;
            if (kernel_rd_raw_pending_q && (kernel_rd_row_i < kernel_cut_h_q)) begin
                kernel_rd_bank_i = cache_bank_for(kernel_rd_row_i,
                                                  kernel_rd_raw_vector_q);
                if (kernel_rd_raw_bank_mask_q[kernel_rd_bank_i] &&
                    kernel_rd_bank_valid_q[kernel_rd_raw_slot_q]
                                              [kernel_rd_bank_i])
                    kernel_rd_data_comb[kernel_rd_lane_i*16 +: 16] =
                        kernel_rd_bank_data_q[kernel_rd_raw_slot_q]
                                             [kernel_rd_bank_i];
            end
        end
    end

    always_comb begin : primary_return_head_comb
        kernel_rd_return_valid = (primary_return_count_q != 0);
        kernel_rd_return_data = primary_return_data_q[primary_return_rd_ptr_q];
    end

    // Horizontal addresses use a bank-local recurrence.  The row-zero base is
    // [0,1,2,3]; moving across a group adds four to every bank-local address.
    // At a row boundary the physical bank ownership rotates, and the local
    // base advances by width only after every fourth row.  Keeping this
    // recurrence in registered state removes the runtime row*width/column
    // arithmetic and dynamic bank case from the RAM-address timing cone.
    always_comb begin : kernel_h_rd_addr_comb
        for (kernel_h_addr_i = 0; kernel_h_addr_i < 4;
             kernel_h_addr_i = kernel_h_addr_i + 1)
            kernel_h_rd_addr_advance_c[kernel_h_addr_i] =
                kernel_h_rd_addr_q[kernel_h_addr_i] + BANK_ADDR_W'(4);
        for (kernel_h_addr_i = 0; kernel_h_addr_i < 4;
             kernel_h_addr_i = kernel_h_addr_i + 1) begin
            if (kernel_h_row_phase_q == 2'd3)
                kernel_h_row_base_next_c[kernel_h_addr_i] =
                    kernel_h_row_base_q[(kernel_h_addr_i + 3) & 3] +
                    kernel_h_width_q;
            else
                kernel_h_row_base_next_c[kernel_h_addr_i] =
                    kernel_h_row_base_q[(kernel_h_addr_i + 3) & 3];
        end
    end

    // The raw bank-response stage accepts an asynchronous RAM result when it
    // is empty or when its old word moves into the registered head/tail queue.
    // This ready calculation uses registered occupancy only; kernel consume
    // does not feed back through the RAM address/capture control cone.
    always_comb begin
        kernel_h_rd_consume = kernel_h_rd_raw_pending_q &&
                              kernel_stage_q &&
                              ((kernel_phase_q == K_H_START) ||
                               (kernel_phase_q == K_H_FEED)) &&
                              !kernel_h_input_commit_wait_q &&
                              kernel_input_group_fire;
        kernel_h_rd_raw_to_queue = kernel_h_rd_raw_stage_valid_q &&
                                   !kernel_h_rd_raw_tail_pending_q;
        kernel_h_rd_raw_stage_ready = !kernel_h_rd_raw_stage_valid_q ||
                                      kernel_h_rd_raw_to_queue;
        kernel_h_rd_capture = kernel_h_rd_pending_q &&
                              kernel_h_rd_raw_stage_ready;
        kernel_h_rd_next_group = kernel_h_rd_group_q + 1'b1;
        // The P4 kernel's final-input condition is based on active_size (the
        // transform-support input cut), not necessarily the output group
        // count.  This distinction matters for LFNST and DST7/DCT8 support
        // cuts, where the H pass emits a wider result than it consumes.
        kernel_h_input_last_fire_c = kernel_input_group_fire &&
                                     (kernel_ctx_active_size_q != 7'd0) &&
                                     ((kernel_feed_group_q + 1'b1) >=
                                      (kernel_ctx_active_size_q >> 2));
    end

    always_comb begin
        kernel_rd_raw_capture = rd_cmd_response_fire &&
                                (rd_cmd_owner_q == RD_OWNER_PRIMARY_V);
    end

    always_comb begin : lfnst_gather_data_comb
        lfnst_gather_rd_data = '0;
        lfnst_gather_rd_valid = 1'b0;
        if (rd_cmd_valid_q &&
            (rd_cmd_owner_q == RD_OWNER_LFNST) &&
            rd_cmd_lfnst_valid_q) begin
            lfnst_gather_rd_data =
                input_rd_data[rd_cmd_slot_q][rd_cmd_lfnst_bank_q];
            lfnst_gather_rd_valid =
                input_rd_valid[rd_cmd_slot_q][rd_cmd_lfnst_bank_q];
        end
    end

    always_comb begin
        compute_valid = 1'b0;
        compute_slot = 1'b0;
        // A kernel run owns compute_slot_q and its phase metadata until the
        // horizontal pass has completed.  Do not admit another ready slot
        // while that run is active; otherwise a queued TU would overwrite the
        // in-flight kernel's owner and dimensions.
        if (!output_active && !kernel_run_q && !lfnst_run_q && !scrub_active) begin
            if (slot_state[0] == SLOT_READY) begin
                compute_valid = 1'b1;
                compute_slot = 1'b0;
            end else if (slot_state[1] == SLOT_READY) begin
                compute_valid = 1'b1;
                compute_slot = 1'b1;
            end
        end
    end

    // The wrapper presents one vector as four packed samples per kernel input
    // group.  Metadata and group counters are registered by the kernel; this
    // combinational adapter only selects the current column/row from the
    // already-owned intermediate arrays.
    integer kernel_lane_i;
    integer kernel_sample_index_i;
    always_comb begin
        kernel_start     = ((kernel_phase_q == K_V_START) &&
                            !kernel_start_sent_q) ||
                           ((kernel_phase_q == K_H_START) &&
                            !kernel_start_sent_q &&
                            kernel_h_rd_raw_pending_q &&
                            !kernel_h_input_commit_wait_q);
        if (!kernel_stage_q && !lfnst_case_q)
            kernel_in_valid = ((kernel_phase_q == K_V_START) ||
                               (kernel_phase_q == K_V_FEED)) &&
                              kernel_rd_return_valid &&
                              !kernel_input_vector_done;
        else if (kernel_stage_q)
            kernel_in_valid = ((kernel_phase_q == K_H_START) ||
                               (kernel_phase_q == K_H_FEED)) &&
                              kernel_h_rd_raw_pending_q &&
                              !kernel_h_input_commit_wait_q &&
                              !kernel_input_vector_done;
        else
            kernel_in_valid = (kernel_start ||
                              (kernel_phase_q == K_V_FEED)) &&
                              !kernel_input_vector_done;
        kernel_in_data = '0;
        for (kernel_lane_i = 0; kernel_lane_i < 4;
             kernel_lane_i = kernel_lane_i + 1) begin
            if (kernel_stage_q)
                kernel_sample_index_i = kernel_h_rd_raw_group_q * 4 +
                                        kernel_lane_i;
            else
                kernel_sample_index_i = kernel_feed_group_q * 4 + kernel_lane_i;
            if (kernel_in_valid && !kernel_stage_q) begin
                if (kernel_sample_index_i < kernel_cut_h_q) begin
                    if (lfnst_case_q) begin
                        // LFNST geometry is at most 8x8. Keep the physical
                        // address explicitly six bits wide and transpose the
                        // logical row-major coordinate (sample, vector) into
                        // vector-major storage. The range checks prevent
                        // truncation from aliasing an out-of-range coordinate.
                        if ((kernel_sample_index_i < 8) &&
                            (kernel_vector_q < 7'd8) &&
                            (kernel_vector_q < kernel_cut_w_q)) begin
                            if (lfnst_grid_valid[
                                    {kernel_vector_q[2:0],
                                     kernel_sample_index_i[2:0]}])
                                kernel_in_data[kernel_lane_i*16 +: 16] =
                                    lfnst_grid[
                                        {kernel_vector_q[2:0],
                                         kernel_sample_index_i[2:0]}];
                        end
                    end else if (kernel_rd_return_valid)
                        kernel_in_data[kernel_lane_i*16 +: 16] =
                            kernel_rd_return_data[kernel_lane_i*16 +: 16];
                end
            end else if (kernel_in_valid && kernel_stage_q) begin
                // V reconstructs every spatial row from its reduced input
                // support.  Only frequency columns outside cut_w are zero;
                // rows below cut_h contain valid reconstructed V results.
                if ((kernel_sample_index_i < kernel_cut_w_q) &&
                    (kernel_h_rd_raw_vector_q < kernel_h_q))
                    kernel_in_data[kernel_lane_i*16 +: 16] =
                        kernel_h_rd_data_q[
                            tmp_bank_for(kernel_h_rd_raw_vector_q,
                                         kernel_sample_index_i)*16 +: 16];
            end
        end
    end

`ifndef SYNTHESIS
    integer lfnst_grid_init_check_i;

    // Compare the vector-major implementation against the former logical
    // row-major layout on every LFNST group that the P4 kernel really accepts.
    always @(posedge clk) begin
        if (rst_n && kernel_input_group_fire && lfnst_case_q &&
            !kernel_stage_q) begin
            for (lfnst_gather_check_lane = 0;
                 lfnst_gather_check_lane < 4;
                 lfnst_gather_check_lane = lfnst_gather_check_lane + 1) begin
                lfnst_gather_check_sample = kernel_feed_group_q * 4 +
                                            lfnst_gather_check_lane;
                lfnst_gather_check_data = '0;
                if ((lfnst_gather_check_sample < kernel_cut_h_q) &&
                    (lfnst_gather_check_sample < 8) &&
                    (kernel_vector_q < kernel_cut_w_q) &&
                    (kernel_vector_q < 7'd8)) begin
                    lfnst_gather_check_addr =
                        lfnst_gather_check_sample * 8 + kernel_vector_q;
                    if (lfnst_grid_legacy_valid[lfnst_gather_check_addr])
                        lfnst_gather_check_data =
                            lfnst_grid_legacy[lfnst_gather_check_addr];
                end
                if (kernel_in_data[lfnst_gather_check_lane*16 +: 16] !==
                    lfnst_gather_check_data)
                    $fatal(1,
                        "LFNST transpose mismatch lane=%0d sample=%0d vector=%0d got=%0d expected=%0d",
                        lfnst_gather_check_lane, lfnst_gather_check_sample,
                        kernel_vector_q,
                        $signed(kernel_in_data[lfnst_gather_check_lane*16 +: 16]),
                        $signed(lfnst_gather_check_data));
            end
        end
    end

    // The token stage must finish before the LFNST engine can write the grid,
    // and admission must already have invalidated every old word.
    always @(posedge clk) begin
        if (rst_n && (|lfnst_grid_init_q)) begin
            if (lfnst_grid_init_q !== 8'hff)
                $fatal(1, "LFNST grid init tokens lost group alignment: %h",
                       lfnst_grid_init_q);
            for (lfnst_grid_init_check_i = 0;
                 lfnst_grid_init_check_i < 64;
                 lfnst_grid_init_check_i = lfnst_grid_init_check_i + 1) begin
                if (lfnst_grid_valid[lfnst_grid_init_check_i] !== 1'b0)
                    $fatal(1, "LFNST grid valid remained set during init addr=%0d",
                           lfnst_grid_init_check_i);
            end
            if (lfnst_out_valid)
                $fatal(1, "LFNST output overlapped pending grid initialization");
        end
    end
`endif

    // The overlapping kernel can become output-active on the same edge that
    // accepts its final input group.  Keep its output held while the wrapper
    // is still in a feed phase; otherwise group 0 would be consumed before
    // the wrapper enters its drain state.  The kernel output remains stable
    // until this drain-qualified request is asserted.
    always_comb begin
        kernel_out_req = kernel_run_q &&
                         ((kernel_phase_q == K_V_DRAIN) ||
                          (kernel_phase_q == K_H_DRAIN));
    end

    // A vertical output group is a real write transaction only when the
    // kernel output is being accepted by the wrapper.  The command fields are
    // generated from the current group metadata and then captured into the
    // registered boundary below.  The intermediate RAMs never see these live
    // kernel signals directly.
    integer vwrite_gen_bank_i;
    integer vwrite_gen_lane_i;
    always_comb begin : vwrite_command_generate
        vertical_result_fire = kernel_run_q &&
                               (kernel_phase_q == K_V_DRAIN) &&
                               kernel_out_valid && kernel_out_req;
        vwrite_cmd_bank_mask_c = 4'b0000;
        vwrite_cmd_addr_c = '0;
        vwrite_cmd_last_c = 1'b0;
        for (vwrite_gen_bank_i = 0; vwrite_gen_bank_i < 4;
             vwrite_gen_bank_i = vwrite_gen_bank_i + 1)
            vwrite_cmd_data_c[vwrite_gen_bank_i] = '0;

        if (vertical_result_fire) begin
            vwrite_cmd_addr_c = tmp_local_for_vwrite(
                kernel_drain_group_q, kernel_w_q, kernel_vector_q);
            vwrite_cmd_last_c =
                (kernel_vector_q == (kernel_cut_w_q - 1'b1)) &&
                (kernel_drain_group_q == ((kernel_h_q >> 2) - 1'b1));
            for (vwrite_gen_bank_i = 0; vwrite_gen_bank_i < 4;
                 vwrite_gen_bank_i = vwrite_gen_bank_i + 1) begin
                // Inverse of bank=(row+column)&3 for row=4*group+lane.
                // The subtraction is only two-bit modulo-4 permutation.
                vwrite_gen_lane_i =
                    (vwrite_gen_bank_i - (kernel_vector_q & 3)) & 3;
                if ((kernel_drain_group_q * 4 + vwrite_gen_lane_i) <
                    kernel_h_q) begin
                    vwrite_cmd_bank_mask_c[vwrite_gen_bank_i] = 1'b1;
                    vwrite_cmd_data_c[vwrite_gen_bank_i] =
                        $signed(kernel_out_data[vwrite_gen_lane_i*16 +: 16]);
                end
            end
        end
    end

    // A valid registered command is committed by the simple RAMs on this
    // edge.  Capture and commit may occur on the same edge for consecutive
    // groups, preserving write-command II=1.
    assign vwrite_cmd_commit = vwrite_cmd_valid_q;

`ifndef SYNTHESIS
    // The simplified V-write map is checked against the original generic
    // coordinate formula in simulation.  Since a supported vertical group
    // has four valid lanes, the explicit permutation must cover every bank
    // exactly once and all bank commands must share one local address.
    integer vwrite_assert_lane_i;
    integer vwrite_assert_lane_j;
    always @(posedge clk) begin
        if (vertical_result_fire) begin
            assert (vwrite_cmd_bank_mask_c == 4'b1111)
                else $error("P3 V-write bank collision/missing bank: mask=%b",
                            vwrite_cmd_bank_mask_c);
            assert (vwrite_cmd_addr_c ==
                    tmp_local_for(kernel_drain_group_q * 4,
                                  kernel_vector_q,
                                  kernel_w_q))
                else $error("P3 V-write local address mismatch");
            for (vwrite_assert_lane_i = 0;
                 vwrite_assert_lane_i < 4;
                 vwrite_assert_lane_i = vwrite_assert_lane_i + 1)
                for (vwrite_assert_lane_j = vwrite_assert_lane_i + 1;
                     vwrite_assert_lane_j < 4;
                     vwrite_assert_lane_j = vwrite_assert_lane_j + 1)
                    assert ((((vwrite_assert_lane_i +
                               (kernel_vector_q & 3)) & 3) !=
                              ((vwrite_assert_lane_j +
                               (kernel_vector_q & 3)) & 3)))
                        else $error("P3 V-write lane bank collision");
        end
        if (vwrite_cmd_commit)
            assert (vwrite_cmd_bank_mask_q != 4'b0000)
                else $error("P3 empty V-write command committed");
        if (horizontal_result_fire) begin
            assert (result_cmd_bank_mask_c == 4'b1111)
                else $error("P6 result write missing bank: mask=%b",
                            result_cmd_bank_mask_c);
            // Equivalence-only check: the old two-dimensional expression is
            // retained here under simulation, but never drives a RAM port.
            assert (result_cmd_addr_c ==
                    (kernel_vector_q * (kernel_w_q >> 2) + kernel_drain_group_q))
                else $error("P6 result beat address mismatch");
        end
        if (result_cmd_commit)
            assert (result_cmd_bank_mask_q != 4'b0000)
                else $error("P6 empty result write command committed");

        // P9 round 3 / R6 sparse-fill command invariants.  The target is one
        // physical slot/bank for every valid command, and data/valid writes
        // must be paired on that same commit edge.  The bank-local replicas
        // are checked against the global logical command so replication cannot
        // silently change ownership or payload.
        if (fill_wr_cmd_valid_q) begin
            assert ($onehot({fill_wr_cmd_target_q[1],
                             fill_wr_cmd_target_q[0]}))
                else $error("P9 fill command target is not onehot");
            assert ($onehot(fill_wr_bank_target_flat))
                else $error("R6 local fill command target is not onehot");
            assert ((fill_wr_bank_target_flat[3:0] == fill_wr_cmd_target_q[0]) &&
                    (fill_wr_bank_target_flat[7:4] == fill_wr_cmd_target_q[1]))
                else $error("R6 local/global fill target mismatch");
            for (vwrite_assert_lane_i = 0;
                 vwrite_assert_lane_i < 2;
                 vwrite_assert_lane_i = vwrite_assert_lane_i + 1)
                for (vwrite_assert_lane_j = 0;
                     vwrite_assert_lane_j < 4;
                     vwrite_assert_lane_j = vwrite_assert_lane_j + 1)
                    if (fill_wr_cmd_target_q[vwrite_assert_lane_i]
                                                        [vwrite_assert_lane_j]) begin
                        assert (input_data_wr_en[vwrite_assert_lane_i]
                                                        [vwrite_assert_lane_j] &&
                                input_valid_wr_en[vwrite_assert_lane_i]
                                                        [vwrite_assert_lane_j])
                            else $error("P9 fill data/valid commit mismatch");
                        assert (input_data_wr_addr[vwrite_assert_lane_i]
                                                          [vwrite_assert_lane_j] ==
                                fill_wr_bank_addr_q[vwrite_assert_lane_i]
                                                       [vwrite_assert_lane_j])
                            else $error("P9 fill data address mismatch");
                        assert (input_valid_wr_addr[vwrite_assert_lane_i]
                                                           [vwrite_assert_lane_j] ==
                                fill_wr_bank_addr_q[vwrite_assert_lane_i]
                                                       [vwrite_assert_lane_j])
                            else $error("P9 fill valid address mismatch");
                        assert (fill_wr_bank_addr_q[vwrite_assert_lane_i]
                                                       [vwrite_assert_lane_j] ==
                                fill_wr_cmd_addr_q)
                            else $error("R6 local/global fill address mismatch");
                        assert (fill_wr_bank_data_q[vwrite_assert_lane_i]
                                                       [vwrite_assert_lane_j] ==
                                fill_wr_cmd_data_q)
                            else $error("R6 local/global fill data mismatch");
                    end
            if (scrub_active)
                assert (!fill_wr_bank_target_q[scrub_slot][0] &&
                        !fill_wr_bank_target_q[scrub_slot][1] &&
                        !fill_wr_bank_target_q[scrub_slot][2] &&
                        !fill_wr_bank_target_q[scrub_slot][3])
                    else $error("P9 fill commit conflicts with scrub slot");
        end
        if (fill_end_pending_q)
            assert (slot_state[fill_end_slot_q] != SLOT_READY)
                else $error("P9 slot became READY with fill write pending");
        if (input_end_fire && !input_fire)
            assert ((fill_wr_cmd_target_c[0] == 4'b0000) &&
                    (fill_wr_cmd_target_c[1] == 4'b0000))
                else $error("P9 end-only marker generated a data command");
    end
`endif

    // A kernel request is only a real group transaction when the kernel's own
    // ownership/admission condition is true.  In particular, the vertical
    // START phase may last one cycle while the first cache read is in flight;
    // using the wrapper-visible ready signal alone would advance the phase
    // before any data was actually accepted.
    always_comb begin
        kernel_group_accept = kernel_input_group_fire;
    end

    always_comb begin
        it_data_out = 40'd0;
        if (output_active) begin
            it_data_out[9:0]   = result_rd_data[output_slot][0];
            it_data_out[19:10] = result_rd_data[output_slot][1];
            it_data_out[29:20] = result_rd_data[output_slot][2];
            it_data_out[39:30] = result_rd_data[output_slot][3];
        end
        // The contest contract gates the external valid by request.  The
        // held data/index itself does not move during a request-low stall.
        it_data_out_vld = output_active && it_data_out_req;
        output_fire = output_active && it_data_out_req;
        output_last_fire = output_fire &&
                           (output_index == output_last_index);
        it_done = output_last_fire;
    end

    // All memory writes are reduced to one fixed command per physical bank.
    // The wrapper may have several logical producers (sparse input, scrub,
    // vertical kernel results, and horizontal output), but ownership/state
    // makes these producers mutually exclusive for a given memory.
    always_comb begin : memory_command_comb
        integer cmd_slot_i, cmd_bank_i;
        for (cmd_slot_i = 0; cmd_slot_i < 2; cmd_slot_i = cmd_slot_i + 1) begin
            for (cmd_bank_i = 0; cmd_bank_i < 4; cmd_bank_i = cmd_bank_i + 1) begin
                input_data_wr_en[cmd_slot_i][cmd_bank_i] = 1'b0;
                input_data_wr_addr[cmd_slot_i][cmd_bank_i] = '0;
                input_data_wr_data[cmd_slot_i][cmd_bank_i] = '0;
                input_valid_wr_en[cmd_slot_i][cmd_bank_i] = 1'b0;
                input_valid_wr_addr[cmd_slot_i][cmd_bank_i] = '0;
                input_valid_wr_data[cmd_slot_i][cmd_bank_i] = 1'b0;
                result_wr_en[cmd_slot_i][cmd_bank_i] = 1'b0;
                result_wr_addr[cmd_slot_i][cmd_bank_i] = '0;
                result_wr_data[cmd_slot_i][cmd_bank_i] = '0;
                result_rd_addr[cmd_slot_i][cmd_bank_i] = output_index;
            end
        end
        for (cmd_bank_i = 0; cmd_bank_i < 4; cmd_bank_i = cmd_bank_i + 1) begin
            // Intermediate writes are driven exclusively by the registered
            // V-write command.  This is the physical timing cut: no live
            // kernel_group/vector/address decode reaches the RAM port.
            tmp_wr_en[cmd_bank_i] = vwrite_cmd_valid_q &&
                                    vwrite_cmd_bank_mask_q[cmd_bank_i];
            tmp_wr_addr[cmd_bank_i] = vwrite_cmd_addr_q;
            tmp_wr_data[cmd_bank_i] = vwrite_cmd_data_q[cmd_bank_i];
            tmp_rd_addr[cmd_bank_i] = '0;
        end

        // Scrubbing clears one local address in all four valid memories per
        // cycle.  It never writes the corresponding data memories.
        if (scrub_active) begin
            for (cmd_bank_i = 0; cmd_bank_i < 4; cmd_bank_i = cmd_bank_i + 1) begin
                input_valid_wr_en[scrub_slot][cmd_bank_i] = 1'b1;
                input_valid_wr_addr[scrub_slot][cmd_bank_i] = scrub_index;
                input_valid_wr_data[scrub_slot][cmd_bank_i] = 1'b0;
            end
        end

        // P9 round 3 / R6 candidate: the sparse-fill command is the only live
        // source allowed to drive the input-cache write ports.  The accepted
        // command is replicated into bank-local address/data/target registers;
        // the global command Q is deliberately absent from this physical path.
        // A target bit is the local valid for that bank, while the matching
        // valid-memory write is issued on the same commit edge as the data
        // write.  Addresses/data hold their last value when the target is low.
        for (cmd_slot_i = 0; cmd_slot_i < 2; cmd_slot_i = cmd_slot_i + 1) begin
            for (cmd_bank_i = 0; cmd_bank_i < 4; cmd_bank_i = cmd_bank_i + 1) begin
                input_data_wr_en[cmd_slot_i][cmd_bank_i] =
                    fill_wr_bank_target_q[cmd_slot_i][cmd_bank_i];
                input_data_wr_addr[cmd_slot_i][cmd_bank_i] =
                    fill_wr_bank_addr_q[cmd_slot_i][cmd_bank_i];
                input_data_wr_data[cmd_slot_i][cmd_bank_i] =
                    fill_wr_bank_data_q[cmd_slot_i][cmd_bank_i];
                // Preserve a scrub valid-clear command when no fill command
                // targets this bank.  The previous unconditional assignments
                // overwrote scrub's write-enable/address/data with zeros on
                // every scrub cycle, leaving stale valid tags when a slot was
                // reused by a later TU.  If a fill command is present it owns
                // the same data/valid commit edge (and wins only for its
                // one-hot target); a scrub on a different slot remains active.
                if (fill_wr_bank_target_q[cmd_slot_i][cmd_bank_i]) begin
                    input_valid_wr_en[cmd_slot_i][cmd_bank_i] = 1'b1;
                    input_valid_wr_addr[cmd_slot_i][cmd_bank_i] =
                        fill_wr_bank_addr_q[cmd_slot_i][cmd_bank_i];
                    input_valid_wr_data[cmd_slot_i][cmd_bank_i] = 1'b1;
                end
            end
        end

        // P9 round 5: the temporary-bank read address is a registered value.
        // Keep it driving the asynchronous RAM unconditionally; pending/run/
        // stage are transaction-valid metadata and must not form an address
        // mux in front of the RAMD64E address pins.  When no request is
        // pending, the address simply retains its last value and the response
        // path ignores the RAM data.
        for (cmd_bank_i = 0; cmd_bank_i < 4; cmd_bank_i = cmd_bank_i + 1)
            tmp_rd_addr[cmd_bank_i] = kernel_h_rd_addr_q[cmd_bank_i];

        // ResultMemory writes are driven only by the registered command below.
        // The live horizontal counters therefore cannot reach a distributed
        // RAM write-enable/address endpoint in this timing interval.
        if (result_cmd_valid_q) begin
            result_wr_en[result_cmd_slot_q][0] = result_cmd_bank_mask_q[0];
            result_wr_en[result_cmd_slot_q][1] = result_cmd_bank_mask_q[1];
            result_wr_en[result_cmd_slot_q][2] = result_cmd_bank_mask_q[2];
            result_wr_en[result_cmd_slot_q][3] = result_cmd_bank_mask_q[3];
            for (cmd_bank_i = 0; cmd_bank_i < 4; cmd_bank_i = cmd_bank_i + 1) begin
                result_wr_addr[result_cmd_slot_q][cmd_bank_i] = result_cmd_addr_q;
                result_wr_data[result_cmd_slot_q][cmd_bank_i] = result_cmd_data_q[cmd_bank_i];
            end
        end
    end

    // Capture one horizontal result group per cycle.  Legal widths are
    // multiples of four, so each accepted group writes exactly one word in
    // every physical bank.  The monotonically increasing beat counter is the
    // raster-order local address; it replaces the live vector*groups+group
    // expression on the physical RAM path.
    integer result_gen_bank_i;
    always_comb begin : result_command_generate
        horizontal_result_fire = kernel_run_q &&
                                 (kernel_phase_q == K_H_DRAIN) &&
                                 kernel_out_valid && kernel_out_req;
        result_cmd_bank_mask_c = 4'b0000;
        result_cmd_addr_c = result_write_beat_q;
        result_cmd_last_c = horizontal_result_fire &&
                            (result_write_beat_q ==
                             slot_output_last_index[compute_slot_q]);
        for (result_gen_bank_i = 0; result_gen_bank_i < 4;
             result_gen_bank_i = result_gen_bank_i + 1)
            result_cmd_data_c[result_gen_bank_i] = '0;
        if (horizontal_result_fire) begin
            result_cmd_bank_mask_c = 4'b1111;
            for (result_gen_bank_i = 0; result_gen_bank_i < 4;
                 result_gen_bank_i = result_gen_bank_i + 1)
                result_cmd_data_c[result_gen_bank_i] =
                    final_adapter($signed(kernel_out_data[result_gen_bank_i*16 +: 16]));
        end
    end

    assign result_cmd_commit = result_cmd_valid_q;

    // Raw data captures directly from the asynchronous bank outputs.  Valid
    // and metadata are reset in the main control process below; keeping this
    // payload register unreset avoids adding reset muxing to the read path.
    always_ff @(posedge clk) begin
        if (kernel_h_rd_capture) begin
            for (kernel_h_raw_capture_bank_i = 0;
                 kernel_h_raw_capture_bank_i < 4;
                 kernel_h_raw_capture_bank_i =
                     kernel_h_raw_capture_bank_i + 1)
                kernel_h_rd_raw_data_q[kernel_h_raw_capture_bank_i] <=
                    tmp_rd_data[kernel_h_raw_capture_bank_i];
        end
    end

    integer reset_i, lfnst_grid_i;
    integer lfnst_grid_init_i;
    integer fill_replica_slot_i, fill_replica_bank_i;
    integer rd_cmd_reset_slot_i, rd_cmd_reset_bank_i;
    integer rd_cmd_load_slot_i, rd_cmd_load_bank_i;
    integer primary_reset_i, primary_update_slot_i, primary_update_bank_i;
    integer kernel_capture_lane_i;
    integer lfnst_write_addr;
    integer lfnst_write_storage_addr;
    always_ff @(posedge clk or negedge rst_n) begin
        if (!rst_n) begin
            desc_rd_ptr   <= 1'b0;
            desc_wr_ptr   <= 1'b0;
            desc_count    <= 2'd0;
            fill_active   <= 1'b0;
            fill_slot     <= 1'b0;
            scrub_active  <= 1'b0;
            scrub_slot    <= 1'b0;
            scrub_index   <= 12'd0;
            output_active <= 1'b0;
            output_slot   <= 1'b0;
            output_index  <= 12'd0;
            output_last_index <= 12'd0;
            compute_slot_q <= 1'b0;
            kernel_run_q <= 1'b0;
            kernel_phase_q <= K_IDLE;
            kernel_w_q <= 7'd0;
            kernel_h_q <= 7'd0;
            kernel_cut_w_q <= 7'd0;
            kernel_cut_h_q <= 7'd0;
            kernel_vector_q <= 7'd0;
            kernel_feed_group_q <= 5'd0;
            kernel_drain_group_q <= 5'd0;
            kernel_type_q <= 2'd0;
            kernel_stage_q <= 1'b0;
            kernel_ctx_stage_q <= 1'b0;
            kernel_ctx_transform_size_q <= 7'd0;
            kernel_ctx_active_size_q <= 7'd0;
            kernel_ctx_output_size_q <= 7'd0;
            kernel_ctx_group_count_q <= 6'd0;
            vwrite_cmd_valid_q <= 1'b0;
            vwrite_cmd_bank_mask_q <= 4'b0000;
            vwrite_cmd_addr_q <= '0;
            vwrite_cmd_last_q <= 1'b0;
            vwrite_last_commit_seen_q <= 1'b0;
            for (kernel_capture_lane_i = 0; kernel_capture_lane_i < 4;
                 kernel_capture_lane_i = kernel_capture_lane_i + 1)
                vwrite_cmd_data_q[kernel_capture_lane_i] <= '0;
            result_cmd_valid_q <= 1'b0;
            result_cmd_slot_q <= 1'b0;
            result_cmd_bank_mask_q <= 4'b0000;
            result_cmd_addr_q <= '0;
            result_cmd_last_q <= 1'b0;
            result_last_commit_seen_q <= 1'b0;
            result_write_beat_q <= '0;
            for (kernel_capture_lane_i = 0; kernel_capture_lane_i < 4;
                 kernel_capture_lane_i = kernel_capture_lane_i + 1)
                result_cmd_data_q[kernel_capture_lane_i] <= '0;
            fill_wr_cmd_valid_q <= 1'b0;
            fill_wr_cmd_addr_q <= '0;
            fill_wr_cmd_data_q <= '0;
            fill_end_pending_q <= 1'b0;
            fill_end_slot_q <= 1'b0;
            for (reset_i = 0; reset_i < 2; reset_i = reset_i + 1)
                fill_wr_cmd_target_q[reset_i] <= 4'b0000;
            for (fill_replica_slot_i = 0;
                 fill_replica_slot_i < 2;
                 fill_replica_slot_i = fill_replica_slot_i + 1)
                for (fill_replica_bank_i = 0;
                     fill_replica_bank_i < 4;
                     fill_replica_bank_i = fill_replica_bank_i + 1) begin
                    fill_wr_bank_addr_q[fill_replica_slot_i]
                                           [fill_replica_bank_i] <= '0;
                    fill_wr_bank_data_q[fill_replica_slot_i]
                                           [fill_replica_bank_i] <= '0;
                    fill_wr_bank_target_q[fill_replica_slot_i]
                                             [fill_replica_bank_i] <= 1'b0;
                end
            kernel_rd_req_pending_q <= 1'b0;
            kernel_rd_req_group_q <= 5'd0;
            kernel_rd_req_vector_q <= 7'd0;
            kernel_rd_raw_pending_q <= 1'b0;
            kernel_rd_raw_slot_q <= 1'b0;
            kernel_rd_raw_bank_mask_q <= 4'b0000;
            kernel_rd_raw_group_q <= 5'd0;
            kernel_rd_raw_vector_q <= 7'd0;
            primary_outstanding_q <= 3'd0;
            primary_return_wr_ptr_q <= 2'd0;
            primary_return_rd_ptr_q <= 2'd0;
            primary_return_count_q <= 3'd0;
            rd_cmd_valid_q <= 1'b0;
            rd_cmd_owner_q <= RD_OWNER_PRIMARY_V;
            rd_cmd_slot_q <= 1'b0;
            rd_cmd_bank_mask_q <= 4'b0000;
            rd_cmd_group_q <= 5'd0;
            rd_cmd_vector_q <= 7'd0;
            rd_cmd_lfnst_index_q <= 5'd0;
            rd_cmd_lfnst_valid_q <= 1'b0;
            rd_cmd_lfnst_last_q <= 1'b0;
            rd_cmd_lfnst_bank_q <= 2'd0;
            for (rd_cmd_reset_slot_i = 0;
                 rd_cmd_reset_slot_i < 2;
                 rd_cmd_reset_slot_i = rd_cmd_reset_slot_i + 1)
                for (rd_cmd_reset_bank_i = 0;
                     rd_cmd_reset_bank_i < 4;
                     rd_cmd_reset_bank_i = rd_cmd_reset_bank_i + 1) begin
                    rd_cmd_addr_q[rd_cmd_reset_slot_i][rd_cmd_reset_bank_i] <= '0;
                    rd_cmd_bank_valid_q[rd_cmd_reset_slot_i]
                                         [rd_cmd_reset_bank_i] <= 1'b0;
                    kernel_rd_bank_valid_q[rd_cmd_reset_slot_i]
                                            [rd_cmd_reset_bank_i] <= 1'b0;
                end
            kernel_h_rd_pending_q <= 1'b0;
            kernel_h_rd_group_q <= 5'd0;
            kernel_h_rd_vector_q <= 7'd0;
            kernel_h_rd_raw_stage_valid_q <= 1'b0;
            kernel_h_rd_raw_stage_group_q <= 5'd0;
            kernel_h_rd_raw_stage_vector_q <= 7'd0;
            kernel_h_width_q <= 7'd0;
            kernel_h_groups_per_row_q <= 5'd0;
            kernel_h_groups_left_q <= 5'd0;
            kernel_h_rows_left_q <= 7'd0;
            kernel_h_row_phase_q <= 2'd0;
            kernel_h_rd_data_q <= '0;
            kernel_h_rd_raw_pending_q <= 1'b0;
            kernel_h_rd_raw_group_q <= 5'd0;
            kernel_h_rd_raw_vector_q <= 7'd0;
            kernel_h_rd_data_tail_q <= '0;
            kernel_h_rd_raw_tail_pending_q <= 1'b0;
            kernel_h_rd_raw_tail_group_q <= 5'd0;
            kernel_h_rd_raw_tail_vector_q <= 7'd0;
            kernel_h_input_commit_wait_q <= 1'b0;
            for (kernel_h_seq_addr_i = 0; kernel_h_seq_addr_i < 4;
                 kernel_h_seq_addr_i = kernel_h_seq_addr_i + 1) begin
                kernel_h_rd_addr_q[kernel_h_seq_addr_i] <= '0;
                kernel_h_row_base_q[kernel_h_seq_addr_i] <=
                    BANK_ADDR_W'(kernel_h_seq_addr_i);
            end
            kernel_start_sent_q <= 1'b0;
            lfnst_run_q <= 1'b0;
            lfnst_case_q <= 1'b0;
            lfnst_gather_q <= 1'b0;
            lfnst_gather_index_q <= 5'd0;
            lfnst_mem_req_q <= 1'b0;
            lfnst_mem_req_index_q <= 5'd0;
            lfnst_mem_req_addr_q <= '0;
            lfnst_mem_req_valid_q <= 1'b0;
            lfnst_mem_req_last_q <= 1'b0;
            lfnst_mem_req_slot_q <= 1'b0;
            lfnst_mem_req_bank_q <= 2'd0;
            lfnst_mem_resp_pending_q <= 1'b0;
            lfnst_mem_resp_index_q <= 5'd0;
            lfnst_mem_resp_data_q <= '0;
            lfnst_mem_resp_valid_q <= 1'b0;
            lfnst_mem_resp_last_q <= 1'b0;
            lfnst_input_terms_q <= '0;
            lfnst_grid_init_q <= 8'b0;
            lfnst_start_q <= 1'b0;
            lfnst_slot_q <= 1'b0;
            lfnst_ntrs48_q <= 1'b0;
            lfnst_nonzero8_q <= 1'b0;
            lfnst_set_q <= 2'd0;
            lfnst_idx_q <= 2'd0;
            protocol_error <= 1'b0;
            for (reset_i = 0; reset_i < 2; reset_i = reset_i + 1) begin
                slot_state[reset_i]  <= SLOT_FREE;
                slot_width[reset_i]  <= 7'd0;
                slot_height[reset_i] <= 7'd0;
                slot_hor[reset_i]    <= 2'd0;
                slot_ver[reset_i]    <= 2'd0;
                slot_set[reset_i]    <= 2'd0;
                slot_lfnst[reset_i]  <= 2'd0;
                slot_point_count[reset_i] <= 13'd0;
                slot_last_input_addr[reset_i] <= 12'd0;
                slot_output_last_index[reset_i] <= 12'd0;
            end
            for (lfnst_grid_i = 0; lfnst_grid_i < 64; lfnst_grid_i = lfnst_grid_i + 1) begin
                lfnst_grid[lfnst_grid_i] <= '0;
                lfnst_grid_valid[lfnst_grid_i] <= 1'b0;
`ifndef SYNTHESIS
                lfnst_grid_legacy[lfnst_grid_i] <= '0;
                lfnst_grid_legacy_valid[lfnst_grid_i] <= 1'b0;
`endif
            end
        end else begin
            // A one-cycle pulse starts the bounded LFNST engine on the next
            // edge, after compute_slot_q and its descriptor metadata settle.
            lfnst_start_q <= 1'b0;

            // The current LFNST admission edge loads eight local clear tokens.
            // On the following edge, each token clears its own eight-word
            // group. This retains the per-TU data initialization while moving
            // slot arbitration and mode decode off the grid data CE cone.
            lfnst_grid_init_q <= 8'b0;
            for (lfnst_grid_init_i = 0; lfnst_grid_init_i < 64;
                 lfnst_grid_init_i = lfnst_grid_init_i + 1) begin
                if (lfnst_grid_init_q[lfnst_grid_init_i / 8])
                    lfnst_grid[lfnst_grid_init_i] <= '0;
            end

            // P9 round 3 sparse-fill write command.  The old command commits
            // on this edge; a newly accepted point may refill the same entry
            // without a bubble.  The command Q fields, rather than the live
            // fill slot/address decode, drive the cache write ports.
            if (fill_wr_cmd_commit) begin
                fill_wr_cmd_valid_q <= 1'b0;
                fill_wr_cmd_target_q[0] <= 4'b0000;
                fill_wr_cmd_target_q[1] <= 4'b0000;
                for (fill_replica_slot_i = 0;
                     fill_replica_slot_i < 2;
                     fill_replica_slot_i = fill_replica_slot_i + 1)
                    for (fill_replica_bank_i = 0;
                         fill_replica_bank_i < 4;
                         fill_replica_bank_i = fill_replica_bank_i + 1)
                        fill_wr_bank_target_q[fill_replica_slot_i]
                                                 [fill_replica_bank_i] <= 1'b0;
            end
            if (input_fire) begin
                fill_wr_cmd_valid_q <= 1'b1;
                fill_wr_cmd_addr_q <= fill_wr_cmd_addr_c;
                fill_wr_cmd_data_q <= fill_wr_cmd_data_c;
                fill_wr_cmd_target_q[0] <= fill_wr_cmd_target_c[0];
                fill_wr_cmd_target_q[1] <= fill_wr_cmd_target_c[1];
                // Replicate the accepted payload to every physical bank.  The
                // target bit is the only local validity/WE qualifier, so a
                // commit followed by a refill remains atomic and bubble-free.
                for (fill_replica_slot_i = 0;
                     fill_replica_slot_i < 2;
                     fill_replica_slot_i = fill_replica_slot_i + 1)
                    for (fill_replica_bank_i = 0;
                         fill_replica_bank_i < 4;
                         fill_replica_bank_i = fill_replica_bank_i + 1) begin
                        fill_wr_bank_addr_q[fill_replica_slot_i]
                                               [fill_replica_bank_i] <=
                            fill_wr_cmd_addr_c;
                        fill_wr_bank_data_q[fill_replica_slot_i]
                                               [fill_replica_bank_i] <=
                            fill_wr_cmd_data_c;
                        fill_wr_bank_target_q[fill_replica_slot_i]
                                                 [fill_replica_bank_i] <=
                            fill_wr_cmd_target_c[fill_replica_slot_i]
                                                  [fill_replica_bank_i];
                    end
            end

            // Fixed one-edge physical command stage. Primary-V acceptance
            // uses registered return capacity; response consumption cannot
            // feed the address-register CE in this cycle.
            rd_cmd_valid_q <= rd_cmd_accept;
            if (rd_cmd_accept) begin
                rd_cmd_owner_q <= rd_cmd_candidate_owner;
                rd_cmd_slot_q <= rd_cmd_candidate_slot;
                rd_cmd_bank_mask_q <= rd_cmd_candidate_bank_mask;
                rd_cmd_group_q <= rd_cmd_candidate_group;
                rd_cmd_vector_q <= rd_cmd_candidate_vector;
                rd_cmd_lfnst_index_q <= rd_cmd_candidate_lfnst_index;
                rd_cmd_lfnst_valid_q <= rd_cmd_candidate_lfnst_valid;
                rd_cmd_lfnst_last_q <= rd_cmd_candidate_lfnst_last;
                rd_cmd_lfnst_bank_q <= rd_cmd_candidate_lfnst_bank;
                for (rd_cmd_load_slot_i = 0;
                     rd_cmd_load_slot_i < 2;
                     rd_cmd_load_slot_i = rd_cmd_load_slot_i + 1)
                    for (rd_cmd_load_bank_i = 0;
                         rd_cmd_load_bank_i < 4;
                         rd_cmd_load_bank_i = rd_cmd_load_bank_i + 1) begin
                        rd_cmd_addr_q[rd_cmd_load_slot_i][rd_cmd_load_bank_i] <=
                            rd_cmd_candidate_addr_c[rd_cmd_load_slot_i]
                                                       [rd_cmd_load_bank_i];
                        rd_cmd_bank_valid_q[rd_cmd_load_slot_i]
                                             [rd_cmd_load_bank_i] <=
                            (rd_cmd_load_slot_i == rd_cmd_candidate_slot) &&
                            ((rd_cmd_candidate_owner == RD_OWNER_PRIMARY_V) ||
                             (rd_cmd_load_bank_i ==
                              rd_cmd_candidate_lfnst_bank));
                    end
            end else begin
                rd_cmd_bank_mask_q <= 4'b0000;
                for (rd_cmd_load_slot_i = 0;
                     rd_cmd_load_slot_i < 2;
                     rd_cmd_load_slot_i = rd_cmd_load_slot_i + 1)
                    for (rd_cmd_load_bank_i = 0;
                         rd_cmd_load_bank_i < 4;
                         rd_cmd_load_bank_i = rd_cmd_load_bank_i + 1)
                        rd_cmd_bank_valid_q[rd_cmd_load_slot_i]
                                             [rd_cmd_load_bank_i] <= 1'b0;
            end

            // P3 vertical write-command pipeline.  The old command is
            // committed by the intermediate RAMs on this edge; a new result
            // group may replace it at the same edge, preserving II=1.
            if (vwrite_cmd_commit && vwrite_cmd_last_q)
                vwrite_last_commit_seen_q <= 1'b1;
            if (vertical_result_fire) begin
                vwrite_cmd_valid_q <= 1'b1;
                vwrite_cmd_bank_mask_q <= vwrite_cmd_bank_mask_c;
                vwrite_cmd_addr_q <= vwrite_cmd_addr_c;
                vwrite_cmd_last_q <= vwrite_cmd_last_c;
                for (kernel_capture_lane_i = 0;
                     kernel_capture_lane_i < 4;
                     kernel_capture_lane_i = kernel_capture_lane_i + 1)
                    vwrite_cmd_data_q[kernel_capture_lane_i] <=
                        vwrite_cmd_data_c[kernel_capture_lane_i];
            end else begin
                vwrite_cmd_valid_q <= 1'b0;
                vwrite_cmd_bank_mask_q <= 4'b0000;
                vwrite_cmd_addr_q <= '0;
                vwrite_cmd_last_q <= 1'b0;
            end
            if (compute_valid)
                vwrite_last_commit_seen_q <= 1'b0;

            // P6 horizontal result-write command pipeline.  The registered
            // command is committed by ResultMemory on this edge while a new
            // horizontal result may be captured for the next edge, preserving
            // one accepted result group per cycle.
            if (result_cmd_commit && result_cmd_last_q)
                result_last_commit_seen_q <= 1'b1;
            if (horizontal_result_fire) begin
                result_cmd_valid_q <= 1'b1;
                result_cmd_slot_q <= compute_slot_q;
                result_cmd_bank_mask_q <= result_cmd_bank_mask_c;
                result_cmd_addr_q <= result_cmd_addr_c;
                result_cmd_last_q <= result_cmd_last_c;
                for (kernel_capture_lane_i = 0;
                     kernel_capture_lane_i < 4;
                     kernel_capture_lane_i = kernel_capture_lane_i + 1)
                    result_cmd_data_q[kernel_capture_lane_i] <=
                        result_cmd_data_c[kernel_capture_lane_i];
                result_write_beat_q <= result_write_beat_q + 1'b1;
            end else begin
                result_cmd_valid_q <= 1'b0;
                result_cmd_bank_mask_q <= 4'b0000;
                result_cmd_addr_q <= '0;
                result_cmd_last_q <= 1'b0;
            end
            if (compute_valid) begin
                result_last_commit_seen_q <= 1'b0;
                result_write_beat_q <= '0;
            end

            // The command and raw stages advance every cycle. Each accepted
            // primary request already owns a return credit, so neither stage
            // uses the kernel's same-edge input fire as a ready/CE source.
            if (kernel_start)
                kernel_start_sent_q <= 1'b1;
            if (!kernel_run_q || kernel_stage_q || lfnst_case_q)
                kernel_rd_req_pending_q <= 1'b0;

            // Sample only the addressed physical banks. The command's
            // registered one-hot bank-valid bits are local capture enables;
            // no slot mux or kernel consume signal is in these data cones.
            for (primary_update_slot_i = 0;
                 primary_update_slot_i < 2;
                 primary_update_slot_i = primary_update_slot_i + 1)
                for (primary_update_bank_i = 0;
                     primary_update_bank_i < 4;
                     primary_update_bank_i = primary_update_bank_i + 1)
                    if (rd_cmd_bank_valid_q[primary_update_slot_i]
                                              [primary_update_bank_i]) begin
                        kernel_rd_bank_data_q[primary_update_slot_i]
                                                [primary_update_bank_i] <=
                            input_rd_data[primary_update_slot_i]
                                          [primary_update_bank_i];
                        kernel_rd_bank_valid_q[primary_update_slot_i]
                                                 [primary_update_bank_i] <=
                            input_rd_valid[primary_update_slot_i]
                                          [primary_update_bank_i];
                    end

            kernel_rd_raw_pending_q <= kernel_rd_raw_capture;
            if (kernel_rd_raw_capture) begin
                kernel_rd_raw_slot_q <= rd_cmd_slot_q;
                kernel_rd_raw_bank_mask_q <= rd_cmd_bank_mask_q;
                kernel_rd_raw_group_q <= rd_cmd_group_q;
                kernel_rd_raw_vector_q <= rd_cmd_vector_q;
            end

            // The raw stage always drains into a slot reserved at request
            // acceptance. The FIFO uses a circular write pointer, so its
            // payload write enable is local to one 64-bit entry.
            if (primary_return_push) begin
                primary_return_data_q[primary_return_wr_ptr_q] <=
                    kernel_rd_data_comb;
                primary_return_wr_ptr_q <= primary_return_wr_ptr_q + 1'b1;
            end
            if (primary_return_pop)
                primary_return_rd_ptr_q <= primary_return_rd_ptr_q + 1'b1;
            case ({primary_return_push, primary_return_pop})
                2'b10: primary_return_count_q <= primary_return_count_q + 1'b1;
                2'b01: primary_return_count_q <= primary_return_count_q - 1'b1;
                default: primary_return_count_q <= primary_return_count_q;
            endcase

            case ({primary_logical_req_fire, primary_return_pop})
                2'b10: primary_outstanding_q <= primary_outstanding_q + 1'b1;
                2'b01: primary_outstanding_q <= primary_outstanding_q - 1'b1;
                default: primary_outstanding_q <= primary_outstanding_q;
            endcase

            // The request counter advances on accepted issue, independent of
            // response consumption. It therefore cannot inherit the ready
            // path through kernel_input_group_fire.
            if (primary_logical_req_fire) begin
                if (kernel_rd_req_group_q ==
                    ((kernel_cut_h_q >> 2) - 1'b1)) begin
                    kernel_rd_req_pending_q <= 1'b0;
                end else begin
                    kernel_rd_req_group_q <= kernel_rd_req_group_q + 1'b1;
                end
            end

            // Horizontal intermediate reads have a registered request
            // address followed by a bank-response register.  A response can
            // be replaced on the same edge on which the kernel accepts the
            // previous group, so the steady-state group cadence remains one.
            if (!kernel_run_q || !kernel_stage_q ||
                ((kernel_phase_q != K_H_START) &&
                 (kernel_phase_q != K_H_FEED))) begin
                kernel_h_rd_pending_q <= 1'b0;
                kernel_h_rd_raw_stage_valid_q <= 1'b0;
                kernel_h_rd_raw_pending_q <= 1'b0;
                kernel_h_rd_raw_tail_pending_q <= 1'b0;
            end else if (kernel_h_input_commit_wait_q &&
                         !kernel_input_vector_done) begin
                // The last H input group has fired into the kernel ingress,
                // but input_mem is not complete until the next commit edge.
                // Hold all read/request state during this one-cycle handoff;
                // otherwise K_H_START can prefetch the next row, and that
                // response would be dropped when the phase changes to drain.
            end else begin
                // Start a new horizontal row by issuing group zero.  The
                // address is captured here; tmp RAM is read during the next
                // cycle and sampled into the response register afterwards.
                if ((kernel_phase_q == K_H_START) &&
                    !kernel_h_rd_pending_q &&
                    !kernel_h_rd_raw_stage_valid_q &&
                    !kernel_h_rd_raw_pending_q &&
                    !kernel_h_rd_raw_tail_pending_q) begin
                    kernel_h_rd_group_q <= 5'd0;
                    kernel_h_rd_vector_q <= kernel_vector_q;
                    kernel_h_groups_left_q <= kernel_h_groups_per_row_q;
                    for (kernel_h_seq_addr_i = 0; kernel_h_seq_addr_i < 4;
                         kernel_h_seq_addr_i = kernel_h_seq_addr_i + 1)
                        kernel_h_rd_addr_q[kernel_h_seq_addr_i] <=
                            kernel_h_row_base_q[kernel_h_seq_addr_i];
                    kernel_h_rd_pending_q <= 1'b1;
                end

                // Retire the old raw-stage word into the response queue.
                // If the head consumes while the tail is empty, refill the
                // head directly.  When the tail is occupied, a consume moves
                // that entry to the head and the raw word remains stable for
                // the next edge; this keeps consume out of raw-stage ready.
                if (kernel_h_rd_consume) begin
                    if (kernel_h_rd_raw_tail_pending_q) begin
                        kernel_h_rd_data_q <= kernel_h_rd_data_tail_q;
                        kernel_h_rd_raw_group_q <= kernel_h_rd_raw_tail_group_q;
                        kernel_h_rd_raw_vector_q <= kernel_h_rd_raw_tail_vector_q;
                        kernel_h_rd_raw_pending_q <= 1'b1;
                        kernel_h_rd_raw_tail_pending_q <= 1'b0;
                    end else if (!kernel_h_rd_raw_to_queue) begin
                        kernel_h_rd_raw_pending_q <= 1'b0;
                    end
                end

                if (kernel_h_rd_raw_to_queue) begin
                    if (!kernel_h_rd_raw_pending_q || kernel_h_rd_consume) begin
                        for (kernel_h_seq_capture_bank_i = 0;
                             kernel_h_seq_capture_bank_i < 4;
                             kernel_h_seq_capture_bank_i =
                                 kernel_h_seq_capture_bank_i + 1)
                            kernel_h_rd_data_q[kernel_h_seq_capture_bank_i*16 +: 16] <=
                                kernel_h_rd_raw_data_q[kernel_h_seq_capture_bank_i];
                        kernel_h_rd_raw_group_q <=
                            kernel_h_rd_raw_stage_group_q;
                        kernel_h_rd_raw_vector_q <=
                            kernel_h_rd_raw_stage_vector_q;
                        kernel_h_rd_raw_pending_q <= 1'b1;
                    end else begin
                        for (kernel_h_seq_capture_bank_i = 0;
                             kernel_h_seq_capture_bank_i < 4;
                             kernel_h_seq_capture_bank_i =
                                 kernel_h_seq_capture_bank_i + 1)
                            kernel_h_rd_data_tail_q[kernel_h_seq_capture_bank_i*16 +: 16] <=
                                kernel_h_rd_raw_data_q[kernel_h_seq_capture_bank_i];
                        kernel_h_rd_raw_tail_group_q <=
                            kernel_h_rd_raw_stage_group_q;
                        kernel_h_rd_raw_tail_vector_q <=
                            kernel_h_rd_raw_stage_vector_q;
                        kernel_h_rd_raw_tail_pending_q <= 1'b1;
                    end
                    kernel_h_rd_raw_stage_valid_q <= 1'b0;
                end

                // Refill the raw stage from the current asynchronous RAM
                // response.  This assignment follows its old-word dequeue so
                // same-edge dequeue/refill leaves the stage valid.
                if (kernel_h_rd_capture) begin
                    kernel_h_rd_raw_stage_valid_q <= 1'b1;
                    kernel_h_rd_raw_stage_group_q <= kernel_h_rd_group_q;
                    kernel_h_rd_raw_stage_vector_q <= kernel_h_rd_vector_q;
                    if (kernel_h_groups_left_q > 5'd1) begin
                        // The next group in the same row is a fixed local
                        // increment.  No width/row decode is on this path.
                        kernel_h_groups_left_q <=
                            kernel_h_groups_left_q - 1'b1;
                        kernel_h_rd_group_q <= kernel_h_rd_next_group;
                        for (kernel_h_seq_addr_i = 0; kernel_h_seq_addr_i < 4;
                             kernel_h_seq_addr_i = kernel_h_seq_addr_i + 1)
                            kernel_h_rd_addr_q[kernel_h_seq_addr_i] <=
                                kernel_h_rd_addr_advance_c[kernel_h_seq_addr_i];
                        kernel_h_rd_pending_q <= 1'b1;
                    end else if (kernel_h_rows_left_q > 7'd1) begin
                        // The final group of a row is complete.  Prepare the
                        // next row base using only registered row state; the
                        // next request itself is issued at K_H_START after
                        // the kernel drains this row.
                        kernel_h_rows_left_q <=
                            kernel_h_rows_left_q - 1'b1;
                        kernel_h_groups_left_q <= kernel_h_groups_per_row_q;
                        kernel_h_row_phase_q <= kernel_h_row_phase_q + 1'b1;
                        for (kernel_h_seq_addr_i = 0;
                             kernel_h_seq_addr_i < 4;
                             kernel_h_seq_addr_i = kernel_h_seq_addr_i + 1)
                            kernel_h_row_base_q[kernel_h_seq_addr_i] <=
                                kernel_h_row_base_next_c[kernel_h_seq_addr_i];
                        kernel_h_rd_group_q <= 5'd0;
                        kernel_h_rd_pending_q <= 1'b0;
                    end else begin
                        kernel_h_groups_left_q <= 5'd0;
                        kernel_h_rows_left_q <= 7'd0;
                        kernel_h_rd_pending_q <= 1'b0;
                    end
                end
            end

            // A logical LFNST request remains held until the atomic physical
            // command accepts it.  When it is accepted, the next gather
            // request may refill this logical-request register on the same
            // edge, preserving one request per cycle in steady state.
            lfnst_mem_resp_pending_q <= 1'b0;
            if (lfnst_mem_req_q && lfnst_mem_req_accept)
                lfnst_mem_req_q <= 1'b0;

            // Commit the registered cache response.  This is deliberately a
            // separate edge from both address generation and cache read, so
            // the source-index/address network cannot reach the term/grid
            // write endpoint in one long combinational path.
            if (lfnst_mem_resp_pending_q) begin
                lfnst_input_terms_q[lfnst_mem_resp_index_q*16 +: 16] <=
                    lfnst_mem_resp_valid_q ? lfnst_mem_resp_data_q : '0;
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
