hahayyf666-netizen/ITS_NEW/03_verification/tb/p2f_dct2_64_b1_tb.sv

`timescale 1ns/1ps
module p2f_dct2_64_b1_tb;
    localparam integer NUM_CASES = 49;
    reg clk;
    reg rst_n;
    reg vector_start;
    reg [15:0] vector_id_in;
    reg [1023:0] vector_data_flat;
    reg result_accept;
    wire result_valid;
    wire [4:0] result_group;
    wire [15:0] result_vector_id;
    wire result_first, result_last;
    wire [159:0] result_raw_flat, result_biased_flat, result_shifted_flat;
    wire [63:0] result_stage16_flat;
    wire [39:0] result_final10_flat;

    reg [1023:0] case_input [0:NUM_CASES-1];
    reg [159:0] exp_raw [0:NUM_CASES-1][0:15];
    reg [159:0] exp_biased [0:NUM_CASES-1][0:15];
    reg [159:0] exp_shifted [0:NUM_CASES-1][0:15];
    reg [63:0] exp_stage16 [0:NUM_CASES-1][0:15];
    reg [39:0] exp_final10 [0:NUM_CASES-1][0:15];
    integer seen_groups [0:NUM_CASES-1];
    integer launch_tick [0:NUM_CASES-1];
    integer first_fire_tick [0:NUM_CASES-1];
    integer last_fire_tick [0:NUM_CASES-1];
    integer tick;
    integer errors;
    integer total_fires;
    integer global_gap_count;
    integer previous_global_fire_tick;
    integer c, g, vid;

    p2f_dct2_64_b1_step102 dut (
        .clk(clk), .rst_n(rst_n), .vector_start(vector_start),
        .vector_id_in(vector_id_in), .vector_data_flat(vector_data_flat),
        .result_accept(result_accept), .result_valid(result_valid),
        .result_group(result_group), .result_vector_id(result_vector_id),
        .result_first(result_first), .result_last(result_last),
        .result_raw_flat(result_raw_flat),
        .result_biased_flat(result_biased_flat),
        .result_shifted_flat(result_shifted_flat),
        .result_stage16_flat(result_stage16_flat),
        .result_final10_flat(result_final10_flat)
    );

    always #1 clk = ~clk;

    initial begin
    case_input[0] = 1024'h0000000000000000000000000000000000000000000000000000000000000000000000000000000000000000000000000000000000000000000000000000000000000000000000000000000000000000000000000000000000000000000000000000000000000000000000000000000000000000000000000000000000000000;
    exp_raw[0][0] = 160'h0000000000000000000000000000000000000000;
    exp_biased[0][0] = 160'h0000000020000000002000000000200000000020;
    exp_shifted[0][0] = 160'h0000000000000000000000000000000000000000;
    exp_stage16[0][0] = 64'h0000000000000000;
    exp_final10[0][0] = 40'h0000000000;
    exp_raw[0][1] = 160'h0000000000000000000000000000000000000000;
    exp_biased[0][1] = 160'h0000000020000000002000000000200000000020;
    exp_shifted[0][1] = 160'h0000000000000000000000000000000000000000;
    exp_stage16[0][1] = 64'h0000000000000000;
    exp_final10[0][1] = 40'h0000000000;
    exp_raw[0][2] = 160'h0000000000000000000000000000000000000000;
    exp_biased[0][2] = 160'h0000000020000000002000000000200000000020;
    exp_shifted[0][2] = 160'h0000000000000000000000000000000000000000;
    exp_stage16[0][2] = 64'h0000000000000000;
    exp_final10[0][2] = 40'h0000000000;
    exp_raw[0][3] = 160'h0000000000000000000000000000000000000000;
    exp_biased[0][3] = 160'h0000000020000000002000000000200000000020;
    exp_shifted[0][3] = 160'h0000000000000000000000000000000000000000;
    exp_stage16[0][3] = 64'h0000000000000000;
    exp_final10[0][3] = 40'h0000000000;
    exp_raw[0][4] = 160'h0000000000000000000000000000000000000000;
    exp_biased[0][4] = 160'h0000000020000000002000000000200000000020;
    exp_shifted[0][4] = 160'h0000000000000000000000000000000000000000;
    exp_stage16[0][4] = 64'h0000000000000000;
    exp_final10[0][4] = 40'h0000000000;
    exp_raw[0][5] = 160'h0000000000000000000000000000000000000000;
    exp_biased[0][5] = 160'h0000000020000000002000000000200000000020;
    exp_shifted[0][5] = 160'h0000000000000000000000000000000000000000;
    exp_stage16[0][5] = 64'h0000000000000000;
    exp_final10[0][5] = 40'h0000000000;
    exp_raw[0][6] = 160'h0000000000000000000000000000000000000000;
    exp_biased[0][6] = 160'h0000000020000000002000000000200000000020;
    exp_shifted[0][6] = 160'h0000000000000000000000000000000000000000;
    exp_stage16[0][6] = 64'h0000000000000000;
    exp_final10[0][6] = 40'h0000000000;
    exp_raw[0][7] = 160'h0000000000000000000000000000000000000000;
    exp_biased[0][7] = 160'h0000000020000000002000000000200000000020;
    exp_shifted[0][7] = 160'h0000000000000000000000000000000000000000;
    exp_stage16[0][7] = 64'h0000000000000000;
    exp_final10[0][7] = 40'h0000000000;
    exp_raw[0][8] = 160'h0000000000000000000000000000000000000000;
    exp_biased[0][8] = 160'h0000000020000000002000000000200000000020;
    exp_shifted[0][8] = 160'h0000000000000000000000000000000000000000;
    exp_stage16[0][8] = 64'h0000000000000000;
    exp_final10[0][8] = 40'h0000000000;
    exp_raw[0][9] = 160'h0000000000000000000000000000000000000000;
    exp_biased[0][9] = 160'h0000000020000000002000000000200000000020;
    exp_shifted[0][9] = 160'h0000000000000000000000000000000000000000;
    exp_stage16[0][9] = 64'h0000000000000000;
    exp_final10[0][9] = 40'h0000000000;
    exp_raw[0][10] = 160'h0000000000000000000000000000000000000000;
    exp_biased[0][10] = 160'h0000000020000000002000000000200000000020;
    exp_shifted[0][10] = 160'h0000000000000000000000000000000000000000;
    exp_stage16[0][10] = 64'h0000000000000000;
    exp_final10[0][10] = 40'h0000000000;
    exp_raw[0][11] = 160'h0000000000000000000000000000000000000000;
    exp_biased[0][11] = 160'h0000000020000000002000000000200000000020;
    exp_shifted[0][11] = 160'h0000000000000000000000000000000000000000;
    exp_stage16[0][11] = 64'h0000000000000000;
    exp_final10[0][11] = 40'h0000000000;
    exp_raw[0][12] = 160'h0000000000000000000000000000000000000000;
    exp_biased[0][12] = 160'h0000000020000000002000000000200000000020;
    exp_shifted[0][12] = 160'h0000000000000000000000000000000000000000;
    exp_stage16[0][12] = 64'h0000000000000000;
    exp_final10[0][12] = 40'h0000000000;
    exp_raw[0][13] = 160'h0000000000000000000000000000000000000000;
    exp_biased[0][13] = 160'h0000000020000000002000000000200000000020;
    exp_shifted[0][13] = 160'h0000000000000000000000000000000000000000;
    exp_stage16[0][13] = 64'h0000000000000000;
    exp_final10[0][13] = 40'h0000000000;
    exp_raw[0][14] = 160'h0000000000000000000000000000000000000000;
    exp_biased[0][14] = 160'h0000000020000000002000000000200000000020;
    exp_shifted[0][14] = 160'h0000000000000000000000000000000000000000;
    exp_stage16[0][14] = 64'h0000000000000000;
    exp_final10[0][14] = 40'h0000000000;
    exp_raw[0][15] = 160'h0000000000000000000000000000000000000000;
    exp_biased[0][15] = 160'h0000000020000000002000000000200000000020;
    exp_shifted[0][15] = 160'h0000000000000000000000000000000000000000;
    exp_stage16[0][15] = 64'h0000000000000000;
    exp_final10[0][15] = 40'h0000000000;
    case_input[1] = 1024'h7fff7fff7fff7fff7fff7fff7fff7fff7fff7fff7fff7fff7fff7fff7fff7fff7fff7fff7fff7fff7fff7fff7fff7fff7fff7fff7fff7fff7fff7fff7fff7fff7fff7fff7fff7fff7fff7fff7fff7fff7fff7fff7fff7fff7fff7fff7fff7fff7fff7fff7fff7fff7fff7fff7fff7fff7fff7fff7fff7fff7fff7fff7fff7fff;
    exp_raw[1][0] = 160'hffff0081ff0001797d0dfffda284bb00073c7187;
    exp_biased[1][0] = 160'hffff00821f0001797d2dfffda284db00073c71a7;
    exp_shifted[1][0] = 160'hfffffc0208000005e5f4fffff68a1300001cf1c6;
    exp_stage16[1][0] = 64'h0208e5f48a13f1c6;
    exp_final10[1][0] = 40'h821f484dc6;
    exp_raw[1][1] = 160'hffff8e80e30000967ed3ffff61813d0000d67e53;
    exp_biased[1][1] = 160'hffff8e81030000967ef3ffff61815d0000d67e73;
    exp_shifted[1][1] = 160'hfffffe3a0400000259fbfffffd860500000359f9;
    exp_stage16[1][1] = 64'h3a0459fb860559f9;
    exp_final10[1][1] = 40'h811fb815f9;
    exp_raw[1][2] = 160'hffffba808b00005e7f43ffffac80a70000747f17;
    exp_biased[1][2] = 160'hffffba80ab00005e7f63ffffac80c70000747f37;
    exp_shifted[1][2] = 160'hfffffeea0200000179fdfffffeb203000001d1fc;
    exp_stage16[1][2] = 64'hea0279fdb203d1fc;
    exp_final10[1][2] = 40'h809fd80dfc;
    exp_raw[1][3] = 160'hffffd2805b0000457f75ffffc2807b0000527f5b;
    exp_biased[1][3] = 160'hffffd2807b0000457f95ffffc2809b0000527f7b;
    exp_shifted[1][3] = 160'hffffff4a0100000115feffffff0a0200000149fd;
    exp_stage16[1][3] = 64'h4a0115fe0a0249fd;
    exp_final10[1][3] = 40'h805fe809fd;
    exp_raw[1][4] = 160'hffffde80430000357f95ffffd7805100003d7f85;
    exp_biased[1][4] = 160'hffffde80630000357fb5ffffd7807100003d7fa5;
    exp_shifted[1][4] = 160'hffffff7a01000000d5feffffff5e01000000f5fe;
    exp_stage16[1][4] = 64'h7a01d5fe5e01f5fe;
    exp_final10[1][4] = 40'h805fe805fe;
    exp_raw[1][5] = 160'hffffe2803b00002f7fa1ffffe1803d0000317f9d;
    exp_biased[1][5] = 160'hffffe2805b00002f7fc1ffffe1805d0000317fbd;
    exp_shifted[1][5] = 160'hffffff8a01000000bdffffffff8601000000c5fe;
    exp_stage16[1][5] = 64'h8a01bdff8601c5fe;
    exp_final10[1][5] = 40'h805ff805fe;
    exp_raw[1][6] = 160'hffffec80270000247fb7ffffea802b00002f7fa1;
    exp_biased[1][6] = 160'hffffec80470000247fd7ffffea804b00002f7fc1;
    exp_shifted[1][6] = 160'hffffffb20100000091ffffffffaa01000000bdff;
    exp_stage16[1][6] = 64'hb20191ffaa01bdff;
    exp_final10[1][6] = 40'h805ff805ff;
    exp_raw[1][7] = 160'hfffff1801d0000227fbbffffee80230000237fb9;
    exp_biased[1][7] = 160'hfffff1803d0000227fdbffffee80430000237fd9;
    exp_shifted[1][7] = 160'hffffffc60000000089ffffffffba010000008dff;
    exp_stage16[1][7] = 64'hc60089ffba018dff;
    exp_final10[1][7] = 40'h801ff805ff;
    exp_raw[1][8] = 160'hfffff6801300001b7fc9fffff580150000207fbf;
    exp_biased[1][8] = 160'hfffff6803300001b7fe9fffff580350000207fdf;
    exp_shifted[1][8] = 160'hffffffda000000006dffffffffd60000000081ff;
    exp_stage16[1][8] = 64'hda006dffd60081ff;
    exp_final10[1][8] = 40'h801ff801ff;
    exp_raw[1][9] = 160'hfffffc80070000197fcdfffff5801500001b7fc9;
    exp_biased[1][9] = 160'hfffffc80270000197fedfffff5803500001b7fe9;
    exp_shifted[1][9] = 160'hfffffff20000000065ffffffffd6000000006dff;
    exp_stage16[1][9] = 64'hf20065ffd6006dff;
    exp_final10[1][9] = 40'h801ff801ff;
    exp_raw[1][10] = 160'hfffffc80070000187fcffffffe80030000197fcd;
    exp_biased[1][10] = 160'hfffffc80270000187feffffffe80230000197fed;
    exp_shifted[1][10] = 160'hfffffff20000000061fffffffffa0000000065ff;
    exp_stage16[1][10] = 64'hf20061fffa0065ff;
    exp_final10[1][10] = 40'h801ff801ff;
    exp_raw[1][11] = 160'h0000027ffb0000147fd7fffffe80030000137fd9;
    exp_biased[1][11] = 160'h000002801b0000147ff7fffffe80230000137ff9;
    exp_shifted[1][11] = 160'h0000000a0000000051fffffffffa000000004dff;
    exp_stage16[1][11] = 64'h0a0051fffa004dff;
    exp_final10[1][11] = 40'h801ff801ff;
    exp_raw[1][12] = 160'h0000037ff90000117fdd0000027ffb0000117fdd;
    exp_biased[1][12] = 160'h00000380190000117ffd000002801b0000117ffd;
    exp_shifted[1][12] = 160'h0000000e0000000045ff0000000a0000000045ff;
    exp_stage16[1][12] = 64'h0e0045ff0a0045ff;
    exp_final10[1][12] = 40'h801ff801ff;
    exp_raw[1][13] = 160'h0000037ff900000d7fe50000037ff900000f7fe1;
    exp_biased[1][13] = 160'h000003801900000d8005000003801900000f8001;
    exp_shifted[1][13] = 160'h0000000e0000000036000000000e000000003e00;
    exp_stage16[1][13] = 64'h0e0036000e003e00;
    exp_final10[1][13] = 40'h8020080200;
    exp_raw[1][14] = 160'h0000057ff500000c7fe70000097fed00000d7fe5;
    exp_biased[1][14] = 160'h000005801500000c8007000009800d00000d8005;
    exp_shifted[1][14] = 160'h0000001600000000320000000026000000003600;
    exp_stage16[1][14] = 64'h1600320026003600;
    exp_final10[1][14] = 40'h8020080200;
    exp_raw[1][15] = 160'h0000097fed00000d7fe50000087fef0000097fed;
    exp_biased[1][15] = 160'h000009800d00000d8005000008800f000009800d;
    exp_shifted[1][15] = 160'h0000002600000000360000000022000000002600;
    exp_stage16[1][15] = 64'h2600360022002600;
    exp_final10[1][15] = 40'h8020080200;
    case_input[2] = 1024'h8000800080008000800080008000800080008000800080008000800080008000800080008000800080008000800080008000800080008000800080008000800080008000800080008000800080008000800080008000800080008000800080008000800080008000800080008000800080008000800080008000800080008000;
    exp_raw[2][0] = 160'h0000ff8000fffe86800000025d8000fff8c38000;
    exp_biased[2][0] = 160'h0000ff8020fffe86802000025d8020fff8c38020;
    exp_shifted[2][0] = 160'h000003fe00fffffa1a000000097600ffffe30e00;
    exp_stage16[2][0] = 64'hfe001a0076000e00;
    exp_final10[2][0] = 40'h8020080200;
    exp_raw[2][1] = 160'h0000718000ffff69800000009e8000ffff298000;
    exp_biased[2][1] = 160'h0000718020ffff69802000009e8020ffff298020;
    exp_shifted[2][1] = 160'h000001c600fffffda6000000027a00fffffca600;
    exp_stage16[2][1] = 64'hc600a6007a00a600;
    exp_final10[2][1] = 40'h8020080200;
    exp_raw[2][2] = 160'h0000458000ffffa180000000538000ffff8b8000;
    exp_biased[2][2] = 160'h0000458020ffffa180200000538020ffff8b8020;
    exp_shifted[2][2] = 160'h0000011600fffffe86000000014e00fffffe2e00;
    exp_stage16[2][2] = 64'h160086004e002e00;
    exp_final10[2][2] = 40'h8020080200;
    exp_raw[2][3] = 160'h00002d8000ffffba800000003d8000ffffad8000;
    exp_biased[2][3] = 160'h00002d8020ffffba802000003d8020ffffad8020;
    exp_shifted[2][3] = 160'h000000b600fffffeea00000000f600fffffeb600;
    exp_stage16[2][3] = 64'hb600ea00f600b600;
    exp_final10[2][3] = 40'h8020080200;
    exp_raw[2][4] = 160'h0000218000ffffca80000000288000ffffc28000;
    exp_biased[2][4] = 160'h0000218020ffffca80200000288020ffffc28020;
    exp_shifted[2][4] = 160'h0000008600ffffff2a00000000a200ffffff0a00;
    exp_stage16[2][4] = 64'h86002a00a2000a00;
    exp_final10[2][4] = 40'h8020080200;
    exp_raw[2][5] = 160'h00001d8000ffffd0800000001e8000ffffce8000;
    exp_biased[2][5] = 160'h00001d8020ffffd0802000001e8020ffffce8020;
    exp_shifted[2][5] = 160'h0000007600ffffff42000000007a00ffffff3a00;
    exp_stage16[2][5] = 64'h760042007a003a00;
    exp_final10[2][5] = 40'h8020080200;
    exp_raw[2][6] = 160'h0000138000ffffdb80000000158000ffffd08000;
    exp_biased[2][6] = 160'h0000138020ffffdb80200000158020ffffd08020;
    exp_shifted[2][6] = 160'h0000004e00ffffff6e000000005600ffffff4200;
    exp_stage16[2][6] = 64'h4e006e0056004200;
    exp_final10[2][6] = 40'h8020080200;
    exp_raw[2][7] = 160'h00000e8000ffffdd80000000118000ffffdc8000;
    exp_biased[2][7] = 160'h00000e8020ffffdd80200000118020ffffdc8020;
    exp_shifted[2][7] = 160'h0000003a00ffffff76000000004600ffffff7200;
    exp_stage16[2][7] = 64'h3a00760046007200;
    exp_final10[2][7] = 40'h8020080200;
    exp_raw[2][8] = 160'h0000098000ffffe4800000000a8000ffffdf8000;
    exp_biased[2][8] = 160'h0000098020ffffe4802000000a8020ffffdf8020;
    exp_shifted[2][8] = 160'h0000002600ffffff92000000002a00ffffff7e00;
    exp_stage16[2][8] = 64'h260092002a007e00;
    exp_final10[2][8] = 40'h8020080200;
    exp_raw[2][9] = 160'h0000038000ffffe6800000000a8000ffffe48000;
    exp_biased[2][9] = 160'h0000038020ffffe6802000000a8020ffffe48020;
    exp_shifted[2][9] = 160'h0000000e00ffffff9a000000002a00ffffff9200;
    exp_stage16[2][9] = 64'h0e009a002a009200;
    exp_final10[2][9] = 40'h8020080200;
    exp_raw[2][10] = 160'h0000038000ffffe780000000018000ffffe68000;
    exp_biased[2][10] = 160'h0000038020ffffe780200000018020ffffe68020;
    exp_shifted[2][10] = 160'h0000000e00ffffff9e000000000600ffffff9a00;
    exp_stage16[2][10] = 64'h0e009e0006009a00;
    exp_final10[2][10] = 40'h8020080200;
    exp_raw[2][11] = 160'hfffffd8000ffffeb80000000018000ffffec8000;
    exp_biased[2][11] = 160'hfffffd8020ffffeb80200000018020ffffec8020;
    exp_shifted[2][11] = 160'hfffffff600ffffffae000000000600ffffffb200;
    exp_stage16[2][11] = 64'hf600ae000600b200;
    exp_final10[2][11] = 40'h8020080200;
    exp_raw[2][12] = 160'hfffffc8000ffffee8000fffffd8000ffffee8000;
    exp_biased[2][12] = 160'hfffffc8020ffffee8020fffffd8020ffffee8020;
    exp_shifted[2][12] = 160'hfffffff200ffffffba00fffffff600ffffffba00;
    exp_stage16[2][12] = 64'hf200ba00f600ba00;
    exp_final10[2][12] = 40'h8020080200;
    exp_raw[2][13] = 160'hfffffc8000fffff28000fffffc8000fffff08000;
    exp_biased[2][13] = 160'hfffffc8020fffff28020fffffc8020fffff08020;
    exp_shifted[2][13] = 160'hfffffff200ffffffca00fffffff200ffffffc200;
    exp_stage16[2][13] = 64'hf200ca00f200c200;
    exp_final10[2][13] = 40'h8020080200;
    exp_raw[2][14] = 160'hfffffa8000fffff38000fffff68000fffff28000;
    exp_biased[2][14] = 160'hfffffa8020fffff38020fffff68020fffff28020;
    exp_shifted[2][14] = 160'hffffffea00ffffffce00ffffffda00ffffffca00;
    exp_stage16[2][14] = 64'hea00ce00da00ca00;
    exp_final10[2][14] = 40'h8020080200;
    exp_raw[2][15] = 160'hfffff68000fffff28000fffff78000fffff68000;
    exp_biased[2][15] = 160'hfffff68020fffff28020fffff78020fffff68020;
    exp_shifted[2][15] = 160'hffffffda00ffffffca00ffffffde00ffffffda00;
    exp_stage16[2][15] = 64'hda00ca00de00da00;
    exp_final10[2][15] = 40'h8020080200;
    case_input[3] = 1024'h80007fff80007fff80007fff80007fff80007fff80007fff80007fff80007fff80007fff80007fff80007fff80007fff80007fff80007fff80007fff80007fff80007fff80007fff80007fff80007fff80007fff80007fff80007fff80007fff80007fff80007fff80007fff80007fff80007fff80007fff80007fff80007fff;
    exp_raw[3][0] = 160'h00000980f60000087e7e00000d825000000978ba;
    exp_biased[3][0] = 160'h00000981160000087e9e00000d827000000978da;
    exp_shifted[3][0] = 160'h000000260400000021fa000000360900000025e3;
    exp_stage16[3][0] = 64'h260421fa360925e3;
    exp_final10[3][0] = 40'h811fa825e3;
    exp_raw[3][1] = 160'h00000d80640000097f6000000c80920000057f24;
    exp_biased[3][1] = 160'h00000d80840000097f8000000c80b20000057f44;
    exp_shifted[3][1] = 160'h000000360200000025fe000000320200000015fd;
    exp_stage16[3][1] = 64'h360225fe320215fd;
    exp_final10[3][1] = 40'h809fe809fd;
    exp_raw[3][2] = 160'h00000f80360000037f9e00000d80460000037f88;
    exp_biased[3][2] = 160'h00000f80560000037fbe00000d80660000037fa8;
    exp_shifted[3][2] = 160'h0000003e010000000dfe00000036010000000dfe;
    exp_stage16[3][2] = 64'h3e010dfe36010dfe;
    exp_final10[3][2] = 40'h805fe805fe;
    exp_raw[3][3] = 160'h000011801c0000027fb8000011802c0000037faa;
    exp_biased[3][3] = 160'h000011803c0000027fd8000011804c0000037fca;
    exp_shifted[3][3] = 160'h000000460000000009ff00000046010000000dff;
    exp_stage16[3][3] = 64'h460009ff46010dff;
    exp_final10[3][3] = 40'h801ff805ff;
    exp_raw[3][4] = 160'h000013800efffffe7fcc00001480140000027fc0;
    exp_biased[3][4] = 160'h000013802efffffe7fec00001480340000027fe0;
    exp_shifted[3][4] = 160'h0000004e00fffffff9ff000000520000000009ff;
    exp_stage16[3][4] = 64'h4e00f9ff520009ff;
    exp_final10[3][4] = 40'h801ff801ff;
    exp_raw[3][5] = 160'h0000198004fffffe7fd20000188006fffffc7fd2;
    exp_biased[3][5] = 160'h0000198024fffffe7ff20000188026fffffc7ff2;
    exp_shifted[3][5] = 160'h0000006600fffffff9ff0000006200fffffff1ff;
    exp_stage16[3][5] = 64'h6600f9ff6200f1ff;
    exp_final10[3][5] = 40'h801ff801ff;
    exp_raw[3][6] = 160'h00001b7ff8fffff57fe60000197ffcfffffc7fd4;
    exp_biased[3][6] = 160'h00001b8018fffff58006000019801cfffffc7ff4;
    exp_shifted[3][6] = 160'h0000006e00ffffffd6000000006600fffffff1ff;
    exp_stage16[3][6] = 64'h6e00d6006600f1ff;
    exp_final10[3][6] = 40'h80200801ff;
    exp_raw[3][7] = 160'h0000207feefffff57fe800001b7ff6fffff67fe6;
    exp_biased[3][7] = 160'h000020800efffff5800800001b8016fffff68006;
    exp_shifted[3][7] = 160'h0000008200ffffffd6000000006e00ffffffda00;
    exp_stage16[3][7] = 64'h8200d6006e00da00;
    exp_final10[3][7] = 40'h8020080200;
    exp_raw[3][8] = 160'h0000237fe6ffffee7ff60000227fe8fffff17fee;
    exp_biased[3][8] = 160'h0000238006ffffee80160000228008fffff1800e;
    exp_shifted[3][8] = 160'h0000008e00ffffffba000000008a00ffffffc600;
    exp_stage16[3][8] = 64'h8e00ba008a00c600;
    exp_final10[3][8] = 40'h8020080200;
    exp_raw[3][9] = 160'h00002f7fd4ffffea7ffc0000247fe6ffffec7ff8;
    exp_biased[3][9] = 160'h00002f7ff4ffffea801c0000248006ffffec8018;
    exp_shifted[3][9] = 160'h000000bdffffffffaa000000009200ffffffb200;
    exp_stage16[3][9] = 64'hbdffaa009200b200;
    exp_final10[3][9] = 40'h7fe0080200;
    exp_raw[3][10] = 160'h0000317fd2ffffe1800600002f7fd2ffffe28004;
    exp_biased[3][10] = 160'h0000317ff2ffffe1802600002f7ff2ffffe28024;
    exp_shifted[3][10] = 160'h000000c5ffffffff8600000000bdffffffff8a00;
    exp_stage16[3][10] = 64'hc5ff8600bdff8a00;
    exp_final10[3][10] = 40'h7fe007fe00;
    exp_raw[3][11] = 160'h00003d7fc0ffffd780140000357fccffffde800e;
    exp_biased[3][11] = 160'h00003d7fe0ffffd780340000357fecffffde802e;
    exp_shifted[3][11] = 160'h000000f5ffffffff5e00000000d5ffffffff7a00;
    exp_stage16[3][11] = 64'hf5ff5e00d5ff7a00;
    exp_final10[3][11] = 40'h7fe007fe00;
    exp_raw[3][12] = 160'h0000527faaffffc2802c0000457fb8ffffd2801c;
    exp_biased[3][12] = 160'h0000527fcaffffc2804c0000457fd8ffffd2803c;
    exp_shifted[3][12] = 160'h00000149ffffffff0a0100000115ffffffff4a00;
    exp_stage16[3][12] = 64'h49ff0a0115ff4a00;
    exp_final10[3][12] = 40'h7fe017fe00;
    exp_raw[3][13] = 160'h0000747f88ffffac804600005e7f9effffba8036;
    exp_biased[3][13] = 160'h0000747fa8ffffac806600005e7fbeffffba8056;
    exp_shifted[3][13] = 160'h000001d1fefffffeb20100000179fefffffeea01;
    exp_stage16[3][13] = 64'hd1feb20179feea01;
    exp_final10[3][13] = 40'h7fa017fa01;
    exp_raw[3][14] = 160'h0000d67f24ffff6180920000967f60ffff8e8064;
    exp_biased[3][14] = 160'h0000d67f44ffff6180b20000967f80ffff8e8084;
    exp_shifted[3][14] = 160'h00000359fdfffffd860200000259fefffffe3a02;
    exp_stage16[3][14] = 64'h59fd860259fe3a02;
    exp_final10[3][14] = 40'h7f6027fa02;
    exp_raw[3][15] = 160'h00073c78bafffda282500001797e7effff0080f6;
    exp_biased[3][15] = 160'h00073c78dafffda282700001797e9effff008116;
    exp_shifted[3][15] = 160'h00001cf1e3fffff68a09000005e5fafffffc0204;
    exp_stage16[3][15] = 64'hf1e38a09e5fa0204;
    exp_final10[3][15] = 40'h78e097ea04;
    case_input[4] = 1024'h7fff80007fff80007fff80007fff80007fff80007fff80007fff80007fff80007fff80007fff80007fff80007fff80007fff80007fff80007fff80007fff80007fff80007fff80007fff80007fff80007fff80007fff80007fff80007fff80007fff80007fff80007fff80007fff80007fff80007fff80007fff80007fff8000;
    exp_raw[4][0] = 160'hfffff68109fffff77e8ffffff2826bfffff678cd;
    exp_biased[4][0] = 160'hfffff68129fffff77eaffffff2828bfffff678ed;
    exp_shifted[4][0] = 160'hffffffda04ffffffddfaffffffca0affffffd9e3;
    exp_stage16[4][0] = 64'hda04ddfaca0ad9e3;
    exp_final10[4][0] = 40'h811fa829e3;
    exp_raw[4][1] = 160'hfffff2807ffffff67f73fffff380abfffffa7f2f;
    exp_biased[4][1] = 160'hfffff2809ffffff67f93fffff380cbfffffa7f4f;
    exp_shifted[4][1] = 160'hffffffca02ffffffd9feffffffce03ffffffe9fd;
    exp_stage16[4][1] = 64'hca02d9fece03e9fd;
    exp_final10[4][1] = 40'h809fe80dfd;
    exp_raw[4][2] = 160'hfffff08055fffffc7fa5fffff28061fffffc7f8f;
    exp_biased[4][2] = 160'hfffff08075fffffc7fc5fffff28081fffffc7faf;
    exp_shifted[4][2] = 160'hffffffc201fffffff1ffffffffca02fffffff1fe;
    exp_stage16[4][2] = 64'hc201f1ffca02f1fe;
    exp_final10[4][2] = 40'h805ff809fe;
    exp_raw[4][3] = 160'hffffee803ffffffd7fbdffffee804ffffffc7fb1;
    exp_biased[4][3] = 160'hffffee805ffffffd7fddffffee806ffffffc7fd1;
    exp_shifted[4][3] = 160'hffffffba01fffffff5ffffffffba01fffffff1ff;
    exp_stage16[4][3] = 64'hba01f5ffba01f1ff;
    exp_final10[4][3] = 40'h805ff805ff;
    exp_raw[4][4] = 160'hffffec80350000017fc9ffffeb803dfffffd7fc5;
    exp_biased[4][4] = 160'hffffec80550000017fe9ffffeb805dfffffd7fe5;
    exp_shifted[4][4] = 160'hffffffb20100000005ffffffffae01fffffff5ff;
    exp_stage16[4][4] = 64'hb20105ffae01f5ff;
    exp_final10[4][4] = 40'h805ff805ff;
    exp_raw[4][5] = 160'hffffe680370000017fcfffffe780370000037fcb;
    exp_biased[4][5] = 160'hffffe680570000017fefffffe780570000037feb;
    exp_shifted[4][5] = 160'hffffff9a0100000005ffffffff9e010000000dff;
    exp_stage16[4][5] = 64'h9a0105ff9e010dff;
    exp_final10[4][5] = 40'h805ff805ff;
    exp_raw[4][6] = 160'hffffe4802f00000a7fd1ffffe6802f0000037fcd;
    exp_biased[4][6] = 160'hffffe4804f00000a7ff1ffffe6804f0000037fed;
    exp_shifted[4][6] = 160'hffffff920100000029ffffffff9a010000000dff;
    exp_stage16[4][6] = 64'h920129ff9a010dff;
    exp_final10[4][6] = 40'h805ff805ff;
    exp_raw[4][7] = 160'hffffdf802f00000a7fd3ffffe4802d0000097fd3;
    exp_biased[4][7] = 160'hffffdf804f00000a7ff3ffffe4804d0000097ff3;
    exp_shifted[4][7] = 160'hffffff7e0100000029ffffffff920100000025ff;
    exp_stage16[4][7] = 64'h7e0129ff920125ff;
    exp_final10[4][7] = 40'h805ff805ff;
    exp_raw[4][8] = 160'hffffdc802d0000117fd3ffffdd802d00000e7fd1;
    exp_biased[4][8] = 160'hffffdc804d0000117ff3ffffdd804d00000e7ff1;
    exp_shifted[4][8] = 160'hffffff720100000045ffffffff760100000039ff;
    exp_stage16[4][8] = 64'h720145ff760139ff;
    exp_final10[4][8] = 40'h805ff805ff;
    exp_raw[4][9] = 160'hffffd080330000157fd1ffffdb802f0000137fd1;
    exp_biased[4][9] = 160'hffffd080530000157ff1ffffdb804f0000137ff1;
    exp_shifted[4][9] = 160'hffffff420100000055ffffffff6e010000004dff;
    exp_stage16[4][9] = 64'h420155ff6e014dff;
    exp_final10[4][9] = 40'h805ff805ff;
    exp_raw[4][10] = 160'hffffce803500001e7fc9ffffd0803100001d7fc9;
    exp_biased[4][10] = 160'hffffce805500001e7fe9ffffd0805100001d7fe9;
    exp_shifted[4][10] = 160'hffffff3a0100000079ffffffff420100000075ff;
    exp_stage16[4][10] = 64'h3a0179ff420175ff;
    exp_final10[4][10] = 40'h805ff805ff;
    exp_raw[4][11] = 160'hffffc2803b0000287fc3ffffca80370000217fcb;
    exp_biased[4][11] = 160'hffffc2805b0000287fe3ffffca80570000217feb;
    exp_shifted[4][11] = 160'hffffff0a01000000a1ffffffff2a0100000085ff;
    exp_stage16[4][11] = 64'h0a01a1ff2a0185ff;
    exp_final10[4][11] = 40'h805ff805ff;
    exp_raw[4][12] = 160'hffffad804f00003d7fb1ffffba804300002d7fc1;
    exp_biased[4][12] = 160'hffffad806f00003d7fd1ffffba806300002d7fe1;
    exp_shifted[4][12] = 160'hfffffeb601000000f5fffffffeea01000000b5ff;
    exp_stage16[4][12] = 64'hb601f5ffea01b5ff;
    exp_final10[4][12] = 40'h805ff805ff;
    exp_raw[4][13] = 160'hffff8b80710000537f9fffffa1805b0000457fab;
    exp_biased[4][13] = 160'hffff8b80910000537fbfffffa1807b0000457fcb;
    exp_shifted[4][13] = 160'hfffffe2e020000014dfefffffe860100000115ff;
    exp_stage16[4][13] = 64'h2e024dfe860115ff;
    exp_final10[4][13] = 40'h809fe805ff;
    exp_raw[4][14] = 160'hffff2980d100009e7f55ffff69808d0000717f81;
    exp_biased[4][14] = 160'hffff2980f100009e7f75ffff6980ad0000717fa1;
    exp_shifted[4][14] = 160'hfffffca60300000279fdfffffda602000001c5fe;
    exp_stage16[4][14] = 64'ha60379fda602c5fe;
    exp_final10[4][14] = 40'h80dfd809fe;
    exp_raw[4][15] = 160'hfff8c3873300025d7d95fffe8681710000ff7ef7;
    exp_biased[4][15] = 160'hfff8c3875300025d7db5fffe8681910000ff7f17;
    exp_shifted[4][15] = 160'hffffe30e1d00000975f6fffffa1a06000003fdfc;
    exp_stage16[4][15] = 64'h0e1d75f61a06fdfc;
    exp_final10[4][15] = 40'h875f6819fc;
    case_input[5] = 1024'h0000000000000000000000000000000000000000000000000000000000000000000000000000000000000000000000000000000000000000000000000000000000000000000000000000000000000000000000000000000000000000000000000000000000000000000000000000000000000000000000000000000000007fff;
    exp_raw[5][0] = 160'h00001fffc000001fffc000001fffc000001fffc0;
    exp_biased[5][0] = 160'h00001fffe000001fffe000001fffe000001fffe0;
    exp_shifted[5][0] = 160'h0000007fff0000007fff0000007fff0000007fff;
    exp_stage16[5][0] = 64'h7fff7fff7fff7fff;
    exp_final10[5][0] = 40'hffffffffff;
    exp_raw[5][1] = 160'h00001fffc000001fffc000001fffc000001fffc0;
    exp_biased[5][1] = 160'h00001fffe000001fffe000001fffe000001fffe0;
    exp_shifted[5][1] = 160'h0000007fff0000007fff0000007fff0000007fff;
    exp_stage16[5][1] = 64'h7fff7fff7fff7fff;
    exp_final10[5][1] = 40'hffffffffff;
    exp_raw[5][2] = 160'h00001fffc000001fffc000001fffc000001fffc0;
    exp_biased[5][2] = 160'h00001fffe000001fffe000001fffe000001fffe0;
    exp_shifted[5][2] = 160'h0000007fff0000007fff0000007fff0000007fff;
    exp_stage16[5][2] = 64'h7fff7fff7fff7fff;
    exp_final10[5][2] = 40'hffffffffff;
    exp_raw[5][3] = 160'h00001fffc000001fffc000001fffc000001fffc0;
    exp_biased[5][3] = 160'h00001fffe000001fffe000001fffe000001fffe0;
    exp_shifted[5][3] = 160'h0000007fff0000007fff0000007fff0000007fff;
    exp_stage16[5][3] = 64'h7fff7fff7fff7fff;
    exp_final10[5][3] = 40'hffffffffff;
    exp_raw[5][4] = 160'h00001fffc000001fffc000001fffc000001fffc0;
    exp_biased[5][4] = 160'h00001fffe000001fffe000001fffe000001fffe0;
    exp_shifted[5][4] = 160'h0000007fff0000007fff0000007fff0000007fff;
    exp_stage16[5][4] = 64'h7fff7fff7fff7fff;
    exp_final10[5][4] = 40'hffffffffff;
    exp_raw[5][5] = 160'h00001fffc000001fffc000001fffc000001fffc0;
    exp_biased[5][5] = 160'h00001fffe000001fffe000001fffe000001fffe0;
    exp_shifted[5][5] = 160'h0000007fff0000007fff0000007fff0000007fff;
    exp_stage16[5][5] = 64'h7fff7fff7fff7fff;
    exp_final10[5][5] = 40'hffffffffff;
    exp_raw[5][6] = 160'h00001fffc000001fffc000001fffc000001fffc0;
    exp_biased[5][6] = 160'h00001fffe000001fffe000001fffe000001fffe0;
    exp_shifted[5][6] = 160'h0000007fff0000007fff0000007fff0000007fff;
    exp_stage16[5][6] = 64'h7fff7fff7fff7fff;
    exp_final10[5][6] = 40'hffffffffff;
    exp_raw[5][7] = 160'h00001fffc000001fffc000001fffc000001fffc0;
    exp_biased[5][7] = 160'h00001fffe000001fffe000001fffe000001fffe0;
    exp_shifted[5][7] = 160'h0000007fff0000007fff0000007fff0000007fff;
    exp_stage16[5][7] = 64'h7fff7fff7fff7fff;
    exp_final10[5][7] = 40'hffffffffff;
    exp_raw[5][8] = 160'h00001fffc000001fffc000001fffc000001fffc0;
    exp_biased[5][8] = 160'h00001fffe000001fffe000001fffe000001fffe0;
    exp_shifted[5][8] = 160'h0000007fff0000007fff0000007fff0000007fff;
    exp_stage16[5][8] = 64'h7fff7fff7fff7fff;
    exp_final10[5][8] = 40'hffffffffff;
    exp_raw[5][9] = 160'h00001fffc000001fffc000001fffc000001fffc0;
    exp_biased[5][9] = 160'h00001fffe000001fffe000001fffe000001fffe0;
    exp_shifted[5][9] = 160'h0000007fff0000007fff0000007fff0000007fff;
    exp_stage16[5][9] = 64'h7fff7fff7fff7fff;
    exp_final10[5][9] = 40'hffffffffff;
    exp_raw[5][10] = 160'h00001fffc000001fffc000001fffc000001fffc0;
    exp_biased[5][10] = 160'h00001fffe000001fffe000001fffe000001fffe0;
    exp_shifted[5][10] = 160'h0000007fff0000007fff0000007fff0000007fff;
    exp_stage16[5][10] = 64'h7fff7fff7fff7fff;
    exp_final10[5][10] = 40'hffffffffff;
    exp_raw[5][11] = 160'h00001fffc000001fffc000001fffc000001fffc0;
    exp_biased[5][11] = 160'h00001fffe000001fffe000001fffe000001fffe0;
    exp_shifted[5][11] = 160'h0000007fff0000007fff0000007fff0000007fff;
    exp_stage16[5][11] = 64'h7fff7fff7fff7fff;
    exp_final10[5][11] = 40'hffffffffff;
    exp_raw[5][12] = 160'h00001fffc000001fffc000001fffc000001fffc0;
    exp_biased[5][12] = 160'h00001fffe000001fffe000001fffe000001fffe0;
    exp_shifted[5][12] = 160'h0000007fff0000007fff0000007fff0000007fff;
    exp_stage16[5][12] = 64'h7fff7fff7fff7fff;
    exp_final10[5][12] = 40'hffffffffff;
    exp_raw[5][13] = 160'h00001fffc000001fffc000001fffc000001fffc0;
    exp_biased[5][13] = 160'h00001fffe000001fffe000001fffe000001fffe0;
    exp_shifted[5][13] = 160'h0000007fff0000007fff0000007fff0000007fff;
    exp_stage16[5][13] = 64'h7fff7fff7fff7fff;
    exp_final10[5][13] = 40'hffffffffff;
    exp_raw[5][14] = 160'h00001fffc000001fffc000001fffc000001fffc0;
    exp_biased[5][14] = 160'h00001fffe000001fffe000001fffe000001fffe0;
    exp_shifted[5][14] = 160'h0000007fff0000007fff0000007fff0000007fff;
    exp_stage16[5][14] = 64'h7fff7fff7fff7fff;
    exp_final10[5][14] = 40'hffffffffff;
    exp_raw[5][15] = 160'h00001fffc000001fffc000001fffc000001fffc0;
    exp_biased[5][15] = 160'h00001fffe000001fffe000001fffe000001fffe0;
    exp_shifted[5][15] = 160'h0000007fff0000007fff0000007fff0000007fff;
    exp_stage16[5][15] = 64'h7fff7fff7fff7fff;
    exp_final10[5][15] = 40'hffffffffff;
    case_input[6] = 1024'h8000000000000000000000000000000000000000000000000000000000000000000000000000000000000000000000000000000000000000000000000000000000000000000000000000000000000000000000000000000000000000000000000000000000000000000000000000000000000000000000000000000000000000;
    exp_raw[6][0] = 160'h0000078000fffffa80000000038000ffffff0000;
    exp_biased[6][0] = 160'h0000078020fffffa80200000038020ffffff0020;
    exp_shifted[6][0] = 160'h0000001e00ffffffea000000000e00fffffffc00;
    exp_stage16[6][0] = 64'h1e00ea000e00fc00;
    exp_final10[6][0] = 40'h8020080000;
    exp_raw[6][1] = 160'h0000108000fffff2000000000c0000fffff60000;
    exp_biased[6][1] = 160'h0000108020fffff2002000000c0020fffff60020;
    exp_shifted[6][1] = 160'h0000004200ffffffc8000000003000ffffffd800;
    exp_stage16[6][1] = 64'h4200c8003000d800;
    exp_final10[6][1] = 40'h8000000000;
    exp_raw[6][2] = 160'h0000180000ffffea00000000148000ffffed8000;
    exp_biased[6][2] = 160'h0000180020ffffea00200000148020ffffed8020;
    exp_shifted[6][2] = 160'h0000006000ffffffa8000000005200ffffffb600;
    exp_stage16[6][2] = 64'h6000a8005200b600;
    exp_final10[6][2] = 40'h0000080200;
    exp_raw[6][3] = 160'h00001f0000ffffe2800000001c0000ffffe60000;
    exp_biased[6][3] = 160'h00001f0020ffffe2802000001c0020ffffe60020;
    exp_shifted[6][3] = 160'h0000007c00ffffff8a000000007000ffffff9800;
    exp_stage16[6][3] = 64'h7c008a0070009800;
    exp_final10[6][3] = 40'h0020000000;
    exp_raw[6][4] = 160'h0000248000ffffdc80000000228000ffffdf8000;
    exp_biased[6][4] = 160'h0000248020ffffdc80200000228020ffffdf8020;
    exp_shifted[6][4] = 160'h0000009200ffffff72000000008a00ffffff7e00;
    exp_stage16[6][4] = 64'h920072008a007e00;
    exp_final10[6][4] = 40'h8020080200;
    exp_raw[6][5] = 160'h0000298000ffffd780000000278000ffffd98000;
    exp_biased[6][5] = 160'h0000298020ffffd780200000278020ffffd98020;
    exp_shifted[6][5] = 160'h000000a600ffffff5e000000009e00ffffff6600;
    exp_stage16[6][5] = 64'ha6005e009e006600;
    exp_final10[6][5] = 40'h8020080200;
    exp_raw[6][6] = 160'h00002c0000ffffd4800000002b0000ffffd60000;
    exp_biased[6][6] = 160'h00002c0020ffffd4802000002b0020ffffd60020;
    exp_shifted[6][6] = 160'h000000b000ffffff5200000000ac00ffffff5800;
    exp_stage16[6][6] = 64'hb0005200ac005800;
    exp_final10[6][6] = 40'h0020000000;
    exp_raw[6][7] = 160'h00002d8000ffffd3000000002d0000ffffd30000;
    exp_biased[6][7] = 160'h00002d8020ffffd3002000002d0020ffffd30020;
    exp_shifted[6][7] = 160'h000000b600ffffff4c00000000b400ffffff4c00;
    exp_stage16[6][7] = 64'hb6004c00b4004c00;
    exp_final10[6][7] = 40'h8000000000;
    exp_raw[6][8] = 160'h00002d0000ffffd3000000002d0000ffffd28000;
    exp_biased[6][8] = 160'h00002d0020ffffd3002000002d0020ffffd28020;
    exp_shifted[6][8] = 160'h000000b400ffffff4c00000000b400ffffff4a00;
    exp_stage16[6][8] = 64'hb4004c00b4004a00;
    exp_final10[6][8] = 40'h0000000200;
    exp_raw[6][9] = 160'h00002a0000ffffd5000000002b8000ffffd40000;
    exp_biased[6][9] = 160'h00002a0020ffffd5002000002b8020ffffd40020;
    exp_shifted[6][9] = 160'h000000a800ffffff5400000000ae00ffffff5000;
    exp_stage16[6][9] = 64'ha8005400ae005000;
    exp_final10[6][9] = 40'h0000080000;
    exp_raw[6][10] = 160'h0000268000ffffd880000000288000ffffd68000;
    exp_biased[6][10] = 160'h0000268020ffffd880200000288020ffffd68020;
    exp_shifted[6][10] = 160'h0000009a00ffffff6200000000a200ffffff5a00;
    exp_stage16[6][10] = 64'h9a006200a2005a00;
    exp_final10[6][10] = 40'h8020080200;
    exp_raw[6][11] = 160'h0000208000ffffdd80000000238000ffffdb8000;
    exp_biased[6][11] = 160'h0000208020ffffdd80200000238020ffffdb8020;
    exp_shifted[6][11] = 160'h0000008200ffffff76000000008e00ffffff6e00;
    exp_stage16[6][11] = 64'h820076008e006e00;
    exp_final10[6][11] = 40'h8020080200;
    exp_raw[6][12] = 160'h00001a0000ffffe4000000001d8000ffffe10000;
    exp_biased[6][12] = 160'h00001a0020ffffe4002000001d8020ffffe10020;
    exp_shifted[6][12] = 160'h0000006800ffffff90000000007600ffffff8400;
    exp_stage16[6][12] = 64'h6800900076008400;
    exp_final10[6][12] = 40'h0000080000;
    exp_raw[6][13] = 160'h0000128000ffffeb80000000160000ffffe80000;
    exp_biased[6][13] = 160'h0000128020ffffeb80200000160020ffffe80020;
    exp_shifted[6][13] = 160'h0000004a00ffffffae000000005800ffffffa000;
    exp_stage16[6][13] = 64'h4a00ae005800a000;
    exp_final10[6][13] = 40'h8020000000;
    exp_raw[6][14] = 160'h00000a0000fffff4000000000e0000ffffef8000;
    exp_biased[6][14] = 160'h00000a0020fffff4002000000e0020ffffef8020;
    exp_shifted[6][14] = 160'h0000002800ffffffd0000000003800ffffffbe00;
    exp_stage16[6][14] = 64'h2800d0003800be00;
    exp_final10[6][14] = 40'h0000000200;
    exp_raw[6][15] = 160'h0000010000fffffc80000000058000fffff88000;
    exp_biased[6][15] = 160'h0000010020fffffc80200000058020fffff88020;
    exp_shifted[6][15] = 160'h0000000400fffffff2000000001600ffffffe200;
    exp_stage16[6][15] = 64'h0400f2001600e200;
    exp_final10[6][15] = 40'h0020080200;
    case_input[7] = 1024'h8000000000000000000000000000000000000000000000000000000000000000000000000000000000000000000000000000000000000000000000000000000000000000000000000000000000000000000000000000000000000000000000000000000000000000000000000000000000000000000000000000000000007fff;
    exp_raw[7][0] = 160'h0000277fc000001a7fc00000237fc000001effc0;
    exp_biased[7][0] = 160'h0000277fe000001a7fe00000237fe000001effe0;
    exp_shifted[7][0] = 160'h0000009dff00000069ff0000008dff0000007bff;
    exp_stage16[7][0] = 64'h9dff69ff8dff7bff;
    exp_final10[7][0] = 40'h7fdff7ffff;
    exp_raw[7][1] = 160'h0000307fc0000011ffc000002bffc0000015ffc0;
    exp_biased[7][1] = 160'h0000307fe0000011ffe000002bffe0000015ffe0;
    exp_shifted[7][1] = 160'h000000c1ff00000047ff000000afff00000057ff;
    exp_stage16[7][1] = 64'hc1ff47ffafff57ff;
    exp_final10[7][1] = 40'h7fffffffff;
    exp_raw[7][2] = 160'h000037ffc0000009ffc00000347fc000000d7fc0;
    exp_biased[7][2] = 160'h000037ffe0000009ffe00000347fe000000d7fe0;
    exp_shifted[7][2] = 160'h000000dfff00000027ff000000d1ff00000035ff;
    exp_stage16[7][2] = 64'hdfff27ffd1ff35ff;
    exp_final10[7][2] = 40'hfffff7fdff;
    exp_raw[7][3] = 160'h00003effc00000027fc000003bffc0000005ffc0;
    exp_biased[7][3] = 160'h00003effe00000027fe000003bffe0000005ffe0;
    exp_shifted[7][3] = 160'h000000fbff00000009ff000000efff00000017ff;
    exp_stage16[7][3] = 64'hfbff09ffefff17ff;
    exp_final10[7][3] = 40'hffdfffffff;
    exp_raw[7][4] = 160'h0000447fc0fffffc7fc00000427fc0ffffff7fc0;
    exp_biased[7][4] = 160'h0000447fe0fffffc7fe00000427fe0ffffff7fe0;
    exp_shifted[7][4] = 160'h00000111fffffffff1ff00000109fffffffffdff;
    exp_stage16[7][4] = 64'h11fff1ff09fffdff;
    exp_final10[7][4] = 40'h7fdff7fdff;
    exp_raw[7][5] = 160'h0000497fc0fffff77fc00000477fc0fffff97fc0;
    exp_biased[7][5] = 160'h0000497fe0fffff77fe00000477fe0fffff97fe0;
    exp_shifted[7][5] = 160'h00000125ffffffffddff0000011dffffffffe5ff;
    exp_stage16[7][5] = 64'h25ffddff1dffe5ff;
    exp_final10[7][5] = 40'h7fdff7fdff;
    exp_raw[7][6] = 160'h00004bffc0fffff47fc000004affc0fffff5ffc0;
    exp_biased[7][6] = 160'h00004bffe0fffff47fe000004affe0fffff5ffe0;
    exp_shifted[7][6] = 160'h0000012fffffffffd1ff0000012bffffffffd7ff;
    exp_stage16[7][6] = 64'h2fffd1ff2bffd7ff;
    exp_final10[7][6] = 40'hffdfffffff;
    exp_raw[7][7] = 160'h00004d7fc0fffff2ffc000004cffc0fffff2ffc0;
    exp_biased[7][7] = 160'h00004d7fe0fffff2ffe000004cffe0fffff2ffe0;
    exp_shifted[7][7] = 160'h00000135ffffffffcbff00000133ffffffffcbff;
    exp_stage16[7][7] = 64'h35ffcbff33ffcbff;
    exp_final10[7][7] = 40'h7fffffffff;
    exp_raw[7][8] = 160'h00004cffc0fffff2ffc000004cffc0fffff27fc0;
    exp_biased[7][8] = 160'h00004cffe0fffff2ffe000004cffe0fffff27fe0;
    exp_shifted[7][8] = 160'h00000133ffffffffcbff00000133ffffffffc9ff;
    exp_stage16[7][8] = 64'h33ffcbff33ffc9ff;
    exp_final10[7][8] = 40'hfffffffdff;
    exp_raw[7][9] = 160'h000049ffc0fffff4ffc000004b7fc0fffff3ffc0;
    exp_biased[7][9] = 160'h000049ffe0fffff4ffe000004b7fe0fffff3ffe0;
    exp_shifted[7][9] = 160'h00000127ffffffffd3ff0000012dffffffffcfff;
    exp_stage16[7][9] = 64'h27ffd3ff2dffcfff;
    exp_final10[7][9] = 40'hfffff7ffff;
    exp_raw[7][10] = 160'h0000467fc0fffff87fc00000487fc0fffff67fc0;
    exp_biased[7][10] = 160'h0000467fe0fffff87fe00000487fe0fffff67fe0;
    exp_shifted[7][10] = 160'h00000119ffffffffe1ff00000121ffffffffd9ff;
    exp_stage16[7][10] = 64'h19ffe1ff21ffd9ff;
    exp_final10[7][10] = 40'h7fdff7fdff;
    exp_raw[7][11] = 160'h0000407fc0fffffd7fc00000437fc0fffffb7fc0;
    exp_biased[7][11] = 160'h0000407fe0fffffd7fe00000437fe0fffffb7fe0;
    exp_shifted[7][11] = 160'h00000101fffffffff5ff0000010dffffffffedff;
    exp_stage16[7][11] = 64'h01fff5ff0dffedff;
    exp_final10[7][11] = 40'h7fdff7fdff;
    exp_raw[7][12] = 160'h000039ffc0000003ffc000003d7fc0000000ffc0;
    exp_biased[7][12] = 160'h000039ffe0000003ffe000003d7fe0000000ffe0;
    exp_shifted[7][12] = 160'h000000e7ff0000000fff000000f5ff00000003ff;
    exp_stage16[7][12] = 64'he7ff0ffff5ff03ff;
    exp_final10[7][12] = 40'hfffff7ffff;
    exp_raw[7][13] = 160'h0000327fc000000b7fc0000035ffc0000007ffc0;
    exp_biased[7][13] = 160'h0000327fe000000b7fe0000035ffe0000007ffe0;
    exp_shifted[7][13] = 160'h000000c9ff0000002dff000000d7ff0000001fff;
    exp_stage16[7][13] = 64'hc9ff2dffd7ff1fff;
    exp_final10[7][13] = 40'h7fdfffffff;
    exp_raw[7][14] = 160'h000029ffc0000013ffc000002dffc000000f7fc0;
    exp_biased[7][14] = 160'h000029ffe0000013ffe000002dffe000000f7fe0;
    exp_shifted[7][14] = 160'h000000a7ff0000004fff000000b7ff0000003dff;
    exp_stage16[7][14] = 64'ha7ff4fffb7ff3dff;
    exp_final10[7][14] = 40'hfffffffdff;
    exp_raw[7][15] = 160'h000020ffc000001c7fc00000257fc00000187fc0;
    exp_biased[7][15] = 160'h000020ffe000001c7fe00000257fe00000187fe0;
    exp_shifted[7][15] = 160'h00000083ff00000071ff00000095ff00000061ff;
    exp_stage16[7][15] = 64'h83ff71ff95ff61ff;
    exp_final10[7][15] = 40'hffdff7fdff;
    case_input[8] = 1024'h80000000000000000000000000000000000000000000000000000000000000008000000000000000000000000000000000000000000000000000000000007fff8000000000000000000000000000000000000000000000000000000000007fff0000000000000000000000000000000080000000000000000000000000007fff;
    exp_raw[8][0] = 160'hfffffd7fd3ffffc700240000367fdc0000087f2d;
    exp_biased[8][0] = 160'hfffffd7ff3ffffc700440000367ffc0000087f4d;
    exp_shifted[8][0] = 160'hfffffff5ffffffff1c01000000d9ff00000021fd;
    exp_stage16[8][0] = 64'hf5ff1c01d9ff21fd;
    exp_final10[8][0] = 40'h7fc017fdfd;
    exp_raw[8][1] = 160'h00008cff2d00006affdcfffff10024fffffeffd3;
    exp_biased[8][1] = 160'h00008cff4d00006afffcfffff10044fffffefff3;
    exp_shifted[8][1] = 160'h00000233fd000001abffffffffc401fffffffbff;
    exp_stage16[8][1] = 64'h33fdabffc401fbff;
    exp_final10[8][1] = 40'hff7ff007ff;
    exp_raw[8][2] = 160'h00003bffd3000010002400008e7fdc0000387f2d;
    exp_biased[8][2] = 160'h00003bfff3000010004400008e7ffc0000387f4d;
    exp_shifted[8][2] = 160'h000000efff000000400100000239ff000000e1fd;
    exp_stage16[8][2] = 64'hefff400139ffe1fd;
    exp_final10[8][2] = 40'hffc017fdfd;
    exp_raw[8][3] = 160'h00007dff2d000029ffdcffffe780240000087fd3;
    exp_biased[8][3] = 160'h00007dff4d000029fffcffffe780440000087ff3;
    exp_shifted[8][3] = 160'h000001f7fd000000a7ffffffff9e0100000021ff;
    exp_stage16[8][3] = 64'hf7fda7ff9e0121ff;
    exp_final10[8][3] = 40'hff7ff805ff;
    exp_raw[8][4] = 160'h000000ffd3ffffbe802400002dffdcffffccff2d;
    exp_biased[8][4] = 160'h000000fff3ffffbe804400002dfffcffffccff4d;
    exp_shifted[8][4] = 160'h00000003fffffffefa01000000b7ffffffff33fd;
    exp_stage16[8][4] = 64'h03fffa01b7ff33fd;
    exp_final10[8][4] = 40'hffe01ffffd;
    exp_raw[8][5] = 160'h0000cc7f2d0000127fdcffffd18024ffffd07fd3;
    exp_biased[8][5] = 160'h0000cc7f4d0000127ffcffffd18044ffffd07ff3;
    exp_shifted[8][5] = 160'h00000331fd00000049ffffffff4601ffffff41ff;
    exp_stage16[8][5] = 64'h31fd49ff460141ff;
    exp_final10[8][5] = 40'h7f5ff805ff;
    exp_raw[8][6] = 160'h0000637fd300001a80240000697fdc0000007f2d;
    exp_biased[8][6] = 160'h0000637ff300001a80440000697ffc0000007f4d;
    exp_shifted[8][6] = 160'h0000018dff0000006a01000001a5ff00000001fd;
    exp_stage16[8][6] = 64'h8dff6a01a5ff01fd;
    exp_final10[8][6] = 40'h7fe017fdfd;
    exp_raw[8][7] = 160'h0000e6ff2d00000f7fdc00000b802400001affd3;
    exp_biased[8][7] = 160'h0000e6ff4d00000f7ffc00000b804400001afff3;
    exp_shifted[8][7] = 160'h0000039bfd0000003dff0000002e010000006bff;
    exp_stage16[8][7] = 64'h9bfd3dff2e016bff;
    exp_final10[8][7] = 40'hff5ff807ff;
    exp_raw[8][8] = 160'h000011ffd3ffffd080240000147fdcffffebff2d;
    exp_biased[8][8] = 160'h000011fff3ffffd080440000147ffcffffebff4d;
    exp_shifted[8][8] = 160'h00000047ffffffff420100000051ffffffffaffd;
    exp_stage16[8][8] = 64'h47ff420151ffaffd;
    exp_final10[8][8] = 40'hffe017fffd;
    exp_raw[8][9] = 160'h0000d27f2dffffba7fdcffffc18024ffffc97fd3;
    exp_biased[8][9] = 160'h0000d27f4dffffba7ffcffffc18044ffffc97ff3;
    exp_shifted[8][9] = 160'h00000349fdfffffee9ffffffff0601ffffff25ff;
    exp_stage16[8][9] = 64'h49fde9ff060125ff;
    exp_final10[8][9] = 40'h7f5ff805ff;
    exp_raw[8][10] = 160'h00005c7fd300000a80240000117fdc0000067f2d;
    exp_biased[8][10] = 160'h00005c7ff300000a80440000117ffc0000067f4d;
    exp_shifted[8][10] = 160'h00000171ff0000002a0100000045ff00000019fd;
    exp_stage16[8][10] = 64'h71ff2a0145ff19fd;
    exp_final10[8][10] = 40'h7fe017fdfd;
    exp_raw[8][11] = 160'h000105ff2dfffff5ffdc00001d802400002bffd3;
    exp_biased[8][11] = 160'h000105ff4dfffff5fffc00001d804400002bfff3;
    exp_shifted[8][11] = 160'h00000417fdffffffd7ff0000007601000000afff;
    exp_stage16[8][11] = 64'h17fdd7ff7601afff;
    exp_final10[8][11] = 40'hff7ff807ff;
    exp_raw[8][12] = 160'h0000247fd3fffff48024fffff9ffdc000054ff2d;
    exp_biased[8][12] = 160'h0000247ff3fffff48044fffff9fffc000054ff4d;
    exp_shifted[8][12] = 160'h00000091ffffffffd201ffffffe7ff00000153fd;
    exp_stage16[8][12] = 64'h91ffd201e7ff53fd;
    exp_final10[8][12] = 40'h7fe01ffffd;
    exp_raw[8][13] = 160'h00009a7f2dffff957fdcffffcc0024fffff0ffd3;
    exp_biased[8][13] = 160'h00009a7f4dffff957ffcffffcc0044fffff0fff3;
    exp_shifted[8][13] = 160'h00000269fdfffffe55ffffffff3001ffffffc3ff;
    exp_stage16[8][13] = 64'h69fd55ff3001c3ff;
    exp_final10[8][13] = 40'h7f5ff007ff;
    exp_raw[8][14] = 160'h00002dffd3ffffeb0024ffffb8ffdc000045ff2d;
    exp_biased[8][14] = 160'h00002dfff3ffffeb0044ffffb8fffc000045ff4d;
    exp_shifted[8][14] = 160'h000000b7ffffffffac01fffffee3ff00000117fd;
    exp_stage16[8][14] = 64'hb7ffac01e3ff17fd;
    exp_final10[8][14] = 40'hffc01ffffd;
    exp_raw[8][15] = 160'h0000ca7f2dffffed7fdc000015002400002f7fd3;
    exp_biased[8][15] = 160'h0000ca7f4dffffed7ffc000015004400002f7ff3;
    exp_shifted[8][15] = 160'h00000329fdffffffb5ff0000005401000000bdff;
    exp_stage16[8][15] = 64'h29fdb5ff5401bdff;
    exp_final10[8][15] = 40'h7f5ff005ff;
    case_input[9] = 1024'h0000000000000000000000000000000000000000000000000000000000000000000000000000000000000000000000000000000000000000000000000000000000000000000000000000000000000000000000000000000000000000000000000000000000000000000000000000000000000000000000000000000000000001;
    exp_raw[9][0] = 160'h0000000040000000004000000000400000000040;
    exp_biased[9][0] = 160'h0000000060000000006000000000600000000060;
    exp_shifted[9][0] = 160'h0000000001000000000100000000010000000001;
    exp_stage16[9][0] = 64'h0001000100010001;
    exp_final10[9][0] = 40'h0040100401;
    exp_raw[9][1] = 160'h0000000040000000004000000000400000000040;
    exp_biased[9][1] = 160'h0000000060000000006000000000600000000060;
    exp_shifted[9][1] = 160'h0000000001000000000100000000010000000001;
    exp_stage16[9][1] = 64'h0001000100010001;
    exp_final10[9][1] = 40'h0040100401;
    exp_raw[9][2] = 160'h0000000040000000004000000000400000000040;
    exp_biased[9][2] = 160'h0000000060000000006000000000600000000060;
    exp_shifted[9][2] = 160'h0000000001000000000100000000010000000001;
    exp_stage16[9][2] = 64'h0001000100010001;
    exp_final10[9][2] = 40'h0040100401;
    exp_raw[9][3] = 160'h0000000040000000004000000000400000000040;
    exp_biased[9][3] = 160'h0000000060000000006000000000600000000060;
    exp_shifted[9][3] = 160'h0000000001000000000100000000010000000001;
    exp_stage16[9][3] = 64'h0001000100010001;
    exp_final10[9][3] = 40'h0040100401;
    exp_raw[9][4] = 160'h0000000040000000004000000000400000000040;
    exp_biased[9][4] = 160'h0000000060000000006000000000600000000060;
    exp_shifted[9][4] = 160'h0000000001000000000100000000010000000001;
    exp_stage16[9][4] = 64'h0001000100010001;
    exp_final10[9][4] = 40'h0040100401;
    exp_raw[9][5] = 160'h0000000040000000004000000000400000000040;
    exp_biased[9][5] = 160'h0000000060000000006000000000600000000060;
    exp_shifted[9][5] = 160'h0000000001000000000100000000010000000001;
    exp_stage16[9][5] = 64'h0001000100010001;
    exp_final10[9][5] = 40'h0040100401;
    exp_raw[9][6] = 160'h0000000040000000004000000000400000000040;
    exp_biased[9][6] = 160'h0000000060000000006000000000600000000060;
    exp_shifted[9][6] = 160'h0000000001000000000100000000010000000001;
    exp_stage16[9][6] = 64'h0001000100010001;
    exp_final10[9][6] = 40'h0040100401;
    exp_raw[9][7] = 160'h0000000040000000004000000000400000000040;
    exp_biased[9][7] = 160'h0000000060000000006000000000600000000060;
    exp_shifted[9][7] = 160'h0000000001000000000100000000010000000001;
    exp_stage16[9][7] = 64'h0001000100010001;
    exp_final10[9][7] = 40'h0040100401;
    exp_raw[9][8] = 160'h0000000040000000004000000000400000000040;
    exp_biased[9][8] = 160'h0000000060000000006000000000600000000060;
    exp_shifted[9][8] = 160'h0000000001000000000100000000010000000001;
    exp_stage16[9][8] = 64'h0001000100010001;
    exp_final10[9][8] = 40'h0040100401;
    exp_raw[9][9] = 160'h0000000040000000004000000000400000000040;
    exp_biased[9][9] = 160'h0000000060000000006000000000600000000060;
    exp_shifted[9][9] = 160'h0000000001000000000100000000010000000001;
    exp_stage16[9][9] = 64'h0001000100010001;
    exp_final10[9][9] = 40'h0040100401;
    exp_raw[9][10] = 160'h0000000040000000004000000000400000000040;
    exp_biased[9][10] = 160'h0000000060000000006000000000600000000060;
    exp_shifted[9][10] = 160'h0000000001000000000100000000010000000001;
    exp_stage16[9][10] = 64'h0001000100010001;
    exp_final10[9][10] = 40'h0040100401;
    exp_raw[9][11] = 160'h0000000040000000004000000000400000000040;
    exp_biased[9][11] = 160'h0000000060000000006000000000600000000060;
    exp_shifted[9][11] = 160'h0000000001000000000100000000010000000001;
    exp_stage16[9][11] = 64'h0001000100010001;
    exp_final10[9][11] = 40'h0040100401;
    exp_raw[9][12] = 160'h0000000040000000004000000000400000000040;
    exp_biased[9][12] = 160'h0000000060000000006000000000600000000060;
    exp_shifted[9][12] = 160'h0000000001000000000100000000010000000001;
    exp_stage16[9][12] = 64'h0001000100010001;
    exp_final10[9][12] = 40'h0040100401;
    exp_raw[9][13] = 160'h0000000040000000004000000000400000000040;
    exp_biased[9][13] = 160'h0000000060000000006000000000600000000060;
    exp_shifted[9][13] = 160'h0000000001000000000100000000010000000001;
    exp_stage16[9][13] = 64'h0001000100010001;
    exp_final10[9][13] = 40'h0040100401;
    exp_raw[9][14] = 160'h0000000040000000004000000000400000000040;
    exp_biased[9][14] = 160'h0000000060000000006000000000600000000060;
    exp_shifted[9][14] = 160'h0000000001000000000100000000010000000001;
    exp_stage16[9][14] = 64'h0001000100010001;
    exp_final10[9][14] = 40'h0040100401;
    exp_raw[9][15] = 160'h0000000040000000004000000000400000000040;
    exp_biased[9][15] = 160'h0000000060000000006000000000600000000060;
    exp_shifted[9][15] = 160'h0000000001000000000100000000010000000001;
    exp_stage16[9][15] = 64'h0001000100010001;
    exp_final10[9][15] = 40'h0040100401;
    case_input[10] = 1024'h0000000000000000000000000000000000000000000000000000000000000000000000000000000000000000000000000000000000000000000000000000000000000000000000000000000000000000000000000000000000000000000000000000000000000000000000000000000000000000000000000000000000010000;
    exp_raw[10][0] = 160'h000000005a000000005a000000005a000000005b;
    exp_biased[10][0] = 160'h000000007a000000007a000000007a000000007b;
    exp_shifted[10][0] = 160'h0000000001000000000100000000010000000001;
    exp_stage16[10][0] = 64'h0001000100010001;
    exp_final10[10][0] = 40'h0040100401;
    exp_raw[10][1] = 160'h0000000054000000005600000000570000000058;
    exp_biased[10][1] = 160'h0000000074000000007600000000770000000078;
    exp_shifted[10][1] = 160'h0000000001000000000100000000010000000001;
    exp_stage16[10][1] = 64'h0001000100010001;
    exp_final10[10][1] = 40'h0040100401;
    exp_raw[10][2] = 160'h000000004d000000004f00000000510000000053;
    exp_biased[10][2] = 160'h000000006d000000006f00000000710000000073;
    exp_shifted[10][2] = 160'h0000000001000000000100000000010000000001;
    exp_stage16[10][2] = 64'h0001000100010001;
    exp_final10[10][2] = 40'h0040100401;
    exp_raw[10][3] = 160'h0000000041000000004500000000470000000049;
    exp_biased[10][3] = 160'h0000000061000000006500000000670000000069;
    exp_shifted[10][3] = 160'h0000000001000000000100000000010000000001;
    exp_stage16[10][3] = 64'h0001000100010001;
    exp_final10[10][3] = 40'h0040100401;
    exp_raw[10][4] = 160'h00000000340000000038000000003b000000003e;
    exp_biased[10][4] = 160'h00000000540000000058000000005b000000005e;
    exp_shifted[10][4] = 160'h0000000001000000000100000000010000000001;
    exp_stage16[10][4] = 64'h0001000100010001;
    exp_final10[10][4] = 40'h0040100401;
    exp_raw[10][5] = 160'h00000000250000000029000000002c0000000030;
    exp_biased[10][5] = 160'h00000000450000000049000000004c0000000050;
    exp_shifted[10][5] = 160'h0000000001000000000100000000010000000001;
    exp_stage16[10][5] = 64'h0001000100010001;
    exp_final10[10][5] = 40'h0040100401;
    exp_raw[10][6] = 160'h00000000140000000018000000001c0000000021;
    exp_biased[10][6] = 160'h00000000340000000038000000003c0000000041;
    exp_shifted[10][6] = 160'h0000000000000000000000000000000000000001;
    exp_stage16[10][6] = 64'h0000000000000001;
    exp_final10[10][6] = 40'h0000000001;
    exp_raw[10][7] = 160'h00000000020000000007000000000b000000000f;
    exp_biased[10][7] = 160'h00000000220000000027000000002b000000002f;
    exp_shifted[10][7] = 160'h0000000000000000000000000000000000000000;
    exp_stage16[10][7] = 64'h0000000000000000;
    exp_final10[10][7] = 40'h0000000000;
    exp_raw[10][8] = 160'hfffffffff1fffffffff5fffffffff9fffffffffe;
    exp_biased[10][8] = 160'h000000001100000000150000000019000000001e;
    exp_shifted[10][8] = 160'h0000000000000000000000000000000000000000;
    exp_stage16[10][8] = 64'h0000000000000000;
    exp_final10[10][8] = 40'h0000000000;
    exp_raw[10][9] = 160'hffffffffdfffffffffe4ffffffffe8ffffffffec;
    exp_biased[10][9] = 160'hffffffffff00000000040000000008000000000c;
    exp_shifted[10][9] = 160'hffffffffff000000000000000000000000000000;
    exp_stage16[10][9] = 64'hffff000000000000;
    exp_final10[10][9] = 40'hffc0000000;
    exp_raw[10][10] = 160'hffffffffd0ffffffffd4ffffffffd7ffffffffdb;
    exp_biased[10][10] = 160'hfffffffff0fffffffff4fffffffff7fffffffffb;
    exp_shifted[10][10] = 160'hffffffffffffffffffffffffffffffffffffffff;
    exp_stage16[10][10] = 64'hffffffffffffffff;
    exp_final10[10][10] = 40'hffffffffff;
    exp_raw[10][11] = 160'hffffffffc2ffffffffc5ffffffffc8ffffffffcc;
    exp_biased[10][11] = 160'hffffffffe2ffffffffe5ffffffffe8ffffffffec;
    exp_shifted[10][11] = 160'hffffffffffffffffffffffffffffffffffffffff;
    exp_stage16[10][11] = 64'hffffffffffffffff;
    exp_final10[10][11] = 40'hffffffffff;
    exp_raw[10][12] = 160'hffffffffb7ffffffffb9ffffffffbbffffffffbf;
    exp_biased[10][12] = 160'hffffffffd7ffffffffd9ffffffffdbffffffffdf;
    exp_shifted[10][12] = 160'hffffffffffffffffffffffffffffffffffffffff;
    exp_stage16[10][12] = 64'hffffffffffffffff;
    exp_final10[10][12] = 40'hffffffffff;
    exp_raw[10][13] = 160'hffffffffadffffffffafffffffffb1ffffffffb3;
    exp_biased[10][13] = 160'hffffffffcdffffffffcfffffffffd1ffffffffd3;
    exp_shifted[10][13] = 160'hffffffffffffffffffffffffffffffffffffffff;
    exp_stage16[10][13] = 64'hffffffffffffffff;
    exp_final10[10][13] = 40'hffffffffff;
    exp_raw[10][14] = 160'hffffffffa8ffffffffa9ffffffffaaffffffffac;
    exp_biased[10][14] = 160'hffffffffc8ffffffffc9ffffffffcaffffffffcc;
    exp_shifted[10][14] = 160'hffffffffffffffffffffffffffffffffffffffff;
    exp_stage16[10][14] = 64'hffffffffffffffff;
    exp_final10[10][14] = 40'hffffffffff;
    exp_raw[10][15] = 160'hffffffffa5ffffffffa6ffffffffa6ffffffffa6;
    exp_biased[10][15] = 160'hffffffffc5ffffffffc6ffffffffc6ffffffffc6;
    exp_shifted[10][15] = 160'hffffffffffffffffffffffffffffffffffffffff;
    exp_stage16[10][15] = 64'hffffffffffffffff;
    exp_final10[10][15] = 40'hffffffffff;
    case_input[11] = 1024'h0000000000000000000000000000000000000000000000000000000000000000000000000000000000000000000000000000000000000000000000000000000000000000000000000000000000000000000000000000000000000000000000000000000000000000000000000000000000000000000000000000000100000000;
    exp_raw[11][0] = 160'h00000000550000000058000000005a000000005a;
    exp_biased[11][0] = 160'h00000000750000000078000000007a000000007a;
    exp_shifted[11][0] = 160'h0000000001000000000100000000010000000001;
    exp_stage16[11][0] = 64'h0001000100010001;
    exp_final10[11][0] = 40'h0040100401;
    exp_raw[11][1] = 160'h00000000430000000049000000004e0000000052;
    exp_biased[11][1] = 160'h00000000630000000069000000006e0000000072;
    exp_shifted[11][1] = 160'h0000000001000000000100000000010000000001;
    exp_stage16[11][1] = 64'h0001000100010001;
    exp_final10[11][1] = 40'h0040100401;
    exp_raw[11][2] = 160'h0000000026000000002e0000000036000000003d;
    exp_biased[11][2] = 160'h0000000046000000004e0000000056000000005d;
    exp_shifted[11][2] = 160'h0000000001000000000100000000010000000001;
    exp_stage16[11][2] = 64'h0001000100010001;
    exp_final10[11][2] = 40'h0040100401;
    exp_raw[11][3] = 160'h0000000004000000000d0000000016000000001f;
    exp_biased[11][3] = 160'h0000000024000000002d0000000036000000003f;
    exp_shifted[11][3] = 160'h0000000000000000000000000000000000000000;
    exp_stage16[11][3] = 64'h0000000000000000;
    exp_final10[11][3] = 40'h0000000000;
    exp_raw[11][4] = 160'hffffffffe1ffffffffeafffffffff3fffffffffc;
    exp_biased[11][4] = 160'h0000000001000000000a0000000013000000001c;
    exp_shifted[11][4] = 160'h0000000000000000000000000000000000000000;
    exp_stage16[11][4] = 64'h0000000000000000;
    exp_final10[11][4] = 40'h0000000000;
    exp_raw[11][5] = 160'hffffffffc3ffffffffcaffffffffd2ffffffffda;
    exp_biased[11][5] = 160'hffffffffe3ffffffffeafffffffff2fffffffffa;
    exp_shifted[11][5] = 160'hffffffffffffffffffffffffffffffffffffffff;
    exp_stage16[11][5] = 64'hffffffffffffffff;
    exp_final10[11][5] = 40'hffffffffff;
    exp_raw[11][6] = 160'hffffffffaeffffffffb2ffffffffb7ffffffffbd;
    exp_biased[11][6] = 160'hffffffffceffffffffd2ffffffffd7ffffffffdd;
    exp_shifted[11][6] = 160'hffffffffffffffffffffffffffffffffffffffff;
    exp_stage16[11][6] = 64'hffffffffffffffff;
    exp_final10[11][6] = 40'hffffffffff;
    exp_raw[11][7] = 160'hffffffffa6ffffffffa6ffffffffa8ffffffffab;
    exp_biased[11][7] = 160'hffffffffc6ffffffffc6ffffffffc8ffffffffcb;
    exp_shifted[11][7] = 160'hffffffffffffffffffffffffffffffffffffffff;
    exp_stage16[11][7] = 64'hffffffffffffffff;
    exp_final10[11][7] = 40'hffffffffff;
    exp_raw[11][8] = 160'hffffffffabffffffffa8ffffffffa6ffffffffa6;
    exp_biased[11][8] = 160'hffffffffcbffffffffc8ffffffffc6ffffffffc6;
    exp_shifted[11][8] = 160'hffffffffffffffffffffffffffffffffffffffff;
    exp_stage16[11][8] = 64'hffffffffffffffff;
    exp_final10[11][8] = 40'hffffffffff;
    exp_raw[11][9] = 160'hffffffffbdffffffffb7ffffffffb2ffffffffae;
    exp_biased[11][9] = 160'hffffffffddffffffffd7ffffffffd2ffffffffce;
    exp_shifted[11][9] = 160'hffffffffffffffffffffffffffffffffffffffff;
    exp_stage16[11][9] = 64'hffffffffffffffff;
    exp_final10[11][9] = 40'hffffffffff;
    exp_raw[11][10] = 160'hffffffffdaffffffffd2ffffffffcaffffffffc3;
    exp_biased[11][10] = 160'hfffffffffafffffffff2ffffffffeaffffffffe3;
    exp_shifted[11][10] = 160'hffffffffffffffffffffffffffffffffffffffff;
    exp_stage16[11][10] = 64'hffffffffffffffff;
    exp_final10[11][10] = 40'hffffffffff;
    exp_raw[11][11] = 160'hfffffffffcfffffffff3ffffffffeaffffffffe1;
    exp_biased[11][11] = 160'h000000001c0000000013000000000a0000000001;
    exp_shifted[11][11] = 160'h0000000000000000000000000000000000000000;
    exp_stage16[11][11] = 64'h0000000000000000;
    exp_final10[11][11] = 40'h0000000000;
    exp_raw[11][12] = 160'h000000001f0000000016000000000d0000000004;
    exp_biased[11][12] = 160'h000000003f0000000036000000002d0000000024;
    exp_shifted[11][12] = 160'h0000000000000000000000000000000000000000;
    exp_stage16[11][12] = 64'h0000000000000000;
    exp_final10[11][12] = 40'h0000000000;
    exp_raw[11][13] = 160'h000000003d0000000036000000002e0000000026;
    exp_biased[11][13] = 160'h000000005d0000000056000000004e0000000046;
    exp_shifted[11][13] = 160'h0000000001000000000100000000010000000001;
    exp_stage16[11][13] = 64'h0001000100010001;
    exp_final10[11][13] = 40'h0040100401;
    exp_raw[11][14] = 160'h0000000052000000004e00000000490000000043;
    exp_biased[11][14] = 160'h0000000072000000006e00000000690000000063;
    exp_shifted[11][14] = 160'h0000000001000000000100000000010000000001;
    exp_stage16[11][14] = 64'h0001000100010001;
    exp_final10[11][14] = 40'h0040100401;
    exp_raw[11][15] = 160'h000000005a000000005a00000000580000000055;
    exp_biased[11][15] = 160'h000000007a000000007a00000000780000000075;
    exp_shifted[11][15] = 160'h0000000001000000000100000000010000000001;
    exp_stage16[11][15] = 64'h0001000100010001;
    exp_final10[11][15] = 40'h0040100401;
    case_input[12] = 1024'h0000000000000000000000000000000000000000000000000000000000000000000000000000000000000000000000000000000000000000000000000000000000000000000000000000000000000000000000000000000000000000000000000000000000000000000000000000000000000000000000000001000000000000;
    exp_raw[12][0] = 160'h000000004f00000000540000000058000000005a;
    exp_biased[12][0] = 160'h000000006f00000000740000000078000000007a;
    exp_shifted[12][0] = 160'h0000000001000000000100000000010000000001;
    exp_stage16[12][0] = 64'h0001000100010001;
    exp_final10[12][0] = 40'h0040100401;
    exp_raw[12][1] = 160'h00000000290000000034000000003e0000000047;
    exp_biased[12][1] = 160'h00000000490000000054000000005e0000000067;
    exp_shifted[12][1] = 160'h0000000001000000000100000000010000000001;
    exp_stage16[12][1] = 64'h0001000100010001;
    exp_final10[12][1] = 40'h0040100401;
    exp_raw[12][2] = 160'hfffffffff50000000002000000000f000000001c;
    exp_biased[12][2] = 160'h00000000150000000022000000002f000000003c;
    exp_shifted[12][2] = 160'h0000000000000000000000000000000000000000;
    exp_stage16[12][2] = 64'h0000000000000000;
    exp_final10[12][2] = 40'h0000000000;
    exp_raw[12][3] = 160'hffffffffc5ffffffffd0ffffffffdbffffffffe8;
    exp_biased[12][3] = 160'hffffffffe5fffffffff0fffffffffb0000000008;
    exp_shifted[12][3] = 160'hffffffffffffffffffffffffffffff0000000000;
    exp_stage16[12][3] = 64'hffffffffffff0000;
    exp_final10[12][3] = 40'hfffffffc00;
    exp_raw[12][4] = 160'hffffffffa9ffffffffadffffffffb3ffffffffbb;
    exp_biased[12][4] = 160'hffffffffc9ffffffffcdffffffffd3ffffffffdb;
    exp_shifted[12][4] = 160'hffffffffffffffffffffffffffffffffffffffff;
    exp_stage16[12][4] = 64'hffffffffffffffff;
    exp_final10[12][4] = 40'hffffffffff;
    exp_raw[12][5] = 160'hffffffffaaffffffffa6ffffffffa5ffffffffa6;
    exp_biased[12][5] = 160'hffffffffcaffffffffc6ffffffffc5ffffffffc6;
    exp_shifted[12][5] = 160'hffffffffffffffffffffffffffffffffffffffff;
    exp_stage16[12][5] = 64'hffffffffffffffff;
    exp_final10[12][5] = 40'hffffffffff;
    exp_raw[12][6] = 160'hffffffffc8ffffffffbfffffffffb7ffffffffaf;
    exp_biased[12][6] = 160'hffffffffe8ffffffffdfffffffffd7ffffffffcf;
    exp_shifted[12][6] = 160'hffffffffffffffffffffffffffffffffffffffff;
    exp_stage16[12][6] = 64'hffffffffffffffff;
    exp_final10[12][6] = 40'hffffffffff;
    exp_raw[12][7] = 160'hfffffffff9ffffffffecffffffffdfffffffffd4;
    exp_biased[12][7] = 160'h0000000019000000000cfffffffffffffffffff4;
    exp_shifted[12][7] = 160'h00000000000000000000ffffffffffffffffffff;
    exp_stage16[12][7] = 64'h00000000ffffffff;
    exp_final10[12][7] = 40'h00000fffff;
    exp_raw[12][8] = 160'h000000002c000000002100000000140000000007;
    exp_biased[12][8] = 160'h000000004c000000004100000000340000000027;
    exp_shifted[12][8] = 160'h0000000001000000000100000000000000000000;
    exp_stage16[12][8] = 64'h0001000100000000;
    exp_final10[12][8] = 40'h0040100000;
    exp_raw[12][9] = 160'h0000000051000000004900000000410000000038;
    exp_biased[12][9] = 160'h0000000071000000006900000000610000000058;
    exp_shifted[12][9] = 160'h0000000001000000000100000000010000000001;
    exp_stage16[12][9] = 64'h0001000100010001;
    exp_final10[12][9] = 40'h0040100401;
    exp_raw[12][10] = 160'h000000005a000000005b000000005a0000000056;
    exp_biased[12][10] = 160'h000000007a000000007b000000007a0000000076;
    exp_shifted[12][10] = 160'h0000000001000000000100000000010000000001;
    exp_stage16[12][10] = 64'h0001000100010001;
    exp_final10[12][10] = 40'h0040100401;
    exp_raw[12][11] = 160'h0000000045000000004d00000000530000000057;
    exp_biased[12][11] = 160'h0000000065000000006d00000000730000000077;
    exp_shifted[12][11] = 160'h0000000001000000000100000000010000000001;
    exp_stage16[12][11] = 64'h0001000100010001;
    exp_final10[12][11] = 40'h0040100401;
    exp_raw[12][12] = 160'h000000001800000000250000000030000000003b;
    exp_biased[12][12] = 160'h000000003800000000450000000050000000005b;
    exp_shifted[12][12] = 160'h0000000000000000000100000000010000000001;
    exp_stage16[12][12] = 64'h0000000100010001;
    exp_final10[12][12] = 40'h0000100401;
    exp_raw[12][13] = 160'hffffffffe4fffffffff1fffffffffe000000000b;
    exp_biased[12][13] = 160'h00000000040000000011000000001e000000002b;
    exp_shifted[12][13] = 160'h0000000000000000000000000000000000000000;
    exp_stage16[12][13] = 64'h0000000000000000;
    exp_final10[12][13] = 40'h0000000000;
    exp_raw[12][14] = 160'hffffffffb9ffffffffc2ffffffffccffffffffd7;
    exp_biased[12][14] = 160'hffffffffd9ffffffffe2ffffffffecfffffffff7;
    exp_shifted[12][14] = 160'hffffffffffffffffffffffffffffffffffffffff;
    exp_stage16[12][14] = 64'hffffffffffffffff;
    exp_final10[12][14] = 40'hffffffffff;
    exp_raw[12][15] = 160'hffffffffa6ffffffffa8ffffffffacffffffffb1;
    exp_biased[12][15] = 160'hffffffffc6ffffffffc8ffffffffccffffffffd1;
    exp_shifted[12][15] = 160'hffffffffffffffffffffffffffffffffffffffff;
    exp_stage16[12][15] = 64'hffffffffffffffff;
    exp_final10[12][15] = 40'hffffffffff;
    case_input[13] = 1024'h0000000000000000000000000000000000000000000000000000000000000000000000000000000000000000000000000000000000000000000000000000000000000000000000000000000000000000000000000000000000000000000000000000000000000000000000000000000000010000000000000000000000000000;
    exp_raw[13][0] = 160'h0000000021000000003b000000004f000000005a;
    exp_biased[13][0] = 160'h0000000041000000005b000000006f000000007a;
    exp_shifted[13][0] = 160'h0000000001000000000100000000010000000001;
    exp_stage16[13][0] = 64'h0001000100010001;
    exp_final10[13][0] = 40'h0040100401;
    exp_raw[13][1] = 160'hffffffffb3ffffffffc8ffffffffe40000000002;
    exp_biased[13][1] = 160'hffffffffd3ffffffffe800000000040000000022;
    exp_shifted[13][1] = 160'hffffffffffffffffffff00000000000000000000;
    exp_stage16[13][1] = 64'hffffffff00000000;
    exp_final10[13][1] = 40'hfffff00000;
    exp_raw[13][2] = 160'hffffffffc2ffffffffafffffffffa6ffffffffa8;
    exp_biased[13][2] = 160'hffffffffe2ffffffffcfffffffffc6ffffffffc8;
    exp_shifted[13][2] = 160'hffffffffffffffffffffffffffffffffffffffff;
    exp_stage16[13][2] = 64'hffffffffffffffff;
    exp_final10[13][2] = 40'hffffffffff;
    exp_raw[13][3] = 160'h00000000340000000018fffffffff9ffffffffdb;
    exp_biased[13][3] = 160'h000000005400000000380000000019fffffffffb;
    exp_shifted[13][3] = 160'h000000000100000000000000000000ffffffffff;
    exp_stage16[13][3] = 64'h000100000000ffff;
    exp_final10[13][3] = 40'h00400003ff;
    exp_raw[13][4] = 160'h0000000053000000005a00000000570000000049;
    exp_biased[13][4] = 160'h0000000073000000007a00000000770000000069;
    exp_shifted[13][4] = 160'h0000000001000000000100000000010000000001;
    exp_stage16[13][4] = 64'h0001000100010001;
    exp_final10[13][4] = 40'h0040100401;
    exp_raw[13][5] = 160'hffffffffec000000000b00000000290000000041;
    exp_biased[13][5] = 160'h000000000c000000002b00000000490000000061;
    exp_shifted[13][5] = 160'h0000000000000000000000000000010000000001;
    exp_stage16[13][5] = 64'h0000000000010001;
    exp_final10[13][5] = 40'h0000000401;
    exp_raw[13][6] = 160'hffffffffa5ffffffffaaffffffffb9ffffffffd0;
    exp_biased[13][6] = 160'hffffffffc5ffffffffcaffffffffd9fffffffff0;
    exp_shifted[13][6] = 160'hffffffffffffffffffffffffffffffffffffffff;
    exp_stage16[13][6] = 64'hffffffffffffffff;
    exp_final10[13][6] = 40'hffffffffff;
    exp_raw[13][7] = 160'hfffffffff1ffffffffd4ffffffffbbffffffffac;
    exp_biased[13][7] = 160'h0000000011fffffffff4ffffffffdbffffffffcc;
    exp_shifted[13][7] = 160'h0000000000ffffffffffffffffffffffffffffff;
    exp_stage16[13][7] = 64'h0000ffffffffffff;
    exp_final10[13][7] = 40'h003fffffff;
    exp_raw[13][8] = 160'h00000000540000000045000000002c000000000f;
    exp_biased[13][8] = 160'h00000000740000000065000000004c000000002f;
    exp_shifted[13][8] = 160'h0000000001000000000100000000010000000000;
    exp_stage16[13][8] = 64'h0001000100010000;
    exp_final10[13][8] = 40'h0040100400;
    exp_raw[13][9] = 160'h000000003000000000470000000056000000005b;
    exp_biased[13][9] = 160'h000000005000000000670000000076000000007b;
    exp_shifted[13][9] = 160'h0000000001000000000100000000010000000001;
    exp_stage16[13][9] = 64'h0001000100010001;
    exp_final10[13][9] = 40'h0040100401;
    exp_raw[13][10] = 160'hffffffffbfffffffffd7fffffffff50000000014;
    exp_biased[13][10] = 160'hffffffffdffffffffff700000000150000000034;
    exp_shifted[13][10] = 160'hffffffffffffffffffff00000000000000000000;
    exp_stage16[13][10] = 64'hffffffff00000000;
    exp_final10[13][10] = 40'hfffff00000;
    exp_raw[13][11] = 160'hffffffffb7ffffffffa9ffffffffa6ffffffffad;
    exp_biased[13][11] = 160'hffffffffd7ffffffffc9ffffffffc6ffffffffcd;
    exp_shifted[13][11] = 160'hffffffffffffffffffffffffffffffffffffffff;
    exp_stage16[13][11] = 64'hffffffffffffffff;
    exp_final10[13][11] = 40'hffffffffff;
    exp_raw[13][12] = 160'h00000000250000000007ffffffffe8ffffffffcc;
    exp_biased[13][12] = 160'h000000004500000000270000000008ffffffffec;
    exp_shifted[13][12] = 160'h000000000100000000000000000000ffffffffff;
    exp_stage16[13][12] = 64'h000100000000ffff;
    exp_final10[13][12] = 40'h00400003ff;
    exp_raw[13][13] = 160'h0000000058000000005a0000000051000000003e;
    exp_biased[13][13] = 160'h0000000078000000007a0000000071000000005e;
    exp_shifted[13][13] = 160'h0000000001000000000100000000010000000001;
    exp_stage16[13][13] = 64'h0001000100010001;
    exp_final10[13][13] = 40'h0040100401;
    exp_raw[13][14] = 160'hfffffffffe000000001c0000000038000000004d;
    exp_biased[13][14] = 160'h000000001e000000003c0000000058000000006d;
    exp_shifted[13][14] = 160'h0000000000000000000000000000010000000001;
    exp_stage16[13][14] = 64'h0000000000010001;
    exp_final10[13][14] = 40'h0000000401;
    exp_raw[13][15] = 160'hffffffffa6ffffffffb1ffffffffc5ffffffffdf;
    exp_biased[13][15] = 160'hffffffffc6ffffffffd1ffffffffe5ffffffffff;
    exp_shifted[13][15] = 160'hffffffffffffffffffffffffffffffffffffffff;
    exp_stage16[13][15] = 64'hffffffffffffffff;
    exp_final10[13][15] = 40'hffffffffff;
    case_input[14] = 1024'h0000000000000000000000000000000000000000000000000000000000000000000000000000000000000000000000000000000000000000000000000000000000000000000000000000000000000000000000000000000000000000000000000001000000000000000000000000000000000000000000000000000000000000;
    exp_raw[14][0] = 160'hffffffffb3ffffffffe800000000290000000054;
    exp_biased[14][0] = 160'hffffffffd3000000000800000000490000000074;
    exp_shifted[14][0] = 160'hffffffffff000000000000000000010000000001;
    exp_stage16[14][0] = 64'hffff000000010001;
    exp_final10[14][0] = 40'hffc0000401;
    exp_raw[14][1] = 160'h00000000410000000007ffffffffc8ffffffffa6;
    exp_biased[14][1] = 160'h00000000610000000027ffffffffe8ffffffffc6;
    exp_shifted[14][1] = 160'h00000000010000000000ffffffffffffffffffff;
    exp_stage16[14][1] = 64'h00010000ffffffff;
    exp_final10[14][1] = 40'h00400fffff;
    exp_raw[14][2] = 160'hffffffffcc000000000b0000000045000000005b;
    exp_biased[14][2] = 160'hffffffffec000000002b0000000065000000007b;
    exp_shifted[14][2] = 160'hffffffffff000000000000000000010000000001;
    exp_stage16[14][2] = 64'hffff000000010001;
    exp_final10[14][2] = 40'hffc0000401;
    exp_raw[14][3] = 160'h0000000025ffffffffe4ffffffffb1ffffffffa8;
    exp_biased[14][3] = 160'h00000000450000000004ffffffffd1ffffffffc8;
    exp_shifted[14][3] = 160'h00000000010000000000ffffffffffffffffffff;
    exp_stage16[14][3] = 64'h00010000ffffffff;
    exp_final10[14][3] = 40'h00400fffff;
    exp_raw[14][4] = 160'hffffffffec000000002c00000000560000000053;
    exp_biased[14][4] = 160'h000000000c000000004c00000000760000000073;
    exp_shifted[14][4] = 160'h0000000000000000000100000000010000000001;
    exp_stage16[14][4] = 64'h0000000100010001;
    exp_final10[14][4] = 40'h0000100401;
    exp_raw[14][5] = 160'h0000000002ffffffffc5ffffffffa6ffffffffb7;
    exp_biased[14][5] = 160'h0000000022ffffffffe5ffffffffc6ffffffffd7;
    exp_shifted[14][5] = 160'h0000000000ffffffffffffffffffffffffffffff;
    exp_stage16[14][5] = 64'h0000ffffffffffff;
    exp_final10[14][5] = 40'h003fffffff;
    exp_raw[14][6] = 160'h000000000f0000000047000000005a000000003e;
    exp_biased[14][6] = 160'h000000002f0000000067000000007a000000005e;
    exp_shifted[14][6] = 160'h0000000000000000000100000000010000000001;
    exp_stage16[14][6] = 64'h0000000100010001;
    exp_final10[14][6] = 40'h0000100401;
    exp_raw[14][7] = 160'hffffffffdfffffffffafffffffffa9ffffffffd0;
    exp_biased[14][7] = 160'hffffffffffffffffffcfffffffffc9fffffffff0;
    exp_shifted[14][7] = 160'hffffffffffffffffffffffffffffffffffffffff;
    exp_stage16[14][7] = 64'hffffffffffffffff;
    exp_final10[14][7] = 40'hffffffffff;
    exp_raw[14][8] = 160'h0000000030000000005700000000510000000021;
    exp_biased[14][8] = 160'h0000000050000000007700000000710000000041;
    exp_shifted[14][8] = 160'h0000000001000000000100000000010000000001;
    exp_stage16[14][8] = 64'h0001000100010001;
    exp_final10[14][8] = 40'h0040100401;
    exp_raw[14][9] = 160'hffffffffc2ffffffffa6ffffffffb9fffffffff1;
    exp_biased[14][9] = 160'hffffffffe2ffffffffc6ffffffffd90000000011;
    exp_shifted[14][9] = 160'hffffffffffffffffffffffffffffff0000000000;
    exp_stage16[14][9] = 64'hffffffffffff0000;
    exp_final10[14][9] = 40'hfffffffc00;
    exp_raw[14][10] = 160'h0000000049000000005a000000003bfffffffffe;
    exp_biased[14][10] = 160'h0000000069000000007a000000005b000000001e;
    exp_shifted[14][10] = 160'h0000000001000000000100000000010000000000;
    exp_stage16[14][10] = 64'h0001000100010000;
    exp_final10[14][10] = 40'h0040100400;
    exp_raw[14][11] = 160'hffffffffadffffffffaaffffffffd40000000014;
    exp_biased[14][11] = 160'hffffffffcdffffffffcafffffffff40000000034;
    exp_shifted[14][11] = 160'hffffffffffffffffffffffffffffff0000000000;
    exp_stage16[14][11] = 64'hffffffffffff0000;
    exp_final10[14][11] = 40'hfffffffc00;
    exp_raw[14][12] = 160'h0000000058000000004f000000001cffffffffdb;
    exp_biased[14][12] = 160'h0000000078000000006f000000003cfffffffffb;
    exp_shifted[14][12] = 160'h000000000100000000010000000000ffffffffff;
    exp_stage16[14][12] = 64'h000100010000ffff;
    exp_final10[14][12] = 40'h00401003ff;
    exp_raw[14][13] = 160'hffffffffa5ffffffffbbfffffffff50000000034;
    exp_biased[14][13] = 160'hffffffffc5ffffffffdb00000000150000000054;
    exp_shifted[14][13] = 160'hffffffffffffffffffff00000000000000000001;
    exp_stage16[14][13] = 64'hffffffff00000001;
    exp_final10[14][13] = 40'hfffff00001;
    exp_raw[14][14] = 160'h000000005a0000000038fffffffff9ffffffffbf;
    exp_biased[14][14] = 160'h000000007a00000000580000000019ffffffffdf;
    exp_shifted[14][14] = 160'h000000000100000000010000000000ffffffffff;
    exp_stage16[14][14] = 64'h000100010000ffff;
    exp_final10[14][14] = 40'h00401003ff;
    exp_raw[14][15] = 160'hffffffffacffffffffd70000000018000000004d;
    exp_biased[14][15] = 160'hffffffffccfffffffff70000000038000000006d;
    exp_shifted[14][15] = 160'hffffffffffffffffffff00000000000000000001;
    exp_stage16[14][15] = 64'hffffffff00000001;
    exp_final10[14][15] = 40'hfffff00001;
    case_input[15] = 1024'h0000000000000000000000000000000000000000000000000000000000000000000000000000000000000000000000000000000000000000000000000000000000010000000000000000000000000000000000000000000000000000000000000000000000000000000000000000000000000000000000000000000000000000;
    exp_raw[15][0] = 160'h0000000034ffffffffb9ffffffffc50000000041;
    exp_biased[15][0] = 160'h0000000054ffffffffd9ffffffffe50000000061;
    exp_shifted[15][0] = 160'h0000000001ffffffffffffffffffff0000000001;
    exp_stage16[15][0] = 64'h0001ffffffff0001;
    exp_final10[15][0] = 40'h007ffffc01;
    exp_raw[15][1] = 160'h0000000025ffffffffafffffffffd4000000004d;
    exp_biased[15][1] = 160'h0000000045ffffffffcffffffffff4000000006d;
    exp_shifted[15][1] = 160'h0000000001ffffffffffffffffffff0000000001;
    exp_stage16[15][1] = 64'h0001ffffffff0001;
    exp_final10[15][1] = 40'h007ffffc01;
    exp_raw[15][2] = 160'h0000000014ffffffffa9ffffffffe40000000054;
    exp_biased[15][2] = 160'h0000000034ffffffffc900000000040000000074;
    exp_shifted[15][2] = 160'h0000000000ffffffffff00000000000000000001;
    exp_stage16[15][2] = 64'h0000ffff00000001;
    exp_final10[15][2] = 40'h003ff00001;
    exp_raw[15][3] = 160'h0000000002ffffffffa6fffffffff5000000005a;
    exp_biased[15][3] = 160'h0000000022ffffffffc60000000015000000007a;
    exp_shifted[15][3] = 160'h0000000000ffffffffff00000000000000000001;
    exp_stage16[15][3] = 64'h0000ffff00000001;
    exp_final10[15][3] = 40'h003ff00001;
    exp_raw[15][4] = 160'hfffffffff1ffffffffa60000000007000000005b;
    exp_biased[15][4] = 160'h0000000011ffffffffc60000000027000000007b;
    exp_shifted[15][4] = 160'h0000000000ffffffffff00000000000000000001;
    exp_stage16[15][4] = 64'h0000ffff00000001;
    exp_final10[15][4] = 40'h003ff00001;
    exp_raw[15][5] = 160'hffffffffdfffffffffaa00000000180000000058;
    exp_biased[15][5] = 160'hffffffffffffffffffca00000000380000000078;
    exp_shifted[15][5] = 160'hffffffffffffffffffff00000000000000000001;
    exp_stage16[15][5] = 64'hffffffff00000001;
    exp_final10[15][5] = 40'hfffff00001;
    exp_raw[15][6] = 160'hffffffffd0ffffffffb100000000290000000053;
    exp_biased[15][6] = 160'hfffffffff0ffffffffd100000000490000000073;
    exp_shifted[15][6] = 160'hffffffffffffffffffff00000000010000000001;
    exp_stage16[15][6] = 64'hffffffff00010001;
    exp_final10[15][6] = 40'hfffff00401;
    exp_raw[15][7] = 160'hffffffffc2ffffffffbb00000000380000000049;
    exp_biased[15][7] = 160'hffffffffe2ffffffffdb00000000580000000069;
    exp_shifted[15][7] = 160'hffffffffffffffffffff00000000010000000001;
    exp_stage16[15][7] = 64'hffffffff00010001;
    exp_final10[15][7] = 40'hfffff00401;
    exp_raw[15][8] = 160'hffffffffb7ffffffffc80000000045000000003e;
    exp_biased[15][8] = 160'hffffffffd7ffffffffe80000000065000000005e;
    exp_shifted[15][8] = 160'hffffffffffffffffffff00000000010000000001;
    exp_stage16[15][8] = 64'hffffffff00010001;
    exp_final10[15][8] = 40'hfffff00401;
    exp_raw[15][9] = 160'hffffffffadffffffffd7000000004f0000000030;
    exp_biased[15][9] = 160'hffffffffcdfffffffff7000000006f0000000050;
    exp_shifted[15][9] = 160'hffffffffffffffffffff00000000010000000001;
    exp_stage16[15][9] = 64'hffffffff00010001;
    exp_final10[15][9] = 40'hfffff00401;
    exp_raw[15][10] = 160'hffffffffa8ffffffffe800000000560000000021;
    exp_biased[15][10] = 160'hffffffffc8000000000800000000760000000041;
    exp_shifted[15][10] = 160'hffffffffff000000000000000000010000000001;
    exp_stage16[15][10] = 64'hffff000000010001;
    exp_final10[15][10] = 40'hffc0000401;
    exp_raw[15][11] = 160'hffffffffa5fffffffff9000000005a000000000f;
    exp_biased[15][11] = 160'hffffffffc50000000019000000007a000000002f;
    exp_shifted[15][11] = 160'hffffffffff000000000000000000010000000000;
    exp_stage16[15][11] = 64'hffff000000010000;
    exp_final10[15][11] = 40'hffc0000400;
    exp_raw[15][12] = 160'hffffffffa6000000000b000000005afffffffffe;
    exp_biased[15][12] = 160'hffffffffc6000000002b000000007a000000001e;
    exp_shifted[15][12] = 160'hffffffffff000000000000000000010000000000;
    exp_stage16[15][12] = 64'hffff000000010000;
    exp_final10[15][12] = 40'hffc0000400;
    exp_raw[15][13] = 160'hffffffffac000000001c0000000057ffffffffec;
    exp_biased[15][13] = 160'hffffffffcc000000003c0000000077000000000c;
    exp_shifted[15][13] = 160'hffffffffff000000000000000000010000000000;
    exp_stage16[15][13] = 64'hffff000000010000;
    exp_final10[15][13] = 40'hffc0000400;
    exp_raw[15][14] = 160'hffffffffb3000000002c0000000051ffffffffdb;
    exp_biased[15][14] = 160'hffffffffd3000000004c0000000071fffffffffb;
    exp_shifted[15][14] = 160'hffffffffff00000000010000000001ffffffffff;
    exp_stage16[15][14] = 64'hffff00010001ffff;
    exp_final10[15][14] = 40'hffc01007ff;
    exp_raw[15][15] = 160'hffffffffbf000000003b0000000047ffffffffcc;
    exp_biased[15][15] = 160'hffffffffdf000000005b0000000067ffffffffec;
    exp_shifted[15][15] = 160'hffffffffff00000000010000000001ffffffffff;
    exp_stage16[15][15] = 64'hffff00010001ffff;
    exp_final10[15][15] = 40'hffc01007ff;
    case_input[16] = 1024'h0001000000000000000000000000000000000000000000000000000000000000000000000000000000000000000000000000000000000000000000000000000000000000000000000000000000000000000000000000000000000000000000000000000000000000000000000000000000000000000000000000000000000000;
    exp_raw[16][0] = 160'hfffffffff1000000000bfffffffff90000000002;
    exp_biased[16][0] = 160'h0000000011000000002b00000000190000000022;
    exp_shifted[16][0] = 160'h0000000000000000000000000000000000000000;
    exp_stage16[16][0] = 64'h0000000000000000;
    exp_final10[16][0] = 40'h0000000000;
    exp_raw[16][1] = 160'hffffffffdf000000001cffffffffe80000000014;
    exp_biased[16][1] = 160'hffffffffff000000003c00000000080000000034;
    exp_shifted[16][1] = 160'hffffffffff000000000000000000000000000000;
    exp_stage16[16][1] = 64'hffff000000000000;
    exp_final10[16][1] = 40'hffc0000000;
    exp_raw[16][2] = 160'hffffffffd0000000002cffffffffd70000000025;
    exp_biased[16][2] = 160'hfffffffff0000000004cfffffffff70000000045;
    exp_shifted[16][2] = 160'hffffffffff0000000001ffffffffff0000000001;
    exp_stage16[16][2] = 64'hffff0001ffff0001;
    exp_final10[16][2] = 40'hffc01ffc01;
    exp_raw[16][3] = 160'hffffffffc2000000003bffffffffc80000000034;
    exp_biased[16][3] = 160'hffffffffe2000000005bffffffffe80000000054;
    exp_shifted[16][3] = 160'hffffffffff0000000001ffffffffff0000000001;
    exp_stage16[16][3] = 64'hffff0001ffff0001;
    exp_final10[16][3] = 40'hffc01ffc01;
    exp_raw[16][4] = 160'hffffffffb70000000047ffffffffbb0000000041;
    exp_biased[16][4] = 160'hffffffffd70000000067ffffffffdb0000000061;
    exp_shifted[16][4] = 160'hffffffffff0000000001ffffffffff0000000001;
    exp_stage16[16][4] = 64'hffff0001ffff0001;
    exp_final10[16][4] = 40'hffc01ffc01;
    exp_raw[16][5] = 160'hffffffffad0000000051ffffffffb1000000004d;
    exp_biased[16][5] = 160'hffffffffcd0000000071ffffffffd1000000006d;
    exp_shifted[16][5] = 160'hffffffffff0000000001ffffffffff0000000001;
    exp_stage16[16][5] = 64'hffff0001ffff0001;
    exp_final10[16][5] = 40'hffc01ffc01;
    exp_raw[16][6] = 160'hffffffffa80000000057ffffffffaa0000000054;
    exp_biased[16][6] = 160'hffffffffc80000000077ffffffffca0000000074;
    exp_shifted[16][6] = 160'hffffffffff0000000001ffffffffff0000000001;
    exp_stage16[16][6] = 64'hffff0001ffff0001;
    exp_final10[16][6] = 40'hffc01ffc01;
    exp_raw[16][7] = 160'hffffffffa5000000005affffffffa6000000005a;
    exp_biased[16][7] = 160'hffffffffc5000000007affffffffc6000000007a;
    exp_shifted[16][7] = 160'hffffffffff0000000001ffffffffff0000000001;
    exp_stage16[16][7] = 64'hffff0001ffff0001;
    exp_final10[16][7] = 40'hffc01ffc01;
    exp_raw[16][8] = 160'hffffffffa6000000005affffffffa6000000005b;
    exp_biased[16][8] = 160'hffffffffc6000000007affffffffc6000000007b;
    exp_shifted[16][8] = 160'hffffffffff0000000001ffffffffff0000000001;
    exp_stage16[16][8] = 64'hffff0001ffff0001;
    exp_final10[16][8] = 40'hffc01ffc01;
    exp_raw[16][9] = 160'hffffffffac0000000056ffffffffa90000000058;
    exp_biased[16][9] = 160'hffffffffcc0000000076ffffffffc90000000078;
    exp_shifted[16][9] = 160'hffffffffff0000000001ffffffffff0000000001;
    exp_stage16[16][9] = 64'hffff0001ffff0001;
    exp_final10[16][9] = 40'hffc01ffc01;
    exp_raw[16][10] = 160'hffffffffb3000000004fffffffffaf0000000053;
    exp_biased[16][10] = 160'hffffffffd3000000006fffffffffcf0000000073;
    exp_shifted[16][10] = 160'hffffffffff0000000001ffffffffff0000000001;
    exp_stage16[16][10] = 64'hffff0001ffff0001;
    exp_final10[16][10] = 40'hffc01ffc01;
    exp_raw[16][11] = 160'hffffffffbf0000000045ffffffffb90000000049;
    exp_biased[16][11] = 160'hffffffffdf0000000065ffffffffd90000000069;
    exp_shifted[16][11] = 160'hffffffffff0000000001ffffffffff0000000001;
    exp_stage16[16][11] = 64'hffff0001ffff0001;
    exp_final10[16][11] = 40'hffc01ffc01;
    exp_raw[16][12] = 160'hffffffffcc0000000038ffffffffc5000000003e;
    exp_biased[16][12] = 160'hffffffffec0000000058ffffffffe5000000005e;
    exp_shifted[16][12] = 160'hffffffffff0000000001ffffffffff0000000001;
    exp_stage16[16][12] = 64'hffff0001ffff0001;
    exp_final10[16][12] = 40'hffc01ffc01;
    exp_raw[16][13] = 160'hffffffffdb0000000029ffffffffd40000000030;
    exp_biased[16][13] = 160'hfffffffffb0000000049fffffffff40000000050;
    exp_shifted[16][13] = 160'hffffffffff0000000001ffffffffff0000000001;
    exp_stage16[16][13] = 64'hffff0001ffff0001;
    exp_final10[16][13] = 40'hffc01ffc01;
    exp_raw[16][14] = 160'hffffffffec0000000018ffffffffe40000000021;
    exp_biased[16][14] = 160'h000000000c000000003800000000040000000041;
    exp_shifted[16][14] = 160'h0000000000000000000000000000000000000001;
    exp_stage16[16][14] = 64'h0000000000000001;
    exp_final10[16][14] = 40'h0000000001;
    exp_raw[16][15] = 160'hfffffffffe0000000007fffffffff5000000000f;
    exp_biased[16][15] = 160'h000000001e00000000270000000015000000002f;
    exp_shifted[16][15] = 160'h0000000000000000000000000000000000000000;
    exp_stage16[16][15] = 64'h0000000000000000;
    exp_final10[16][15] = 40'h0000000000;
    case_input[17] = 1024'hbeb14ff0fc721353e5b036d160175d95eed8db4a2e0b9fd76d7b24bb2d730d536a2fb1a8c2070d628ee300874ff05ef1c3fbdbfc5d33991c3eaf865f61334524be80ade40886731e02aedb698e05085651fde4219b617b311d2c3822ad57c40b9d7c0cd4f2ae081273863af10a918433c39b7a24fe18ff0d0fdf4b72e5eebd05;
    exp_raw[17][0] = 160'hffffb8e9ef000082c6bbffffd0e5b500001592eb;
    exp_biased[17][0] = 160'hffffb8ea0f000082c6dbffffd0e5d5000015930b;
    exp_shifted[17][0] = 160'hfffffee3a80000020b1bffffff4397000000564c;
    exp_stage16[17][0] = 64'he3a80b1b4397564c;
    exp_final10[17][0] = 40'hea31be5e4c;
    exp_raw[17][1] = 160'hffffe92a16000006bd72ffffbdc1a2000065b50b;
    exp_biased[17][1] = 160'hffffe92a36000006bd92ffffbdc1c2000065b52b;
    exp_shifted[17][1] = 160'hffffffa4a80000001af6fffffef70700000196d4;
    exp_stage16[17][1] = 64'ha4a81af6f70796d4;
    exp_final10[17][1] = 40'h2a2f6c1ed4;
    exp_raw[17][2] = 160'hffffed3aca00002fb3f3ffffcfa81cffffb90cc3;
    exp_biased[17][2] = 160'hffffed3aea00002fb413ffffcfa83cffffb90ce3;
    exp_shifted[17][2] = 160'hffffffb4eb000000bed0ffffff3ea0fffffee433;
    exp_stage16[17][2] = 64'hb4ebbed03ea0e433;
    exp_final10[17][2] = 40'h3aed0a8033;
    exp_raw[17][3] = 160'hffffe86f61ffff08324e0000a7483800008b932d;
    exp_biased[17][3] = 160'hffffe86f81ffff08326e0000a7485800008b934d;
    exp_shifted[17][3] = 160'hffffffa1befffffc20c90000029d210000022e4d;
    exp_stage16[17][3] = 64'ha1be20c99d212e4d;
    exp_final10[17][3] = 40'h6f8c94864d;
    exp_raw[17][4] = 160'hffffde6d6f00003e8e4afffeee60b2fffef093eb;
    exp_biased[17][4] = 160'hffffde6d8f00003e8e6afffeee60d2fffef0940b;
    exp_shifted[17][4] = 160'hffffff79b6000000fa39fffffbb983fffffbc250;
    exp_stage16[17][4] = 64'h79b6fa39b983c250;
    exp_final10[17][4] = 40'h6da3960e50;
    exp_raw[17][5] = 160'h0000069ffc0000c6b2c6fffffbb0e500000fe662;
    exp_biased[17][5] = 160'h000006a01c0000c6b2e6fffffbb10500000fe682;
    exp_shifted[17][5] = 160'h0000001a800000031acbffffffeec40000003f9a;
    exp_stage16[17][5] = 64'h1a801acbeec43f9a;
    exp_final10[17][5] = 40'ha02cbb139a;
    exp_raw[17][6] = 160'h00012a148affffffd059ffff9837b6000004b1bf;
    exp_biased[17][6] = 160'h00012a14aaffffffd079ffff9837d6000004b1df;
    exp_shifted[17][6] = 160'h000004a852ffffffff41fffffe60df00000012c7;
    exp_stage16[17][6] = 64'ha852ff4160df12c7;
    exp_final10[17][6] = 40'h14b4137ec7;
    exp_raw[17][7] = 160'h000032f2c0fffe775d6cfffeb3505afffffe444b;
    exp_biased[17][7] = 160'h000032f2e0fffe775d8cfffeb3507afffffe446b;
    exp_shifted[17][7] = 160'h000000cbcbfffff9dd76fffffacd41fffffff911;
    exp_stage16[17][7] = 64'hcbcbdd76cd41f911;
    exp_final10[17][7] = 40'hf2d7650511;
    exp_raw[17][8] = 160'h00000f90fdffff8b1e78ffff752b3affffa88d08;
    exp_biased[17][8] = 160'h00000f911dffff8b1e98ffff752b5affffa88d28;
    exp_shifted[17][8] = 160'h0000003e44fffffe2c7afffffdd4adfffffea234;
    exp_stage16[17][8] = 64'h3e442c7ad4ada234;
    exp_final10[17][8] = 40'h9107a2b634;
    exp_raw[17][9] = 160'hffffc99c250000612f960000592d6fffff3943ce;
    exp_biased[17][9] = 160'hffffc99c450000612fb60000592d8fffff3943ee;
    exp_shifted[17][9] = 160'hffffff267100000184be00000164b6fffffce50f;
    exp_stage16[17][9] = 64'h267184be64b6e50f;
    exp_final10[17][9] = 40'h9c4be2d90f;
    exp_raw[17][10] = 160'h0000f61bc8ffff463221ffff9cbc0800009fadb8;
    exp_biased[17][10] = 160'h0000f61be8ffff463241ffff9cbc2800009fadd8;
    exp_shifted[17][10] = 160'h000003d86ffffffd18c9fffffe72f00000027eb7;
    exp_stage16[17][10] = 64'hd86f18c972f07eb7;
    exp_final10[17][10] = 40'h1bcc9bc2b7;
    exp_raw[17][11] = 160'h000021b25dffffb21a1e00006283fe000029097b;
    exp_biased[17][11] = 160'h000021b27dffffb21a3e000062841e000029099b;
    exp_shifted[17][11] = 160'h00000086c9fffffec8680000018a10000000a426;
    exp_stage16[17][11] = 64'h86c9c8688a10a426;
    exp_final10[17][11] = 40'hb246884026;
    exp_raw[17][12] = 160'h00003b619dffffe7ffbcffffa2566affffd73eef;
    exp_biased[17][12] = 160'h00003b61bdffffe7ffdcffffa2568affffd73f0f;
    exp_shifted[17][12] = 160'h000000ed86ffffff9ffffffffe895affffff5cfc;
    exp_stage16[17][12] = 64'hed869fff895a5cfc;
    exp_final10[17][12] = 40'h61bff568fc;
    exp_raw[17][13] = 160'h0000d0a4ed00003189deffff19b673ffff59c284;
    exp_biased[17][13] = 160'h0000d0a50d00003189feffff19b693ffff59c2a4;
    exp_shifted[17][13] = 160'h0000034294000000c627fffffc66dafffffd670a;
    exp_stage16[17][13] = 64'h4294c62766da670a;
    exp_final10[17][13] = 40'ha5227b6b0a;
    exp_raw[17][14] = 160'hfffff3367d00007b9aca0000e61982ffff0c20c2;
    exp_biased[17][14] = 160'hfffff3369d00007b9aea0000e619a2ffff0c20e2;
    exp_shifted[17][14] = 160'hffffffccda000001ee6b0000039866fffffc3083;
    exp_stage16[17][14] = 64'hccdaee6b98663083;
    exp_final10[17][14] = 40'h36a6b19883;
    exp_raw[17][15] = 160'h000038f8650000c02d45ffff9c5267ffff8341ed;
    exp_biased[17][15] = 160'h000038f8850000c02d65ffff9c5287ffff83420d;
    exp_shifted[17][15] = 160'h000000e3e200000300b5fffffe714afffffe0d08;
    exp_stage16[17][15] = 64'he3e200b5714a0d08;
    exp_final10[17][15] = 40'hf88b552908;
    case_input[18] = 1024'hff488e6bc6b34307544a2a114b90377dd89b86b8756e3d3596d02350e78c32063d0c920eec537d6c115c80037c7fbf04d7b538d4cdddf8381686c13c84a039bb4a39baf8f801f53489eadf0956919a6fa9c2d4bc6c65aace609425f9df9a368c7dd719b190106267722dc49dd858c79dc68aec0d8ea1689f46ef14dfc3bea554;
    exp_raw[18][0] = 160'hffff444cba000054be8f00000c7cedffffbef22b;
    exp_biased[18][0] = 160'hffff444cda000054beaf00000c7d0dffffbef24b;
    exp_shifted[18][0] = 160'hfffffd113300000152fa00000031f4fffffefbc9;
    exp_stage16[18][0] = 64'h113352fa31f4fbc9;
    exp_final10[18][0] = 40'h4cefa7d3c9;
    exp_raw[18][1] = 160'h00005e72590000663dc1ffff9ebae2ffff80b3be;
    exp_biased[18][1] = 160'h00005e72790000663de1ffff9ebb02ffff80b3de;
    exp_shifted[18][1] = 160'h00000179c900000198f7fffffe7aecfffffe02cf;
    exp_stage16[18][1] = 64'h79c998f77aec02cf;
    exp_final10[18][1] = 40'h724f7bb2cf;
    exp_raw[18][2] = 160'h00001182a5ffffb79dcb00002cdae60000a6fe45;
    exp_biased[18][2] = 160'h00001182c5ffffb79deb00002cdb060000a6fe65;
    exp_shifted[18][2] = 160'h000000460bfffffede77000000b36c0000029bf9;
    exp_stage16[18][2] = 64'h460bde77b36c9bf9;
    exp_final10[18][2] = 40'h82e77db3f9;
    exp_raw[18][3] = 160'hffffeff82dffff35ace000003968fcffffc4ed79;
    exp_biased[18][3] = 160'hffffeff84dffff35ad00000039691cffffc4ed99;
    exp_shifted[18][3] = 160'hffffffbfe1fffffcd6b4000000e5a4ffffff13b6;
    exp_stage16[18][3] = 64'hbfe1d6b4e5a413b6;
    exp_final10[18][3] = 40'hf86b4693b6;
    exp_raw[18][4] = 160'hffffd6b7b9fffecc27e700000546bfffff11cd0e;
    exp_biased[18][4] = 160'hffffd6b7d9fffecc280700000546dfffff11cd2e;
    exp_shifted[18][4] = 160'hffffff5adffffffb30a0000000151bfffffc4734;
    exp_stage16[18][4] = 64'h5adf30a0151b4734;
    exp_final10[18][4] = 40'hb7ca046f34;
    exp_raw[18][5] = 160'hffffd0c8e8ffff18b8adffffef6655ffffb106aa;
    exp_biased[18][5] = 160'hffffd0c908ffff18b8cdffffef6675ffffb106ca;
    exp_shifted[18][5] = 160'hffffff4324fffffc62e3ffffffbd99fffffec41b;
    exp_stage16[18][5] = 64'h432462e3bd99c41b;
    exp_final10[18][5] = 40'hc92e36641b;
    exp_raw[18][6] = 160'hfffeed8b60000007157dfffffaf1fa000090c426;
    exp_biased[18][6] = 160'hfffeed8b80000007159dfffffaf21a000090c446;
    exp_shifted[18][6] = 160'hfffffbb62e0000001c56ffffffebc80000024311;
    exp_stage16[18][6] = 64'hb62e1c56ebc84311;
    exp_final10[18][6] = 40'h8b856f2311;
    exp_raw[18][7] = 160'h000082e57afffef0350e0000258209ffff520345;
    exp_biased[18][7] = 160'h000082e59afffef0352e0000258229ffff520365;
    exp_shifted[18][7] = 160'h0000020b96fffffbc0d40000009608fffffd480d;
    exp_stage16[18][7] = 64'h0b96c0d49608480d;
    exp_final10[18][7] = 40'he58d48200d;
    exp_raw[18][8] = 160'h00005e58f1000129c37bffffc7ef6c000062a31e;
    exp_biased[18][8] = 160'h00005e5911000129c39bffffc7ef8c000062a33e;
    exp_shifted[18][8] = 160'h0000017964000004a70effffff1fbe0000018a8c;
    exp_stage16[18][8] = 64'h7964a70e1fbe8a8c;
    exp_final10[18][8] = 40'h5930eefa8c;
    exp_raw[18][9] = 160'hfffebe6448ffff0941c2ffff69a99f0000fc8bc0;
    exp_biased[18][9] = 160'hfffebe6468ffff0941e2ffff69a9bf0000fc8be0;
    exp_shifted[18][9] = 160'hfffffaf991fffffc2507fffffda6a6000003f22f;
    exp_stage16[18][9] = 64'hf9912507a6a6f22f;
    exp_final10[18][9] = 40'h64507a9a2f;
    exp_raw[18][10] = 160'h00010985f6ffff314cc7000098978700017abddc;
    exp_biased[18][10] = 160'h0001098616ffff314ce700009897a700017abdfc;
    exp_shifted[18][10] = 160'h0000042618fffffcc533000002625e000005eaf7;
    exp_stage16[18][10] = 64'h2618c533625eeaf7;
    exp_final10[18][10] = 40'h8613397af7;
    exp_raw[18][11] = 160'hffff62bac400008588afffff7b85910000143595;
    exp_biased[18][11] = 160'hffff62bae400008588cfffff7b85b100001435b5;
    exp_shifted[18][11] = 160'hfffffd8aeb0000021623fffffdee1600000050d6;
    exp_stage16[18][11] = 64'h8aeb1623ee1650d6;
    exp_final10[18][11] = 40'hbae23858d6;
    exp_raw[18][12] = 160'hffff320b25ffffaa50b4ffffb511e2ffffe39485;
    exp_biased[18][12] = 160'hffff320b45ffffaa50d4ffffb51202ffffe394a5;
    exp_shifted[18][12] = 160'hfffffcc82dfffffea943fffffed448ffffff8e52;
    exp_stage16[18][12] = 64'hc82da943d4488e52;
    exp_final10[18][12] = 40'h0b54312252;
    exp_raw[18][13] = 160'h00002fb58bffffddca0e00007122c1ffff4ca467;
    exp_biased[18][13] = 160'h00002fb5abffffddca2e00007122e1ffff4ca487;
    exp_shifted[18][13] = 160'h000000bed6ffffff7728000001c48bfffffd3292;
    exp_stage16[18][13] = 64'hbed67728c48b3292;
    exp_final10[18][13] = 40'hb5b2822e92;
    exp_raw[18][14] = 160'h00002884feffffa2c69affff5966330000853d25;
    exp_biased[18][14] = 160'h000028851effffa2c6baffff5966530000853d45;
    exp_shifted[18][14] = 160'h000000a214fffffe8b1afffffd659900000214f5;
    exp_stage16[18][14] = 64'ha2148b1a659914f5;
    exp_final10[18][14] = 40'h8531a664f5;
    exp_raw[18][15] = 160'hffffc61df900006ba37100006c08a500006e25dc;
    exp_biased[18][15] = 160'hffffc61e1900006ba39100006c08c500006e25fc;
    exp_shifted[18][15] = 160'hffffff1878000001ae8e000001b023000001b897;
    exp_stage16[18][15] = 64'h1878ae8eb023b897;
    exp_final10[18][15] = 40'h1e28e08c97;
    case_input[19] = 1024'h0e9d8d1e2671076ffca3e8051829bd5db458519a7520211a0a6b85f3a7918f8445e0a80baedad7d3015299dda66a5078224f59eee04299d2aa1536de3d376f42c8395729a83ac980881d17a8ca1741bd50929fe940b04202561ddd934eb376f66816d0577b415fe2b7c655f0c45a3208a88abea989505ae191dc476601cabc73;
    exp_raw[19][0] = 160'hffff316f78ffff1527a20000a25ff4000017dd2f;
    exp_biased[19][0] = 160'hffff316f98ffff1527c20000a26014000017dd4f;
    exp_shifted[19][0] = 160'hfffffcc5befffffc549f00000289800000005f75;
    exp_stage16[19][0] = 64'hc5be549f89805f75;
    exp_final10[19][0] = 40'h6f89f60375;
    exp_raw[19][1] = 160'h00010a6ee4000080b094ffff26d7c8ffff8747ad;
    exp_biased[19][1] = 160'h00010a6f04000080b0b4ffff26d7e8ffff8747cd;
    exp_shifted[19][1] = 160'h00000429bc00000202c2fffffc9b5ffffffe1d1f;
    exp_stage16[19][1] = 64'h29bc02c29b5f1d1f;
    exp_final10[19][1] = 40'h6f2c2d7d1f;
    exp_raw[19][2] = 160'h000071a5bcffffd6d25700008bd5cdffffeb2c0b;
    exp_biased[19][2] = 160'h000071a5dcffffd6d27700008bd5edffffeb2c2b;
    exp_shifted[19][2] = 160'h000001c697ffffff5b490000022f57ffffffacb0;
    exp_stage16[19][2] = 64'hc6975b492f57acb0;
    exp_final10[19][2] = 40'ha5f49d5cb0;
    exp_raw[19][3] = 160'hfffff48156ffffbb38a9ffff85d3ce00009c2762;
    exp_biased[19][3] = 160'hfffff48176ffffbb38c9ffff85d3ee00009c2782;
    exp_shifted[19][3] = 160'hffffffd205fffffeece3fffffe174f000002709e;
    exp_stage16[19][3] = 64'hd205ece3174f709e;
    exp_final10[19][3] = 40'h814e3d3c9e;
    exp_raw[19][4] = 160'h00010cd262fffeaa5a9affff9feb4d0000e72224;
    exp_biased[19][4] = 160'h00010cd282fffeaa5abaffff9feb6d0000e72244;
    exp_shifted[19][4] = 160'h000004334afffffaa96afffffe7fad0000039c89;
    exp_stage16[19][4] = 64'h334aa96a7fad9c89;
    exp_final10[19][4] = 40'hd296aeb489;
    exp_raw[19][5] = 160'hfffff5e20affff9b903cffffc3cd3affff776657;
    exp_biased[19][5] = 160'hfffff5e22affff9b905cffffc3cd5affff776677;
    exp_shifted[19][5] = 160'hffffffd788fffffe6e41ffffff0f35fffffddd99;
    exp_stage16[19][5] = 64'hd7886e410f35dd99;
    exp_final10[19][5] = 40'he2241cd599;
    exp_raw[19][6] = 160'hffffc72adf0000bc103affff6d011affffd6e6c6;
    exp_biased[19][6] = 160'hffffc72aff0000bc105affff6d013affffd6e6e6;
    exp_shifted[19][6] = 160'hffffff1cab000002f041fffffdb404ffffff5b9b;
    exp_stage16[19][6] = 64'h1cabf041b4045b9b;
    exp_final10[19][6] = 40'h2ac410139b;
    exp_raw[19][7] = 160'h000085c19d0000398feb00005ad42dffff082709;
    exp_biased[19][7] = 160'h000085c1bd000039900b00005ad44dffff082729;
    exp_shifted[19][7] = 160'h0000021706000000e6400000016b51fffffc209c;
    exp_stage16[19][7] = 64'h1706e6406b51209c;
    exp_final10[19][7] = 40'hc1a40d449c;
    exp_raw[19][8] = 160'hffffb34fc7ffff7ebdef00003f387500007f91b9;
    exp_biased[19][8] = 160'hffffb34fe7ffff7ebe0f00003f389500007f91d9;
    exp_shifted[19][8] = 160'hfffffecd3ffffffdfaf8000000fce2000001fe47;
    exp_stage16[19][8] = 64'hcd3ffaf8fce2fe47;
    exp_final10[19][8] = 40'h4fef838a47;
    exp_raw[19][9] = 160'hffff98bc200001001de4ffffbe0184fffef7afd3;
    exp_biased[19][9] = 160'hffff98bc400001001e04ffffbe01a4fffef7aff3;
    exp_shifted[19][9] = 160'hfffffe62f10000040078fffffef806fffffbdebf;
    exp_stage16[19][9] = 64'h62f10078f806debf;
    exp_final10[19][9] = 40'hbc47801abf;
    exp_raw[19][10] = 160'hffff9e941bffffc338bcffff7e29bc00003bab2c;
    exp_biased[19][10] = 160'hffff9e943bffffc338dcffff7e29dc00003bab4c;
    exp_shifted[19][10] = 160'hfffffe7a50ffffff0ce3fffffdf8a7000000eead;
    exp_stage16[19][10] = 64'h7a500ce3f8a7eead;
    exp_final10[19][10] = 40'h940e329ead;
    exp_raw[19][11] = 160'hffffacd776ffff307cfdfffedcf9f6ffffcb0ea2;
    exp_biased[19][11] = 160'hffffacd796ffff307d1dfffedcfa16ffffcb0ec2;
    exp_shifted[19][11] = 160'hfffffeb35efffffcc1f4fffffb73e8ffffff2c3b;
    exp_stage16[19][11] = 64'hb35ec1f473e82c3b;
    exp_final10[19][11] = 40'hd79f4fa03b;
    exp_raw[19][12] = 160'h000000254e000046cdbafffff2b58500000bf32c;
    exp_biased[19][12] = 160'h000000256e000046cddafffff2b5a500000bf34c;
    exp_shifted[19][12] = 160'h00000000950000011b37ffffffcad60000002fcd;
    exp_stage16[19][12] = 64'h00951b37cad62fcd;
    exp_final10[19][12] = 40'h25737b5bcd;
    exp_raw[19][13] = 160'hffff82089f00009239b7ffff504bffffffdd6206;
    exp_biased[19][13] = 160'hffff8208bf00009239d7ffff504c1fffffdd6226;
    exp_shifted[19][13] = 160'hfffffe082200000248e7fffffd4130ffffff7588;
    exp_stage16[19][13] = 64'h082248e741307588;
    exp_final10[19][13] = 40'h088e74c188;
    exp_raw[19][14] = 160'h0000cae715ffff79517effff45c5f2ffff771fde;
    exp_biased[19][14] = 160'h0000cae735ffff79519effff45c612ffff771ffe;
    exp_shifted[19][14] = 160'h0000032b9cfffffde546fffffd1718fffffddc7f;
    exp_stage16[19][14] = 64'h2b9ce5461718dc7f;
    exp_final10[19][14] = 40'he7146c607f;
    exp_raw[19][15] = 160'h0000d946f700008312f4ffffd6881a00016baf3c;
    exp_biased[19][15] = 160'h0000d947170000831314ffffd6883a00016baf5c;
    exp_shifted[19][15] = 160'h000003651c0000020c4cffffff5a20000005aebd;
    exp_stage16[19][15] = 64'h651c0c4c5a20aebd;
    exp_final10[19][15] = 40'h4704c882bd;
    case_input[20] = 1024'hf27ef993ee3800d42a059c19e540a908023ccca28a08515f231ed398826cfaee5a5fc492bd3343d6c5b60c9d900b4daf74831a5fbf914ed418de90d2e0c9a187d0c24dd0480edb42ef5357865e5e67c9013cea36df62cf1d079c461e73da068f8e2ea616ba1990801a523e4fe884490047f624b03c111273f3adf2ac6f53ce68;
    exp_raw[20][0] = 160'h0000aa9c1fffff8fb8de00008eef1100004217bd;
    exp_biased[20][0] = 160'h0000aa9c3fffff8fb8fe00008eef3100004217dd;
    exp_shifted[20][0] = 160'h000002aa70fffffe3ee30000023bbc000001085f;
    exp_stage16[20][0] = 64'haa703ee33bbc085f;
    exp_final10[20][0] = 40'h9c2e3ef05f;
    exp_raw[20][1] = 160'hffff5c114f000033cb6c0000cdc574000037c348;
    exp_biased[20][1] = 160'hffff5c116f000033cb8c0000cdc594000037c368;
    exp_shifted[20][1] = 160'hfffffd7045000000cf2e0000033716000000df0d;
    exp_stage16[20][1] = 64'h7045cf2e3716df0d;
    exp_final10[20][1] = 40'h1172ec5b0d;
    exp_raw[20][2] = 160'hfffee21c23fffff82941ffffe8b5e4ffff38adde;
    exp_biased[20][2] = 160'hfffee21c43fffff82961ffffe8b604ffff38adfe;
    exp_shifted[20][2] = 160'hfffffb8871ffffffe0a5ffffffa2d8fffffce2b7;
    exp_stage16[20][2] = 64'h8871e0a5a2d8e2b7;
    exp_final10[20][2] = 40'h1c4a5b62b7;
    exp_raw[20][3] = 160'h0000613f5a0000e1a16f00009f29b6ffffd3bb05;
    exp_biased[20][3] = 160'h0000613f7a0000e1a18f00009f29d6ffffd3bb25;
    exp_shifted[20][3] = 160'h00000184fd00000386860000027ca7ffffff4eec;
    exp_stage16[20][3] = 64'h84fd86867ca74eec;
    exp_final10[20][3] = 40'h3f68629eec;
    exp_raw[20][4] = 160'hffffdc091dfffed904c3fffff0302300007f85f8;
    exp_biased[20][4] = 160'hffffdc093dfffed904e3fffff0304300007f8618;
    exp_shifted[20][4] = 160'hffffff7024fffffb6413ffffffc0c1000001fe18;
    exp_stage16[20][4] = 64'h70246413c0c1fe18;
    exp_final10[20][4] = 40'h0901330618;
    exp_raw[20][5] = 160'hffffb0b75f0000a1b0710000d5f6ec00002cd481;
    exp_biased[20][5] = 160'hffffb0b77f0000a1b0910000d5f70c00002cd4a1;
    exp_shifted[20][5] = 160'hfffffec2dd00000286c200000357dc000000b352;
    exp_stage16[20][5] = 64'hc2dd86c257dcb352;
    exp_final10[20][5] = 40'hb76c2f7352;
    exp_raw[20][6] = 160'hffffc1fd8d00000c858800007253c6ffffd4d877;
    exp_biased[20][6] = 160'hffffc1fdad00000c85a800007253e6ffffd4d897;
    exp_shifted[20][6] = 160'hffffff07f60000003216000001c94fffffff5362;
    exp_stage16[20][6] = 64'h07f63216c94f5362;
    exp_final10[20][6] = 40'hfda1653f62;
    exp_raw[20][7] = 160'hffff3b795a000016854c0000f8ac79ffff441551;
    exp_biased[20][7] = 160'hffff3b797a000016856c0000f8ac99ffff441571;
    exp_shifted[20][7] = 160'hfffffcede50000005a15000003e2b2fffffd1055;
    exp_stage16[20][7] = 64'hede55a15e2b21055;
    exp_final10[20][7] = 40'h79615ac855;
    exp_raw[20][8] = 160'h0000c25bc9000008099dfffede7a500000b4722a;
    exp_biased[20][8] = 160'h0000c25be900000809bdfffede7a700000b4724a;
    exp_shifted[20][8] = 160'h000003096f0000002026fffffb79e9000002d1c9;
    exp_stage16[20][8] = 64'h096f202679e9d1c9;
    exp_final10[20][8] = 40'h5bc267a5c9;
    exp_raw[20][9] = 160'h00004b463100001d6fc000000b72fcffffd88cc9;
    exp_biased[20][9] = 160'h00004b465100001d6fe000000b731cffffd88ce9;
    exp_shifted[20][9] = 160'h0000012d1900000075bf0000002dccffffff6233;
    exp_stage16[20][9] = 64'h2d1975bf2dcc6233;
    exp_final10[20][9] = 40'h465bf73233;
    exp_raw[20][10] = 160'hffffec7095ffffea354cfffeed64ebffff8cd119;
    exp_biased[20][10] = 160'hffffec70b5ffffea356cfffeed650bffff8cd139;
    exp_shifted[20][10] = 160'hffffffb1c2ffffffa8d5fffffbb594fffffe3344;
    exp_stage16[20][10] = 64'hb1c2a8d5b5943344;
    exp_final10[20][10] = 40'h708d565344;
    exp_raw[20][11] = 160'h0000031e4c00005666e7ffffb22dcfffff3e5d05;
    exp_biased[20][11] = 160'h0000031e6c0000566707ffffb22defffff3e5d25;
    exp_shifted[20][11] = 160'h0000000c79000001599cfffffec8b7fffffcf974;
    exp_stage16[20][11] = 64'h0c79599cc8b7f974;
    exp_final10[20][11] = 40'h1e59c2dd74;
    exp_raw[20][12] = 160'h0000544ba5ffff517be4000072dcc3ffffe44d8e;
    exp_biased[20][12] = 160'h0000544bc5ffff517c04000072dce3ffffe44dae;
    exp_shifted[20][12] = 160'h000001512ffffffd45f0000001cb73ffffff9136;
    exp_stage16[20][12] = 64'h512f45f0cb739136;
    exp_final10[20][12] = 40'h4bdf0dcd36;
    exp_raw[20][13] = 160'hffff5f1b3600004d945cffffb8e58fffff8bf6a3;
    exp_biased[20][13] = 160'hffff5f1b5600004d947cffffb8e5afffff8bf6c3;
    exp_shifted[20][13] = 160'hfffffd7c6d0000013651fffffee396fffffe2fdb;
    exp_stage16[20][13] = 64'h7c6d3651e3962fdb;
    exp_final10[20][13] = 40'h1b651e5bdb;
    exp_raw[20][14] = 160'hffff4c100600003cfb48ffffc4cf4affff92ee1d;
    exp_biased[20][14] = 160'hffff4c102600003cfb68ffffc4cf6affff92ee3d;
    exp_shifted[20][14] = 160'hfffffd3040000000f3edffffff133dfffffe4bb8;
    exp_stage16[20][14] = 64'h3040f3ed133d4bb8;
    exp_final10[20][14] = 40'h103edcf7b8;
    exp_raw[20][15] = 160'hfffff7b543ffff6fd15fffffea397800000fef2b;
    exp_biased[20][15] = 160'hfffff7b563ffff6fd17fffffea399800000fef4b;
    exp_shifted[20][15] = 160'hffffffded5fffffdbf45ffffffa8e60000003fbd;
    exp_stage16[20][15] = 64'hded5bf45a8e63fbd;
    exp_final10[20][15] = 40'hb574539bbd;
    case_input[21] = 1024'hcc0fb69106bcdd821853a593e516e81ea2d016dc4e84a3866a8b22cd082abe8eb36623bdd1fcbd01614d07da53ceda5189a92b0f8c268b9ed8a8fd2856a366d5c67d8f22c1bd9a9414525628c3a88da6721e81e06d1a280ced992590e41786025179158b346c1afbd309b7e8c0fa96e786ba3cff7700e897e2f72d14658e267d;
    exp_raw[21][0] = 160'h0000137028000029c36f00009bba59ffff88e152;
    exp_biased[21][0] = 160'h0000137048000029c38f00009bba79ffff88e172;
    exp_shifted[21][0] = 160'h0000004dc1000000a70e0000026ee9fffffe2385;
    exp_stage16[21][0] = 64'h4dc1a70e6ee92385;
    exp_final10[21][0] = 40'h7070eba785;
    exp_raw[21][1] = 160'h0000e64563000054dd410000e57796ffffe9f5ed;
    exp_biased[21][1] = 160'h0000e64583000054dd610000e577b6ffffe9f60d;
    exp_shifted[21][1] = 160'h0000039916000001537500000395deffffffa7d8;
    exp_stage16[21][1] = 64'h9916537595dea7d8;
    exp_final10[21][1] = 40'h45b7577bd8;
    exp_raw[21][2] = 160'h000072fb33ffffd4ddd8000070e77200004fe5cd;
    exp_biased[21][2] = 160'h000072fb53ffffd4ddf8000070e79200004fe5ed;
    exp_shifted[21][2] = 160'h000001cbedffffff5377000001c39e0000013f97;
    exp_stage16[21][2] = 64'hcbed5377c39e3f97;
    exp_final10[21][2] = 40'hfb777e7b97;
    exp_raw[21][3] = 160'h00005bcb90ffff895a17fffeb2670800008bb8d4;
    exp_biased[21][3] = 160'h00005bcbb0ffff895a37fffeb2672800008bb8f4;
    exp_shifted[21][3] = 160'h0000016f2efffffe2568fffffac99c0000022ee3;
    exp_stage16[21][3] = 64'h6f2e2568c99c2ee3;
    exp_final10[21][3] = 40'hcb968672e3;
    exp_raw[21][4] = 160'h000161e3a80000742d5affffaae24fffff0fee2b;
    exp_biased[21][4] = 160'h000161e3c80000742d7affffaae26fffff0fee4b;
    exp_shifted[21][4] = 160'h000005878f000001d0b5fffffeab89fffffc3fb9;
    exp_stage16[21][4] = 64'h878fd0b5ab893fb9;
    exp_final10[21][4] = 40'he3cb5e27b9;
    exp_raw[21][5] = 160'h0000ecfddeffffcd48c5ffffd2877b0000607b5c;
    exp_biased[21][5] = 160'h0000ecfdfeffffcd48e5ffffd2879b0000607b7c;
    exp_shifted[21][5] = 160'h000003b3f7ffffff3523ffffff4a1e00000181ed;
    exp_stage16[21][5] = 64'hb3f735234a1e81ed;
    exp_final10[21][5] = 40'hfdd23879ed;
    exp_raw[21][6] = 160'h0000ee814dffffeee38c00001c2d8400006bef44;
    exp_biased[21][6] = 160'h0000ee816dffffeee3ac00001c2da400006bef64;
    exp_shifted[21][6] = 160'h000003ba05ffffffbb8e00000070b6000001afbd;
    exp_stage16[21][6] = 64'hba05bb8e70b6afbd;
    exp_final10[21][6] = 40'h8178e2dbbd;
    exp_raw[21][7] = 160'hffff99858700003d8e6fffffc8a9b20000527ae8;
    exp_biased[21][7] = 160'hffff9985a700003d8e8fffffc8a9d20000527b08;
    exp_shifted[21][7] = 160'hfffffe6616000000f63affffff22a700000149ec;
    exp_stage16[21][7] = 64'h6616f63a22a749ec;
    exp_final10[21][7] = 40'h85a3aa9dec;
    exp_raw[21][8] = 160'hffffacd184ffff760ade00005b8305ffff2a6261;
    exp_biased[21][8] = 160'hffffacd1a4ffff760afe00005b8325ffff2a6281;
    exp_shifted[21][8] = 160'hfffffeb346fffffdd82b0000016e0cfffffca98a;
    exp_stage16[21][8] = 64'hb346d82b6e0ca98a;
    exp_final10[21][8] = 40'hd182b8318a;
    exp_raw[21][9] = 160'hffff86981a00002036a8ffff5c027affffa76273;
    exp_biased[21][9] = 160'hffff86983a00002036c8ffff5c029affffa76293;
    exp_shifted[21][9] = 160'hfffffe1a6000000080dbfffffd700afffffe9d8a;
    exp_stage16[21][9] = 64'h1a6080db700a9d8a;
    exp_final10[21][9] = 40'h980db0298a;
    exp_raw[21][10] = 160'h000145d6f8ffffd48241ffff599755ffffe6d6ca;
    exp_biased[21][10] = 160'h000145d718ffffd48261ffff599775ffffe6d6ea;
    exp_shifted[21][10] = 160'h000005175cffffff5209fffffd665dffffff9b5b;
    exp_stage16[21][10] = 64'h175c5209665d9b5b;
    exp_final10[21][10] = 40'hd72099775b;
    exp_raw[21][11] = 160'h000066ee4bfffeb15e13ffffc8b15c0000d7092c;
    exp_biased[21][11] = 160'h000066ee6bfffeb15e33ffffc8b17c0000d7094c;
    exp_shifted[21][11] = 160'h0000019bb9fffffac578ffffff22c50000035c25;
    exp_stage16[21][11] = 64'h9bb9c57822c55c25;
    exp_final10[21][11] = 40'hee578b1425;
    exp_raw[21][12] = 160'hffff587a0c000149482a000032139fffffb2157e;
    exp_biased[21][12] = 160'hffff587a2c000149484a00003213bfffffb2159e;
    exp_shifted[21][12] = 160'hfffffd61e80000052521000000c84efffffec856;
    exp_stage16[21][12] = 64'h61e82521c84ec856;
    exp_final10[21][12] = 40'h7a12113856;
    exp_raw[21][13] = 160'hfffff43c2fffffefc57cffffd3c040ffffd378b5;
    exp_biased[21][13] = 160'hfffff43c4fffffefc59cffffd3c060ffffd378d5;
    exp_shifted[21][13] = 160'hffffffd0f1ffffffbf16ffffff4f01ffffff4de3;
    exp_stage16[21][13] = 64'hd0f1bf164f014de3;
    exp_final10[21][13] = 40'h3c716c05e3;
    exp_raw[21][14] = 160'hffffd2662fffff922180ffffaee39b00001c7693;
    exp_biased[21][14] = 160'hffffd2664fffff9221a0ffffaee3bb00001c76b3;
    exp_shifted[21][14] = 160'hffffff4999fffffe4886fffffebb8e00000071da;
    exp_stage16[21][14] = 64'h49994886bb8e71da;
    exp_final10[21][14] = 40'h66486e39da;
    exp_raw[21][15] = 160'hffff4a712a00002b77eb00000a6f490000d27bc0;
    exp_biased[21][15] = 160'hffff4a714a00002b780b00000a6f690000d27be0;
    exp_shifted[21][15] = 160'hfffffd29c5000000ade000000029bd00000349ef;
    exp_stage16[21][15] = 64'h29c5ade029bd49ef;
    exp_final10[21][15] = 40'h715e06f5ef;
    case_input[22] = 1024'hbe7b582a05115aa03e848dc28718e0a77b76e04886b110eff565e41c2c5d5760dd82c87fd413ddf3856313bbad2b42544c7945d9fb9c680a8732d4f21030a4a775c9e736ecfad91074816df2647624eff722229abe9fe8279cff6e7de6fd67af70001d65dd2ad1292c39a07f7412f981065ef8da8b9ae126daa1f05b0f6401aa;
    exp_raw[22][0] = 160'hffffb71465ffff18aa070000079b1400002e5b3c;
    exp_biased[22][0] = 160'hffffb71485ffff18aa270000079b3400002e5b5c;
    exp_shifted[22][0] = 160'hfffffedc52fffffc62a80000001e6c000000b96d;
    exp_stage16[22][0] = 64'hdc5262a81e6cb96d;
    exp_final10[22][0] = 40'h14aa89b16d;
    exp_raw[22][1] = 160'hffffd4a1a3fffff6ccbdffffdeef5cfffff63531;
    exp_biased[22][1] = 160'hffffd4a1c3fffff6ccddffffdeef7cfffff63551;
    exp_shifted[22][1] = 160'hffffff5287ffffffdb33ffffff7bbdffffffd8d5;
    exp_stage16[22][1] = 64'h5287db337bbdd8d5;
    exp_final10[22][1] = 40'ha1f33ef4d5;
    exp_raw[22][2] = 160'hfffebb03270001246119000098cce70000014e7c;
    exp_biased[22][2] = 160'hfffebb03470001246139000098cd070000014e9c;
    exp_shifted[22][2] = 160'hfffffaec0d00000491840000026334000000053a;
    exp_stage16[22][2] = 64'hec0d91846334053a;
    exp_final10[22][2] = 40'h03584cd13a;
    exp_raw[22][3] = 160'h0000b2333000005f369a00004e0f3effffbf674f;
    exp_biased[22][3] = 160'h0000b2335000005f36ba00004e0f5effffbf676f;
    exp_shifted[22][3] = 160'h000002c8cd0000017cda000001383dfffffefd9d;
    exp_stage16[22][3] = 64'hc8cd7cda383dfd9d;
    exp_final10[22][3] = 40'h334da0f59d;
    exp_raw[22][4] = 160'hffffe6e87dffffed634affffada45100016035e9;
    exp_biased[22][4] = 160'hffffe6e89dffffed636affffada4710001603609;
    exp_shifted[22][4] = 160'hffffff9ba2ffffffb58dfffffeb69100000580d8;
    exp_stage16[22][4] = 64'h9ba2b58db69180d8;
    exp_final10[22][4] = 40'he898da44d8;
    exp_raw[22][5] = 160'h0000b921a4fffef2eebdffffdd1cf900001555dc;
    exp_biased[22][5] = 160'h0000b921c4fffef2eeddffffdd1d1900001555fc;
    exp_shifted[22][5] = 160'h000002e487fffffbcbbbffffff74740000005557;
    exp_stage16[22][5] = 64'he487cbbb74745557;
    exp_final10[22][5] = 40'h21fbb1d157;
    exp_raw[22][6] = 160'hfffffd7ebbffff3e1b5d000098c674ffffb20f25;
    exp_biased[22][6] = 160'hfffffd7edbffff3e1b7d000098c694ffffb20f45;
    exp_shifted[22][6] = 160'hfffffff5fbfffffcf86d000002631afffffec83d;
    exp_stage16[22][6] = 64'hf5fbf86d631ac83d;
    exp_final10[22][6] = 40'h7ec6dc683d;
    exp_raw[22][7] = 160'hffff714328ffffd52fba000053a8dc00000070d1;
    exp_biased[22][7] = 160'hffff714348ffffd52fda000053a8fc00000070f1;
    exp_shifted[22][7] = 160'hfffffdc50dffffff54bf0000014ea300000001c3;
    exp_stage16[22][7] = 64'hc50d54bf4ea301c3;
    exp_final10[22][7] = 40'h434bfa8dc3;
    exp_raw[22][8] = 160'hffffdc18130000f0f1f2ffffaa37ec00007d3bc6;
    exp_biased[22][8] = 160'hffffdc18330000f0f212ffffaa380c00007d3be6;
    exp_shifted[22][8] = 160'hffffff7060000003c3c8fffffea8e0000001f4ef;
    exp_stage16[22][8] = 64'h7060c3c8a8e0f4ef;
    exp_final10[22][8] = 40'h183c8380ef;
    exp_raw[22][9] = 160'h00006ae39fffff5dc67e0000193cdbffffde573f;
    exp_biased[22][9] = 160'h00006ae3bfffff5dc69e0000193cfbffffde575f;
    exp_shifted[22][9] = 160'h000001ab8efffffd771a00000064f3ffffff795d;
    exp_stage16[22][9] = 64'hab8e771a64f3795d;
    exp_final10[22][9] = 40'he3b1a3cd5d;
    exp_raw[22][10] = 160'h0000146b1a0000ee039d0000811547ffff447542;
    exp_biased[22][10] = 160'h0000146b3a0000ee03bd0000811567ffff447562;
    exp_shifted[22][10] = 160'h00000051ac000003b80e0000020455fffffd11d5;
    exp_stage16[22][10] = 64'h51acb80e045511d5;
    exp_final10[22][10] = 40'h6b00e155d5;
    exp_raw[22][11] = 160'hffff8517b3fffffc7af300009122deffffb098bf;
    exp_biased[22][11] = 160'hffff8517d3fffffc7b1300009122feffffb098df;
    exp_shifted[22][11] = 160'hfffffe145ffffffff1ec000002448bfffffec263;
    exp_stage16[22][11] = 64'h145ff1ec448bc263;
    exp_final10[22][11] = 40'h17dec22e63;
    exp_raw[22][12] = 160'hffffbaa449ffff4d4e7200008bdef6ffff6dfdc4;
    exp_biased[22][12] = 160'hffffbaa469ffff4d4e9200008bdf16ffff6dfde4;
    exp_shifted[22][12] = 160'hfffffeea91fffffd353a0000022f7cfffffdb7f7;
    exp_stage16[22][12] = 64'hea91353a2f7cb7f7;
    exp_final10[22][12] = 40'ha453adf3f7;
    exp_raw[22][13] = 160'hffffbd3c26ffff8b68f9000007e4f9ffff2f8277;
    exp_biased[22][13] = 160'hffffbd3c46ffff8b6919000007e519ffff2f8297;
    exp_shifted[22][13] = 160'hfffffef4f1fffffe2da40000001f94fffffcbe0a;
    exp_stage16[22][13] = 64'hf4f12da41f94be0a;
    exp_final10[22][13] = 40'h3c5a4e520a;
    exp_raw[22][14] = 160'hffff41ced100008f5c64000171f4f5000073a5d9;
    exp_biased[22][14] = 160'hffff41cef100008f5c84000171f515000073a5f9;
    exp_shifted[22][14] = 160'hfffffd073b0000023d72000005c7d4000001ce97;
    exp_stage16[22][14] = 64'h073b3d72c7d4ce97;
    exp_final10[22][14] = 40'hced72f5297;
    exp_raw[22][15] = 160'h000034034effff8453aa00001bd0f3ffffed8583;
    exp_biased[22][15] = 160'h000034036effff8453ca00001bd113ffffed85a3;
    exp_shifted[22][15] = 160'h000000d00dfffffe114f0000006f44ffffffb616;
    exp_stage16[22][15] = 64'hd00d114f6f44b616;
    exp_final10[22][15] = 40'h0354fd1216;
    case_input[23] = 1024'h9387f99ecb22069a8cf4b89715af2176d476d78036553f43742a82cadecd5ffcd9a4121290a5bef78b11f74c9768edfb4d7dad367b52fb96cc340fc6dc851cf0b2b424bb2e1e022fe2dea50ee2b527130f2fcdb3502a987f00849e4468a3cf1e3ae70d3e7cdf04ae859151e50e0f2827b0a995e7c6ae00f6be278b5628851bf5;
    exp_raw[23][0] = 160'hffffa5bc9bffff7e83f900003ea421ffff53d8c4;
    exp_biased[23][0] = 160'hffffa5bcbbffff7e841900003ea441ffff53d8e4;
    exp_shifted[23][0] = 160'hfffffe96f2fffffdfa10000000fa91fffffd4f63;
    exp_stage16[23][0] = 64'h96f2fa10fa914f63;
    exp_final10[23][0] = 40'hbca10a4763;
    exp_raw[23][1] = 160'h000107e33bffff552217ffff91b144ffffbdc1d1;
    exp_biased[23][1] = 160'h000107e35bffff552237ffff91b164ffffbdc1f1;
    exp_shifted[23][1] = 160'h0000041f8dfffffd5488fffffe46c5fffffef707;
    exp_stage16[23][1] = 64'h1f8d548846c5f707;
    exp_final10[23][1] = 40'he3488b1707;
    exp_raw[23][2] = 160'h0000127996000098ca8f0000b565d1ffff844af8;
    exp_biased[23][2] = 160'h00001279b6000098caaf0000b565f1ffff844b18;
    exp_shifted[23][2] = 160'h00000049e6000002632a000002d597fffffe112c;
    exp_stage16[23][2] = 64'h49e6632ad597112c;
    exp_final10[23][2] = 40'h79b2a65d2c;
    exp_raw[23][3] = 160'hffffe3f8a2ffffc0672900006cac7a000017896a;
    exp_biased[23][3] = 160'hffffe3f8c2ffffc0674900006cac9a000017898a;
    exp_shifted[23][3] = 160'hffffff8fe3ffffff019d000001b2b20000005e26;
    exp_stage16[23][3] = 64'h8fe3019db2b25e26;
    exp_final10[23][3] = 40'hf8d9daca26;
    exp_raw[23][4] = 160'hfffff17063fffff3de4e00009960620000c91632;
    exp_biased[23][4] = 160'hfffff17083fffff3de6e00009960820000c91652;
    exp_shifted[23][4] = 160'hffffffc5c2ffffffcf7900000265820000032459;
    exp_stage16[23][4] = 64'hc5c2cf7965822459;
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
