hahayyf666-netizen/ITS_NEW/02_rtl/rtl/bounded_lfnst_engine.sv

// Bounded, synthesizable LFNST engine for the engineering-profile wrapper.
//
// One issue contains four complete output rows and sixteen coefficient/input
// terms per row.  Coefficients are packed by (nTrs,set,index,output_group),
// so the implementation has one bounded 1024-bit ROM read per issue rather
// than 64 arbitrary reads from the canonical flat ROM.

module bounded_lfnst_engine #(
    parameter integer DATA_W = 16,
    parameter integer COEFF_W = 16,
    parameter integer ACC_W = 40,
    parameter string COEFF_FILE = "03_verification/sim/lfnst_packed_coeffs.hex"
) (
    input  logic                         clk,
    input  logic                         rst_n,
    input  logic                         start,
    input  logic [1:0]                   set_idx,
    input  logic [1:0]                   lfnst_idx,
    input  logic                         ntrs48,
    input  logic                         nonzero8,
    input  logic signed [(16*DATA_W)-1:0] input_terms,
    output logic                         busy,
    output logic                         out_valid,
    output logic signed [(4*DATA_W)-1:0] out_data,
    output logic [3:0]                   out_group,
    output logic                         out_last,
    output logic                         done,
    output logic                         error
);

    localparam integer BUNDLE_COUNT = 128;
    localparam logic [1:0] ST_IDLE = 2'd0;
    localparam logic [1:0] ST_RUN  = 2'd1;

    logic [1023:0] coeff_bundle_mem [0:BUNDLE_COUNT-1];
    logic [1:0] state_q;
    logic [1:0] set_q;
    logic [1:0] idx_q;
    logic       ntrs48_q;
    logic       nonzero8_q;
    logic signed [(16*DATA_W)-1:0] input_terms_q;
    logic [3:0] issue_group_q;
    logic [3:0] product_group_q;
    logic [3:0] mul_group_q;
    logic       mul_valid_q;
    logic       mul_last_q;
    logic       product_valid_q;
    logic       product_last_q;
    // These are deliberately ordinary synchronous data registers.  Keeping
    // reset and valid control out of this stage lets Vivado infer DSP48E2
    // A/B input registers rather than fabric FDCEs.
    logic signed [COEFF_W-1:0] mul_coeff_q [0:63];
    logic signed [DATA_W-1:0]  mul_term_q [0:63];
    // A complete signed DATA_W x COEFF_W product is sufficient here.  The
    // reduction tree sign-extends it to ACC_W at its input.
    logic signed [(DATA_W+COEFF_W)-1:0] products_q [0:63];

    // Registered reduction tree.  Every level carries the valid/group/last
    // metadata with its data so the arithmetic pipeline can accept one
    // coefficient bundle on every issue edge while its tail is draining.
    logic       red1_valid_q, red2_valid_q, red3_valid_q;
    logic       red4_valid_q, red5_valid_q;
    logic       red1_last_q, red2_last_q, red3_last_q;
    logic       red4_last_q, red5_last_q;
    logic [3:0] red1_group_q, red2_group_q, red3_group_q;
    logic [3:0] red4_group_q, red5_group_q;
    logic signed [ACC_W-1:0] reduce_l1_q [0:31];
    logic signed [ACC_W-1:0] reduce_l2_q [0:15];
    logic signed [ACC_W-1:0] reduce_l3_q [0:7];
    logic signed [ACC_W-1:0] reduce_l4_q [0:3];
    logic signed [ACC_W-1:0] reduce_l5_q [0:3];

    // The coefficient ROM is read into a register before the product stage.
    // The issue stage below then captures operands into DSP-localizable
    // registers; products are formed one cycle later.  This keeps the ROM
    // select and the 64 DSP products in separate cycles.
    logic [1023:0] coeff_bundle_q;
    logic [6:0]    coeff_fetch_addr_q;
    logic          coeff_bundle_valid_q;
    logic signed [ACC_W-1:0] reduce_l1_c [0:31];
    logic signed [ACC_W-1:0] reduce_l2_c [0:15];
    logic signed [ACC_W-1:0] reduce_l3_c [0:7];
    logic signed [ACC_W-1:0] reduce_l4_c [0:3];
    logic signed [ACC_W-1:0] reduce_l5_c [0:3];
    logic signed [ACC_W-1:0] sum_c [0:3];
    logic signed [DATA_W-1:0] scaled_c [0:3];
    integer bundle_i;
    integer reduce_i;
    integer sum_lane;
    integer scale_lane;
    integer seq_i;
    integer seq_lane;
    integer mul_seq_i;

    function automatic logic [6:0] bundle_base_for(
        input logic       ntrs48_i,
        input logic [1:0] set_i,
        input logic [1:0] idx_i);
        begin
            if (!ntrs48_i)
                bundle_base_for = (set_i * 7'd8) + ((idx_i - 1'b1) * 7'd4);
            else
                bundle_base_for = 7'd32 + (set_i * 7'd24) +
                                  ((idx_i - 1'b1) * 7'd12);
        end
    endfunction

    initial $readmemh(COEFF_FILE, coeff_bundle_mem);

    always_comb begin
        for (reduce_i = 0; reduce_i < 32; reduce_i = reduce_i + 1)
            reduce_l1_c[reduce_i] = '0;
        for (reduce_i = 0; reduce_i < 64; reduce_i = reduce_i + 1)
            reduce_l1_c[reduce_i/2] = reduce_l1_c[reduce_i/2] +
                {{(ACC_W-(DATA_W+COEFF_W)){products_q[reduce_i][DATA_W+COEFF_W-1]}},
                 products_q[reduce_i][DATA_W+COEFF_W-1:0]};
        for (reduce_i = 0; reduce_i < 16; reduce_i = reduce_i + 1)
            reduce_l2_c[reduce_i] = reduce_l1_q[reduce_i*2] +
                                    reduce_l1_q[reduce_i*2+1];
        for (reduce_i = 0; reduce_i < 8; reduce_i = reduce_i + 1)
            reduce_l3_c[reduce_i] = reduce_l2_q[reduce_i*2] +
                                    reduce_l2_q[reduce_i*2+1];
        for (reduce_i = 0; reduce_i < 4; reduce_i = reduce_i + 1)
            reduce_l4_c[reduce_i] = reduce_l3_q[reduce_i*2] +
                                    reduce_l3_q[reduce_i*2+1];
        for (reduce_i = 0; reduce_i < 4; reduce_i = reduce_i + 1)
            reduce_l5_c[reduce_i] = reduce_l4_q[reduce_i];
        for (sum_lane = 0; sum_lane < 4; sum_lane = sum_lane + 1)
            sum_c[sum_lane] = reduce_l5_q[sum_lane];
    end

    function automatic logic signed [DATA_W-1:0] round_clip(
        input logic signed [ACC_W-1:0] raw_i);
        logic signed [ACC_W-1:0] value_i;
        begin
            value_i = (raw_i + (1 <<< 6)) >>> 7;
            if (value_i > 32767)
                round_clip = 16'sh7fff;
            else if (value_i < -32768)
                round_clip = 16'sh8000;
            else
                round_clip = value_i[DATA_W-1:0];
        end
    endfunction

    always_comb begin
        for (scale_lane = 0; scale_lane < 4; scale_lane = scale_lane + 1)
            scaled_c[scale_lane] = round_clip(sum_c[scale_lane]);
    end
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
