hahayyf666-netizen/ITS_NEW/(commit log)

2026-09-10 Import V3.5 Step 12A-R2.1 complete project snapshot
    [12-bit.cfg, 16-bit.cfg, ArenaOfValor.cfg, ArenaOfValor_444.cfg, ArenaOfValor_RGB.cfg, BQMall.cfg, BQSquare.cfg, BQTerrace.cfg]
2026-09-10 Translate README and document current project status
2026-09-10 Reorganize complete project into categorized V3.5-13 layout
    [12-bit.cfg, 16-bit.cfg, ArenaOfValor.cfg, ArenaOfValor_444.cfg, ArenaOfValor_RGB.cfg, BQMall.cfg, BQSquare.cfg, BQTerrace.cfg]
2026-09-11 Start Step12B DCT2-64 wrapper functional prototype
2026-09-12 Continue Step12B functional closure
    [step12b_rtl_event_trace_normal.csv, step12b_rtl_event_trace_synthesis.csv]
2026-09-12 Close Step12B functional gate
    [step12b_rtl_event_trace_normal.csv, step12b_rtl_event_trace_synthesis.csv]
2026-09-12 Close Step12B audit semantics for v3.5-17.1
    [step12b_rtl_event_trace_normal.csv, step12b_rtl_event_trace_synthesis.csv]
2026-09-12 Stop v3.5-17.2 on memory timing mismatch
    [memory_timing_probe_normal.csv]
2026-09-12 Close v3.5-17.2 phase-entry timing gate
    [memory_timing_probe_synthesis.csv]
2026-09-13 Step12C-M1 banked memory synthesis gate STOP
    [step12b_rtl_event_trace_normal.csv, step12b_rtl_event_trace_synthesis.csv]
2026-09-13 Step12C-M2 memory/control topology repair and synthesis gate
    [step12b_rtl_event_trace_normal.csv, step12b_rtl_event_trace_synthesis.csv]
2026-09-13 Step12C-M3 staging response pipeline synthesis gate
    [step12b_rtl_event_trace_normal.csv, step12b_rtl_event_trace_synthesis.csv]
2026-09-13 Continue Step12C-M4 input write boundary
    [step12b_rtl_event_trace_normal.csv, step12b_rtl_event_trace_synthesis.csv]
2026-09-13 Step12C-M5 input-tag setup closure
    [step12b_rtl_event_trace_normal.csv, step12b_rtl_event_trace_synthesis.csv]
2026-09-13 Add M6 routed physical root-cause analysis
    [m6_physical_paths.csv]
2026-09-13 Step12C-M7 staging address localization STOP
    [step12b_rtl_event_trace_normal.csv]
2026-09-14 Correct Step12E simulator evidence and gate status
    [unified_its_wrapper.sv, unified_p4_kernel.sv, unified_p4_kernel_numeric_tb.sv]
2026-09-15 Step12F-P4 register unified P4 issue descriptor boundary
    [unified_p4_kernel.sv, unified_p4_kernel_p4_tb.sv]
2026-09-16 Step12F-P9-A routed read-only qualification
    [p9_a_path_segments.csv, p9_a_worst500.csv]
2026-09-16 Step12F-P9 add atomic elastic input read command boundary
    [p9_a_worst500.csv]
2026-09-16 Step12F-P9 round 3 qualify fill write fix
    [unified_its_wrapper.sv]
2026-09-16 Step12F-P9 round 5 isolate H-read address validity
    [p9_a_worst500.csv]
2026-09-17 Step12F-P9-R5C read-only setup hold root-cause qualification
    [hold_endpoint_census.csv, setup_endpoint_census.csv]
2026-09-17 Step12F-P9-R5F setup root-cause census evidence
    [physical_region_summary.csv, setup_bucket_summary.csv, setup_endpoint_census.csv, setup_family_summary.csv, structural_signature_summary.csv]
2026-09-17 Step12F-P9-R5G G0 physical locality qualification
    [g0_cell_inventory.csv, g0_ingress_inputmem_paths.csv, g0_path_population_summary.csv, g0_population_summary.csv]
2026-09-17 Step12F-P9-R5G G0.5 read-only geometry qualification
    [g05_candidate_site_inventory.csv, g05_per_bit_clustering.csv, g05_producer_inventory.csv, g05_upstream_paths.csv]
2026-09-17 Step12F-P9-R5G-G0.6 balanced producer locality frontier
    [g06_candidate_frontier.csv, g06_candidate_universe.csv, g06_per_bit_features.csv, g06_subset_definitions.csv]
2026-09-18 Step12F-P9 R6A classify distributed setup tail
    [coarse_primitive_signature_summary.csv, negative_endpoint_family_census.csv, r5f_r6a_family_delta.csv, r6a_focus_summary.csv]
2026-09-18 Step12F-P9-R6B reject ExtraTimingOpt physical treatment
    [setup_bucket_summary.csv, setup_family_summary.csv]
2026-09-18 Step12F-P9-R7 reject redundant LFNST grid clear
    [physical_region_summary.csv, setup_bucket_summary.csv, setup_endpoint_census.csv, setup_family_summary.csv, structural_signature_summary.csv]
2026-09-19 Update root README to current Step12F R6/R7 status
2026-09-20 Fix LFNST fixed input and output layout
    [bounded_lfnst_engine.sv, unified_its_wrapper.sv]
2026-09-22 Fix nTrs48 LFNST scatter order and add tail poison coverage
    [unified_its_wrapper.sv]
2026-09-28 SAT10: fix checkpoint stage directory lifecycle
2026-09-29 P4: add routed setup tail census
    [setup_bucket_summary.csv, setup_endpoint_census.csv, setup_family_summary.csv]
2026-09-29 P4: classify CONTROL setup residual endpoints
    [physical_region_summary.csv, setup_bucket_summary.csv, setup_endpoint_census.csv, setup_family_summary.csv, structural_signature_summary.csv]
2026-10-03 P9 record latest-source fixed-placement router A/B
    [P9_ROUTER_AB_ENDPOINT_FAMILIES.csv, SHA256SUMS.csv, physical_region_summary.csv, setup_bucket_summary.csv, setup_endpoint_census.csv, setup_family_summary.csv, structural_signature_summary.csv]
2026-10-05 Record LFNST grid initialization physical qualification
    [ARTIFACT_SHA256SUMS.csv]
2026-10-05 Step12F isolate primary-V read return capacity
2026-10-29 Fix complete spatial reconstruction in ITS inverse transforms
    Reconstruct all vertical spatial rows from reduced frequency-input support; update V writeback/last-commit and H reads in ordinary and LFNST paths. Correct both Python models and directed expectations.
    Include independent DC negative control, native VTM primary-transform cross-checks, mixed-TU/stall/reset tests, and reproducible timing cleanup. Validation: 42 positive simulations; 498 native configurations / 293360 compared values; final 2ns setup WNS 0.000ns and hold WHS +0.004ns with zero failing endpoints. Timing margin remains extremely small; official equivalence is NOT_PROVEN.
    Preserve the complete frozen upstream tree/his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
2026-11-03 Add competition problem statement to reference materials
    Adds the official problem text for the 9th China Graduate Integrated
    Circuit Innovation Competition Huawei track 1 (VVC inverse transform, ITS)
    to 04_reference/huawei, alongside the existing attachment (华为附件.docx).
    The attachment is already present and byte-identical, so it is unchanged.
    The V35_13 release archive is intentionally not committed.
2026-11-03 Move competition materials to repository root
    Moves the provided problem statement and its attachment from
    04_reference/huawei/ to the repository root, next to README.md, so they
    are visible at first glance. Contents are unchanged (pure rename).
2026-11-03 Add repository STATUS and point README at it
    Adds STATUS.md as the single entry point for the current delivery state:
    which commit is authoritative, why 081efa6 is superseded, where the
    evidence lives, what the validation boundaries are, and which committed
    timing reports are historical traps.
    Also merges the full-spatial repair (1780eb9) that was stranded on
    fix/full-vertical-output.
2026-11-03 Repoint attachment references to repository root and correct STATUS
    The two competition .docx files now live at the repository root, so the
    scripts that located 04_reference/huawei/huawei-attachment.docx no longer
    resolve. Update the seven affected scripts to drop only the
    04_reference/huawei segment and keep their existing repo-root level
    (SCRIPT_DIR/../.. or the existing ROOT/PROJ_ROOT variable), and update the
    01_docs navigation entry.
    STATUS now names the current physical evidence (103/.../physical) instead
    of the superseded 100 run, states the defect as lost spatial rows on the V
    axis only (DCT2-64 loses 32 rows, DCT8/DST7-32 loses 16, DCT2<=32 is
    unaffected, LFNST-on needs its own sup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
